lo26lo/portal-turret-v4/Turret_firmware/README.md

# Turret2 firmware

Firmware of the Portal Sentry Turret on the **Turret2** board (ESP32-S3-MINI-1-N8). It started as a copy of the upstream firmware (`../Fork/`, unchanged) and was adapted to the new board: safe power-up, power fault handling, amplifier control, new IMU, staggered servos, settings, web page, serial console, home WiFi and NTP.

> **Status**: it compiles (`turret2` and `turret2_bringup`), but it has **not run on a board yet**. Expect calibration and fixes at bring-up. The web page has been tried against the simulator (`tools/mock_server.py`), not against real hardware.

Design and reasons: [../docs/firmware-plan.md](../docs/firmware-plan.md). Hardware: [../README.md](../README.md), [../docs/design-plan.md](../docs/design-plan.md).

---

## Contents

1. [What the turret does](#1-what-the-turret-does)
2. [Project layout](#2-project-layout)
3. [Build, flash, monitor](#3-build-flash-monitor)
4. [Boot sequence](#4-boot-sequence)
5. [State machine](#5-state-machine)
6. [Modules](#6-modules)
7. [Buttons, switch and status LEDs](#7-buttons-switch-and-status-leds)
8. [Settings](#8-settings)
9. [WiFi, first setup, time](#9-wifi-first-setup-time)
10. [Web page and API](#10-web-page-and-api)
11. [Serial console](#11-serial-console)
12. [Firmware update over WiFi](#12-firmware-update-over-wifi)
13. [Hardware safety rules](#13-hardware-safety-rules)
14. [Calibration and bring-up](#14-calibration-and-bring-up)
15. [Testing without the board](#15-testing-without-the-board)
16. [Known limits](#16-known-limits)

---

## 1. What the turret does

At rest the wings are closed and the ring glows red. When the **radar** (HLK-LD2450 or Ai-Thinker RD-03D, same frames) sees someone, the turret opens its wings, extends its guns, plays the gunshot sound for 3 s, then retracts the guns and closes the wings. Button A starts the same cycle by hand.

Around that behaviour, which comes from the upstream firmware, Turret2 adds:

- a **safe power-up**: every output that floats after reset is set within the first milliseconds, the servos start one at a time;
- **power protection**: a fault reported by the eFuse sheds the load at once, a reboot loop starts a reduced mode;
- **settings** stored in flash (NVS), changeable from the web page or the console;
- a **web page** (status, settings, calibration, tests, log, firmware update) and a **serial console** with the same commands;
- **home WiFi** next to the turret's own access point, **NTP time**, name `portal-turret.local`.

## 2. Project layout

```
platformio.ini              environments, pinned platform and libraries
boards/turret2.json         board: 8 MB QIO flash, no PSRAM, partitions default_8MB.csv
variants/turret2/           Arduino variant: I2C on IO35/IO36, LED_BUILTIN = IO33, no RGB_BUILTIN
scripts/embed_page.py       pre-build: gzips src/web/page/index.html into src/web/page_gz.h
scripts/git_version.py      pre-build: firmware version from git into src/version_gen.h
tools/mock_server.py        web page test bench (simulated turret, no board needed)
tools/mock_menu.py          debug menu for the simulator (reads src/ui/MenuTree.h)
tools/check_web.py          automatic check of the page and API against the simulator
scripts/check_commands.py   checks that section 11 of this README lists every command of the command table
test/test_logic/            native unit tests of src/logic (pio test -e native)
../.github/workflows/       CI: build + checks on every push
data/                       LittleFS image (pio run -t uploadfs): the 55 voice lines of upstream
                            (01_activate/ … 08_tipped/, 09/), fire.mp3
src/
  main.cpp                  setup() = boot steps 1-10, loop()
  pins.h                    pinout imposed by the board (never reassign)
  Turret.h                  references shared by the states
  board/Board.*             safe state, reset reason, reboot-loop detection, status LEDs, buttons, SW1, PWR_FLT
  board/I2cBus.*            I2C start on IO35/IO36, bus recovery, scan
  board/Log.*               console output: Serial + 4 kB RAM buffer (GET /api/log) + 2 kB crash log in RTC memory
  board/CoreDump.*          core dump in flash: summary, download, erase
  logic/*.h                 pure logic without Arduino (radar frame parser and zone, firing cycle, Hall, buttons, LED code, gain, sleep, debug menu navigation), tested natively
  ui/MenuTree.h             debug menu tree, English and French (pure data)
  ui/Display.*              OLED 128x64 on J11 (U8g2: SSD1306, SSD1309, SH1106)
  ui/DebugUi.*              debug menu and status page: information pages, hooks to the commands
  audio/Amp.*               MAX98357A: shutdown, gain, mute
  audio/Audio.*             I2S, gunshot sample with loop, test tone, voice lines, volume
  audio/Mp3FrameDecoder.*   MP3 to PCM one frame at a time (Helix C API), no Arduino
  audio/AudioLoop.*         plays a sample with a loop section
  audio/GunShotAudio.h      gunshot sample (16-bit mono, 44.1 kHz, 16 420 samples)
  light/Light.*             NeoPixels: ring (9) and guns (2 + 2), power cap, test colours
  motion/ServoChannel.*     one servo output with deferred, staggered attachment
  motion/Gun.*              gun servo (positional)
  motion/Wing.*             wing servo (continuous rotation) + Hall sensor
  motion/Gantry.*           both wings, rotations X/Z, attach schedule, hold policy
  sensors/Motion.*          LSM6DSOX IMU, orientation
  sensors/Radar.*           HLK-LD2450 / RD-03D frame parser (UART1, 256000 baud)
  settings/Settings.*       setting table, NVS storage
  states/*                  state machine: Booting, Idle, Activate, Firing, Searching, Disengage, Manual, Fault
  control/Actions*          command interpreter shared by console, buttons, debug menu and web page: command table and dispatch,
                            settings, system, audio, network, status JSON (Actions.cpp); servos, wings, guns, LEDs, voice,
                            calibration (ActionsHardware.cpp); pins, rails, sweeps, load test (ActionsLab.cpp)
  control/SelfTest.*        self-test: passive checks, then LEDs, sound, servos and wings, with a report
  control/Stats.*           usage counters (boots and cycles in NVS, targets and last cycle since boot)
  web/AccessPoint.*         turret access point (WPA2) + captive portal DNS
  web/Station.*             home WiFi, NTP, mDNS, network scan
  web/TurretWebServer.*     web page and JSON API, HTTP Basic authentication
  web/Ota.*                 firmware upload (POST /update)
  web/page/index.html       the web page (embedded in the firmware at build time)
```

## 3. Build, flash, monitor

PlatformIO project. In VS Code, open **this folder** (`Turret_firmware/`), not the repository root: the PlatformIO extension only detects a `platformio.ini` at the root of the opened folder. From the repository root on the command line, add `-d Turret_firmware`.

| Environment | Use |
|---|---|
| `turret2` (default) | normal firmware |
| `turret2_bringup` | debug build: core logs at level 3, button and PWR_FLT events printed, waits up to 3 s for the USB host |
| `turret2_ota` | `turret2` uploaded over WiFi, from the turret's network (section 12) |
| `turret2_ota_home` | same, from the home network (`portal-turret.local`) |
| `turret2_v2`, `turret2_v2_bringup`, `turret2_v2_ota`, `turret2_v2_ota_home` | the same four for the **v2 board** (6 layers, rails switched by an I2C expander): `TURRET2_V2` defined, pinout of `src/pins.h` for the v2, variant `variants/turret2_v2`. **Work in progress** (lot F2): pinout, board check and rails done, not yet run on a v2 board; sleep modes to come |

**Board check**: the v0.1 and v2 boards put almost every function on other pins, and the wrong build could damage a board (on the v2, IO7 is SW1: the v0.1 build drives it as a servo output). Before any other pin, both builds start the I2C bus (IO35 / IO36 on both boards) and look for the v2 rail expander (TCAL6416 at 0x20): the v2 build needs it, the v0.1 build refuses it. On the wrong board the firmware drives nothing, switches the v2 rails off if it sees the expander, and repeats on the USB console what to flash; `rollback` there boots the other OTA slot (the firmware that was there before an OTA update), `scan` lists the I2C devices. Wi-Fi and OTA are not started in that case: reflash over USB.

```
pio run                       # build
pio run -t upload             # flash over the native USB (IO19/IO20)
pio run -t uploadfs           # LittleFS image: data/ (voice lines); again after any change in data/
pio device monitor            # console, 115200 baud
```

After an upload over the native USB, esptool's usual RTS reset leaves the ESP32-S3 in download mode (ROM: `boot:0x20 (DOWNLOAD(USB/UART0))`) and the firmware never starts. The board definition therefore asks for no reset (`upload.after_reset = no_reset`), and `scripts/reset_after_upload.py` then restarts the chip with a watchdog reset ("Board restarted: the firmware is running."). If it says it could not, press **RESET** (SW3).

If the native USB does not show up: hold **BOOT** (SW2), press **RESET** (SW3), release BOOT, flash again. Last resort: UART0 on J16 with an ESP-Prog.

First flash of a new board: `esptool.py flash_id` must report **8 MB** (module N8). The boot banner also warns when the flash is not 8 MB or when PSRAM is found.

Pinned versions (`platformio.ini`): platform `espressif32@7.1.3` (arduino-esp32 2.0.17), FastLED 3.9.20 (not 3.10.x: no RMT driver under ESP-IDF 4.4, LEDs all white), ESP32Servo 1.2.1, ESPAsyncWebServer 3.12.1, AsyncTCP 3.5.0, AceRoutine 1.5.1, Adafruit LSM6DS 4.7.4, U8g2 2.36.18, arduino-audio-tools and arduino-libhelix pinned to a commit. Keep the path of the project short on Windows: FastLED has very deep paths and GCC fails beyond 260 characters.

Size today: about 46 % of the 3.2 MB application partition, 28 % of the RAM. The voice lines take 0.39 MB of the 1.5 MB LittleFS partition.

**Version**: `scripts/git_version.py` writes `src/version_gen.h` before each build with `git describe --tags --dirty --always` (for example `fd63cb0-dirty`). It appears in the boot banner, in `/api/status` and on the web page. Tag a release (`git tag v0.1`) to get readable versions.

**Continuous integration**: `.github/workflows/firmware.yml` builds `turret2`, `turret2_bringup` and `turret2_v2`, checks that every `#include` matches the file name exactly (Linux is case sensitive), runs the native tests (`pio test -e native`), `tools/check_web.py`, `scripts/check_commands.py` and the code style check `scripts/check_format.py` (clang-format 19, `.clang-format` at the project root; `--fix` formats) on every push that touches `Turret_firmware/`.

## 4. Boot sequence

The order comes from the firmware plan §3.2. Steps 1 to 10 run in `setup()`, steps 11 to 13 in the `Booting` state.

| # | Step | Why |
|---|---|---|
| 0 | **Board check** (`BoardCheck::Run`): I2C started on IO35 / IO36 (bus recovery if SDA is stuck), rail expander looked for at 0x20; if it answers, every rail off at once. Wrong board: nothing else runs (see section 3) | the two boards share only the I2C pins; the expander keeps its outputs across a software restart |
| 1 | **Safe state** (`Board::Begin`, first line): amplifier SD low (muted), gain pins released (9 dB), both status LEDs on, inputs configured, SW1 and buttons read, reset reason and counters read | after reset every pin floats; this happens within a few milliseconds |
| 2 | **NeoPixels**: v2: LED rail on; black frame, power cap | clears random colours latched while the level shifter inputs floated |
| 3 | **Console**: `Serial` (USB CDC), boot banner | diagnostics from the start |
| 4 | **Settings** from NVS (factory reset if A + B held), LED settings, **LittleFS** mounted (never formatted automatically) | everything else reads the settings |
| 5 | **I2C** on IO35/IO36 at 400 kHz (started at step 0), bus recovery reported, scan printed | the IMU may hold SDA after a warm reset |
| 6 | **IMU** LSM6DSOX at 0x6A | red LED code 3 if missing |
| 7 | **Radar**: v2: radar rail on; UART1 at 256000 baud | non blocking; code 4 if no frame for 3 s |
| 8 | **Hall sensors**: v2: Hall rail on; read: real wing position | a reset during a cycle can leave the wings open |
| 9 | **Audio**: I2S clocks first, then gain with SD low, 10 ms, SD high | no pop |
| 10 | **WiFi** access point, home WiFi, web server, OTA; v2: then the servo rail on (kept off in reduced mode) | the RF calibration current peak happens before the servos |
| 11 | **Servos one at a time**, `ServoStagger` apart (250 ms): rotate Z, rotate X (centred), gun left, gun right (retracted) | several servos jumping together draw 3 to 4 A, the eFuse limit |
| 12 | **Homing**: guns retracted, wings closed unless the Hall sensors say they are | known mechanical state |
| 13 | End: status LEDs as set (default: green breathing, red fault code), state `Idle` (or `Manual` in debug / reduced mode) | |

PWR_FLT low at any point stops the sequence and enters `Fault`.

## 5. State machine

| State | Does | Leaves to |
|---|---|---|
| `Booting` | steps 11-13 | `Idle`, `Manual` (debug / reduced mode), `Fault` |
| `Idle` | rests `CooldownMs` after entering, then waits for a target **inside the detection zone** of a radar that is still sending frames; refuses if the turret is not upright | `Activate` |
| `Activate` | says an *activate* line, opens the wings, waits until both are open (Hall), extends the guns, 0.5 s, then waits for the end of the line (3.5 s at most from the start) | `Firing` |
| `Firing` | gunshot sound with its loop for `FireMs` (3 s); with `AimZ`, rotation Z follows the target (smoothed, ±60°) | `Searching` |
| `Searching` | says a *search* line; with `AimZ`, sweeps rotation Z ±30° every 4 s. A target back in the zone fires again; nothing for `SearchMs` (4 s) retires. Decisions in `logic/CycleLogic.h`, tested natively | `Firing`, `Disengage` |
| `Disengage` | says a *retire* line, retracts the guns, 0.5 s, closes the wings, waits, 0.5 s | `Idle` |
| `Manual` | nothing: the state machine is stopped. Used by debug mode, reduced mode and every hardware test; in debug mode a demo cycle also ends here | `Booting` with the `resume` command |
| `Fault` | power fault: servos detached, sound stopped, amplifier in shutdown, LEDs off | `Booting` after PWR_FLT has been high for 2 s |

Aiming (`AimZ`, off by default): while firing, rotation Z follows the first target in the zone (angle `atan2(x, y)` of the radar, smoothed, ±60°); while searching it sweeps ±30°. The direction of the rotation against the radar x axis has not been checked on a turret yet: try `set AimZ true` with a target on one side, and swap the sign with `AngleOffsetZ` / the gear ratio in `Gantry` if it turns the wrong way. With `AimZ` off the rotations stay centred, as in the upstream firmware.

## 6. Modules

### Board (`board/Board.*`)

- Safe state at reset (step 1).
- **Reset reason** (`esp_reset_reason`) printed in the banner and the status.
- **Reboot-loop detection**: a counter in NVS goes up at each *suspicious* reset (power-on, brownout, panic, watchdogs, unknown; not software restarts nor deep sleep) and is cleared after 60 s of running. From 3 in a row the turret starts in **reduced mode**: no servo attached, LEDs at 10 %, amplifier at 9 dB, red LED code 1. This covers an eFuse that keeps cutting and retrying. On the ESP32-S3 the RESET button also reports a power-on, so pressing it three times within a minute also gives reduced mode.
- **Brownout counter** in NVS (lifetime).
- **PWR_FLT** (IO38, low = eFuse fault): falling-edge interrupt, so even a short dip is caught, plus the level.
- Status LEDs and buttons (section 7).

### Power handling

**Sleep** (`control/Sleep.*`, `logic/SleepLogic.h`, lot F2.6; settings group *Sleep*, card *Sleep* on the Status tab, command `sleep`):

- **Radar sleep** (both boards): after `RadarSleepMin` without a target in the detection zone, from `Idle` in normal mode. The radar keeps watching; servos released, LEDs off, amplifier in shutdown, Hall sensors off, WiFi as `SleepWifi` says; on the v2 the servo and LED rails are off as well. A target in the zone, the knob, PROG, a button, a cycle started from the web page or `sleep off` wakes it up (rails on one at a time, then the state machine reacts).
- **Deep sleep** (v2 only, SW1 open): after `DeepSleepMin` of radar sleep, or at once at night (`NightSleep`). Shut down as for a restart (amplifier, then I2S, rails), WiFi off, status LEDs off, IMU armed (accelerometer alone at 26 Hz, wake-up interrupt latched on INT1 / IO14), then `esp_deep_sleep_start()`. Wake-up: the turret moved (`WakeImu`), PROG (IO0), the end of the night (timer), or a **patrol** every `PatrolPeriodS`: the turret then boots quiet (rails off but the radar's, no homing), looks for `PatrolOnS`, and goes back to deep sleep if nobody is there. Every wake-up is a full boot (the RAM is lost). Release PROG quickly after a PROG wake-up: if the ROM ever starts in download mode, press RESET.
- Debug mode (SW1 closed) never sleeps on its own and refuses the deep sleep; `sleep radar` works there for tests.

**v2 board, switched rails** (`board/Power.*`, `board/Expander.*`, lot F2.4): servos (5V_SERVO), LED ring (5V_LED), radar (5V_RADAR) and Hall sensors (3V3_HALL) each have a switch driven by the TCAL6416 expander at 0x20. All are off at reset and after the board check; the boot switches them on one at a time, at least 10 ms apart, each call waiting for its rail to rise: LEDs (step 2), radar (step 7), Hall (step 8), servos (end of step 10, not in reduced mode). Before a rail goes off, what it feeds is stopped (servos released and their lines held low, LEDs disabled, radar UART ended and its TX line an input), so that no line feeds an unpowered module. No servo is attached and no LED frame is sent while their rail is off. A power fault (`Fault` state) switches the servo and LED rails off and back on when it ends; a restart or an OTA update switches every rail off. On the v0.1 these calls do nothing (5 V always on).

A power fault, from any state including `Booting`, enters `Fault` at once (plan §4). The ESP32 is powered behind the eFuse too: if the eFuse cuts completely the board simply restarts, and the reset reason and counters show it afterwards.

LED current is capped by FastLED (`LedMaxmA`, 500 mA by default; 13 LEDs at full white would draw about 0.8 A).

### Servos (`motion/*`)

Six servos: rotate Z (IO7), rotate X (IO6), gun left (IO1), gun right (IO2), wing left (IO4), wing right (IO5). Range 500-2400 µs at 50 Hz.

- **Staggered attachment**: a command sent to a detached servo is stored; `Gantry` attaches waiting servos one per `ServoStagger` window, in the order above, directly on the stored command. This applies at boot and afterwards.
- **Hold policy** (decision D6):
  - wings (continuous rotation) are released as soon as they stop: with no pulse they stop dead, which avoids the creep of a badly centred neutral;
  - guns are released 0.5 s after their last command;
  - rotations are held while a wing is open (aiming) and released after `ServoIdleMs` with the wings closed and still.
- **Speed ramp on a weak supply**: in debug mode without `power full` (a computer USB port), the positional servos (rotations and guns, never the continuous wings) follow their command at `ServoRamp` µs per second instead of jumping (1000 by default, about 95°/s). A SG90 jumping 45° or more stalls on a computer port: it clicks without turning, while the ESP32 keeps running on its buck-boost 3.3 V (seen on 23.10.2026). After a release, the ramp starts again from the last pulse sent. `ServoRamp` = 0 turns the ramp off; with `power full` or in normal mode, the servos jump as before. Each release is logged (`Servo rotate Z released`).
- **Wings**: speed ±475 µs around `1500 + WingTrim`. A movement ends when the Hall sensor passes the threshold, or after a 2 s timeout (counted once the servo is attached).
- **Hall sensors** (IO8 left, IO9 right, 3.3 V, 12-bit ADC): thresholds `HallOpenL/R`, `HallCloseL/R`. If the open threshold is below the closed one, the comparisons are reversed (magnet mounted the other way). A sensor stuck at a rail (≤ 15 or ≥ 4080 for 1 s) or not changing during a whole movement sets red LED code 5.

### IMU (`sensors/Motion.*`)

LSM6DSOX at 0x6A on the shared I2C bus (also the Qwiic port J11), 104 Hz, ±4 g, gyro 2000 dps. Read every 20 ms, gravity low-pass filtered. The board is mounted vertically, so the axis pointing up is a setting (`ImuUpAxis`, 0 = not calibrated). Once calibrated, the wings refuse to open when less than 0.8 g lies along that axis (tilt beyond about 37°). With no IMU or no calibration, deployment is allowed.

### Radar (`sensors/Radar.*`)

HLK-LD2450 frame format on UART1 (RX IO17, TX IO18, 256000 baud), three targets per frame (position x / y in mm, y = distance ahead, speed in cm/s, resolution). The first board is fitted with an **Ai-Thinker RD-03D V2**, which sends the same frames (header `AA FF 03 00`, 3 × 8 bytes, tail `55 CC`, bit 15 = positive; Ai-Thinker user manual §5) and draws about 110 mA at 5 V; its range is up to 8 m (±60°), while the settings still stop at 6 m. Its connector order differs from J5: see the radar cable in the main README. Parser from upstream, plus:

- a "radar alive" flag; after 1 s without a frame the targets in memory are cleared (an unplugged or hung radar used to keep its last target and make the turret fire in a loop);
- a **detection zone**: a target only counts if it is in front, closer than `DetectMaxMm` and within ±`DetectAngle` of the radar axis.

### Audio (`audio/*`)

MAX98357A on I2S (BCLK IO11, LRCLK IO12, DIN IO10), 44.1 kHz, 16-bit, mono (the amplifier plays the left channel).

- Gunshot: sample in flash, loop between samples 1537 and 10102 while firing, then the tail.
- Gain 9, 12 or 15 dB (`AmpGain`), latched only when leaving shutdown, so a change goes through SD low for 10 ms.
- Software volume (`Volume`, %).
- Test tone (`tone` command).
- Mute (button B) keeps the I2S running and only drives SD low.
- Shutdown before any restart: SD low, then I2S stopped.
- **Voice lines**: the 55 MP3 files of upstream (`data/`, 22 050 Hz mono), one folder per situation, written to LittleFS by `pio run -t uploadfs`. A line is a random file of its folder, never the same one twice in a row. The firmware says *activate* when it deploys, *retire* when it folds back, and *tipped* when it is knocked over (upright for 2 s, then not upright for 0.5 s; needs `ImuUpAxis`). *search*, *pickup*, *collision*, *shutdown* and *alarm* are only played with `voice <name>` or the Tests tab for now. `Voices` turns them off. The gunshot and the test tones take over and cut a line.
- How a line is played, without ever holding up `loop()`: `Mp3FrameDecoder` decodes one MP3 frame at a time (the C API of the Helix decoder; its C++ wrappers keep the last ~1 KB of a file undecoded), the samples are doubled to 44.1 kHz by linear interpolation, and whole DMA buffers (512 stereo frames) are handed to the I2S driver without waiting, up to ~90 ms ahead. Every write is a whole DMA buffer (the tone and the gunshot write three at a time), so a sound never ends in a half-filled buffer whose other half would replay old samples. The decoder takes ~24 KB of heap while a line plays (refused below 40 KB free). Checked on the computer with the same code: the 55 files decode to the last frame, identical to a reference decoder (SNR above 85 dB).
- **Adding lines**: drop more `.mp3` files into a folder of `data/` (any name, up to 255 per folder) and run `uploadfs` again; the firmware counts them at boot. Use 22 050 Hz (like upstream) or 44 100 Hz, mono: other rates play at the wrong speed (16, 24 and 48 kHz about 9 % off, 32 kHz 38 %), and 8 to 12 kHz files (MPEG-2.5) are not decoded. About 1 MB of LittleFS is still free, roughly 2.5 minutes at 56 kbit/s.
- `data/fire.mp3` stays unused: the gunshot is the sample in flash.

### Lights (`light/*`)

WS2812 through the SN74AHCT125 level shifter: ring on IO14 (9 LEDs, GRB; the last one has red and green swapped), left gun IO15 and right gun IO16 (2 LEDs each, RGB). The ring shows red, the guns a flickering fire colour; `LedEffect` = 1 is a turning rainbow, `LedEffect` = 2 a *living eye* that follows the state machine (breathing red at rest, steady red on acquisition, blinking during a burst, cold white while searching). `LedBright`, `LedMaxmA`, test colours from the console or page.

### Settings (`settings/*`)

Table of typed entries (int, float, bool, string) with default, min and max, stored in NVS namespace `turret`. Values are clamped. Modules keep a copy and reload it when a setting changes (`Actions::ApplyAllSettings`).

### Log (`board/Log.*`)

All messages go through `Log.print*`: to the USB console and to a 4 kB RAM ring buffer read by the web page.

### Crash diagnostics (`board/Log.*`, `board/CoreDump.*`)

- **Crash log**: the last 2 kB of the log are also written to RTC memory that is not cleared at reset. It survives a software restart, a panic and the watchdogs (not a power-up). After a crash (panic, watchdog, brownout), the boot prints these lines between `---- last lines before the reset ----` and `---- end ----`; they stay available with `crashlog` and `GET /api/crashlog`.
- **Core dump**: on a panic or a watchdog, ESP-IDF writes a core dump (ELF) to the `coredump` partition. At boot the firmware prints its summary (crashed task, program counter, backtrace), the web page shows a warning and offers the download. Decode it on the computer with the `firmware.elf` of the **same build**: `espcoredump.py --chip esp32s3 info_corefile -c coredump.elf .pio/build/turret2/firmware.elf`, or a single address with `xtensa-esp32s3-elf-addr2line -pfiaC -e .pio/build/turret2/firmware.elf 0x…`. Erase it once read (`coredump erase`).
- **Loop watchdog**: `loop()` must come back within **8 s**, otherwise the task watchdog panics and the turret restarts (core dump + crash log tell where it was stuck). The I2C scan stops at the first bus timeout so that a stuck bus cannot trigger it.

### Commands (`control/Actions.*`)

One interpreter for the console, the buttons and the web page. The web server runs in another task: it only queues command lines (24 × 128 bytes), and `loop()` executes them. Hardware is never touched from the web task.

## 7. Buttons, switch and status LEDs

Buttons A and B exist on the **v0.1 only**; on the **v2** their functions moved to the knob, PROG and the web page (lot F2.5, `docs/AMELIORATIONS_V2.md` §2.7).

| Control | Action |
|---|---|
| Button A (IO26, v0.1) | demo cycle, from `Idle` only, if upright |
| Button B (IO34, v0.1) short | mute / unmute |
| Button B held 3 s (v0.1) | WiFi on / off (access point and home network) |
| A + B held 1 s at power-up (v0.1) | all settings back to defaults, WiFi passwords included |
| **PROG** held 3 s, SW1 open (both boards) | WiFi on / off, like button B held (the v2 has no button B) |
| **Remote button J20** (v2, IO2, active high; to add in KiCad, `docs/carte-v2-etat.md` §11) | held 3 s: WiFi on / off, like PROG; any press wakes the radar sleep; wakes the deep sleep up (EXT1, with the IMU) |
| Knob (I2C, optional), normal mode | turn = volume, push = mute / unmute, **push held 0.6 s = demo cycle** (like button A) |
| SW1 closed + **PROG** (SW2, on the board) held 5 s, at any time once started | **full factory reset**, no screen or external button needed: settings (WiFi passwords and calibrations included), statistics, boot-loop / brownout counters, core dump; then a restart. While PROG is held the red LED blinks fast (and a screen, if any, counts down); releasing PROG or opening SW1 cancels; once accepted the green LED blinks fast until the restart (2 s). Same as the `factory-reset` command. PROG held *while RESET is released* starts the ROM download mode instead: press PROG only once the turret runs |
| SW1 (v0.1 IO3, v2 IO7) closed at power-up | **debug mode** (formerly "bench mode"): the turret never starts a cycle by itself (`Manual`), no servo attached automatically, one servo at a time; with an OLED on J11, buttons A and B drive the **debug menu** (next section) |

### Debug mode and OLED screen

Plug a 128×64 I²C OLED into the Qwiic port **J11** (3.3 V, shared bus with the IMU; nothing to modify on the board). It is looked for at boot at 0x3C, then 0x3D. The controller cannot be detected: choose it with the `OledType` setting (0 = SSD1306, the 0.96" modules; 1 = SSD1309, the 1.54" modules; 2 = SH1106, the 1.3" modules), then reboot. Menus in French or English (`Language`).

- **SW1 open (normal mode)**: the screen shows **the Aperture logo** (`OledFace`, 42 x 42 pixels, `src/ui/ApertureLogo.h`, made by `tools/aperture_logo.py`; it replaced the eye on 21.10.2026); underneath, subtitles at each change of state ("Target acquired", "Target lost", "Are you still there?"…) and the time. With `OledFace` off: one status page (state, faults, home network address, time). Buttons keep their normal functions.
- **Faults, in both modes**: a fault that appears is shown full screen for 5 s (one line per fault with its name, and the red LED code), then the screen goes back to what it was showing; after that only the red LED keeps signalling it. A key press closes the alert early (debug mode). A fault that clears and comes back is shown again.
- **SW1 closed at power-up (debug mode)**: the screen shows the menu and **the knob navigates** (table below); the hints at the bottom of the screen use its words ("Turn  Push:ok"). The v2 has no buttons A / B: the knob is its only local control. Without a screen, the same menu is on the web page (Tests → *Debug screen*, with the knob's four keys) and with the `key` command.

**v0.1 only, buttons A / B** (if fitted on J12 / J13): they drive the same menu, and the hints switch to A / B after one of them is pressed.

| Button (v0.1) | In a menu | Information page | Adjusting a value | Confirmation |
|---|---|---|---|---|
| A short | next entry | next page | value − step | cancel |
| A long (0.6 s) | previous entry | previous page | leave without saving | cancel |
| B short | enter / run | back | value + step | confirm |
| B long (0.6 s) | back to the parent menu | back | save and leave | cancel |

In the guided setup: B does the step, A skips it, A long goes back one step, B long leaves. A + B held at power-up is the factory reset of the v0.1; on both boards, SW1 closed + PROG held 5 s does it.

**Rotary encoder (optional)**, on J11 as well (daisy-chained with the screen through its second Qwiic socket), detected at boot, address jumpers / switches as delivered:

| Module | Address | Notes |
|---|---|---|
| Adafruit I2C QT Rotary Encoder (4991, seesaw) | 0x36 | |
| Adafruit I2C Quad Rotary Encoder (5752, seesaw) | 0x49 | knob 0 only; encoders sold separately, take PEC11-pinout ones **with a push switch** |
| Soldered Rotary Encoder Breakout (333188, ATtiny404) | 0x30 | the board decides its own long press; a single click comes a little late (it waits for a possible double click); a double click counts as two pushes |

In debug mode with a screen it drives the menu (the hints at the bottom of the screen use its words unless a v0.1 button was pressed last):

| Encoder | In a menu | Information page | Adjusting a value | Confirmation | Guided setup |
|---|---|---|---|---|---|
| turn | next / previous entry | next / previous page | value + / − | nothing | next / previous step |
| push | enter / run | back | save and leave | confirm | do the step |
| push held (0.6 s) | back to the parent menu | back | leave without saving | cancel | leave |

Otherwise (normal mode, or no screen): turn = volume in 5 % steps (turning up while muted unmutes), push = mute / unmute; the screen shows the volume for 1.5 s. The volume is saved 2 s after the last detent (one flash write per turn of the knob). Direction of rotation, and counts per detent on the Soldered board, still to check on the hardware.

| Menu | Content |
|---|---|
| Information | live pages: state and faults, power (PWR_FLT, counters, reset reason), radar (targets, in the zone or not), IMU, Hall sensors (values with a bar), servos (pulse of each output), audio, network and time; **radar view** (top view: the detection zone as an arc and two lines, full scale 6 m, targets as dots, filled when in the zone); **Hall curves** (left and right: the last 5 s, with the two thresholds as dotted lines); statistics (boots, cycles, targets seen, last cycle); **log** (last four lines); **last crash** (core dump summary, or the last lines before the reset) |
| Tests | **self-test** quick or full, and its report (below); wings (left / right / both: open, close), guns (left / right: out, in), each servo by steps, LEDs (colours, one strip, one-bit pattern), sound (tone, gunshot, three voice lines, volume, gain, mute), demo cycle, load test, I²C scan, release all servos |
| Calibration | **guided setup**: seven steps, one instruction per screen (open the left wing by hand, press B…) for the Hall sensors and the IMU; or entry by entry: Hall sensors (capture open / closed for each wing, then save: thresholds at 25 % and 75 %), IMU (the turret stands upright), wing trims (5 µs steps, the wing runs at its stop point for 2 s, hold B to save) |
| Settings | volume, LED brightness, rest time, detection distance and angle, lab markers, wing animation, logo or status page, screen flipped, contrast, screen-off delay, language |
| WiFi | pages: turret network (name, **password**, 192.168.4.1, clients), home network (name, state, address and signal, `portal-turret.local`), networks found by the last scan (four strongest), date and time, **QR code to join the turret network** (point the phone camera at it), **QR code of the web page**; actions: scan, reconnect to the home network, forget it, WiFi on / off, factory password for the turret network (next boot). The home network password is typed on the web page, not with two buttons |
| System | resume (homing), reboot, reset settings, erase core dump |

**Self-test** (`selftest`, also on the web page, Tests tab): one command that checks the board and gives a report, for the first power-up and whenever something looks wrong.

- *Quick* (`selftest quick`): passive checks, immediate, nothing moves: flash 8 MB without PSRAM, PWR_FLT high, IMU answers, gravity close to 9.8 m/s², radar frames, both Hall sensors away from the rails, LittleFS mounted, OLED, access point, amplifier.
- *Full* (`selftest`): then the LEDs in red, green and blue, a 1 kHz tone, each positional servo attached and moved a little while PWR_FLT is watched, and each wing opened and closed, which must end on its Hall threshold and not on the timeout. It never blocks the main loop; a power fault aborts it.
- Results: `OK`, `FAIL`, `SKIP` (could not be tested: turret not upright, part missing, amplifier muted), `CHECK` (the firmware cannot see or hear: look at the LEDs, listen to the tone). `selftest report`, `GET /api/selftest`, and the page *Self-test report* of the menu.

**Screen settings**: `OledFlip` turns the picture by 180° (screen mounted upside down), `OledContrast` sets the brightness, both at once. `OledSleepS` turns the screen off after that time without a key press, a wing movement, a change of state or a power fault (OLEDs burn in; 0 = never); the first key press only wakes it up.

**QR codes**: made by the generator of the ESP32 SDK. Up to 53 characters (version 3) the code is drawn with 2 pixels per module; the factory name and password take 41. A longer name or password gives a bigger code at 1 pixel per module, harder to scan on a 0.96" screen.

**Wing animation**: while a wing moves, and 0.8 s after, the screen shows the turret from the front with its two side panels sliding apart or together, following the real Hall sensor values (0 % at the closed threshold, 100 % at the open one); the gun barrels appear in the gap. In both modes. `OledAnim` turns it off. The web page shows a text version (`[]==(O)==[]`).

**The screen never holds up the main loop.** Sending a frame keeps the I²C bus busy about 25 ms, so it is done by a task of its own (`oled`, on the other core): `loop()` only hands over the six lines to draw. The bus is shared safely with the IMU: `Wire` takes a lock per transaction and U8g2 sends a frame as 24-byte transactions (about 0.7 ms each), so an IMU read waits about 1 ms at most. Frames are sent only when the content changes, 5 times per second at most, 10 during the wing animation.

Every entry runs a command of the console, so the behaviour and the protections are the same. **One servo at a time**: debug mode assumes a weak supply (a computer USB port). With a 3 A supply connected, *Tests → 3 A supply: all* (`power full`) lifts the limit: both wings, demo cycle and load test become possible, and *Resume* attaches and homes the servos. In debug mode a demo cycle ends stopped; the radar never triggers one.

| LED | Meaning |
|---|---|
| Green (IO33) | steady during boot (LED test), then as set by `GreenLedMode` (the loop is alive): **breathing** (default), a slow, smooth breath like the PPK2's LED, off to full and back in `GreenLedPeriod` (4 s); **heartbeat**, two short beats then a rest, one every `GreenLedPeriod`; **steady**; or **off**. `GreenLedBright` sets its brightness |
| Red (IO48) | steady during boot (LED test), then as set by `RedLedMode`: blinks the number of the lowest active fault, pause, repeat (default); or on while any fault is active; or off. The faults stay visible on the web page and the screen |

The factory reset gesture and `LabMarkers` take over both LEDs whatever their settings.

| Red blinks | Fault |
|---|---|
| 1 | brownout, or reboot loop (reduced mode) |
| 2 | eFuse fault (PWR_FLT went low) |
| 3 | IMU missing |
| 4 | radar silent for 3 s |
| 5 | Hall sensor stuck |
| 6 | LittleFS not mounted (run `uploadfs`) |

## 8. Settings

All settings are listed, with their limits, in the *Settings* tab of the web page, and with `get` on the console. The WiFi group is applied at the next boot; the home network also right away with `wifi join`. A setting that is a choice (`GreenLedMode`, `RedLedMode`) is a drop-down list on the page; on the console it takes the number or the name.

| Key | Group | Default | Range | Meaning |
|---|---|---|---|---|
| `AngleOffsetX` | Motion | 0 | -90..90 | rotation X offset (degrees, before the gear ratio) |
| `AngleOffsetZ` | Motion | 0 | -90..90 | rotation Z offset |
| `ImuUpAxis` | Motion | 0 | 0..6 | axis pointing up: 0 off, 1 +X, 2 -X, 3 +Y, 4 -Y, 5 +Z, 6 -Z |
| `AmpGain` | Audio | 9 | 9..15 | amplifier gain, rounded to 9, 12 or 15 dB |
| `Volume` | Audio | 80 | 0..100 | software volume (%) |
| `Voices` | Audio | true | true / false | voice lines (activate, retire, tipped; `voice` command) |
| `CooldownMs` | Detection | 5000 | 0..120000 | rest after each cycle (and after boot) before a new target is taken |
| `DetectMaxMm` | Detection | 3000 | 300..6000 | detection distance (mm) |
| `DetectAngle` | Detection | 45 | 5..60 | detection half angle (degrees each side of the radar axis) |
| `HallOpenL` / `HallOpenR` | Wings | 2500 | 0..4095 | ADC value beyond which the wing is open |
| `HallCloseL` / `HallCloseR` | Wings | 1500 | 0..4095 | ADC value beyond which the wing is closed |
| `WingTrimL` / `WingTrimR` | Wings | 0 | -200..200 | stop point of the wing servo, µs around 1500 |
| `ServoStagger` | Power | 250 | 50..1000 | ms between two servo attachments |
| `ServoIdleMs` | Power | 5000 | 0..60000 | rotations released after this idle time (0 = never) |
| `ServoRamp` | Power | 1000 | 0..20000 | speed of the positional servos on a weak supply (debug mode without `power full`), µs per second; 0 = no ramp |
| `LedBright` | Lights | 255 | 0..255 | LED brightness |
| `LedEffect` | Lights | 0 | 0..1 | outside a test: 0 red eye (ring red, guns glowing), 1 turning rainbow (ring, guns following LED 1) |
| `FireMs` | Detection | 3000 | 500..20000 | length of one burst of fire (state `Firing`) |
| `SearchMs` | Detection | 4000 | 0..30000 | after a burst, how long the turret looks for the target before retiring (state `Searching`); a target back in the zone fires again |
| `AimZ` | Detection | false | | rotation Z follows the target while firing (±60°) and sweeps ±30° while searching. Off until the direction of the rotation has been checked on the turret (`aim` command, `AngleOffsetZ`, gear ratio) |
| `MaxSpeedCms` | Detection | 0 | 0..2000 | a target whose radial speed (cm/s, either way) is above this is not a target (reflection, fan, curtain); 0 = no limit. A walking person reads under 200 |
| `LedEffect` = 2 | Lights | | | *Living eye*: ring breathing red at rest, steady red when a target is acquired, blinking red during a burst, cold white while searching; the guns glow as usual (see Lights) |
| `LedMaxmA` | Power | 500 | 100..1500 | LED current limit (mA) |
| `GreenLedMode` | Status LEDs | 0 | 0..3 | green LED after boot: 0 breathing, 1 heartbeat, 2 steady, 3 off |
| `GreenLedPeriod` | Status LEDs | 4000 | 1000..10000 | one breath, or one heartbeat (ms) |
| `GreenLedBright` | Status LEDs | 100 | 1..100 | green LED brightness (%) |
| `RedLedMode` | Status LEDs | 0 | 0..2 | red LED after boot: 0 fault codes, 1 on while a fault is active, 2 off |
| `Language` | Display | 1 | 0..1 | language of the debug screen: 0 English, 1 French |
| `OledType` | Display | 0 | 0..2 | OLED controller: 0 SSD1306 (0.96"), 1 SSD1309 (1.54"), 2 SH1106 (1.3"); applied at the next boot |
| `OledAnim` | Display | true | true / false | wing animation on the screen while the wings move |
| `OledFace` | Display | true | true / false | normal mode: the Aperture logo and its subtitles (true) or a status page (false) |
| `SleepMode` | Sleep | 1 | 0..2 | 0 never, 1 radar sleep only, 2 radar sleep then deep sleep (v2) |
| `RadarSleepMin` | Sleep | 10 | 0..240 | radar sleep after this many minutes without a target, from `Idle` (0 = never on its own) |
| `DeepSleepMin` | Sleep | 0 | 0..1440 | deep sleep after this many minutes of radar sleep (0 = only at night) |
| `NightSleep` | Sleep | false | true / false | deep sleep at night (needs the time: home WiFi) |
| `NightStart` / `NightEnd` | Sleep | 23 / 7 | 0..23 | night window, local hours; may cross midnight |
| `SleepWifi` | Sleep | 0 | 0..2 | WiFi while asleep: 0 unchanged, 1 home network only (access point off), 2 off |
| `PatrolPeriodS` | Sleep | 0 | 0..3600 | deep sleep: wake up every this many seconds to look with the radar (0 = never) |
| `PatrolOnS` | Sleep | 3 | 1..60 | deep sleep: how long a patrol looks |
| `WakeImu` | Sleep | true | true / false | deep sleep: wake up when the turret is moved |
| `WakeImuLevel` | Sleep | 1 | 0..2 | movement needed: 0 firm knock (375 mg), 1 nudge (156 mg), 2 light touch (62 mg) |
| `HallPower` | Sleep | 1 | 0..1 | v2: Hall sensors always powered (0) or only while a wing moves (1); always on in debug mode |
| `OledFlip` | Display | false | true / false | picture turned by 180° |
| `OledContrast` | Display | 255 | 0..255 | screen contrast |
| `OledSleepS` | Display | 300 | 0..3600 | screen off after this many seconds without activity (0 = never) |
| `LabMarkers` | Lab | false | true / false | green LED toggles at each boot step / servo attachment instead of its status pattern (lab aid) |
| `ApSsid` | WiFi | Portal Turret | 1..32 chars | name of the turret's network |
| `ApPassword` | WiFi | stillalive | 8..63 chars | turret network password (WPA2 needs at least 8 characters) |
| `WebUser` | WiFi | Admin | 1..32 chars, no `:` | web page user name |
| `WebPassword` | WiFi | 1234 | 4..63 chars | web page password (also for the firmware upload) |
| `StaSsid` | WiFi | (empty) | 0..32 chars | home network; empty = not used |
| `StaPassword` | WiFi | (empty) | empty or 8..63 | home network password |
| `Timezone` | WiFi | `CET-1CEST,M3.5.0,M10.5.0/3` | POSIX TZ | time zone (Paris, with daylight saving time) |

Passwords are never sent back by the API nor printed by `get`.

## 9. WiFi, first setup, time

- **Turret network**: access point `ApSsid`, WPA2 with `ApPassword`, address `192.168.4.1`. It stays on even when the home network is connected, so the turret can always be reached.
- **Captive portal**: every DNS name answers `192.168.4.1`, and the connectivity checks of Android, iOS / macOS and Windows are redirected to the page. A phone joining the network opens the page by itself.
- **First setup**: in the *Home WiFi* card at the top of the page, *Scan*, pick the network, type its password, *Connect*. The turret joins it straight away (no reboot) and shows its IP address.
- **Home network** (station mode): automatic reconnection, host name `portal-turret`, mDNS **`http://portal-turret.local`**.
- **Time**: NTP (`pool.ntp.org`, `time.google.com`) as soon as the home network is up, local time with `Timezone`. Shown on the page and by `time`.
- The radio has a single channel: in AP + STA mode the access point follows the channel of the home network. A phone on the turret's network may drop for a second when the turret joins the home network.
- Button B held 3 s, or `wifi off`, turns both off.

## 10. Web page and API

`http://192.168.4.1` (turret network) or `http://portal-turret.local` (home network). User **`Admin`**, password **`1234`** (settings `WebUser` / `WebPassword`, applied at the next boot), separate from the WiFi password `ApPassword`. On the home network anyone can reach the page: change `WebPassword` there, since the page can also upload a firmware. The page is embedded in the firmware (gzip, about 6 kB), needs no Internet and is always the version of the firmware.

The header shows the Aperture logo (inline SVG, follows the light / dark theme), also used as the tab icon (orange). Tabs: **Status** (home WiFi card, values refreshed every second, active faults, warning while the factory password is used), **Settings** (generated from the setting table, default button per field, save and reset per group), **Calibration** (Hall capture, IMU axis capture, wing trim sliders), **Tests** (wings, guns, tone, gain, mute, voice lines, LED colours, any servo, I2C scan, demo, resume, free command line), **Log**, **Maintenance** (firmware upload, reboot, factory reset).

| Method and path | Role |
|---|---|
| `GET /` | the page |
| `GET /api/status` | JSON: version, uptime, state, reset reason, counters, PWR_FLT, modes, active faults, radar, IMU, Hall, wings, servo pulses (`null` = released), amplifier, WiFi (access point, home network), time, free heap |
| `GET /api/settings` | the setting table (key, label, group, type, value, default, min, max, `options` for a choice, `reboot`, `secret`) |
| `GET /api/meta` | the lists the page needs, in the screen language (`Language`): fault names by number, IMU axes, voice names, servo aliases and names, command categories (for `help <category>`), the page texts (`text`, from `web/PageText.h`: the page is in English or French like the OLED), board, version. The page keeps no copy of these lists |
| `POST /api/settings` | form fields `key=value`; each becomes a `set` command (answer in the log) |
| `POST /api/settings/reset` | optional field `group`; all settings otherwise |
| `POST /api/action` | field `cmd`: any console command |
| `GET /api/wifi/scan` | `{"scanning":bool,"networks":[{ssid,rssi,secure}]}` after `wifi scan` |
| `GET /api/screen` | the debug screen: `{"present":bool,"menu":bool,"on":bool,"graphic":n,"highlight":n,"lines":[6 strings]}` (`graphic` ≠ 0: the OLED shows a drawing, the lines are its text version) |
| `GET /api/selftest` | self-test summary and one line per check |
| `GET /api/log` | last 4 kB of the log |
| `GET /api/crashlog` | log tail of the previous run |
| `GET /api/coredump` | the core dump (`coredump.elf`), 404 if none |
| `POST /api/coredump/erase` | erase the core dump |
| `POST /api/reboot` | reboot with the shutdown sequence |
| `POST /update` | firmware upload (section 12) |

Every route needs the credentials, except the captive portal checks (`/generate_204`, `/hotspot-detect.html`…), which only redirect to the page. Commands are queued and executed by `loop()`: `POST` answers `202 {"queued":n}` and the result appears in the log.

## 11. Serial console

USB, 115200 baud. Type `help`.

| Command | Does |
|---|---|
| `help [category]` | the commands by category (Status, Settings, Mechanics, Lights, Audio, Network, Debug, System, Lab), with their usage; one category at a time fits the log tail of the web page. Generated from the command table `control/CommandTable.h` (pure data, tested natively); `scripts/check_commands.py` checks this section against it in the CI |
| `aim` | what `AimZ` would do, without moving anything: each radar target with its x / y, speed, angle from the radar axis, which side, the rotation Z servo angle it maps to, and whether it is in the zone. Walk to one side of the radar and check the sign before `set AimZ true` |
| `status` | the status JSON (`radar.bytes` / `frames` / `badFrames` tell a silent radar from a wrong baud rate) |
| `scan` | I2C scan |
| `imu` | gravity, dominant axis, upright, gyro, temperature |
| `hall` | raw Hall values and positions |
| `flt` / `reset-reason` | PWR_FLT and fault count / reset reason and counters |
| `crashlog` | log tail of the previous run (after a crash or a restart) |
| `coredump [erase]` | core dump summary / erase it |
| `get [key]` / `set <key> <value>` | read / change a setting (saved in NVS, applied at once except WiFi); a choice takes its number or its name (`set GreenLedMode off`) |
| `reset-settings [group]` | defaults |
| `servo <0-5\|rotz\|rotx\|gunl\|gunr\|wingl\|wingr> <angle 0-180 \| µs 500-2400 \| off>` | drive one servo |
| `wings open\|close`, `guns extend\|retract` | move the mechanics (both sides; refused while limited to one servo) |
| `wing left\|right open\|close`, `gun left\|right extend\|retract` | one side only |
| `servos off` | release every servo |
| `shot` | gunshot sound for 1 s |
| `power [full\|limited]` | debug mode: all servos allowed (3 A supply) / one at a time (default) |
| `cal hall left\|right open\|closed`, `cal hall save`, `cal imu` | calibration without the web page |
| `key a\|al\|b\|bl\|cw\|ccw\|push\|hold`, `screen` | debug menu: press A, A long, B, B long, or turn / push the rotary encoder (works without one) / print the screen |
| `volume [0-100\|+n\|-n]` | volume at once, saved 2 s after the last change |
| `inputs` | raw levels of PROG, SW1, buttons A and B (v0.1; bring-up step C) |
| `pins [n]` | without argument: registers of the green LED pin and of the USB; with a GPIO number: its routing (GPIO matrix, IO_MUX) and its pad sampled from core 0 while a LED frame is sent (pulse widths, first 48 bits: a WS2812 "0" is ~0.4 µs high, a "1" ~0.8 µs) |
| `rails` | v2: rails as read back from the expander (servos, LEDs, radar, Hall) and its port 0 registers |
| `rail <servo\|led\|radar\|hall> on\|off` | v2: switches one rail; what it feeds is stopped first (servos released, LEDs disabled, radar UART ended) and started again after |
| `factory-reset` | everything back to factory state (settings, statistics, counters, core dump), then a restart; same as SW1 closed + PROG held 5 s |
| `selftest [quick\|report\|stop]` | self-test: full, passive checks only, last report, stop |
| `stats` | boots, cycles (total and since boot), targets seen, last cycle |
| `sleep [radar\|deep\|off]` | sleep state (JSON), or radar sleep / deep sleep now / wake up |
| `trim left\|right <µs>` | runs a wing at its stop point with this trim for 2 s (not saved) |
| `led ring\|left\|right\|all <RRGGBB\|rainbow\|off>`, `led rainbow` | test colours; `rainbow`: a rainbow turning around the ring (one turn every ~2 s), the guns following LED 1 |
| `tone <Hz> [ms]`, `gain 9\|12\|15`, `mute [on\|off]` | audio tests (gain not saved) |
| `voice [activate\|collision\|shutdown\|pickup\|retire\|search\|tipped\|alarm\|stop]` | a random line of that folder; without a name, the folders and their file counts |
| `wifi [on\|off\|scan\|join\|forget]`, `time` | WiFi state and control (`forget` drops the home network), local time |
| `demo` | one activation cycle (from `Idle`) |
| `resume` | leaves the tests: homing, then `Idle` |
| `reboot` | restart with the shutdown sequence |

Hardware tests stop the state machine (`Manual`); they are refused during `Booting` and `Fault`. In debug mode, while limited to one servo (no `power full`), driving a servo releases the others.

**Lab aids** (for the measurements of [../docs/experiments.md](../docs/experiments.md)):

| Command / setting | Does |
|---|---|
| `set LabMarkers true` | the green LED stops the heartbeat and **toggles** at each boot step (from step 4, once the settings are read) and at each servo attachment; each toggle is also logged with its time (`Mark 1234 ms: rotate Z`). Line an oscilloscope or PPK2 trace up with the code |
| `sweep servo <n> <ms>` | one servo from 0° to 180° and back to 0° in `ms` (500 to 60 000) |
| `sweep tone <Hz start> <Hz end> <ms>` | frequency sweep (20 Hz to 20 kHz, up to 30 s) |
| `sweep stop` | stops both |
| `led pattern bit` | fixed NeoPixel frame with a single bit set: first LED of the ring = red 0x80, all else 0, i.e. the **9th of 24 bits** (GRB order); brightness 255 and no dithering so the bytes are sent as is; `led off` to leave |
| `loadtest <gap ms>` | commands all six servos (rotations to 110°, guns out, wings at their stop point), attached `gap` ms apart (0 = together), holds 1 s, returns, releases everything; attachment times in the log. Refused in debug mode until `power full` |
| PWR_FLT events | each one is logged with its number, time (and clock time with NTP) and what was running: attached servos, sound, amplifier, LEDs, state |

A power fault or `resume` cancels a running sweep or load test.

## 12. Firmware update over WiFi

It works from the turret's network and, once the turret has joined it, from the home network: no need to switch the computer to the turret's WiFi.

From the page (either network): *Maintenance*, choose `.pio/build/turret2/firmware.bin`, *Upload*. With PlatformIO:

```
$env:TURRET_PASSWORD = "1234"            # PowerShell: your WebPassword (user Admin)
pio run -e turret2_ota_home -t upload    # from the home network (portal-turret.local)
pio run -e turret2_ota -t upload         # from the turret's network (192.168.4.1)
```

If `portal-turret.local` does not resolve on the computer, use the IP address shown on the page: `curl -u Admin:<password> -F "firmware=@.pio/build/turret2/firmware.bin" http://<ip>/update`. With another `WebUser`, change `Admin` in the upload command of `platformio.ini` too.

The credentials are checked on the first block of the upload. The turret then stops (servos detached, amplifier off, I2S stopped, LEDs off) **before** accepting the data, and reboots afterwards whether the update succeeded or not.

## 13. Hardware safety rules

These rules protect the board; the code follows them and any change must too (details: plan §2). They are written for the **v0.1**; on the **v2** (docs/carte-v2-etat.md §4) the gain pins are **IO40 / IO41**, the amplifier SD pin is **IO42**, IO21 is PWR_FLT and IO47 the red LED, and the v2 build must never run on a v0.1 (board check, section 3).

- **IO21 and IO47 are never driven high** (amplifier gain, one of them compared against 5 V): open drain or input only. The variant has no `RGB_BUILTIN` for that reason.
- Never stop the I2S clocks, change the sample rate or restart while the amplifier runs: SD low first (`Amp::Shutdown`).
- No PSRAM (IO26 is button A), never `memory_type opi` (IO33-IO37).
- I2C always on `PIN_SDA` / `PIN_SCL` (IO35 / IO36), never on the defaults of a generic variant (IO8 / IO9 are the Hall sensors).
- Never use IO0, IO19, IO20, IO45, IO46.
- **Never burn an ESP32 eFuse** (`espefuse.py summary` only). Burning `STRAP_JTAG_SEL` would take IO3 (SW1) away.
- Do not power the servos from a computer USB port (0.5 to 0.9 A): use debug mode (SW1) there, which keeps to one servo at a time.
- Never connect the on-board USB-C and the remote USB (J1) to two hosts at the same time.

## 14. Calibration and bring-up

Plan §8 gives the full bring-up order (one peripheral at a time). Use `turret2_bringup` for the first boards. To calibrate, all from the *Calibration* tab:

1. **Hall sensors**: move a wing fully open, *capture open*; fully closed, *capture closed*; same for the other wing; *Compute and save*. Thresholds are set at 75 % (open) and 25 % (closed) between the two values.
2. **IMU**: turret standing upright, *capture*. The dominant axis becomes `ImuUpAxis`.
3. **Wing trims**: move the slider until a wing driven at its stop point does not move, *Save trims*.
4. **Axis offsets** (`AngleOffsetX/Z`) as on the V4.
5. Change **`ApPassword`** and **`WebPassword`**.

## 15. Testing without the board

`tools/mock_server.py` (Python 3, standard library only) serves the real page and simulates the API: moving Hall values, wings, servos, log, settings read from `Settings.cpp`, network scan and home WiFi (password `password123`), captive portal checks.

```
python tools/mock_server.py          # then http://localhost:8080, Admin / 1234
```

Extra console commands of the simulator: `sim fault on|off`, `sim radar on|off`, `sim imu on|off`, `sim crash on|off` (fake core dump and previous-run log), `sim debug on|off` (debug mode, on by default), `sim oled on|off`.

The **debug menu can be tried in the browser**: Tests → *Debug screen*, buttons A, A long, B, B long. The simulator walks through the real tree of `src/ui/MenuTree.h`; the information pages show fake values.

**Native tests**: `pio test -e native` compiles `test/test_logic` on the computer with the pure logic of `src/logic/` (radar decoding, compared with the upstream formula on all 65 536 values; radar frame parser: nominal frame, footer bytes inside the data, resync after an acknowledgement, a truncated frame and a stray byte; detection zone; firing cycle: aim angle, burst end across the millis() wrap-around, search decision, search sweep; Hall thresholds in both polarities; button debounce, short and long press; LED fault code; amplifier gain; voice upsampling, file choice, ID3 tag size, "tipped over" watch; sleep; debug menu; the command table of `control/CommandTable.h` and the page texts of `web/PageText.h`: unique keys, usage starting with the name, contiguous categories). It needs a host `gcc` / `g++`: present on Linux and in the CI; on Windows install MinGW-w64 first (for example `winget install BrechtSanders.WinLibs.POSIX.UCRT`).

`tools/check_web.py` runs the simulator and checks the API the page relies on (credentials, settings listed and clamped, passwords never sent, NVS key length, status fields, captive portal, WiFi scan, `/api/meta` voices against the firmware and no copy of the lists in the page, an MP3 in every voice folder of `data/`, every debug menu command in the command table) and the JavaScript syntax with Node.js, on the source and on the compacted page that `scripts/embed_page.py` embeds. The CI runs it too.

## 16. Known limits

- Nothing has run on a board: every timing, threshold and default is a starting point.
- Aiming (`AimZ`) is off by default: the direction of rotation Z against the radar axis has not been checked on a turret (section 5).
- The web page is in English only; `/api/meta` already gives the fault names in the screen language, the rest of the text does not follow `Language`.
- The voice lines have not been heard on a board yet: decoding is checked on the computer, the I2S timing and the loudness are not.
- The web page uses HTTP Basic over plain HTTP: fine on a home network, not on an open one.
- On iOS the captive portal window may not handle the password prompt: open Safari on `192.168.4.1` instead.
- The reboot-loop counter also counts three presses of RESET within a minute.
