lo26lo/portal-turret-v4/docs/firmware-improvements.md

# Améliorations et fonctionnalités — plan et journal de reprise

Créé le 26.09.2026. Ce fichier **est versionné** (contrairement à `docs/firmware-journal.md` et `CLAUDE.md`, qui sont locaux depuis le commit `210b05d`). Il contient à la fois le plan des améliorations qui suivent les lots 1 à 12 de [firmware-plan.md](firmware-plan.md) et leur journal d'avancement.

> Dates au format JJ.MM.AAAA. Tout le code concerné est dans `Turret_firmware/` (`Fork/` reste en lecture seule).

## Reprise rapide (VS Code)

1. `git checkout main && git pull`, ouvrir **`Turret_firmware/`** comme dossier dans VS Code (PlatformIO ne détecte `platformio.ini` qu'à la racine du dossier ouvert).
2. Lire « État actuel » ci-dessous, puis le premier lot du tableau « Avancement » qui n'est pas *fait*, et sa fiche dans « Catalogue ».
3. Relire les règles matérielles de [firmware-plan.md](firmware-plan.md) §2 et de [../Turret_firmware/README.md](../Turret_firmware/README.md) §13 avant de toucher au code (IO21 / IO47 jamais à l'état haut, ampli coupé avant tout arrêt de l'I²S, pas d'eFuse ESP32 brûlé…). **Ces règles valent pour la carte v0.1** ; sur la carte v2, les broches changent (« jamais à l'état haut » : IO40 / IO41 ; ampli : IO42) : voir « Brochage de la carte v2 » ci-dessous et [carte-v2-etat.md](carte-v2-etat.md) §4.
4. À la fin de chaque session : mettre à jour « État actuel », « Avancement », « Erreurs » et ajouter une entrée dans « Sessions », **dans le même commit** que le travail. Reporter aussi dans le journal local si on l'utilise.
5. Outils : deux postes Windows utilisés, sans compilateur C++ hôte (les tests natifs ne tournent que dans la CI). Le port COM de la carte change d'un poste à l'autre : le retrouver avec `pio device list` (VID:PID 303A:1001, MAC 10:51:db:5a:17:ec), puis `pio run -e turret2_bringup -t upload --upload-port COMx`.
   - poste du 17.10.2026 : PlatformIO hors du PATH → `%USERPROFILE%\.platformio\penv\Scripts\pio.exe`, et son `python.exe` pour pyserial ; carte sur **COM3** ;
   - poste du 19.10.2026 : `pio` dans le PATH (`C:\DATA\python3\Scripts\pio.exe`, cœur PlatformIO dans `C:\DATA\platformio`), pyserial dans `C:\DATA\python3\python.exe` ; carte sur **COM5**.
6. KiCad (poste du 17.10.2026) :
   - `kicad-cli` : `C:\Program Files\KiCad\10.0\bin\kicad-cli.exe` ;
   - le **MCP KiCad** de Claude Desktop (`C:\DATA\KiCAD-MCP-Server\dist\index.js`, lancé par `C:\portable\node-v20.18.3-win-x64\node.exe`) est aussi déclaré dans **Claude Code** depuis le 23.10.2026 (`claude mcp add kicad --scope user`, test « Connected ») ;
   - il n'est visible que dans une **nouvelle** conversation (`/mcp` pour vérifier). Pour le retirer : `claude mcp remove kicad -s user`.
7. Fusion (même poste) :
   - le **MCP Fusion** (extension Autodesk de Claude Desktop, simple relais) est déclaré dans Claude Code en HTTP direct, `http://127.0.0.1:27182/mcp` (`claude mcp add --transport http fusion --scope user`, test « Connected » le 23.10.2026) ;
   - **Fusion doit être ouvert**, avec son serveur MCP actif, pour que l'outil réponde ;
   - visible dans une nouvelle conversation ; pour le retirer : `claude mcp remove fusion -s user`.

## État actuel — 10.11.2026

- **10.11.2026** : revue complète du code ([firmware-code-review.md](firmware-code-review.md), notes par fonctionnalité, plus rien sous ★★★★) ; cycle de tir complété (état `Searching`, réglages `FireMs` / `SearchMs` / `AimZ`), analyseur radar à longueur fixe avec compteurs (`radar.bytes` / `frames` / `badFrames` dans `status`, pour le défaut 4), console en table de commandes (`help` généré, `scripts/check_commands.py` en CI), page web réécrite lisible et compactée au build, listes servies par `/api/meta`. **Pas essayé sur la carte** (débranchée ce jour-là) : à faire en premier à la prochaine session, puis `set AimZ true` pour vérifier le sens de la rotation Z. Non commité au moment de l'écriture.

- **Carte v2 routée** (projet maître hors dépôt, `Desktop\Turret2_v2_6c\`) : **6 couches**, DRC 0 erreur / 0 non connecté, **pas encore commandée**. État réel, règles, écarts avec le plan : [carte-v2-etat.md](carte-v2-etat.md). Ouvertures de pochoir sur H1, H2 et H3 (recto et verso) ajoutées le 01.11.2026.
- **Le brochage de l'ESP32 a changé au routage** : le tableau du §5 de [carte-v2-plan.md](carte-v2-plan.md) est périmé, la référence est **le tableau ci-dessous** (relevé dans le PCB le 01.11.2026). La mesure du courant et de la tension sur IO4 / IO5 (entrée du 24.10.2026) **n'est pas implantée**.
- **Carte fille des canons v2** faite (`Desktop\Turret2_carte_fille\`) : C1 100 µF polymère + C2 100 nF au ras de J2, même taille et mêmes connecteurs ; place vérifiée dans Fusion ([carte-v2-etat.md](carte-v2-etat.md) §10). Rien à changer côté firmware.
- **Firmware** : deux cartes depuis le 02.11.2026, choisies à la compilation : `turret2*` (v0.1) et **`turret2_v2*`** (v2, `TURRET2_V2`). **Garde-fou de carte** dans les deux : au tout début du boot, I²C sur IO35 / IO36 et recherche de l'extendeur à 0x20 ; mauvaise carte = rien n'est piloté, console USB seulement. Un firmware v0.1 **antérieur au 02.11.2026** n'a pas ce garde-fou : ne jamais le flasher sur une carte v2 (il pilote des PWM sur IO1–IO7, et IO7 est relié à SW1). Rails de la v2 pilotés depuis le 02.11.2026 (F2.4) : allumés un par un au boot, coupés en défaut d'alimentation et avant un redémarrage.
- **Prochaine action firmware v2** (lot F2) : **Lot F2 écrit en entier le 02.11.2026** (F2.1 brochage, F2.2 garde-fou, F2.3 extendeur, F2.4 rails, F2.5 fonctions de A / B, F2.6 veilles réglables depuis la page web) : compilé, **rien n'a tourné sur une carte v2** (pas encore fabriquée). Prochaine action : à la réception de la carte, mise en service avec `turret2_v2_bringup` (garde-fou, `rails`, `rail … on|off`, mesures listées dans les entrées 5 et 8 du 02.11.2026), puis essais de la veille.

### Brochage de la carte v2 (pour le firmware)

Relevé des nets de U7 dans `Turret2.kicad_pcb` le 01.11.2026, comparé à la v0.1 (README racine) :

| Fonction | v0.1 | **v2** | Remarque v2 |
|---|---|---|---|
| Servo canon gauche (GUN_LEFT) | IO1 | **IO33** | 330 Ω série (R28) |
| Servo canon droit (GUN_RIGHT) | IO2 | **IO48** | 330 Ω (R29) |
| Aile gauche (WING_LEFT) | IO4 | **IO26** | 330 Ω (R30) ; **R34 10 kΩ → GND** contre le pull-up interne au reset |
| Aile droite (WING_RIGHT) | IO5 | **IO34** | 330 Ω (R31) |
| Rotation X | IO6 | **IO15** | 330 Ω (R33) |
| Rotation Z | IO7 | **IO16** | 330 Ω (R32) |
| Hall gauche / droit | IO8 / IO9 | **IO8 / IO9** | inchangés ; 100 kΩ → GND (R40, R41) ; alimentés par 3V3_HALL (commuté) |
| I²S DIN / BCLK / LRCLK | IO10 / IO11 / IO12 | **IO39 / IO38 / IO37** | |
| AMP_SD (ampli en marche) | IO13 | **IO42** | R10 2 kΩ ; **ampli coupé (IO42 bas) avant tout `i2s.end()`** |
| AMP_GAIN / AMP_GAIN_100K | IO21 / IO47 | **IO40 / IO41** | **jamais à l'état haut** (drain ouvert ou entrée) |
| NeoPixel anneau (CENTER) | IO14 | **IO12** | IC2 3A → R27 330 Ω → J14 ; 100 kΩ → GND (R24) |
| NeoPixel canon gauche | IO15 | **IO17** | IC2 1A → R25 → J3 ; R22 |
| NeoPixel canon droit | IO16 | **IO18** | IC2 2A → R26 → J4 ; R23 |
| Radar : ESP32 reçoit (RX) | IO17 | **IO11** | 1 kΩ (R43) |
| Radar : ESP32 émet (TX) | IO18 | **IO10** | 1 kΩ (R42) ; passer en entrée avant de couper le radar |
| I²C SDA / SCL | IO35 / IO36 | **IO35 / IO36** | inchangés : `Wire.begin(35, 36)` ; IMU 0x6A, **extendeur 0x20** |
| IMU INT1 | IO37 | **IO14** | broche RTC : réveil EXT1 possible |
| PWR_FLT (eFuse) | IO38 | **IO21** | R6 10 kΩ → 3V3 |
| LED verte | IO33 | **IO13** | R18 100 Ω |
| LED rouge | IO48 | **IO47** | R12 680 Ω (IO47 n'est plus une broche de gain) |
| SW1 (DEBUG) | IO3 | **IO7** | R9 10 kΩ → 3V3, SW1 vers GND |
| PROG | IO0 | IO0 | R21 10 kΩ → 3V3 |
| Boutons A / B | IO26 / IO34 | **supprimés** | |
| Libres | IO39–IO42 | **IO1, IO3–IO6** | points de test TP10, TP6–TP9 au verso ; IO3 est un strap |
| Bouton déporté (J20, actif haut) | — | **IO2** | **décidé le 02.11.2026, à ajouter dans KiCad** ([carte-v2-etat.md](carte-v2-etat.md) §11) ; TP5 |
| Commandes des rails | — | **extendeur TCAL6416 (0x20)** | P00 SERVO_EN, P01 LED_EN, P02 RADAR_EN, P03 HALL_EN_N (actif bas) ; RESET = EN de l'ESP32 |

Inchangés : USB D− / D+ (IO19 / IO20), UART0 (IO43 / IO44, J16), IO45 / IO46 non connectées. L'IMU est **au recto** comme sur la v0.1 : pas de changement d'axes.

## État au 23.10.2026

- **23.10.2026** (deuxième carte, COM3) :
  - **Firmware** : `31830a7` flashé, avec `uploadfs` et les 55 répliques. Ensuite, compilés mais **pas flashés** (non commités, CI pas encore passée) :
    - correctif des servos relâchés aussitôt attachés (temps non signés, cause des « pas de 5° ») ;
    - rampe de vitesse `ServoRamp` sur alimentation faible ;
    - raison de chaque relâchement dans le journal ;
    - commande **`pins`** (registres de IO33 et de l'USB).
  - **Incident répété** pendant les essais d'un SG90 sur J9 (câble épissé) : **LED verte éteinte et USB perdu** (« échec de demande de descripteur »).
    - L'ESP32 tourne encore : Wi-Fi et page web accessibles le 22.10.2026.
    - **Un appui sur PROG rallume la LED** : le routage de IO33 vers le sigma-delta a été perdu.
    - Connecteur USB-C ressoudé une fois ; l'utilisateur le ressoude à nouveau.
    - Le jour où ça revient : lancer **`pins` par la page web avant de débrancher**.
  - **Servo** : il suit les petits pas, et les grands sauts calent sur l'USB du PC (alimentation trop faible, voir entrées 5 à 7 du 23.10.2026).
  - **Carte fille des canons** étudiée : [carte-v2-plan.md](carte-v2-plan.md) §13, aucun condensateur, **J2 a le signal au milieu** (à vérifier sur les canons).
  - **Prochaine action** :
    1. carte de retour sur l'USB : flasher, lancer `pins` (état normal), refaire l'essai du servo avec la console, `pins` si l'incident revient ;
    2. ajouter un condensateur au ras du servo de test, et sur J2 des cartes filles ;
    3. pousser (firmware + plan §13) une fois la CI vérifiée ;
    4. ensuite, la liste du 22.10.2026 ci-dessous.

## État au 22.10.2026

- **22.10.2026** :
  - **LEDs d'état** : la verte respire en douceur (sigma-delta, commit `d72c334`, flashée et vue sur la carte). Puis réglages *Status LEDs* sur la page web : mode de la verte (respiration, battement, fixe, éteinte), sa période et sa luminosité, mode de la rouge (codes de défaut, allumée tant qu'un défaut est actif, éteinte), en listes déroulantes. Compilés et vérifiés avec `tools/check_web.py`, **pas encore flashés**.
  - **Carte v2** : plan revu avant gel ; guide pas à pas [carte-v2-kicad.md](carte-v2-kicad.md). Le travail dans KiCad se fera sur le PC du projet maître.
  - **CI verte** sur `ce99340` (run 39743050619) : le nouveau `test_heartbeat` y est passé.
- **21.10.2026** :
  - **Deuxième carte** : composants chers transférés, même ESP32. Démarre, IMU saine après les soudures ; un pont U6 9–10 est sans effet. Capteurs Hall pas encore branchés.
  - **Firmware** : logo Aperture à la place de l'œil (OLED) et sur la page web, flashé sur COM3. Logo **pas encore vu sur l'écran** (SW1 était fermé).
  - **Carte v2** : plan matériel complet dans [carte-v2-plan.md](carte-v2-plan.md), avec un brochage refait pour le routage et l'outil `Turret2_portable/tools/gpio_study/`. Le document de l'utilisateur [AMELIORATIONS_V2.md](AMELIORATIONS_V2.md) est corrigé et renvoie au plan.
  - Le tout est poussé avec ce fichier.
- **GitHub, avant le 21.10.2026** : `main` = commit du 19.10.2026 « OLED: boot no longer hangs in U8g2 begin; 5 s fault alert » (correction de l'écran, alerte de défaut, ce fichier), après `a4eb329` (flash corrigé + battement de cœur) ; CI verte (run 39216617348), `test_heartbeat` et `test_fault_alert` compris. Puis commit « Rotary encoder, factory reset with SW1 + PROG, Qwiic module plan » : l'encodeur rotatif I²C (Q1 : `sensors/RotaryEncoder`, commande `volume`, touches d'encodeur du menu, tests `test_menu_encoder` et `test_volume_screen`) et la remise à zéro par SW1 + PROG (Q2 : commande `factory-reset`, tests `test_reset_gesture` et `test_factory_reset_screen`) — compilés, poussés à la demande de l'utilisateur **sans avoir été flashés** (carte débranchée), aucun encodeur encore reçu. Puis commit « Factory reset checked on the board, inputs command, LED resistor docs » : Q2 vérifié, commande `inputs`, docs des résistances de LED (R18 100 Ω). Les fichiers KiCad modifiés dans `Turret2_portable/` ne sont **pas** commités (copie portable, le maître est hors du dépôt).
- **Firmware** : lots 1 à 12 du plan + améliorations **I1, I2, IL, IM** faits et poussés ; 32 tests natifs et `tools/check_web.py` (45 vérifications, le 22.10.2026). Restent **I3** (B1 visée, B3 mode recherche, C1 vue radar de la page web ; la vue radar existe déjà sur l'OLED), **I4** et **I5**.
- **Carte réelle** : **première carte flashée le 17.10.2026** (env `turret2_bringup`, `upload` + `uploadfs` par l'USB natif) ; elle démarre et la console répond. Auto-test rapide : 9 OK, **1 échec (radar : aucune trame)**, 9 non faits. **19.10.2026 : écran OLED 0,96" (SSD1306, `OledType` 0) sur J11 vu fonctionner** en mode normal, après correction d'un blocage au boot (voir « Erreurs »). Avancement de la mise en service : colonne « État » de [firmware-plan.md](firmware-plan.md) §8.
- **Jamais vu sur le matériel** : les menus du mode debug sur l'écran (SW1 fermé), le son, les LEDs, les mouvements des servos et des ailes, la page web sur un vrai téléphone.
- **Prochaine action** (dans l'ordre) :
  1. radar (défaut 4 affiché par l'écran et la LED rouge) : c'est un **Ai-Thinker RD-03D V2** (pas un LD2450) ; souder le connecteur J5 et faire le **câble croisé** (README racine, « Radar cable » : J5.1 → 1, J5.4 → 2, J5.3 → 3, J5.2 → 4, broches 5–6 du radar libres), puis `selftest quick` et `status` (radar vivant, cibles) ;
  2. fermer SW1 (mode debug) tant que la carte est sur l'USB du PC (en mode normal, les 4 servos s'attachent au boot) ; essayer les menus sur l'OLED ;
  3. calibration : `ImuUpAxis` (tourelle debout), seuils Hall aimant près / loin (plan §8 G) ;
  4. sur une alimentation 3 A : son, LEDs, servos un par un, puis `selftest full` (plan §8 E, F, H) ;
  5. encodeur (Q1) à sa réception : sens de rotation, pas par cran (Soldered) ; la remise à zéro SW1 + PROG (Q2) est vérifiée ;
  6. à la réception du MPR121 : Q3 (catalogue Q) ;
  7. ensuite seulement : lot I3 ;
  8. carte v2 : mesures préalables du plan, §11 de [carte-v2-plan.md](carte-v2-plan.md) (fuite des TVS D1 / D5 au PPK2, modèle et courant des capteurs Hall, démarrage du RD-03D), puis placement KiCad et nouvelle passe de l'outil `gpio_study` avant de router.
- **Écrans** (05.10.2026) : 0,96" (SSD1306) et 1,54" « M154_4P » (SSD1309 très probable, non confirmé) gérés tous les deux ; un servo à la fois par défaut, levable ; menus en français et en anglais.
- **Matériel figé** (26.09.2026) : aucune modification de la carte ni du câblage, sauf « méga plus » (aucun identifié). Les mesures se font sans modification : cahier [experiments.md](experiments.md).
- **eFuse** : TPS259573 identifié en **auto-retry** (plan §2.5, D5) — cas déjà couvert par la détection de boucle de redémarrage ; reste à lire dans la datasheet le délai d'auto-retry pour vérifier que 3 cycles tiennent dans la fenêtre de 60 s du compteur.

## Avancement

| Lot | Contenu | Statut | Commit / remarque |
|---|---|---|---|
| I1 | A1 radar muet, A2 repos + zone de détection, D4 version git, D2 CI GitHub Actions | fait | 26.09.2026 ; build `turret2` / `turret2_bringup` OK, `tools/check_web.py` 22/22 ; CI GitHub **réussie** au 1ᵉʳ passage (run 36265316764, commit `a54d633`, 5 min 42 dont 5 min 21 de compilation sans cache) |
| I2 | A3 journal de crash + coredump, A4 watchdog, D1 tests natifs | fait | 26.09.2026, `cf57922` ; build OK, `check_web.py` 27/27 ; 12 tests natifs **réussis dans la CI** |
| I3 | B1 visée, B3 mode recherche, C1 vue radar | **écrit** (10.11.2026, 2ᵉ entrée ; `aim`, B6 œil et un premier pas de B10 le 12.11.2026), compilé, **à essayer sur la tourelle** | B1 : réglage `AimZ`, **faux par défaut** tant que le sens de la rotation Z n'est pas vérifié ; B3 : état `Searching`, `SearchMs` ; C1 : vue radar faite dans IM (page OLED) et sur la page web (compteurs) ; logique dans `logic/CycleLogic.h`, testée |
| I4 | B2 répliques vocales, C4 gestion des sons, B4 prise en main / renversement | à faire | |
| IL | L1–L5 : aides firmware pour les expériences (repères LED, balayages, motif NeoPixel, cycle de charge, PWR_FLT horodaté) | fait | 26.09.2026, `cf57922` ; build OK, `check_web.py` 27/27, CI verte |
| IM | M1–M7 : mode debug avec écran OLED sur J11, navigation par les boutons A / B, pages d'information, tests, calibration | fait | 05.10.2026, commits `83544a4` puis `8a88267` (tâche d'affichage + dix idées d'écran) ; passé avant I3 à la demande de l'utilisateur ; `check_web.py` 40/40 ; **CI verte** (run 37303638236) avec 24 tests natifs ; 19.10.2026 : blocage au boot corrigé, écran 0,96" vu fonctionner (mode normal) ; menus du mode debug pas encore essayés sur l'écran |
| HW | Mise en service de la première carte (plan §8, étapes A à J) | en cours | 17.10.2026 : flash + premier démarrage OK (étape B) ; radar sans trame ; détail par étape dans plan §8. 21.10.2026 : deuxième carte (composants transférés), même résultat, IMU saine |
| V2 | Carte v2 : veille sous 1 mA (rails commutés), corrections de la v0.1, brochage refait pour le routage | **routée, pas commandée** | 21.10.2026 : [carte-v2-plan.md](carte-v2-plan.md) (RD-03D seul, eFuse TPS259533, 3 × TPS22965, AO3401A, extendeur TCAL6416) ; 01.11.2026 : routée en 6 couches, DRC propre, brochage final dans « État actuel » et [carte-v2-etat.md](carte-v2-etat.md) ; carte fille des canons v2 faite |
| F2 | Firmware pour la carte v2 : `pins.h` et variante v2, pilote de l'extendeur, rails, garde-fou de carte, veille **configurable depuis la page web** (entrée du 02.11.2026, 3ᵉ) | **écrit** (02.11.2026, 4ᵉ à 8ᵉ entrées), compilé ; **à essayer sur la carte v2** | d'après le brochage de « État actuel » (01.11.2026) et le plan v2 §10 ; la mesure du §2.1 du plan n'existe pas sur la carte |
| I5 | au choix : A5, B5–B10, C2, C3, C5, C6, D3 | à faire | à trier avec l'utilisateur ; B9 (veille sentinelle) et B10 (vitesse des cibles) ajoutées le 19.10.2026 ; B10 va naturellement avec I3 (visée B1, vue radar C1) |
| IQ | Modules Qwiic sur J11 : Q1 encodeur rotatif, Q2 remise à zéro par SW1 + PROG (sans module), Q3 touche capacitive MPR121, Q4–Q7 en option | en cours | Q1 et Q2 écrits le 19.10.2026 ; **Q2 vérifié sur la carte** ; Q1 : commande `volume` vérifiée, encodeur pas encore reçu ; Q3 à la réception du MPR121 (commandé ou à commander : ADA1982 + ruban cuivre PRT-13827) |

## Catalogue

Effort : S = quelques heures, M = une journée, L = plusieurs jours.

### A. Fiabilité

| # | Quoi | Pourquoi / détail | Effort |
|---|---|---|---|
| A1 | **Radar muet = aucune cible** | `Turret_firmware/src/states/IdleState.cpp` déclenche sur `target.available` sans vérifier que le radar envoie encore des trames (`Radar` a déjà un indicateur de vie, `lastSensorUpdateTime` / « radar alive »). Radar débranché ou planté avec une cible en mémoire → cycles de tir sans fin. Corriger : cibles invalidées quand le radar est muet (timeout), et `Idle` exige un radar vivant | S |
| A2 | **Repos après `Disengage` + zone de détection** | aujourd'hui n'importe quelle cible, n'importe où, déclenche ; une personne immobile devant fait tirer en boucle. Réglages : `CooldownMs`, `DetectMaxMm`, `DetectAngle` (demi-angle), vitesse minimale éventuelle. Clés NVS ≤ 15 caractères | S |
| A3 | **Journal de crash** | dernières lignes du log dans une zone `RTC_NOINIT` (survit au reset logiciel, au panic, au watchdog), relues et affichées au boot et sur la page ; coredump écrit dans la partition `coredump` de `default_8MB.csv` et téléchargeable (`GET /api/coredump`) | M |
| A4 | **Watchdog de tâche** sur `loop()` | un blocage (I²C, radar, audio) fige la tourelle en silence ; avec le watchdog elle redémarre et la cause apparaît (raison du reset + A3) | S |
| A5 | **Mouvements adoucis** | accélération progressive des rotations et des canons : pics de courant plus faibles sur l'eFuse, mouvements plus proches du jeu | M |

### B. Comportement « vraie tourelle Portal »

| # | Quoi | Détail | Effort |
|---|---|---|---|
| B1 | **Visée réelle** | le radar (LD2450 / RD-03D) donne x / y en mm : angle = atan2(x, y) → rotation Z qui suit la cible (lissée), bornée. **Écrit le 10.11.2026** (`AimZ`, `logic::AimAngleDeg` / `SmoothAim`, ±60°) ; faux par défaut jusqu'à la vérification du sens sur la tourelle | M |
| B2 | **Répliques vocales** | « Target acquired », « Are you still there? », « Searching », « I see you », « Hello friend »… lues depuis LittleFS (1,5 Mo) avec le décodeur MP3 déjà compilé. **Fichiers audio jamais commités** (droits Valve) : envoyés depuis la page (C4) | M |
| B3 | **Mode recherche** | cible perdue → balayage gauche / droite quelques secondes, puis fermeture. **Écrit le 10.11.2026** : état `Searching` (voix `07_search`, `SearchMs`, balayage ±30° avec `AimZ`, cible revenue → nouvelle rafale) | S |
| B4 | **Prise en main / renversement** | l'IMU détecte soulèvement ou basculement : canons rentrés, réplique « Put me down! » | S |
| B5 | **Personnalités** | normale, « défectueuse », amicale (ne tire jamais), au choix dans la page | M |
| B6 | **Œil laser** | effets de la LED centrale de l'anneau : respiration au repos, fixe à l'acquisition, clignote au tir | S |
| B7 | **Horaires / nuit** | via le NTP : silencieuse ou endormie à certaines heures, volume réduit le soir | S |
| B8 | **Plusieurs tourelles** (ESP-NOW) | réveil en chaîne, « opéra » des tourelles | L |
| B9 | **Veille « sentinelle »** (idée de l'utilisateur, 19.10.2026) | **Entrée** : N minutes sans cible (réglage), heures de nuit (avec B7, et Q4 pour l'heure sans NTP), bouton / encodeur / commande `sleep`. **Pendant** : ailes fermées, servos détachés, LEDs éteintes, ampli en shutdown, écran éteint ou œil endormi, Wi-Fi coupé ou gardé (réglage), CPU ralenti (80 MHz) ou light sleep entre deux lectures ; **le radar reste actif**. **Sortie** : une cible dans la zone (« Hello? »), bouton A / B, PROG, encodeur, toucher (Q3). **Limite matérielle** : le 5 V n'est pas commutable (pas de load switch, EN de l'eFuse sur VBUS) → radar (LD2450 : **120 mA en moyenne** d'après le manuel Hi-Link ; **RD-03D V2 réellement monté : ~110 mA** d'après le manuel Ai-Thinker ; 5 V ; aucun mode veille dans leur documentation), servos au repos, NeoPixels éteintes (~0,5–1 mA chacune) et capteurs Hall restent alimentés ; gain estimé ~250–300 mA → ~150 mA, **à mesurer** (wattmètre USB, PPK2, experiments.md). **LD2410S examiné et écarté** (19.10.2026) : ~0,1 mA en moyenne (mesure à 1 Hz), mais présence + distance seulement (pas de x / y : plus de zone angulaire, de regard de l'œil, de vue radar ni de visée B1), alimentation 3,0–3,6 V (**J5 fournit 5 V : le détruirait**), 115 200 bauds et autre protocole ; et le LD2450 resterait alimenté. Sur une future carte v0.2 avec interrupteur sur le 5 V, il pourrait servir de veilleur qui rallume le LD2450. **Autres radars à suivi x / y examinés** (19.10.2026), tous en 5 V avec UART 3,3 V (compatibles J5 électriquement, ordre des broches à vérifier, nouveau pilote), **aucun avec une vraie veille** : Ai-Thinker RD-03D (3 cibles, ~92 mA, 256 000 bauds, format de trame à comparer à celui du LD2450 ; gain ~30 mA seulement) ; HLK-LD2460 (3–5 cibles, 120° × 90°, ≤ 250 mA ; modes « low-power / standby / shutdown » cités dans le manuel sans chiffres) ; HLK-LD2461 (260–400 mA). Un radar à angle fait tourner plusieurs antennes de réception en continu ; seuls les capteurs de présence simples (LD2410S) fonctionnent par impulsions. Conclusion : garder le radar actuel (le 20.10.2026, il s'est révélé être un RD-03D V2, pas un LD2450 : voir « Décisions ») ; une veille à quelques mA passe par un interrupteur sur le 5 V du radar (v0.2), avec le radar allumé par intermittence ou rallumé par un LD2410S. **Écarté** : deep sleep (gain faible tant que le 5 V reste alimenté ; boutons A / B sur IO26 / IO34 incapables de réveiller la puce, seuls IO0–IO21 le peuvent ; trames radar continues sur IO17 ; console USB perdue). Une vraie veille à quelques mA demanderait un interrupteur de charge sur le 5 V (carte v0.2, hors matériel figé) | M |
| B10 | **Utiliser la vitesse des cibles** (idée de l'utilisateur, 19.10.2026) | (« tir » = la séquence cosmétique de l'état `Firing` : canons sortis, LEDs des canons, bruit de tir ; rien n'est projeté) le radar donne déjà la vitesse **radiale** (LD2450 et RD-03D V2 monté : même champ, cm/s, bit 15 = positif ; d'après le composant ESPHome du RD-03D, positif = s'éloigne, à vérifier) de chaque cible (cm/s, signée ; signe « s'approche » à vérifier en marchant devant) : décodée dans `Radar.cpp` (`RadarTarget.speed`) mais jamais utilisée. **Réactions** : cible qui fonce vers la tourelle → colère, tir plus tôt ; approche lente → « Hello? » ; s'éloigne → « Are you still there? » ; immobile → « I see you » (avec B2). **Visée anticipée** avec B1 (viser en avant d'une cible en mouvement). **Filtrage** des fausses cibles (vitesse aberrante : reflets, ventilateur, rideau). **Affichage** : vitesse sur la page radar de l'OLED et de la page web, flèche sur la vue radar (C1). Ne remet pas en cause la décision A2 (pas de vitesse minimale pour déclencher) : la vitesse module la réaction, pas la détection | M |

### C. Page web et connectivité

| # | Quoi | Effort |
|---|---|---|
| C1 | **Vue radar en direct** : canvas avec les cibles et la zone de détection (A2), zone modifiable à la souris | M |
| C2 | **Temps réel** par WebSocket ou SSE au lieu de l'interrogation chaque seconde | M |
| C3 | **Sauvegarde / restauration des réglages** en JSON (mots de passe exclus) | S |
| C4 | **Gestion des sons** : envoi, écoute, suppression, association son ↔ événement (avec B2) | M |
| C5 | **Home Assistant par MQTT** : état, compteur de tirs, démo, mute, auto-découverte | M |
| C6 | **Statistiques** : cycles par jour, cibles vues, dernière activité | S |

### D. Qualité logicielle

| # | Quoi | Effort |
|---|---|---|
| D1 | **Tests natifs** (`pio test -e native`, sans carte) : parseur radar, bornage des réglages, interpréteur de commandes, logique Hall / seuils ; nécessite d'isoler ces parties des API Arduino | M |
| D2 | **CI GitHub Actions** : compilation des envs `turret2*` + tests natifs + test de la page contre `mock_server.py`, à chaque push | S |
| D3 | **Analyse statique** (`pio check`, cppcheck) et formatage automatique | S |
| D4 | **Version tirée de git** (`git describe --tags --dirty`) par script de pré-compilation, affichée dans la bannière, la page et `/api/status` | S |

### E. Mesures sans modification matérielle

La carte et le câblage sont figés (décision du 26.09.2026). Les mesures passent par les points de test (VBUS, 5V, 3V3) et les connecteurs, avec l'oscilloscope, le PPK2 (mode banc uniquement, < 1 A) et un éventuel testeur USB-C en ligne. Programme complet, montages et zones de résultats : **[experiments.md](experiments.md)** (X1 à X15).

Idées écartées : INA219 / INA226 en ligne (demande de couper un fil et, avec le shunt d'origine de 0,1 Ω, ajoute 0,3 V de chute à 3 A), modules Qwiic *pour les mesures* (les modules Qwiic d'interface sont revenus le 19.10.2026 : catalogue Q), modifications pour une carte v0.2 (pull-down sur IO14–16, mesure du 5 V par ADC) — gain trop faible pour un projet de loisir.

### L. Aides firmware pour les expériences

| # | Quoi | Effort |
|---|---|---|
| L1 | **Repères de boot** : réglage `LabMarkers` ; la LED verte (IO33) change d'état à chaque étape du boot et à chaque attachement de servo, pour aligner une courbe d'oscilloscope ou de PPK2 sur le code | S |
| L2 | **Balayages** : `sweep servo <n> <ms>`, `sweep tone <Hz début> <Hz fin> <ms>` | S |
| L3 | **Motif NeoPixel de test** : `led pattern bit`, une trame fixe avec un seul bit à 1, facile à lire à l'oscilloscope | S |
| L4 | **Cycle de charge** : `loadtest <écart ms>` attache et bouge tous les servos avec l'écart donné, puis les détache (expérience X4 sans redémarrer) | S |
| L5 | **Événements PWR_FLT horodatés** dans le log avec l'état en cours (servos attachés, LEDs, son) | S |

### M. Mode debug avec écran OLED (idée de l'utilisateur, 05.10.2026)

**Principe** : SW1 fermé au démarrage = **mode debug** (c'est le « mode banc » actuel, étendu). Un écran OLED I²C branché sur le port Qwiic **J11** (« I2C extender ») affiche des pages d'information et un menu de tests ; les boutons **A et B servent à naviguer** au lieu de leurs fonctions normales (démo, mute, Wi-Fi). Aucune modification de la carte : l'écran se branche sur J11 (3,3 V, SDA IO35, SCL IO36, bus partagé avec l'IMU).

| # | Quoi | Détail | Effort |
|---|---|---|---|
| M1 | **Pilote d'écran** | détection au boot (scan I²C : 0x3C, sinon 0x3D), bibliothèque figée, module `ui/Display` ; rafraîchissement seulement sur changement et au plus ~5 fois par seconde (une trame de 1 Ko à 400 kHz ≈ 25 ms pendant lesquels `loop()` est occupé) ; écran absent = mode banc actuel, sans rien d'autre | S |
| M2 | **Navigation à deux boutons** | A court = suivant, A long = précédent ; B court = valider / entrer, B long = retour ; « appui long » ramené à ~0,6 s dans ce mode (3 s en mode normal) ; arbre de menus décrit par une table ; logique pure dans `src/logic/MenuLogic.h`, testée en natif | M |
| M3 | **Pages d'information** (lecture seule, rafraîchies en direct) | voir « Contenu proposé » | M |
| M4 | **Menu de tests** | chaque entrée exécute une commande existante de `control/Actions` (`wings open`, `servo …`, `tone …`), donc même comportement et mêmes sécurités que la console et la page web ; résultat affiché sur une ligne | M |
| M5 | **Calibration à l'écran** | capture Hall ouvert / fermé, capture de l'axe IMU, trims des ailes par pas de 5 µs avec essai, enregistrement | M |
| M6 | **Écran en mode normal** (SW1 ouvert, écran laissé branché) | une seule page d'état (état, défauts, IP, heure), sans navigation : A et B gardent leurs fonctions normales | S |
| M7 | **Écran virtuel** dans la page web et le simulateur | `GET /api/screen` renvoie l'image de l'écran ; permet de mettre au point les menus sans carte ni écran, et de voir l'écran à distance | S |

**Contenu proposé** (à valider)

*Pages d'information*

| Page | Contenu |
|---|---|
| État | état de la machine, défauts actifs (mêmes numéros que la LED rouge), durée de fonctionnement, version |
| Alimentation | PWR_FLT, nombre de défauts eFuse, brownouts, boucles de redémarrage, raison du dernier reset, crash / coredump présent |
| Radar | vivant ou muet, nombre de cibles, x / y / distance de chacune, « dans la zone » ou non |
| IMU | gravité x / y / z, axe dominant, debout ou non, température |
| Hall | valeurs brutes gauche / droite avec une barre, seuils, position (ouvert / fermé / entre) |
| Servos | les 6 sorties : attaché ou non, largeur d'impulsion |
| Audio | gain, volume, muet, lecture en cours |
| Réseau | nom du point d'accès, clients, réseau maison + IP + niveau, heure |

*Tests*

| Menu | Entrées |
|---|---|
| Ailes | gauche : ouvrir / fermer ; droite : ouvrir / fermer ; les deux |
| Canons | gauche : sortir / rentrer ; droit : sortir / rentrer |
| Rotations | X et Z : −, centre, + (par pas, A = −, B = +) ; relâcher |
| Servo au choix | choisir une des 6 sorties, angle par pas de 10°, relâcher ; balayage |
| LEDs | rouge, vert, bleu, blanc, éteint ; anneau / canon gauche / canon droit ; motif « un bit » |
| Son | tonalité 1 kHz, bruit de tir, gain 9 / 12 / 15, volume ±, muet |
| Cycle | démo complète ; cycle de charge (`loadtest`, avec confirmation « alimentation 3 A ? ») |
| Bus | scan I²C |

*Calibration* : Hall (capturer ouvert / fermé, enregistrer), IMU (« la tourelle est debout », capturer), trims des ailes (pas de 5 µs, essai 2 s, enregistrer).

*Réglages rapides* : volume, luminosité des LEDs, temps de repos, distance et angle de détection, repères de labo.

*Système* : Wi-Fi marche / arrêt, redémarrer, remettre les réglages à zéro (avec confirmation), effacer le coredump, quitter les tests (`resume`).

**Points à trancher** : modèle d'écran (SSD1306 128×64 de 0,96", SH1106 de 1,3", autre) — il fixe la bibliothèque (Adafruit SSD1306, ou U8g2 qui couvre les deux) et la mise en page ; mode debug = mode banc (un seul servo à la fois, prévu pour une alimentation par un PC) ou mode à part où tous les tests sont permis ; langue des menus.

**Pièges prévus** : en mode banc un seul servo est attaché à la fois, donc « les deux ailes » et la démo ne sont possibles que si le mode debug lève cette règle ; A + B au démarrage reste la remise à zéro des réglages (lue avant le menu) ; l'écran ajoute ses résistances de tirage en parallèle des 2,2 kΩ de la carte (sans conséquence à 400 kHz, à vérifier à l'oscilloscope, expérience X9) ; un écran qui bloque le bus est déjà couvert par la récupération de bus et le watchdog.

### Q. Modules Qwiic sur J11 (19.10.2026)

Branchés en chaîne sur le port Qwiic **J11** (3,3 V, bus partagé avec l'IMU et l'écran), sans modification de la carte ; chacun détecté au boot, absent = rien ne change. **Budget de tirage** : chaque module ajoute ses résistances (souvent 10 kΩ) en parallèle des 2,2 kΩ de la carte ; écran + encodeur ≈ 1,2 kΩ ≈ 2,7 mA, juste sous les 3 mA de la norme I²C → au-delà de trois modules, couper le cavalier de tirage de certains, et vérifier les fronts (expérience X9).

| # | Quoi | Détail | Effort | État |
|---|---|---|---|---|
| Q1 | **Encodeur rotatif** | Adafruit 4991 (0x36) / 5752 (0x49) / Soldered 333188 (0x30), voir « Décisions » ; menu en mode debug, volume + muet sinon | M | écrit, non essayé |
| Q2 | **Remise à zéro par les boutons de la carte** | SW1 fermé + PROG 5 s, LEDs sans écran ; aucun module | S | **vérifié sur la carte** le 19.10.2026 |
| Q3 | **Touche capacitive MPR121** (Adafruit ADA1982, STEMMA QT, 0x5A ; idée de l'utilisateur) | électrodes en ruban de cuivre adhésif (PRT-13827, colle conductrice, 5 mm ; ou ruban anti-limaces de jardinerie, plus large) collées dans la coque ou dehors en décor, fil fin soudé, fils courts loin des câbles servos / haut-parleur, pastilles de 2–4 cm² espacées d'au moins 1 cm. **Usages** : (a) **réactions** au toucher (« Hello friend », œil qui se ferme si on la caresse, « Put me down! » si on la secoue en la tenant ; avec B2 / B4) ; (b) **boutons** : appui court / long par pastille, **commande configurable par un réglage par entrée** (ex. `TouchCmd0` = `demo`, `TouchLong0` = `wifi off`), donc modifiable depuis la page web sans recompiler ; (c) navigation du menu en mode debug ; (d) **curseur** : 3–4 bandes côte à côte, sens du glissement (volume) ; (e) **proximité** : électrodes regroupées, main détectée à quelques cm avant le contact (l'œil s'ouvre). Seuils par entrée à régler sur la tourelle montée (taille, fils, épaisseur du plastique) ; clés NVS ≤ 15 caractères | M | à la réception |
| Q4 | **Horloge temps réel** PCF8523 (Adafruit, 0x68, pile CR1220) | l'heure sans NTP (point d'accès seul) : journal horodaté, base de B7 (nuit) et C6 (statistiques par jour) | S | idée |
| Q5 | **Tampon I²C TCA4307** (Adafruit ADA5159, 4,45 CHF) | branchement à chaud sur J11 sans bloquer le bus de l'IMU, récupération automatique d'un bus coincé, capacité des câbles isolée ; rien à coder | – | idée |
| Q6 | **Capteur de lumière** (VEML7700 / VEML6030, en rupture le 19.10.2026) | baisser LEDs et écran dans le noir, sommeil la nuit sans horloge | S | idée |
| Q7 | **Distance laser** (SparkFun dToF TMF8820, 3 × 3 zones) | courte portée en complément du radar : main devant, obstacle avant d'ouvrir les ailes | M | idée |

Jugés inutiles : PIR (le radar fait mieux), ampli STEMMA (MAX98357A sur la carte), Tsunami WAV Trigger (MP3 déjà lus depuis LittleFS), multiplexeur TCA9548A (seulement pour plusieurs modules à la même adresse ; compliquerait l'accès au bus partagé avec la tâche d'affichage), LTC4311 (câbles longs seulement).

## Décisions

| Date | Sujet | Décision | Raison |
|---|---|---|---|
| 26.09.2026 | Suivi des améliorations | ce fichier versionné, plan + journal réunis | le journal principal et `CLAUDE.md` sont locaux (commit `210b05d`) ; une reprise sur un autre poste ou dans le cloud doit trouver l'état dans git |
| 26.09.2026 | Ordre | I1 → I2 → I3 → I4 → I5 | I1 corrige un bug réel et sécurise `main` (CI) avant la mise en service |
| 26.09.2026 | eFuse | TPS259573 = auto-retry | recherche web (pages produit TI) ; datasheet à confirmer |
| 26.09.2026 | Matériel | **figé** : pas de modification de carte ni de câblage ; ouvert seulement pour un « méga plus », aucun identifié ; INA, Qwiic et idées v0.2 retirés | projet de loisir ; la carte a déjà l'essentiel (eFuse avec FLT, étoile 5 V, buck-boost, AHCT, points de test) |
| 26.09.2026 | Apprentissage | cahier d'expériences [experiments.md](experiments.md) + lot IL d'aides firmware | l'utilisateur veut tester et mesurer pour apprendre (oscilloscope, PPK2 à venir) |
| 26.09.2026 | A1 | cibles effacées après 1 s sans trame complète (`Radar::Update`) ; `Idle` n'accepte une cible que si le radar est vivant (même délai) | une cible gardée en mémoire par un radar muet faisait tirer sans fin ; 1 s = une dizaine de trames manquées. Le défaut LED 4 garde son délai de 3 s |
| 26.09.2026 | A2 | réglages `CooldownMs` (5000, 0..120000), `DetectMaxMm` (3000, 300..6000), `DetectAngle` (45°, 5..60), groupe « Detection » ; cible valable si y > 0, distance ≤ max et \|atan2(x, y)\| ≤ angle ; repos appliqué à **chaque** entrée en `Idle` (après un cycle et après le boot) ; le bouton A / `demo` passent outre | le plus simple et sans état caché ; 60° = champ du LD2450, 6 m = sa portée. Vitesse minimale non retenue (une personne immobile qui entre dans la zone doit déclencher) |
| 26.09.2026 | D4 | `scripts/git_version.py` (pré-build) → `src/version_gen.h` (ignoré par git, réécrit seulement s'il change) ; `FIRMWARE_VERSION` dans la bannière, `/api/status` (`version`, plus `built` = date de compilation) et la page | un `-D` dans `build_flags` aurait tout recompilé à chaque commit |
| 26.09.2026 | A3 | journal de crash : 2 Ko de fin de journal en mémoire RTC (`RTC_NOINIT_ATTR`, placée à `0x50000000`, vérifié dans le `.map`), avec nombre magique et bornes ; conservé si le reset n'est pas un POWERON, affiché au boot seulement après un reset de type crash (PANIC, *_WDT, BROWNOUT, UNKNOWN) ; coredump : déjà activé dans le SDK précompilé (flash, ELF, CRC32) → résumé au boot via `esp_core_dump_get_summary` (tâche, PC, backtrace), mis en cache (le contrôle relit toute l'image), téléchargement `GET /api/coredump` par blocs, effacement | pas d'outil à installer pour voir la cause d'un crash ; le décodage complet reste `espcoredump.py` avec le `firmware.elf` du même build |
| 26.09.2026 | A4 | watchdog de tâche sur `loop()` : `esp_task_wdt_init(8, true)` (l'en-tête IDF 4.4 confirme qu'un 2ᵉ appel met à jour délai et panic) + `enableLoopWDT()`, en fin de `setup()` ; scan I²C interrompu au 1ᵉʳ délai dépassé (code 5 de `endTransmission`) | 8 s plutôt que les 5 s du SDK : marge pour les opérations longues légitimes (effacement du coredump, réglages) ; 112 délais I²C de 50 ms dépasseraient le watchdog |
| 26.09.2026 | D1 | logique pure extraite dans `src/logic/` (en-têtes sans Arduino) : `RadarLogic.h` (décodage LD2450, zone), `HallLogic.h` (seuils, polarité, rail), `BoardLogic.h` (anti-rebond / appuis, code LED, gain) ; le firmware les utilise (Radar, Wing, Board, Amp) ; env `native` (`platform = native@1.2.1`, Unity), 12 tests dont l'équivalence du décodage avec la formule d'origine sur les 65 536 valeurs ; `pio test -e native` ajouté à la CI | les tests portent sur le code réellement utilisé ; parties trop liées au matériel (servos, I²S, réseau) laissées au simulateur et à la carte |
| 05.10.2026 | Lot IM : écran | **U8g2 2.36.18** (un seul pilote pour SSD1306, SSD1309, SH1106), tampon complet 128×64, police `u8g2_font_6x10_tf` (Latin-1, accents) ; réglage `OledType` (0 / 1 / 2, au prochain boot) car le contrôleur ne se détecte pas ; adresse détectée (0x3C puis 0x3D) ; ~~broches SCL / SDA passées au constructeur, donc U8g2 appelle `Wire.begin(35, 36)`~~ **corrigé le 19.10.2026** : aucune broche passée au constructeur (U8g2 met en sortie toutes les broches qu'il connaît, voir « Erreurs ») ; U8g2 appelle alors `Wire.begin()`, sans effet sur le bus déjà démarré par `I2cBus` | l'utilisateur a des 0,96" et un 1,54" ; Adafruit SSD1306 ne couvre pas officiellement le SSD1309 ni le SH1106 |
| 05.10.2026 | Lot IM : architecture | l'écran est **six lignes de texte de 21 colonnes** (`logic::MenuScreen`) ; navigation et rendu dans `src/logic/MenuLogic.h` (pur, testé en natif) ; arbre dans `src/ui/MenuTree.h` (données pures, deux langues) ; chaque entrée de test exécute une **commande texte de `Actions`** ; l'OLED n'est renvoyé que si le contenu change (une trame ≈ 25 ms de bus), au plus 5 fois par seconde ; les mêmes lignes sont servies par `GET /api/screen` (écran virtuel, avec ou sans OLED) | testable sans écran ni carte ; même comportement et mêmes sécurités que la console et la page ; pas de bitmap à transporter |
| 05.10.2026 | Lot IM : comportement | SW1 = **mode debug** (ancien mode banc) ; les boutons naviguent seulement si un OLED est présent (sinon fonctions normales, et menu par la page web ou `key`) ; appui long 0,6 s dans ce cas ; en mode debug un cycle de démo finit en `Manual` (jamais de déclenchement par le radar) ; **un servo à la fois par défaut** (`Board::IsServoLimited`), levé par `power full` : alors « les deux ailes », `demo`, `loadtest` sont permis et `resume` attache et fait le homing ; SW1 ouvert + écran = page d'état seule ; `Language` (défaut 1 = français) | réponses de l'utilisateur (« 2 ok », « les deux », « IM tout de suite ») ; un port USB de PC ne supporte pas plusieurs servos |
| 05.10.2026 | Lot IM : Wi-Fi sur l'écran | menu **WiFi** à la racine : pages réseau tourelle (nom, **mot de passe affiché**, 192.168.4.1, clients), réseau maison, réseaux trouvés (4 plus forts), date et heure ; actions scanner, reconnecter, oublier (`wifi forget`), marche / arrêt, mot de passe d'usine ; **pas de saisie du mot de passe de la box avec deux boutons** (reste sur la page web) | demande de l'utilisateur ; le mot de passe du point d'accès à l'écran sert à connecter un téléphone, il n'est visible que par qui est devant la tourelle interrupteur debug fermé (et par `/api/screen`, lui-même protégé par ce mot de passe) |
| 05.10.2026 | Lot IM : animation des ailes | `MenuScreen.wingAnimation` + pourcentages ; `logic::HallPercent` (0 % au seuil fermé, 100 % au seuil ouvert, polarité indifférente) ; `logic::RenderWings` (version texte) et `Display::DrawWings` (corps ovale, œil, deux panneaux qui s'écartent de 24 px, canons dans l'ouverture) ; affichée tant qu'une aile bouge + 0,8 s, dans les deux modes ; réglage `OledAnim` (défaut oui) ; cadence inchangée (5 images / s au plus) | « ça pourrait être sympa » ; pilotée par les capteurs réels plutôt que par le temps. **Risque** : chaque image occupe `loop()` ~25 ms, donc l'arrêt d'une aile sur son seuil Hall peut être détecté jusqu'à 25 ms plus tard — à mesurer sur la carte, d'où le réglage pour la couper |
| 05.10.2026 | Lot IM : envoi de l'image hors de `loop()` | tâche FreeRTOS `oled` (priorité 1, cœur 0, pile 4 Ko) qui dessine et envoie ; `Display::Show` ne fait que copier les six lignes sous mutex et notifier la tâche ; si plusieurs images arrivent pendant un envoi, seule la dernière est dessinée ; animation portée à 10 images / s. **Remplace** le risque noté plus haut (arrêt d'une aile retardé de 25 ms) | question de l'utilisateur : « on ne peut rien faire pour améliorer ? ». Vérifié dans les sources : `Wire` prend un verrou par transaction (`CONFIG_DISABLE_HAL_LOCKS` absent du SDK), y compris pour la lecture en deux temps de l'IMU ; U8g2 (`u8x8_cad_ssd13xx_fast_i2c`) découpe l'image en transactions de 24 octets (~0,7 ms), donc une lecture IMU depuis `loop()` attend ~1 ms au plus. Écartés : envoi par bandes dans `loop()` (~3 ms par bande, plus simple mais bloque encore) ; I²C à 1 MHz (hors spécification de l'écran et de l'IMU sur un bus partagé) |
| 05.10.2026 | Lot IM : dix idées d'écran (toutes demandées) | modèle d'écran généralisé : `logic::Graphic` (None, Wings, Radar, Graph, Qr, Eye) + `value[8]` + `data[216]`, toujours avec une version texte dans les six lignes ; accroche `infoGraphic` pour qu'une page d'information ajoute un dessin ; nouveau type d'entrée `Wizard` (les enfants sont les étapes, libellé = consigne sur 3 lignes, `logic::WrapText`) ; **QR code par le générateur du SDK** (`esp_qrcode_generate`, déjà lié : aucune dépendance ; la lib `ricmoo/QRCode` aurait un `qrcode.h` en conflit avec celui de l'IDF) ; auto-test dans `control/SelfTest` (séquence non bloquante, passe par les commandes de `Actions`) ; compteurs dans `control/Stats` (NVS `stats`) ; veille, retournement et contraste appliqués par la tâche d'affichage ; œil en mode normal (`OledFace`) | « j'aimerais tout » ; le texte reste la base commune de l'OLED, de la page web, du simulateur et des tests |
| 20.10.2026 | Radar réellement monté | **Ai-Thinker RD-03D V2**, pas un HLK-LD2450 (constaté par l'utilisateur). D'après le manuel Ai-Thinker (« Rd-03D Multi-Target Trajectory Tracking User Manual » V1.0.0, §3 et §5) : 5 V, ~110 mA, UART 256 000 bauds 8N1 en 3,3 V, **mêmes trames que le LD2450** (`AA FF 03 00`, 3 cibles × 8 octets x / y / vitesse / résolution, `55 CC`, bit 15 = positif, mm et cm/s), 10 trames / s, portée 8 m, ±60° → **firmware inchangé** (seulement des commentaires). Connecteur du radar : 1 5 V · 2 GND · 3 TX · 4 RX · 5 DP · 6 DM ; J5 (vérifié dans `Turret2.kicad_pcb`) : 1 +5 V · 2 IO18 (TX ESP32) · 3 IO17 (RX ESP32) · 4 GND → **câble croisé obligatoire** (un câble droit laisserait le radar sans masse et mettrait IO18 dessus). Le README racine et le plan de conception avaient les broches 2 / 3 de J5 inversées : corrigés. **Non vérifié** : spécification de la V2 introuvable (lien Ai-Thinker en 404) ; mode multi-cibles par défaut ou non (sinon, une seule cible rapportée : commande à ajouter) ; portée 8 m non exploitée (réglages et vue radar plafonnés à 6 m) | l'utilisateur a regardé le module ; le parseur existant convient si la V2 garde le format de la V1 |
| 19.10.2026 | Remise à zéro par les boutons de la carte | **SW1 fermé + PROG (SW2, IO0) maintenu 5 s**, à tout moment une fois la tourelle démarrée (`logic::ResetGesture`) ; PROG doit avoir été vu relâché une fois depuis le boot ; lâcher PROG ou ouvrir SW1 annule ; LED rouge en clignotement rapide (100 ms) pendant le maintien, LED verte en clignotement rapide une fois accepté, jusqu'au redémarrage (2 s) ; compte à rebours sur l'écran s'il y en a un. Efface **tout** : réglages, statistiques (`Stats::Clear`), compteurs boucle / brownout (`Board::ClearCounters`), coredump. Commande `factory-reset` équivalente. IO0 lu en entrée seulement (`PIN_PROG`, `INPUT_PULLUP` après le boot) ; SW1 désormais lu aussi en marche pour ce geste. A + B au boot inchangé (réglages seulement) | demande de l'utilisateur : « reset usine avec les boutons de la carte, PROG, RST et peut-être le switch debug ; l'écran pourrait ne pas être branché ». RESET ne peut pas en faire partie : PROG enfoncé au relâchement de RESET = mode téléchargement de la ROM, et RESET coupe la puce (illisible) ; SW1 + maintien long = deux actions volontaires, sans minutage |
| 19.10.2026 | Encodeur rotatif I²C | module optionnel sur J11, **détecté au boot** dans l'ordre : Adafruit 4991 (seesaw, 0x36), Adafruit 5752 quadruple (seesaw, 0x49, bouton 0 seulement), Soldered 333188 (ATtiny404, 0x30, sans registre d'identité : un appareil en 0x30 qui renvoie 5 octets est pris pour lui) ; pilote maison `sensors/RotaryEncoder` (pas de bibliothèque : registres seesaw et protocole Soldered relevés dans les sources officielles), interrogé toutes les 30 ms (~1 ms de bus) ; mode debug avec écran : navigation (`MenuKey` Clockwise / Anticlockwise / Push / PushLong, traduites selon le mode par `MenuNav::FromEncoder`, la rotation ne répond jamais à une confirmation) ; sinon : volume par pas de 5 % + muet, écran du volume 1,5 s, enregistrement NVS 2 s après le dernier cran (commande `volume`) | demande de l'utilisateur (« menu + volume ») ; le 4991 visé d'abord était en rupture, l'utilisateur hésite entre le Soldered et le 5752 → les trois sont gérés. Interrogation et non interruption : le port Qwiic n'a pas de ligne INT |
| 19.10.2026 | Défauts sur l'écran | un défaut qui **apparaît** est affiché 5 s en plein écran (`logic::FaultAlert`, `logic::RenderFaultAlert` : un défaut par ligne avec son nom, code de la LED rouge en bas), dans les deux modes, avant le menu, l'animation et l'œil ; il réveille l'écran ; une touche le ferme plus tôt (mode debug) ; un défaut qui disparaît puis revient est annoncé de nouveau ; ensuite **seule la LED rouge** le signale (l'œil n'a plus de ligne « Défauts » permanente). Restent inchangées : la page d'état (`OledFace` à non) et la page « État » du menu, qui listent les défauts actifs | demande de l'utilisateur : « la LED rouge clignote pour le défaut, mais l'écran doit afficher le problème 5 secondes et passer à la suite » ; le défaut 4 (radar pas encore soudé) restait affiché en permanence |
| 26.09.2026 | Lot IL | L1 : `LabMarkers` (Bool, groupe Lab, appliqué aussitôt), `Board::Mark(label)` statique (bascule + ligne de journal), repères aux étapes 4 à 10, à chaque attache (`Gantry`) et à la fin du boot ; L2 : balayage servo en triangle, 1 consigne / 20 ms ; balayage de fréquence linéaire dans le générateur de tonalité (`PlayChirp`) ; L3 : `SetBitPattern` (luminosité 255 exacte car `FASTLED_SCALE8_FIXED` = 1, dithering coupé, luminosité restaurée) ; L4 : écart d'attache imposé en RAM (`Gantry::SetStaggerOverride`, 0 → 1 ms « tous ensemble »), ailes en `TestStop` ; L5 : ligne de journal avant le délestage ; balayage et `loadtest` annulés par `Fault` et `resume` | sans annulation, un balayage ou un `loadtest` redemanderait des servos pendant un défaut d'alimentation |
| 26.09.2026 | D2 | `.github/workflows/firmware.yml` : sur push / PR touchant `Turret_firmware/` ; PlatformIO 6.1.18 figé, cache `~/.platformio` + `libdeps` ; contrôle de la casse des `#include` ; build `turret2` + `turret2_bringup` ; `tools/check_web.py` (simulateur + `node --check`). Tests natifs ajoutés à la CI avec D1 (lot I2) | le runner est sous Linux, sensible à la casse (le fichier `FIringState.cpp` montre que le dépôt a déjà des noms atypiques) |
| 01.11.2026 | Brochage de la carte v2 | **brochage final relevé dans le PCB routé** (tableau de « État actuel ») ; il remplace le §5 de carte-v2-plan.md | lot C du routage (ordre des GPIO revu pour supprimer les croisements) ; I²C revenu sur IO35 / IO36, ampli sur IO37–IO42, IO1–IO6 libres |

## Erreurs, impasses et pièges

| Date | Quoi | Conséquence / solution |
|---|---|---|
| 04.11.2026 | **Anneau NeoPixel tout blanc** (9 LEDs, quelle que soit la couleur) : FastLED 3.10.5, figé au lot 1, lit `SOC_RMT_SUPPORTED`, que l'ESP-IDF 4.4 du cœur Arduino 2.0.17 ne définit pas → « pas de RMT » → pilote logiciel deux fois trop lent (« 0 » de 0,94 µs, bit de 2,6 µs) : le WS2812 lit chaque bit comme un « 1 ». Forcer `FASTLED_ESP32_HAS_RMT=1` ne suffit pas : son pilote RMT4 ne compile pas (classe abstraite) | **FastLED 3.9.20** (pilote RMT4 éprouvé sous IDF 4.4) ; mesuré : « 0 » 0,29–0,35 µs, « 1 » 0,65–1,0 µs, bit ~1,1 µs ; anneau rouge vu par l'utilisateur. Flash −365 Ko. Ne pas remonter en 3.10.x tant que le cœur reste en IDF 4.4 |
| 02.11.2026 | Datasheet du TCAL6416 (PDF de TI) illisible sur ce poste : pas de `pdftoppm` ni de `pypdf`, et la version HTML de TI ne donne que la table des matières | pilote limité aux registres standard de la famille 6416 (0x00–0x07), communs au TCA6416A et au PCAL6416A ; registres étendus (tirages, masque d'interruption, 0x40–0x4F) **non vérifiés**, donc non utilisés |
| 02.11.2026 | Le piège des `\` retirés par l'outil Bash (26.09.2026) s'est reproduit : deux remplacements Python dans un heredoc échouaient sur des chaînes contenant une barre oblique inverse suivie de « n » (assertion, rien d'écrit ; la même chose a ensuite coupé cette ligne en deux, corrigée à la main) | remplacements contenant `\` faits avec l'outil d'édition |
| 02.11.2026 | Tests natifs : `ziglang` installé dans le scratchpad (pip), mais son exécution a été refusée par le mode automatique de Claude Code | tests laissés à la CI |
| 26.09.2026 | `www.ti.com` et `www.digchip.com` bloqués par le proxy du conteneur cloud (curl et WebFetch) | variante de l'eFuse obtenue par les extraits d'une recherche web seulement ; confirmer dans la datasheet depuis un poste normal |
| 26.09.2026 | Sous VS Code (Windows), l'outil Bash retire les `\` du texte des commandes, même dans un heredoc `<<'EOF'` : un script Python passé en ligne a échoué (`SyntaxError`) | écrire tout script ou code contenant des `\` dans un fichier (outil d'écriture), puis l'exécuter ; déjà vu aux lots 4 et 10 (journal local) |
| 17.10.2026 | Premier flash sur la carte : après l'écriture, le reset RTS d'esptool (`hard_reset`) laisse l'ESP32-S3 en mode téléchargement (ROM : `rst:0x15 (USB_UART_CHIP_RESET),boot:0x20 (DOWNLOAD(USB/UART0))`) ; console muette, partitions NVS et coredump vierges = l'application n'avait jamais tourné. `after_reset: watchdog_reset` démarre l'application mais le port USB disparaît pendant le reset : esptool lève une erreur série (`OSError(22)`) et pio affiche FAILED alors que tout est écrit et vérifié | `upload.after_reset = no_reset` dans `boards/turret2.json` + `scripts/reset_after_upload.py` (post-action de `upload` / `uploadfs`) qui relance esptool `--after watchdog_reset read_mac` et ignore la perte du port ; vérifié : SUCCESS et application démarrée |
| 19.10.2026 | Écran OLED branché sur J11 : le boot se fige juste après `Bus already started in Master Mode` (appel de `Wire.begin` par U8g2), écran noir ; l'écran est pourtant vu au scan (0x3C). Cause : les broches SCL / SDA passées au constructeur U8g2 ; son `U8X8_MSG_GPIO_AND_DELAY_INIT` (`U8x8lib.cpp`) fait `pinMode(OUTPUT)` sur toute broche connue d'indice < 16 (`U8X8_PIN_I2C_CLOCK` = 12, `U8X8_PIN_I2C_DATA` = 13) **avant** `Wire.begin`, ce qui retire IO35 / IO36 au contrôleur I²C et les tire à la masse : `u8g2->begin()` ne revient jamais (watchdog pas encore armé à ce stade du boot). Les redémarrages « POWERON » vus pendant l'enquête venaient des débranchements, et ont mis la carte en mode réduit (compteur de boots suspects) | constructeurs appelés sans broches (`U8X8_PIN_NONE` seul) ; vérifié : `Display: OLED at 0x3C, type 0`, boot complet en 1,7 s, écran affiché. Le simulateur et les tests natifs ne pouvaient pas le voir : ils n'exécutent pas U8g2 |
| 26.09.2026 | Dans le conteneur cloud, la branche locale était restée au commit `dae8587` alors que `main` avait avancé (lots 2 à 12 faits sous VS Code) | toujours `git fetch` + se placer sur `origin/main` en début de session ; le journal local n'étant plus versionné, l'état se lit dans ce fichier, `Turret_firmware/README.md` et les messages de commit |

## Sessions

### 26.09.2026 — Proposition du plan d'améliorations

**Demande** : un nouveau plan d'amélioration et de fonctionnalités ; puis « confirmer la variante latch-off ou auto-retry de l'eFuse ? » ; puis « Go et pousse le journal amélioration pour une reprise sur VS Code ».

**Fait**
- Relu l'état réel sur `main` (`7a20d46`) : `Turret_firmware/README.md`, `IdleState.cpp`, `Radar.cpp`, `platformio.ini` ; constaté l'absence de tests (`test/` vide), de coredump et de watchdog, et le bug A1 (radar muet non vérifié par `Idle`).
- Proposé le catalogue A–E et l'ordre I1–I5 (ce fichier).
- Recherche de la variante de l'eFuse : auto-retry ; noté dans [firmware-plan.md](firmware-plan.md) §2.5 et D5.
- Création de ce fichier, commit et push sur `main`.

**Non fait** : aucune ligne de code ; aucune compilation dans cette session.

**Prochaine étape** : lot I1.

### 26.09.2026 (2ᵉ entrée) — Matériel figé, cahier d'expériences

**Demande** : discussion sur un INA219 puis un Power Profiler Kit II ; l'utilisateur a déjà un oscilloscope ; matériel figé sauf « méga plus » ; envie de tester, mesurer et apprendre ; « oui go ».

**Fait**
- Création de [experiments.md](experiments.md) : règles de sécurité (sortie BTL, masses, PPK2 < 1 A, pas de court-circuit), points de mesure, 15 expériences (alimentation, signaux, audio, PPK2) avec montage, réglages, attendu, ce qu'on apprend et zone « Mesures », journal des séances.
- Vérifié que les commandes citées existent dans `Turret_firmware/src/control/Actions.cpp` (`servo rotx`, `tone`, `led`, `set`, `demo`, `reboot`).
- Ce fichier : décision « matériel figé », partie E remplacée, nouveau catalogue L et lot IL.

**Prochaine étape** : lot I1 (ou IL, petit, si l'on veut commencer par les aides aux mesures).

### 26.09.2026 (3ᵉ entrée) — Lot I1, sous VS Code

**Demande** : « fais un synch », puis « go » (lot I1).

**Fait**
- **A1** : `sensors/Radar` — `Update()` efface les cibles après 1 s sans trame ; `IsInZone`, `FirstTargetInZone` (renvoie -1 si le radar est muet).
- **A2** : `states/IdleState` — repos `CooldownMs` à l'entrée, puis première cible vivante dans la zone ; la cible retenue est journalisée (x, y). Réglages `CooldownMs`, `DetectMaxMm`, `DetectAngle`.
- **D4** : `scripts/git_version.py`, `platformio.ini` (`extra_scripts` en liste), `.gitignore` (`src/version_gen.h`), bannière (`Firmware: <version> (built …)`), statut JSON (`version`, `built`).
- **D2** : `.github/workflows/firmware.yml` ; `tools/check_web.py` (22 vérifications : identifiants, page, réglages listés = lignes de `Settings.cpp`, mots de passe jamais renvoyés, clés NVS ≤ 15 caractères, bornage, refus du mot de passe court, champs du statut, portail captif, scan Wi-Fi, syntaxe JS).
- `Turret_firmware/README.md` : `Idle`, radar, réglages de détection, version, CI, `check_web.py`.

**Testé** : `pio run -e turret2 -e turret2_bringup` SUCCESS (`turret2` : flash 1 480 797, 44,3 % ; RAM 75 828, 23,1 %) ; version générée `fd63cb0-dirty` ; `python tools/check_web.py` : 22/22 ; casse des `#include` : 0 écart ; YAML du workflow et script intégré validés (PyYAML + `compile`). **Non testé** : la CI elle-même (au premier push), le radar réel.

**Prochaine étape** : I2 (ou IL).

### 26.09.2026 (4ᵉ entrée) — Lot I2, sous VS Code

**Demande** : « dans l'ordre » (après I1 : lot I2).

**Fait**
- **A3** : `board/Log` (`CrashLog::Begin`, `PreviousRun`, copie RTC dans `Append`), `board/CoreDump.{h,cpp}` (nouveau), `main.cpp` (`CrashLog::Begin` juste après `board.Begin()`, `PrintCrashReport()` après la bannière), commandes `crashlog` et `coredump [erase]`, routes `GET /api/crashlog`, `GET /api/coredump`, `POST /api/coredump/erase`, statut `crash` ; page : bandeau « The turret crashed » dans Status, carte « Crash report » dans Maintenance.
- **A4** : watchdog 8 s sur `loop()` ; scan I²C interruptible.
- **D1** : `src/logic/*.h`, refactorisation de `Radar.cpp`, `Wing.cpp`, `Board.{h,cpp}` (`ButtonEvent` = alias de `logic::PressEvent`), `Amp.cpp` ; `test/test_logic/test_main.cpp` ; env `native` ; étape CI.
- Simulateur : champ `crash`, routes crash, commande `sim crash on|off` ; `check_web.py` : 5 vérifications de plus.
- `Turret_firmware/README.md` : diagnostics de crash, tests natifs, commandes, API.

**Testé** : build `turret2` et `turret2_bringup` SUCCESS du premier coup (`turret2` : flash 1 487 157, 44,5 % ; RAM 76 120, 23,2 %) ; `rtcLog` à `0x50000000` dans `.rtc_noinit` (`nm` + `.map`) ; `check_web.py` 27/27. **Non exécuté** : les tests natifs (aucun `gcc` sur ce PC ; WSL absent) — cas vérifiés à la main contre la logique, exécution à la CI. **Non testable sans carte** : crash réel, coredump réel, déclenchement du watchdog.

**Prochaine étape** : IL, puis I3.

### 26.09.2026 (5ᵉ entrée) — Lot IL, sous VS Code

**Demande** : « continue lot II » (compris : lot IL, suivant dans l'ordre). Pas de réponse sur le push du lot I2 : rien n'est commité.

**Fait**
- **L1** : `board/Board` (`SetLabMarkers`, `Mark`, battement suspendu, état initial synchronisé sur la LED réelle), réglage `LabMarkers`, repères dans `main.cpp` (étapes 4 à 10) et `motion/Gantry` (chaque attache), `Actions::ApplyAllSettings`.
- **L2** : `sweep servo`, `sweep tone`, `sweep stop` (`control/Actions`) ; `Audio::PlayChirp`.
- **L3** : `led pattern bit` ; `Light::SetBitPattern`.
- **L4** : `loadtest <écart>` (phases Attaching → Holding → Returning) ; `Gantry::SetStaggerOverride`.
- **L5** : `Actions::LoadSnapshot` ; ligne « PWR_FLT event #n » dans `UpdateFaults()`.
- `Light::IsEnabled`, `Audio::IsPlaying` ; simulateur : réponses pour `sweep`, `loadtest`, `led pattern bit`.
- Docs : `Turret_firmware/README.md` (aides de labo, réglage `LabMarkers`), [experiments.md](experiments.md) (aides disponibles, X4 avec `loadtest`).

**Testé** : build `turret2` et `turret2_bringup` SUCCESS du premier coup (`turret2` : flash 1 492 605, 44,7 % ; RAM 76 448, 23,3 %) ; `check_web.py` 27/27. Sans carte : rien de mesuré.

**Prochaine étape** : I3.

### 26.09.2026 (6ᵉ entrée) — Push, CI, documentation

**Demande** : « commit », « go » (push), puis « est-ce que toutes les docs sont à jour ».

**Fait**
- Commit `cf57922` (I2 + IL, un seul commit : mêmes fichiers) poussé ; CI run 36267773678 **verte** en 5 min 42 : casse des includes, compilation (5 min 15 : le cache ne garde que les paquets, pas `.pio/build`), **tests natifs 6 s**, vérification de la page.
- Relecture des docs : ce fichier (statuts « non commité » / « tests non exécutés » périmés, corrigés) ; [firmware-plan.md](firmware-plan.md) (encadré « État au 26.09.2026 » avec renvoi au README du firmware et liste des écarts : page protégée, redémarrage après toute OTA, Wi-Fi maison / NTP / portail captif ; §10.2 annoté) ; `README.md` racine (détection, diagnostics, arborescence avec `docs/` et `.github/`). À jour sans changement : `Turret_firmware/README.md`, [experiments.md](experiments.md). Non concernés : `design-plan.md`, `status-and-history.md` (matériel).

**Prochaine étape** : I3.

### 05.10.2026 — Reprise ; idée du mode debug avec écran OLED

**Demande** : reprendre avec le lot I3 ; nouvelle idée à ajouter au plan : utiliser l'interrupteur de mode (SW1) pour passer la tourelle en mode debug, brancher un écran OLED sur le port I²C (J11), attribuer les boutons A et B à la navigation, et réfléchir aux informations et aux tests utiles (bouger l'aile droite, son, etc.).

**Fait**
- Synchronisation : `main` à `b1df2c3`, rien de nouveau depuis le 26.09.2026.
- Catalogue : famille **M** (M1 pilote, M2 navigation, M3 pages d'information, M4 tests, M5 calibration, M6 écran en mode normal, M7 écran virtuel), contenu proposé des pages et des menus, points à trancher et pièges ; lot **IM** dans « Avancement ».

**Non fait** : aucun code ; lot I3 pas commencé (attente des réponses sur le lot IM et de sa place dans l'ordre).

**Prochaine étape** : I3, ou IM d'abord selon la réponse.

### 05.10.2026 (2ᵉ entrée) — Lot IM : mode debug avec écran OLED

**Demande** : « j'ai plein de 0.96 mais j'ai aussi un m154_4p, il faudrait pour les deux ; 2 ok ; 3 les deux ; IM tout de suite ».

**Fait**
- **M1** `ui/Display.{h,cpp}` : U8g2, détection 0x3C / 0x3D, trois contrôleurs, dessin des six lignes (titre et ligne sélectionnée en inverse).
- **M2** `logic/MenuLogic.h` : `MenuNav` (modes Browse / Info / Adjust / Confirm, touches A, A long, B, B long), `MenuScreen` ; `Debouncer::SetLongPressMs`, `Board::SetNavigationButtons` (0,6 s).
- **M3–M5** `ui/MenuTree.h` (≈ 75 entrées : Informations, Tests, Calibration, Réglages, Système) ; `ui/DebugUi.{h,cpp}` (8 pages d'information en direct, accroches vers `Actions`, réglages et pages).
- **M6** page d'état en mode normal. **M7** `GET /api/screen`, carte « Debug screen » dans l'onglet Tests de la page (écran + boutons A, A long, B, B long), commandes `key` et `screen`.
- `control/Actions` : `wing left|right open|close`, `gun left|right extend|retract`, `servos off`, `shot`, `power [full|limited]`, `cal hall … / cal imu`, `key`, `screen` ; `demo` permis depuis `Manual` en mode debug avec `power full` ; `wings` / `guns` / `loadtest` / `demo` refusés tant que limité à un servo ; `LimitToChannel`.
- `board/Board` : `IsServoLimited`, `SetFullPower` ; `states/BootState` (attache si non limité), `states/DisengageState` (fin en `Manual` en mode debug).
- Réglages `Language`, `OledType` (groupe Display). `platformio.ini` : `olikraus/U8g2@2.36.18`.
- Simulateur : `tools/mock_menu.py` lit `MenuTree.h` et reproduit la navigation ; `sim debug|oled on|off`. `check_web.py` : 12 vérifications de plus (arbre lu, libellés ≤ 19 caractères, **chaque commande du menu existe dans `Actions.cpp`**, chaque valeur réglable est un réglage, parents valides, écran à 6 lignes, touches).
- Tests natifs : 8 tests de menu (rendu, bouclage et défilement, commande et réponse, confirmation, pages d'information, réglage avec bornes et sauvegarde, sous-menu et retour, cohérence de l'arbre réel).
- Docs : `Turret_firmware/README.md` (section « Debug mode and OLED screen », réglages, commandes, API, arborescence), `README.md` racine.

**Recherche** : le libellé exact « M154_4P » n'a pas été trouvé ; les modules OLED 1,54" 128×64 I²C à 4 broches trouvés utilisent le SSD1309 (LCDWIKI MC154GX, Waveshare, BuyDisplay). D'où `OledType` = 1 pour cet écran, **à confirmer en le branchant** (si l'image est décalée de 2 pixels, essayer 2 = SH1106).

**Testé** : `pio run -e turret2 -e turret2_bringup` SUCCESS du premier coup (`turret2` : flash 1 520 977, 45,5 % ; RAM 78 440, 23,9 % ; +28 Ko de flash pour U8g2 et les menus) ; page 19 454 → 7 262 octets gzip ; `check_web.py` 39/39 ; parcours du menu sur le simulateur (Tests → Ailes → Droite : ouvrir ; Son → Tonalité 1 kHz exécute `tone 1000 500`). **Non exécuté** : tests natifs (CI). **Non testable sans matériel** : affichage réel, lisibilité, boutons physiques, contrôleur du 1,54".

**Pièges** : `snprintf` ne remplit pas la fin du tampon → `memset` de tout l'écran avant le rendu, sinon la comparaison octet à octet échoue et l'OLED est renvoyé en continu ; les libellés accentués occupent plus d'octets que de colonnes (lignes de 48 octets pour 21 colonnes).

**Prochaine étape** : essai par l'utilisateur sur le simulateur, commit / push (CI : tests natifs), puis I3.

### 05.10.2026 (3ᵉ entrée) — Lot IM : Wi-Fi sur l'écran, animation des ailes

**Demande** : « il faudrait encore mettre des infos et paramètres sur l'OLED, le Wi-Fi ; ça pourrait être sympa une animation lorsque les bras bougent ».

**Fait**
- Menu **WiFi** (`ui/MenuTree.h`, `MenuWifi`, pages `PageWifiAp`, `PageWifiHome`, `PageWifiScan`, `PageTime`) ; les entrées Wi-Fi quittent « Système ». `web/AccessPoint::GetPassword`, `web/Station` (4 réseaux les plus forts du dernier scan), commande `wifi forget`.
- **Animation** : `logic/HallLogic.h` (`HallPercent`), `Wing::GetOpenPercent`, `logic/MenuLogic.h` (`wingAnimation`, `RenderWings`), `ui/Display` (`DrawWings`), `ui/DebugUi::Update` ; réglage `OledAnim` et entrées de menu « Animation ailes oui / non ».
- Simulateur : pages Wi-Fi, `wifi forget`, animation en texte quand les ailes bougent.
- Tests natifs : `test_hall_percent`, `test_wing_animation_screen` (22 tests au total).
- Docs : `Turret_firmware/README.md`.

**Testé** : build `turret2` et `turret2_bringup` SUCCESS (`turret2` : flash 1 525 433, 45,6 % ; RAM 78 912, 24,1 %) ; `check_web.py` 39/39 ; sur le simulateur : page « Réseau tourelle » (nom, mot de passe, adresse), « Scanner » puis « Réseaux trouvés », animation `[]==(O)==[]` à 55 % pendant l'ouverture. **Non exécuté** : tests natifs (CI). **Non testable sans matériel** : le dessin réel de l'animation sur l'OLED et son effet sur la précision d'arrêt des ailes.

**Idée notée, non faite** : un QR code Wi-Fi à l'écran (`WIFI:T:WPA;S:…;P:…;;`, version 3 = 29 × 29 modules, 58 px à 2 px par module : il tient sur 64 px de haut) pour connecter le téléphone sans rien taper ; demande une petite bibliothèque de QR code.

**Prochaine étape** : essai sur le simulateur par l'utilisateur, commit / push, puis I3.

### 05.10.2026 (4ᵉ entrée) — Push du lot IM ; l'écran ne bloque plus la boucle

**Demande** : « génial vas-y et as-tu d'autres idées » ; puis, sur le risque des 25 ms par image : « on ne peut rien faire pour améliorer ? ».

**Fait**
- Commit `83544a4` (lot IM) poussé ; CI verte (run 37297330123), 22 tests natifs réussis. Raté : un premier `git commit -m` avec des guillemets dans le message a échoué en silence sous PowerShell (rien n'était commité ni poussé) → message passé par fichier (`git commit -F`) ; un `tools/__pycache__/*.pyc` s'était glissé dans l'index → retiré, `__pycache__/` ajouté au `.gitignore`.
- Idées d'écran proposées (voir « État actuel »), en attente de choix.
- `ui/Display` : tâche d'affichage (voir « Décisions ») ; `ui/DebugUi` : 10 images / s pendant l'animation.
- Docs : `Turret_firmware/README.md` (paragraphe « The screen never holds up the main loop »).

**Testé** : build `turret2` et `turret2_bringup` SUCCESS (`turret2` : flash 1 526 113, 45,7 % ; RAM 79 216, 24,2 %). **Non testable sans matériel** : le partage réel du bus entre la tâche d'affichage et l'IMU (raisonnement sur les sources seulement) — à vérifier à la mise en service : pas d'erreur I²C dans le journal, pas de lecture IMU aberrante pendant une animation.

**Prochaine étape** : choix des idées d'écran, puis I3.

### 05.10.2026 (5ᵉ entrée) — Lot IM : les dix idées d'écran

**Demande** : « passe aux idées, j'aimerais tout ».

**Fait**
1. **Retournement et contraste** : réglages `OledFlip`, `OledContrast` ; `Display::Configure`, appliqués aussitôt (`Actions::SetSettingsListener` → `DebugUi::ApplySettings`).
2. **Veille** : `OledSleepS` (300 s, 0 = jamais) ; réveil sur touche (la première ne fait que réveiller), mouvement d'aile, changement d'état, défaut d'alimentation ; `Display::SetPower`.
3. **Auto-test** : `control/SelfTest.{h,cpp}`, 19 contrôles (11 passifs, 8 actifs), résultats OK / FAIL / SKIP / CHECK ; commandes `selftest [quick|report|stop]` ; `GET /api/selftest` ; carte « Self-test » dans l'onglet Tests de la page ; page « Rapport auto-test » du menu. `Wing::LastMoveTimedOut`.
4. **Assistant de calibration** : entrée « Assistant » (7 étapes : Hall G ouvert / fermé, Hall D ouvert / fermé, enregistrer, IMU debout, rappel des trims).
5. **Courbes Hall** : 100 échantillons par aile (un toutes les 50 ms, 5 s), seuils en pointillés.
6. **Journal** (4 dernières lignes) et **dernier crash** (résumé du coredump ou dernières lignes avant le reset).
7. **QR codes** : rejoindre le réseau de la tourelle (`WIFI:T:WPA;S:…;P:…;;`, champs échappés), adresse de la page web (IP maison si connectée).
8. **Vue radar** : zone de détection (arc + deux droites), cibles en points pleins (dans la zone) ou cercles, pleine échelle 6 m.
9. **Œil** en mode normal : endormi / éveillé (pupille vers la première cible) / en colère ; sous-titres aux changements d'état ; défauts actifs ; heure. `OledFace` pour revenir à la page d'état.
10. **Statistiques** : `control/Stats.{h,cpp}` (démarrages et cycles en NVS, cibles et dernier cycle depuis le boot) ; commande `stats`, page du menu, `/api/status`, ligne « Cycles » de la page web.
- Simulateur (`mock_menu.py` : entrées sur plusieurs lignes, assistant ; `mock_server.py` : nouvelles pages, `selftest`, `stats`), `check_web.py` (40 vérifications ; les « 39/39 » des entrées précédentes étaient un décompte erroné, il y en avait 35), tests natifs (`test_wrap_text`, `test_menu_wizard`, arbre réel avec étapes : 24 tests).
- Docs : `Turret_firmware/README.md`.

**Testé** : build `turret2` et `turret2_bringup` SUCCESS du premier coup (`turret2` : flash 1 553 921, 46,5 % ; RAM 82 592, 25,2 %) ; page 20 348 → 7 602 octets gzip ; `check_web.py` : tout passe ; 115 entrées de menu, 21 pages, 7 étapes ; assistant parcouru sur le simulateur. **Non exécuté** : tests natifs (CI au prochain push). **Jamais vu sur un écran** : aucun des cinq dessins (ailes, radar, courbe, QR, œil) — positions calculées, à ajuster sur le matériel ; lisibilité du QR code par un téléphone à vérifier (surtout sur le 0,96").

**Rappel** : la tâche d'affichage (entrée précédente) et ces dix idées ne sont pas encore commitées.

**Prochaine étape** : commit / push (CI), puis I3 (la vue radar de l'écran en couvre déjà une partie ; reste la visée, le mode recherche et la vue radar de la page web).

### 05.10.2026 (6ᵉ entrée) — Push des idées d'écran

**Demande** : « oui pousse ».

**Fait** : commit `8a88267` (tâche d'affichage + dix idées d'écran) poussé ; **CI verte** (run 37303638236) : casse des includes, compilation des deux envs, **24 tests natifs** (dont `test_wrap_text` et `test_menu_wizard`, exécutés pour la première fois), vérification de la page.

**Prochaine étape** : I3 (B1 visée, B3 mode recherche, C1 vue radar de la page web). Rien de ce lot IM n'a été vu sur un écran réel.

### 17.10.2026 — Premier flash sur une vraie carte (COM3)

**Demande** : « la carte est branchée sur COM3, peux-tu flasher le firmware de base ». Le firmware d'origine (`Fork/`) ne convient pas (cible 4 Mo + PSRAM) : c'est notre firmware, env `turret2_bringup`, qui a été flashé.

**Problème et solution** : voir « Erreurs, impasses et pièges » (17.10.2026) : reset après flash laissant la puce en mode téléchargement ; corrigé par `no_reset` + `scripts/reset_after_upload.py` ; nouveau flash : SUCCESS, l'application démarre seule.

**Constaté au premier démarrage** (console USB) :
- ESP32-S3 QFN56 rév. v0.2, flash 8 Mo GD intégrée, pas de PSRAM, MAC 10:51:db:5a:17:ec.
- Scan I2C : 0x6A seul ; LSM6DSOX OK, gravité (-8,73 ; 2,86 ; 3,50) m/s², |g| ≈ 9,83, axe dominant **-X** (ImuUpAxis encore à 0), 26,6 °C. Pas d'OLED branché.
- Audio I2S démarré ; point d'accès « Portal Turret » actif ; 4 servos attachés à 250 ms d'écart (1450 µs) ; démarrage en ~4 s, puis Idle.
- Raison du reset POWERON, PWR_FLT haut, 0 défaut, 0 brownout.
- Auto-test rapide : 9 OK, **1 FAIL (trames radar)**, 9 SKIP.
- Hall gauche 353, droite 187, tous deux vus « fermés » : calibration à faire.

**À faire** : vérifier le radar (branché sur J5 ? TX/RX croisés ?) ; calibration Hall et ImuUpAxis ; auto-test complet sur alimentation 3 A ; utiliser le mode debug (SW1) tant que la carte est alimentée par l'USB du PC.

### 18.10.2026 — État des lieux, plan mis à jour pour la reprise

**Demande** : un état des lieux, savoir si GitHub est à jour, et mettre le plan à jour pour une reprise propre.

**Constaté** : `git fetch` → `main` local = `origin/main` = `8a88267` ; la correction du flash du 17.10.2026 et la documentation correspondante ne sont pas encore commitées.

**Fait** :
- « État actuel » réécrit (daté du 18.10.2026) avec la liste ordonnée des prochaines actions ;
- « Reprise rapide » : outils du PC (chemin de pio, Python de PlatformIO pour pyserial, COM3) ;
- tableau « Avancement » : lot IM complété (`8a88267`), nouvelle ligne **HW** (mise en service) ;
- [firmware-plan.md](firmware-plan.md) §8 : colonne « État » par étape (A à J).

**Prochaine étape** : commit / push de tout cela si l'utilisateur le demande, puis radar et mise en service (voir « État actuel »).

### 18.10.2026 (2ᵉ entrée) — LED verte : battement de cœur

**Demande** : la LED verte doit rester allumée pendant le boot, puis battre comme un cœur. L'utilisateur voyait aussi la rouge clignoter : c'est le code de défaut 4 (radar muet), attendu tant que le radar n'envoie rien ; non modifié.

**Fait** :
- `logic::HeartbeatOn()` (`src/logic/BoardLogic.h`) : deux battements de 100 ms (à 0 et 250 ms) puis repos, période 1200 ms (50 par minute) ; remplace le flash de 80 ms par seconde ;
- `Board::UpdateGreenLed()` l'utilise ; fixe pendant le boot inchangé ; `LabMarkers` garde la priorité ;
- test natif `test_heartbeat` (25 tests) ; README §7 mis à jour.

**Vérifié** : compilation `turret2_bringup` OK (RAM 25,2 %, flash 50,3 %). **Flash non fait** : COM3 avait disparu (`pio device list` vide : carte débranchée ou hors tension). Test natif à vérifier dans la CI (pas de gcc sur le PC).

### 18.10.2026 (3ᵉ entrée) — Push

Commit `a4eb329` poussé (correction du flash, LED verte en battement de cœur, docs de mise en service) ; **CI verte** (run 39133815115) : includes, compilation des deux envs, tests natifs dont `test_heartbeat` (exécuté pour la première fois), page web. *(Entrée ajoutée le 21.10.2026 : notée localement le 18.10.2026, restée non poussée pendant les sessions du 19 et du 20.10.2026.)*

### 19.10.2026 — Flash sur un autre poste (COM5) ; l'écran OLED bloquait le boot

**Demande** : lire les fichiers de reprise ; flasher (carte sur COM5) ; l'écran est branché mais « le boot s'arrête ».

**Fait** :
- Poste différent : `pio` dans le PATH, cœur PlatformIO dans `C:\DATA\platformio` (« Reprise rapide » mise à jour) ; `main` = `origin/main` = `a4eb329`.
- Flash de `a4eb329` (battement de cœur) : SUCCESS. Console : `bootLoopCount` 6 → **mode réduit** (servos non attachés, état `Manual`), écran absent de l'état.
- Journal de boot capturé par un petit script pyserial qui survit à la disparition du port pendant un reset : scan `0x3C 0x6A`, puis blocage dans `u8g2->begin()` ; après débranchement, l'écran ne répondait plus au scan. La broche EN de l'écran, en l'air, a été reliée au 3V3 par l'utilisateur : sans effet sur le blocage.
- Cause trouvée dans les sources U8g2 et corrigée dans `src/ui/Display.cpp` (voir « Erreurs ») ; décision du 05.10.2026 annotée.

**Vérifié sur la carte** : boot complet (`Display: OLED at 0x3C, type 0 (SSD1306)`, `Boot: done in 1693 ms`, Idle) ; l'écran affiche, avec le **défaut 4** (radar muet, attendu tant que le radar n'envoie rien). Compilation sans erreur. **Non essayés** : menus du mode debug (SW1 fermé), boutons A / B.

**Prochaine étape** : radar (J5, croisement TX / RX), puis menus du mode debug avec SW1 fermé.

### 19.10.2026 (2ᵉ entrée) — Alerte de défaut de 5 s sur l'écran

**Demande** : le connecteur du radar n'est pas encore soudé ; le mode debug fonctionne-t-il sans radar (oui : état `Manual`, le radar n'y sert pas) ; puis « la LED rouge doit clignoter pour le défaut, mais l'écran doit afficher le problème 5 secondes et passer à la suite ».

**Fait** : `logic::FaultName`, `logic::FaultAlert`, `logic::RenderFaultAlert` (`src/logic/MenuLogic.h`) ; `ui/DebugUi` (alerte prioritaire, réveil, fermeture par une touche ; ligne « Défauts » retirée de l'œil) ; test natif `test_fault_alert` (26 tests) ; voir « Décisions ».

**Vérifié sur la carte** (commande `screen`) : ~5 s après le boot `! Défaut` / `4 Radar muet` / `LED rouge : code 4`, ~12 s après l'œil `(-)` seul. Compilation sans erreur (RAM 25,2 %, flash 50,3 %). **Non exécuté** : `test_fault_alert` (CI). **Non vu** : l'alerte en mode debug par-dessus le menu, la fermeture par un bouton.

**Prochaine étape** : souder le connecteur du radar ; menus du mode debug avec SW1 fermé.

### 19.10.2026 (3ᵉ entrée) — Encodeur rotatif I²C

**Demande** : prise en charge d'un encodeur rotatif I²C utilisable aussi comme bouton ; choix : Adafruit 4991, rôle « menu + volume ». Puis le 4991 est en rupture : Soldered 333188 ou Adafruit 5752 ? Faut-il un LTC4311 ? Et un multiplexeur SparkFun TCA9548A (BOB-16784) pour « augmenter la puissance » ?

**Fait** : `sensors/RotaryEncoder.{h,cpp}` (trois modèles, voir « Décisions ») ; `logic/MenuLogic.h` (touches d'encodeur, `FromEncoder`, indications qui suivent la dernière commande, `RenderVolume`) ; `ui/DebugUi` (`ShowVolume`) ; `audio/Audio` (`SetVolume`, `GetVolume`) ; `control/Actions` (commande `volume` avec enregistrement différé, aussi fait avant un redémarrage ; `key cw|ccw|push|hold`) ; `main.cpp` (`HandleEncoder`) ; tests natifs `test_menu_encoder`, `test_volume_screen` (28 tests) ; README du firmware.

**Réponses données** : LTC4311 inutile (bus de quelques dizaines de cm, 3–4 modules ; il sert aux câbles longs) ; le point à surveiller est l'inverse : les tirages des modules en parallèle des 2,2 kΩ (≈ 1,2 kΩ avec écran + encodeur, ≈ 2,7 mA, juste sous les 3 mA de la norme) ; multiplexeur TCA9548A : voir la réponse de la session (non nécessaire pour l'instant).

**Vérifié** : compilation `turret2_bringup` sans erreur ni avertissement (RAM 25,3 %, flash 50,4 %) ; `check_web.py` : tout passe. **Non fait** : flash (carte débranchée) ; tests natifs (CI) ; aucun module reçu, donc rien vu sur le matériel. **À vérifier à la réception** : sens de rotation (seesaw : inversé d'après les exemples Adafruit ; Soldered : compteur supposé croissant en sens horaire), nombre de pas du compteur Soldered par cran (`SOLDERED_COUNTS_PER_STEP` = 1 supposé).

**Prochaine étape** : flasher, puis essayer l'encodeur reçu (`key cw` etc. permettent déjà de tester le menu sans lui).

### 19.10.2026 (4ᵉ entrée) — Remise à zéro par les boutons de la carte

**Demande** : pouvoir revenir aux réglages d'usine avec les boutons de la carte (PROG, RST, peut-être SW1) ; réponses : geste « SW1 fermé + PROG 5 s », sans écran (LED rouge qui clignote, puis verte une fois accepté), et tout effacer, statistiques comprises.

**Fait** : `logic::ResetGesture` (`src/logic/BoardLogic.h`) ; `pins.h` (`PIN_PROG`, règle sur IO0 précisée) ; `board/Board` (lecture de PROG et de SW1 en marche, LEDs, `TakeFactoryResetRequest`, `ClearCounters`) ; `control/Stats::Clear` ; commande `factory-reset` (`control/Actions`, enregistrement différé du volume annulé) ; `main.cpp` ; écran `logic::RenderFactoryReset` dans `ui/DebugUi` (prioritaire) ; tests natifs `test_reset_gesture`, `test_factory_reset_screen` (30 tests) ; README du firmware (§7, commandes).

**Vérifié** : compilation sans erreur ni avertissement (RAM 25,3 %, flash 50,5 %) ; `check_web.py` : tout passe. **Non fait** : flash (carte débranchée), tests natifs (CI). **À vérifier sur la carte** : que PROG se lit bien à l'état haut au repos (pull-up interne + éventuelle externe), les deux clignotements, l'effacement réel (`stats`, `get`, `reset-reason` après le redémarrage).

**Prochaine étape** : flasher et essayer le geste ; commit / push de l'encodeur et de la remise à zéro.

### 19.10.2026 (5ᵉ entrée) — Modules Qwiic : plan, touche capacitive ; synchronisation

**Demande** : d'autres modules Qwiic utiles (catalogue Berrybase) ; l'idée du MPR121 plaît (disponible : ADA1982, 7,55 CHF) ; où trouver du cuivre adhésif ; « on peut aussi faire des boutons ? » ; « mets-le dans le journal à faire et synch ».

**Fait** : catalogue **Q** (Q1–Q7) et lot **IQ** dans « Avancement » ; « Idées écartées » précisé ; « Prochaine action » complétée ; commit et push de tout le travail du jour non poussé (Q1, Q2, documentation). Stock vérifié sur berrybase.ch le 19.10.2026 : MPR121 ADA1982 et ruban PRT-13827 disponibles, TCA4307 disponible, capteurs de lumière et VL53L1X Qwiic en rupture.

**Non fait** : aucun essai sur la carte de Q1 / Q2 (débranchée) ; pilote MPR121 (à la réception).

**Prochaine étape** : rebrancher la carte, flasher, essayer Q2 puis Q1 ; Q3 à la réception du MPR121.

### 19.10.2026 (6ᵉ entrée) — Essai sur la carte de Q1 (sans module) et Q2

**Demande** : « carte branchée » (COM5).

**Vérifié sur la carte** (`f3da119`, puis commande `inputs`) :
- boot sans encodeur : aucun message, rien ne change ;
- `volume +10` : 90 % aussitôt, NVS encore à 80 juste après, **90 trois secondes plus tard** (enregistrement différé) ;
- alerte de défauts avec deux défauts (1 boucle de redémarrage, 4 radar), code LED 1 ;
- **remise à zéro SW1 + PROG** : journal « PROG held with SW1 closed… », « Factory reset… », redémarrage `SW (restart)` ; après : `stats` boots 22 → **1**, `Volume` 90 → **80**, boots suspects **0**, brownouts 0, pas de coredump ; démarrage en mode debug (SW1 fermé).

**Enquête** : au premier essai, rien ; à l'essai suivant, 45 s d'écoute sans voir PROG enfoncé (appui fait hors de la fenêtre, ou sur un autre bouton). Commande `inputs` ajoutée (niveaux bruts de PROG, SW1, A, B ; étape C de la mise en service) ; un diagnostic temporaire des registres d'IO0 a montré une configuration correcte (fonction GPIO, entrée, tirage, aucune sortie, niveau 1 au repos), puis l'appui a été vu (niveau 0). Câblage confirmé dans `Turret2.kicad_pcb` : SW2 « Prog » → net `S3PRG` → U7 IO0 et J16.5 ; SW3 « Reset » → `S3En`. Conclusion : la lecture de PROG fonctionne ; le premier échec venait du geste (relâché trop tôt ou autre bouton), pas du firmware. Diagnostic de registres retiré ensuite.

**Remarque** : après un flash, le reset par watchdog d'esptool est rapporté `POWERON` par `esp_reset_reason()` (et compte comme boot suspect), comme un vrai débranchement.

**Prochaine étape** : encodeur et MPR121 à leur réception ; radar (J5).

### 19.10.2026 (7ᵉ entrée) — Veille, autres radars, vitesse des cibles

**Demande** : peut-on mettre la tourelle en veille avec le matériel actuel ? Le LD2410S ou d'autres radars ont-ils une veille ? La vitesse donnée par le RD-03D ; « pour info la tourelle ne tire pas, c'est cosmétique ».

**Fait** (documentation seulement) : catalogue **B9 « Veille sentinelle »** (veille partielle : le 5 V n'est pas commutable ; radar 120 mA d'après le manuel ; deep sleep écarté ; LD2410S et radars à suivi x / y RD-03D, LD2460, LD2461 examinés : aucun n'a de vraie veille, garder le LD2450) ; **B10 « Utiliser la vitesse des cibles »** (le LD2450 la donne déjà, décodée mais inutilisée) ; « tir » précisé comme séquence cosmétique ; une idée de tir réel notée puis retirée à la demande de l'utilisateur.

**Prochaine étape** : inchangée.

### 20.10.2026 — Le radar est un Ai-Thinker RD-03D V2

**Demande** : « j'ai regardé le radar, c'est un Ai-Thinker Rd-03D_V2, pas un LD2450 ».

**Fait** : manuel Ai-Thinker lu (PDF, texte extrait avec `pypdf` installé dans un dossier temporaire) : protocole identique au LD2450, voir « Décisions ». Brochage de J5 relu dans `Turret2.kicad_pcb` (J5.2 = IO18, J5.3 = IO17) : **le README racine et le plan de conception l'avaient inversé**, corrigés ; câble J5 → RD-03D décrit dans le README racine. Mentions du LD2450 mises à jour : READMEs, `firmware-plan.md`, `design-plan.md`, `experiments.md`, ce fichier (B1, B9, B10), commentaires du code (`RadarLogic.h`, `Radar.cpp`, `Display.cpp`, `Settings.cpp`), sans changement de comportement.

**Non fait** : aucun essai (connecteur J5 pas encore soudé). La valeur et la sérigraphie de J5 passent de « HLK-LD2450 » à « Radar » dans le projet KiCad maître (fait par l'utilisateur, hors du dépôt) ; les cartes v0.1 gardent « HLK-LD2450 » imprimé.

**Prochaine étape** : souder J5, faire le câble croisé, puis `status` / `selftest quick` ; si une seule cible est rapportée, ajouter la commande de passage en mode multi-cibles.

### 21.10.2026 — Deuxième carte ; pont entre les broches 9 et 10 de U6

**Information de l'utilisateur** : les composants chers ont été transférés sur une nouvelle carte, qui démarre ; un pont de soudure relie les broches 9 et 10 de U6 (non connectées normalement). Une analyse lui a été donnée ailleurs (sans danger ; INT2 / OCS_Aux ; retirer à la tresse ; à défaut `OIS_PU_DIS` = 1 dans `PIN_CTRL` 02h ; contrôle par WHO_AM_I = 0x6C).

**Vérifié dans `Turret2_portable/Turret2.kicad_pcb`** : U6 = LSM6DSOXTR (LGA-14) ; pad 9 = INT2, pad 10 = OCS_Aux, tous deux `unconnected-…` ; SDx (2) et SCx (3) **à la masse**, donc le SPI auxiliaire ne peut recevoir aucune horloge : OCS_Aux tiré bas par le pont n'a aucun effet fonctionnel. Firmware : INT2 jamais configuré (aucune écriture de `INT2_CTRL` ni de `PIN_CTRL` dans `src/`), donc INT2 reste au niveau bas. L'analyse est juste ; seul effet : un petit courant permanent dans le tirage interne d'OCS_Aux.

**Décision** : pas de contournement logiciel pour l'instant. `OIS_PU_DIS` coupe aussi le tirage de SDO_Aux (pad 11, en l'air) ; à n'envisager que si le pont reste inaccessible sous le boîtier.

**À faire sur la nouvelle carte** : reprendre la mise en service (plan §8) ; vérifier `0x6A` au scan et la gravité (`selftest quick`) après retrait du pont.

### 21.10.2026 (2ᵉ entrée) — Essai de la deuxième carte (ESP32 transféré)

**Information** : l'ESP32 déjà flashé a été déplacé sur la nouvelle carte (même MAC 10:51:db:5a:17:ec, COM3) ; firmware présent : `f3da119-dirty` (flashé le 19.10.2026 sur l'autre poste). Pont U6 9–10 encore en place.

**Vérifié par la console** : SW1 fermé (mode debug, état `Manual`), PROG / A / B relâchés ; reset POWERON, PWR_FLT haut, 0 défaut d'alimentation, 0 brownout ; scan I²C **0x3C (OLED) et 0x6A (IMU)** ; IMU : gravité (-0,02 ; 9,19 ; 3,18) m/s², |g| ≈ 9,73, axe dominant +Y (3), 27,8 °C, gyroscope ≈ 0 ; Hall gauche ~1030, droite ~830 (vus « fermés », valeurs très différentes de la 1ʳᵉ carte : 353 / 187) ; ampli actif, point d'accès actif. **Auto-test rapide : 10 OK, 1 FAIL (radar, J5 non câblé), 8 SKIP**. Défaut actif : 4 seulement.

**Conclusion** : le pont U6 9–10 n'a aucun effet visible ; la carte se comporte comme la première. **À faire** : calibration Hall et `ImuUpAxis` sur cette carte (tourelle montée), radar, essais avec alimentation 3 A ; éventuellement reflasher le dernier `main`.

### 21.10.2026 (3ᵉ entrée) — Flash de `58ba785` sur la deuxième carte ; Hall non branchés

**Demande** : « les capteurs Hall ne sont pas encore branchés ; go flash ».

**Fait** : flash `turret2_bringup` (`58ba785-dirty` : seuls des docs non commités) sur COM3 : **SUCCESS**, redémarrage par `reset_after_upload.py` (« Board restarted »), sans toucher à la carte. RAM 25,3 %, flash 50,5 %. Ensuite : auto-test rapide identique (10 OK, 1 FAIL radar, 8 SKIP).

**Constaté (erreur de ma part dans l'entrée précédente)** : j'avais présenté les valeurs Hall (~1030 / ~830, puis 861 / 767) comme une différence de carte à calibrer : en fait **J17 / J18 sont vides** et les entrées IO8 / IO9 **flottent**. PCB vérifié : les nets `HALL_LEFT` / `HALL_RIGHT` ne vont qu'à U7 et à J17.2 / J18.2, **sans résistance de tirage**. Conséquence : l'auto-test passe « Hall gauche / droit » en OK sur une entrée en l'air (il ne refuse que les rails 0 / 4095) ; le défaut 5 (« Hall bloqué ») ne se déclenche pas non plus.

**Idée proposée (non faite)** : détecter un capteur absent en activant brièvement le tirage interne bas puis haut de l'ESP32 pendant l'auto-test : une entrée en l'air suit le tirage (≈ 0 puis ≈ 4095), la sortie d'un capteur Hall linéaire ne bouge presque pas.

### 21.10.2026 (4ᵉ entrée) — Logo Aperture à la place de l'œil, et sur la page web

**Demande** : mettre le logo fourni (diaphragme à 6 lames, image PNG 512 × 512 sur fond transparent) à la place de l'œil de l'écran OLED, et sur le site web.

**Fait** :
- Géométrie ajustée sur l'image (disque, hexagone central d'apothème 0,34 R, six fentes de 0,06 R le long des côtés de l'hexagone jusqu'au bord) : 1,3 % de pixels différents, sur les bords lissés. Premier essai d'analyse raté : l'image est en mode « LA », tout noir en luminance, le dessin n'est que dans la couche alpha.
- `tools/aperture_logo.py` (Python pur) : produit le bitmap XBM et le SVG ; vérifié identique aux données intégrées.
- OLED : `src/ui/ApertureLogo.h` (42 × 42, 252 octets), `Display::DrawLogo` (`drawXBM`, centré, au-dessus des sous-titres) ; `logic::Graphic::Eye` → `Logo` ; `DebugUi::RenderFace` simplifié (plus de regard ni d'humeur ; ligne texte « Aperture » pour la version texte de la page) ; menus « Logo oui / non » ; description de `OledFace`.
- Page web : logo SVG en `currentColor` dans l'en-tête (suit le thème clair / sombre), même SVG en orange comme icône d'onglet (data URI).
- README du firmware.

**Vérifié** : compilation `turret2_bringup` sans erreur (RAM 25,3 %, flash 50,5 %) ; `tools/check_web.py` : tout passe. **Non fait** : flash (COM3 a disparu, carte débranchée) ; logo pas encore vu sur l'écran ni sur un navigateur.

### 21.10.2026 (5ᵉ entrée) — IMU après les soudures

**Demande** : vérifier l'IMU après de nombreuses soudures (deuxième carte, COM3, firmware `58ba785-dirty`).

**Vérifié par la console** : reset POWERON, PWR_FLT haut, 0 défaut ; scan I²C 0x3C et 0x6A ; 8 lectures `imu` de suite, carte à plat : gravité (-0,28 ; 1,00 ; 9,75) m/s² à ±0,01 près, **|g| = 9,81 m/s²**, axe dominant +Z ; gyroscope (0,010 ; -0,006 ; -0,011) rad/s, soit < 0,7 °/s, stable (dans le décalage de zéro typique du LSM6DSOX) ; température 23,2 → 23,7 °C (la carte chauffe après la mise sous tension). Auto-test rapide : 10 OK, 1 FAIL (radar), 8 SKIP. Conclusion : IMU saine. Non vérifié : chaque axe dans les deux sens (demande de poser la carte sur ses faces) ; état du pont U6 9–10 inconnu (sans effet de toute façon).

### 21.10.2026 (6ᵉ entrée) — Lecture de `docs/AMELIORATIONS_V2.md`

**Demande** : prendre connaissance du nouveau document v2 (déposé par l'utilisateur, non versionné pour l'instant) : load switches TPS22965 sur le 5 V (servos, LEDs, radar), OVLO de l'eFuse abaissé (R6 → 274 kΩ), /OE de l'AHCT125 commandé, radar sentinelle LD2410S, ampli déplacé sur IO39–IO42 pour libérer des GPIO RTC (réveil EXT1 par IMU_INT1 sur IO10 et sentinelle sur IO11), boutons A / B supprimés au profit d'un knob I²C, IMU et ampli au verso, deep sleep < 1 mA.

**Vérifié contre le dépôt** :
- Cohérent : IO0–IO21 seules capables de réveiller du deep sleep et toutes occupées sur la v0.1 (`pins.h`) ; 13 NeoPixels (9 + 2 + 2, `Light.cpp`) ; IO39–IO42 libres ; IO21 / IO47 gardés en drain ouvert ; LD2410S en 3,3 V, conforme à B9 (« veilleur sur une v0.2 avec interrupteur sur le 5 V »).
- **Erreur** : le document dit IO3 « pas utilisée » / « libre » et propose d'y mettre une touche tactile ; **IO3 porte SW1** (`PIN_BENCH_MODE`, mode debug, et geste de remise à zéro SW1 + PROG). À corriger, ou bien décider explicitement du sort de SW1.
- Périmé : le radar est un **RD-03D V2** (~110 mA, même protocole), pas un LD2450 ; « fork » → le firmware est `Turret_firmware/` ; le firmware actuel lit A / B (menus du mode debug, sourdine…) et gère déjà un encodeur I²C (Q1 : seesaw 0x36, Soldered) et un geste de secours sans réseau (SW1 + PROG, fait le 19.10.2026) ; la correction d'axes de l'IMU au verso dépasse `ImuUpAxis` (il faudra une matrice de passage dans `Motion`).

**Flash** (même session) : logo Aperture flashé sur COM3 (`58ba785-dirty`, compilé le 21.10.2026 15:37) : SUCCESS, redémarrage automatique. SW1 fermé → l'écran montre le menu du mode debug (« Debug tourelle »), donc le logo n'est pas encore vu : il faut SW1 ouvert au démarrage.

### 21.10.2026 (7ᵉ entrée) — `AMELIORATIONS_V2.md` corrigé

**Décisions de l'utilisateur** : on **garde SW1** (IO3) ; les boutons A et B sont supprimés sur la v2, **IO26 et IO34 deviennent libres**.

**Fait dans `docs/AMELIORATIONS_V2.md`** : bandeau de relecture ; RD-03D V2 à la place du LD2450 (consommation ~110 mA, références) ; IO3 = SW1 conservé (2.5, 2.6) ; tableau des broches libérées IO26 / IO34 (non RTC : ni réveil ni tactile) ; tactile via MPR121 (Q3) puisque IO1–IO14 sont toutes prises ; tableau de report des fonctions de A et B (démo, sourdine, Wi-Fi, réglages d'usine, menus) vers le knob, PROG et la page web ; encodeur I²C et geste SW1 + PROG signalés comme déjà faits ; correction d'axes de l'IMU au-delà d'`ImuUpAxis` ; « fork » → `Turret_firmware/` ; point de la section 5 sur A / B coché, report ajouté comme tâche.

### 21.10.2026 (8ᵉ entrée) — Variante v2 avec extendeur de GPIO

**Demande** : envisager un extendeur de GPIO ; « je ne risque pas de trop consommer ? ».

**Fait** : section 2.9 de `docs/AMELIORATIONS_V2.md` : PCAL6416A conseillé (RESET, rappels internes, mémorisation des entrées, ~1 µA) ; signaux admis (EN des switches, `QWIIC_EN`, SW1, sentinelle, INT1 de l'IMU) ou exclus (PWM, NeoPixel, I²S, UART, ADC, `PWR_FLT`, `AMP_SD`) ; réveil par l'INT de l'extendeur sur IO3 (SW1 passe sur l'extendeur), l'ampli reste sur IO10–IO13 ; piège du reset (l'extendeur garde ses sorties : RESET relié à EN + écriture « tout coupé » au démarrage) ; bilan de courant ; ligne J11 ajoutée au bilan de la section 1 ; trois points à valider en section 5.

**Réponse sur la consommation** : extendeur négligeable (~1 µA) ; le vrai risque pour le budget de veille est le 3,3 V de J11 (OLED allumé 10–20 mA, encodeur seesaw quelques mA, alimentés même en deep sleep), d'où la proposition `QWIIC_EN` (P-MOS commandé par l'extendeur). Valeurs de courant des modules : ordres de grandeur, à mesurer.

### 21.10.2026 (9ᵉ entrée) — Plan matériel de la carte v2

**Demande** : « un beau plan » : matériel à acheter, découplage et résistances de chaque nouvelle puce selon ses bonnes pratiques, tableau de toutes les GPIO, changements par rapport à la carte actuelle (broches flottantes), bus I²C et ses résistances, « et tout ce que je ne pense pas ». En cours de route : les modules Qwiic ne servent qu'au debug (tout sera piloté par la page web) ; **pas de LD2410S, on garde le RD-03D seul**.

**Fait** : `docs/carte-v2-plan.md` (nouveau) ; bandeau dans `AMELIORATIONS_V2.md` qui renvoie au plan. Sources : relevé complet de `Turret2.kicad_pcb` (script dans le dossier temporaire), datasheets lues le jour même (TPS22965, TPS22918, TPS2595, TCAL6416, SN74AHCT125, AO3401A, MAX98357A via la copie Adafruit, SMAJ Vishay) et *Schematic Checklist* ESP32-S3 d'Espressif.

**Constats nouveaux** :
- le connecteur des canons J3 / J4 n'a qu'une broche +5 V pour le servo et les 2 LEDs → LEDs des canons sur le rail des servos ;
- AMELIORATIONS_V2 attribuait le diviseur OVLO à R6 : c'est **R4** (R6 = pull-up de PWR_FLT) ; et 274 kΩ couperait dès 5,25 V avec la tolérance du seuil (1,13–1,27 V) → eFuse **TPS259533** (même boîtier et même brochage, sortie écrêtée à 5,2–5,7 V) ;
- IO26 a un pull-up au reset (Espressif) : interdit pour un EN actif haut → utilisé pour `HALL_EN_N` (P-MOS, le pull-up va dans le bon sens) ; IO12, IO13, IO37, IO39–IO42 : « IE » seulement au reset ;
- capteurs Hall alimentés en permanence (plusieurs mA) → P-MOS AO3401A ;
- SMAJ5.0A : fuite spécifiée jusqu'à 800 µA à 5 V chacune → SMAJ6.5A proposée, après mesure ;
- MAX98357A : pull-down interne de 92–108 kΩ sur SD_MODE → pas de pull-down externe ; 340 µA en standby si SD haut sans horloge ;
- IO0 sans pull-up externe sur la v0.1 (Espressif en recommande un) ; entrées Hall et AHCT flottantes ; lignes PWM / UART / données LED sans résistance série.

**Non vérifié** (marqué « [à vérifier] » dans le plan) : découplage exact du LSM6DSOX (site ST injoignable) et du MAX98357A (schéma d'application non extrait), courant de veille de la variante x3 de l'eFuse, de l'ESP32 et du TPS631000.

**Erreurs de la session** : `pdftoppm` absent (PDF illisibles par l'outil de lecture) → pypdf installé dans le dossier temporaire ; adresses NXP et TI « tps25957 » en 404 ; Analog Devices et ST en délai dépassé (copie Adafruit pour le MAX98357A).

### 21.10.2026 (10ᵉ entrée) — Brochage v2 refait pour le routage ; extendeur adopté

**Demande** : « comme on repart un peu du début », chercher une affectation des GPIO qui donne moins de croisements et de vias au routage, en partant de la v1 et de la répartition recto / verso connue, pour ne pas être bloqué sur les dernières pistes. En cours de route : « n'oublie pas les nouveaux IC et l'extendeur GPIO ».

**Fait** :
- Relevé de la v1 (`Turret2.kicad_pcb`) : position des pastilles du module (gauche IO0–IO11, bas IO12–IO48, droite IO35–IO42 + UART0 + EN), longueur et vias par signal, pistes et vias au dos sous le module. Constats : servos sortis du côté gauche et faisant le tour (WING_LEFT 106 mm), IO39–IO42 (côté droit, le mieux placé) inutilisées, une vingtaine de pistes au dos sous le module, J16 sous le module.
- Outil `Turret2_portable/tools/gpio_study/` (`kpcb.py` lecteur de PCB, `gpio_study.py` modèle + recuit simulé, `gpio_draw.py` dessin, README) : lignes droites recto ou verso avec vias, contraintes de l'ESP32-S3 (ADC1, RTC, tactile, pull-up de IO26, glitchs de démarrage), obstacles J16 et antenne, bus gardés groupés.
- Résultats du modèle : broches v1 reprises 150 croisements / 32 vias / 1057 mm ; variante A sans extendeur 8 / 25 / 1002 mm mais ampli éclaté et 4 passages bloqués ; variante B extendeur en face avant 27 / 24 / 954 mm ; **variante C extendeur TCAL6416 au dos près de l'IMU, retenue : 22 / 25 / 939 mm, 1 passage bloqué, bus groupés**. 16 recherches indépendantes donnent le même brochage C.
- `docs/carte-v2-plan.md` : §5 réécrit (tableau complet, §5.1 étude, §5.2 règles de placement : dégager le flanc droit du module de SW3 / R14 / C13, ROTATE_X au-dessus de J16, résistances série près des connecteurs, AHCT à portes libres, etc.), §4.9 fiche TCAL6416 (datasheet : RESET à EN, VCCI / VCCP 100 nF, ports en entrée à la mise sous tension), mises à jour des §0, 1, 2, 3, 4, 6, 7, 9 (devient la variante A), 10, 11, 12. Images `docs/img/gpio-v2-avant.png` et `gpio-v2-apres.png`.

**Non vérifié** : adresse I²C du TCAL6416 (figure illisible dans l'extraction ; 0x20 attendu comme le PCAL6416A). Positions des nouvelles pièces = hypothèses : relancer l'outil sur le placement v2.

**Erreurs de la session** : un premier brochage « nettoyé à la main » était moins bon que celui du recuit (36 croisements contre 22 : ordre des NeoPixel et de l'I²S) → abandonné ; « dont 4 ADC1 » écrit à tort (IO2–IO7 sont toutes ADC1), corrigé ; une commande de test écrivait une image à la racine du disque puis la supprimait : bloquée par la sécurité, rien n'a été exécuté, refait dans le dossier temporaire ; un téléchargement en parallèle (`cd X && (curl A) & (curl B)`) a lancé le second curl dans le dossier du dépôt : page « accès refusé » de Mouser enregistrée sous `lsm6dsox.pdf` à la racine, déplacée dans le dossier temporaire ; un script Python passé par heredoc a perdu ses `\` (piège connu) → réécrit dans un fichier.

### 21.10.2026 (11ᵉ entrée) — Push

Commit `0509307` poussé (logo Aperture sur l'OLED et la page web ; plan de la carte v2, brochage refait pour le routage, outil `gpio_study`, images) ; **CI verte** (run 39663277962) : includes, compilation des deux envs, tests natifs, page web. *(Entrée notée localement le 21.10.2026, poussée le 22.10.2026 après les sessions faites sur l'autre poste.)*

### 22.10.2026 — LED verte : respiration douce

**Demande** : le battement de cœur de la LED verte va trop vite ; l'utilisateur veut l'effet de la LED du PPK2 (« il est parfait »), en piochant si possible dans https://github.com/nordicsemi/pc-nrfconnect-ppk. Effet précisé ensuite : **respiration douce** (fondu continu, montée et descente).

**Constat** : l'effet n'est pas dans ce dépôt. L'application n'a aucune commande de LED (`src/constants.ts`) ; l'animation est dans le firmware du PPK2, fourni seulement compilé (`firmware/pca63100_ppk2_1.2.4_db16a94.hex`). Courbe refaite à l'œil.

**Fait** :
- `logic::HeartbeatLevel()` remplace `HeartbeatOn()` : luminosité 0..255, cosinus surélevé mis au carré (l'œil voit mieux les écarts dans le noir), période **4 s** (`HEARTBEAT_PERIOD_MS`), éteinte à t = 0, pleine à 2 s ;
- LED verte en **sigma-delta** (canal 0, `Board::SetGreenLevel()`) : les timers LEDC sont tous pris par ESP32Servo. 0 et 255 repassent la broche en GPIO simple (vraiment éteinte / allumée : le sigma-delta à -128 n'est pas garanti à 0 %) ; boot fixe, repères `LabMarkers` et clignotement de la remise à zéro inchangés ;
- `test_heartbeat` réécrit (valeurs à 0, 1, 2, 3, 4 s, montée sans retour en arrière et par pas ≤ 4 toutes les 10 ms, phase au débordement de `millis()`) ; README mis à jour.

**Vérifié** : compilation `turret2` OK (RAM 25,2 %, flash 46,8 %) ; valeurs du test recalculées en Python en flottants 32 bits (pas maximal 3). **Non vérifié** : tests natifs (pas de gcc sur le PC : CI), rendu sur la carte (pas flashé).

*Ajout* : flashé ensuite sur COM5 (`turret2_bringup`, version `c1fb771-dirty`) ; `status` normal (mode debug, IMU présente, défaut 4 radar muet attendu). Rendu de la respiration : à juger par l'utilisateur.

### 22.10.2026 (2ᵉ entrée) — Plan v2 : corrections, capteurs Hall, revue avant gel

**Demandes** : lire `docs/carte-v2-plan.md` et corriger ; identifier le radar de la v1 du projet d'origine (HLK-LD2450, même protocole que le RD-03D) ; sentinelle LD2410S abandonnée définitivement (« il n'y a plus de place ») ; ajouter les capteurs Hall ; « faire encore le tour du plan v2 avant que je le fige ».

**Fait** (`docs/carte-v2-plan.md`) :
- R18 à 100 Ω dans les §5 et §12 ; LEDs d'état en deep sleep ; total de la veille aligné ; capteurs Hall **OH49E** (liste de matériel du projet d'origine, datasheet Ouzhuo : 2,3–10 V, 4,2 mA typ. à 5 V, sortie au repos VCC / 2) ;
- revue avant gel, à partir du relevé KiCad v0.1 (composants, nets, positions) et des datasheets : **pont de retour du TPS631000 à 511 kΩ / 91 kΩ** (R7 / R8 de la v0.1 : 56 kΩ / 10 kΩ, 50 µA permanents ; valeurs du tableau 7-5 de TI), MODE à la masse vérifié (broche 6) ; courant de repos du TPS259533 confirmé (175 / 250 µA, commun aux variantes) ; adresse du TCAL6416 confirmée (0x20) et **registre de sortie à 0xFF au démarrage** (écrire les niveaux avant de passer en sortie) ; découplage du MAX98357A confirmé (0,1 µF + 10 µF) ; tensions maximales du +5V pendant l'écrêtage ; **veille radar avec le point d'accès Wi-Fi** (pas de veille du modem en point d'accès, ESP-IDF) : ≈ 170–200 mA estimés ; pull-down 10 kΩ sur IO26 (servo du canon droit pendant un redémarrage logiciel) ; note sur INT1 du LSM6DSOX au démarrage ; C29 / C30 repris sur 5V_RADAR / 5V_LED ; positions des switches précisées (SW_RADAR au dos, comme dans l'étude) ; garde-fou de carte et variante Arduino dans le §10 ; renvois de section corrigés (§8 → §10, §6 → §8).

**Non vérifié** : découplage du LSM6DSOX (datasheet ST encore non téléchargeable) ; courant réel de la veille radar et de la veille profonde (à mesurer sur la carte).

**Ensuite** : pull-downs de 100 kΩ sur les cinq autres lignes PWM (IO1, IO17, IO33, IO34, IO36 : aucun tirage au reset d'après la datasheet ESP32-S3, contrairement à IO26) mis **en option**, selon la place ; la 0 Ω 2512 du pont de mesure gardée à la demande de l'utilisateur, avec une tenue ≥ 4 A (les 0 Ω 2512 courantes, ex. Yageo RC2512, sont données pour 2 A).

**Puis** : guide pas à pas pour faire la v2 dans KiCad, `docs/carte-v2-kicad.md` (phases 0 à 7, points de contrôle vérifiés avec `kicad-cli`, KiCad 10.0.6 installé). Relevé de la v0.1 pour l'écrire : ERC de départ à 28 avertissements, aucun bloquant (18 symboles LCSC sans librairie, 5 écarts de symbole, 4 croix « non connecté » au bout des fils de IO39–IO42, 1 pad de l'ampli) ; membres du +5V ; nets de chaque broche de l'ESP32 ; TPS22965 absent des librairies de KiCad 10 (PCAL6416APW et AO3401A présents) ; H1, H2 et le logo « carte uniquement » ; écarts de nomenclature de la v0.1 (C27 : valeur 1 µF mais référence d'un 100 nF ; R1, R2, R8, C14, C17 : références 0402 sur des empreintes 0603) ; J2 (TC2050-IDC) relié à rien et absent du PCB.

**Erreurs de la session** : le 100 nF « 5V_RADAR » ajouté le matin à la liste d'achat était de trop (C29 existe déjà à côté de J5) → retiré à la revue ; la 0 Ω 2512, ajoutée sans courant nominal, a été retirée puis remise avec la condition ≥ 4 A ; un `python -` sans interpréteur valide a bloqué une commande (arrêtée) ; l'outil de lecture ne rend pas les pages d'un gros PDF (pdftoppm absent) → page extraite seule avec pypdf, puis lue.

### 22.10.2026 (3ᵉ entrée) — Réglages des LEDs d'état sur la page web

**Demande** : « dans les paramètres web, choisir la vitesse de la LED verte et les actions de la LED rouge, ou alors l'éteindre, etc. » (carte v0.1).

**Fait** :
- 4 réglages, groupe **Status LEDs** : `GreenLedMode` (0 respiration, 1 battement, 2 fixe, 3 éteinte), `GreenLedPeriod` (1000–10 000 ms, 4000 par défaut : un souffle ou un battement), `GreenLedBright` (1–100 %), `RedLedMode` (0 codes de défaut, 1 allumée tant qu'un défaut est actif, 2 éteinte). Appliqués tout de suite (`Board::ApplySettings`, qui reprend aussi `LabMarkers`).
- **Réglages « choix »** : nouveau champ `options` de `SettingsEntry` (« A|B|C »), envoyé par `/api/settings` ; la page en fait une **liste déroulante** ; la console accepte le numéro ou le nom (`set GreenLedMode off`) et refuse le reste (« off » ne devient plus 0 en silence) ; `get` affiche le nom entre parenthèses.
- Logique pure (`BoardLogic.h`) : `BreathLevel`, `HeartbeatOn` (retour du battement, période réglable), `ScaleLevel`, `GreenLedLevel` ; tests `test_breath_level`, `test_heartbeat`, `test_green_led_level` (32 tests natifs).
- Inchangés : les deux LEDs allumées pendant le boot (test des LEDs), le clignotement du geste de remise à zéro et `LabMarkers`, prioritaires sur les réglages.
- `tools/mock_server.py` (groupes avec espace, choix) et `tools/check_web.py` (5 vérifications de plus : 45) ; README (LEDs, réglages, API, console).

**Vérifié** : compilation `turret2` OK (RAM 25,6 %, flash 46,9 %) ; `check_web.py` : tout passe, syntaxe JavaScript de la page comprise. **Non vérifié** : tests natifs (CI), page sur la carte.

*Ajout* : poussé (`010e302`), CI verte (run 39748335024) ; carte débranchée avant la remise des réglages des LEDs par défaut (elle garde : verte en battement 1,2 s, rouge allumée sur défaut).

### 22.10.2026 (4ᵉ entrée) — Zones d'alimentation de la v2 ; vias et larmes

**Demande** : « est-ce que les 3 îlots de courant restent comme sur la v1 ? », puis une image, et prévoir à la fin du guide l'ajout de vias et des larmes (« lames »).

**Constat** (relevé de `Turret2.kicad_pcb`) : In2 porte VBUS, 3V3, 5V_logique et 5V_servos (doublée au verso, même contour) ; au recto, 5V_etoile à la sortie de l'eFuse, avec 7 vias de 0,9 / 0,5 mm vers les couches internes : 3 dans la zone 5V_logique, 4 qui touchent la zone des servos.

**Fait** : image `docs/img/zones-alim-v2.png` (v0.1 et v2, dessinée d'après les zones du PCB) ; guide KiCad : étape 5.4 « Zones d'alimentation » (contours gardés, zone des servos → 5V_SERVO, 4 vias de l'étoile à enlever, ≥ 7 vias à la sortie de SW_SERVO, TP2 → point de test 5V_SERVO), phase 6 corrigée (« sans via sur le chemin des servos » était faux : la v0.1 passe déjà par des vias) et nouvelle étape 6.7 « Finition : vias et larmes » (puissance, thermiques, couture de masse, larmes, remplissage) ; plan §8 (zones, points de test).

*Puis* (« il manque la taille des pistes et des vias ») : relevé des règles de la v0.1 (classes de nets Power5V 0,8 mm / vias 0,9 / 0,5, Power3V3 0,5, Servo et LEDData 0,3, I2C et I2S 0,25, Audio 0,8, USB 0,2 ; règles `Turret2.kicad_dru` ; cuivre 35 µm sur les 4 couches ; largeurs réellement posées). Guide : étape 4.7 « Classes de nets » (motifs `5V_*`, `VBUS*`, `3V3_*` : sans eux, les nouveaux rails tomberaient à 0,2 mm sans erreur du DRC), labels « _C » côté connecteur des résistances série (étape 1.3), tableau « Avant de router » en phase 6 (largeurs par net d'après IPC-2221 à 10 °C : 2,0 mm pour 4 A au recto, 5,3 mm en couche interne, d'où les zones ; ~1 A par via de 0,9 / 0,5 mm, ≥ 7 à la sortie de SW_SERVO), références des nouvelles pièces à ajouter aux règles « Pas fin ».

*Puis* : **second port I²C J19** demandé par l'utilisateur, Qwiic vertical Adafruit 4328 (lot de 10 ; plan du fabricant : Kaweei CCSH-W10-04-BK-RC, CMS vertical, empreinte du JST SH vertical, 1 A, ~4,6 mm de haut). En parallèle de J11 (1 GND, 2 +3V3, 3 SDA, 4 SCL, relevé dans la netlist), empreinte `Connector_JST:JST_SH_BM04B-SRSS-TB_1x04-1MP_P1.00mm_Vertical` (présente dans KiCad 10). Plan : §0, §3.1, §6 (pull-ups avec deux modules : ~1,5 kΩ, 2,2 mA), §11 (position et hauteur à décider) ; guide : étapes 1.4, 4.3, 5.3. Refusés par l'utilisateur : la limite de courant de l'eFuse commutable pour protéger le PPK2 (« il faut juste faire attention ») et la TPS22965N (il attend la TPS22965DSGR).

### 22.10.2026 (5ᵉ entrée) — Pochoir de la face B avec la face A peuplée

**Question** : comment poser le second pochoir sur la face B quand la face A est déjà peuplée ?

**Fait** : `docs/carte-v2-plan.md` §8, nouvelle puce (écrite le 21.10.2026 au soir sur le premier poste, fusionnée le 22.10.2026) :
- support (jig) qui porte la carte par ses bords et par des plots dans les zones libres de la face A, hauteur au-dessus du plus haut composant (~9 mm), dessus au niveau de la face B ;
- plots sous les zones imprimées et centrage par goupilles dans H1 / H2 ;
- CMS de la face B regroupés pour un pochoir partiel ;
- connecteurs traversants au fer en dernier ;
- pas de seringue pour le LGA ni le TQFN.

### 22.10.2026 (6ᵉ entrée) — Deuxième carte : l'USB n'est plus reconnu après l'essai d'un servo

**Constaté par l'utilisateur** : carte alimentée par l'USB-C du PC à travers un testeur USB HiDANCE, haut-parleur branché (le son marche). Au branchement d'un micro-servo (câble épissé sur un connecteur 3 broches), la LED verte arrête de clignoter. Ensuite, le PC ne reconnaît plus la carte, même branchée en direct. Elle tourne toujours : point d'accès Wi-Fi et page web accessibles.

**Relevé sur le PC** (journal Kernel-PnP) :
- 21:27:46 : un seul appareil vu, « VID_0000 PID_0002, échec de demande de descripteur », avec le testeur ;
- ensuite, plus aucun appareil au branchement, et aucun port COM.

L'USB marchait encore le 21.10.2026 (COM3, deux flashs) et apparemment le 22.10.2026 sur l'autre poste (COM5).

**Hypothèses** :
- ESP32 vivant, défaut limité au chemin USB : soudure du connecteur USB-C (levier du testeur), câble « charge seulement », D2 USBLC6, broches USB de l'ESP32 ;
- servo peu probable pour l'USB, mais il a pu faire redémarrer la carte (chute de tension, LED verte fixe pendant le boot).

**Tests proposés** :
- autre câble et autre port ;
- passage par **J1** (USB en parallèle du connecteur USB-C) ;
- loupe sur le connecteur USB-C ;
- mode diode sur D2 ;
- mode téléchargement (PROG + RESET) ;
- `reset-reason` et `flt` par la ligne de commande de la page web.

Mises à jour toujours possibles par OTA Wi-Fi. En cours chez l'utilisateur.

### 23.10.2026 — v2 : USB-C de la carte retiré, J1 en JST-XH

**Demande** : « de nouveau des problèmes avec le connecteur USB » (faux contact sur D−, d'après l'utilisateur) : retirer l'USB-C de la carte et ne garder que l'USB déporté. Puis, pour le courant de J1 : « plus simple de partir sur un connecteur plus gros ».

**Constat** : D− est câblé deux fois sur l'USB-C (A7, B7) : un faux contact sur une seule soudure ne marche que dans un sens de la fiche (test : la retourner ; réparation : refaire A6, A7, B6, B7). En usage normal, la tourelle est déjà alimentée par J1 (prise de la carte accessible capot ouvert seulement, design-plan §10). Contacts JST-PH : 2 A (24 AWG au plus) ; JST-XH : 3 A (22 AWG) ; JST-VH : 10 A (16 AWG) [datasheets JST].

**Fait** (`carte-v2-plan.md`, `carte-v2-kicad.md`, image) : USBC1, R1, R2 (5,1 kΩ du CC, déjà sur l'ADA6050) et D5 retirés ; **J1 en JST-XH 4 broches** (B4B-XH-A, même brochage, VBUS et GND en 22 AWG : 0,05 V à 3 A sur 15 cm) ; D1 et D2 collées à J1 ; câble de banc (ADA6050 de rechange) pour travailler hors de la tourelle ; une seule TVS (pire fuite 0,8 mA au lieu de 1,6) ; règle « Pas fin » sans USBC1 ; zones et image mises à jour. Rien à changer côté firmware.

*Puis* : rendus Fusion du support (arche, coque) : de la place au-dessus de la carte. L'antenne de l'ESP32 dépasse du bord haut à gauche (zone d'exclusion de la v0.1 : x 60,1–105,5 mm, antenne + 15 mm de chaque côté) : seule la partie droite peut monter (≈ 36 mm de large). **Décision : monter seulement la partie droite** (déplacer le module, écarté). Plan §0, §8 (image `docs/img/agrandir-carte-v2.png`), §11 ; guide : étape 5.0 (forme dessinée dans Fusion, DXF importé sur Edge.Cuts, calé sur H1 / H2 ; zones à agrandir) et 5.3 (nouvelles pièces dans la place gagnée ; IMU et ampli peut-être au recto, une seule face). Hauteur disponible : à mesurer dans Fusion.

*Puis* : mesure dans Fusion : **8 mm jusqu'au dessous du haut-parleur** → la partie droite monte de **5 à 6 mm** (2 à 3 mm de marge) ; carte de 77 × 41 à 77 × 47 mm ; gain ~2 cm² (+6–7 %) : quelques petites pièces (SW_LED près de J14, J19, points de test, peut-être l'IMU), probablement pas tout au recto. Guide, étape 5.0 réécrite : plus de DXF, le bord haut droit et ses arrondis se déplacent de h dans KiCad (coordonnées pour h = 6 mm), puis export STEP pour vérifier dans Fusion. Image `docs/img/agrandir-carte-v2.png` refaite à l'échelle (haut-parleur à 8 mm, bande de 6 mm).

### 23.10.2026 (2ᵉ entrée) — Identifiant web Admin / 1234 ; les voix de l'upstream

**Demande** : « compte et password Admin / 1234 » et « rajoute tous ces sons » (dossier `data/` de joranderaaff/portal-turret-v4).

**Constat** :
- le WPA2 du point d'accès exige 8 caractères au moins : `1234` ne peut pas être le mot de passe WiFi ;
- l'upstream a 55 répliques MP3 (22 050 Hz mono, 32 à 56 kbit/s, 0,5 à 3,2 s, petite étiquette ID3) rangées par situation : activation, retrait, recherche, renversée, ramassée ; `02_collision`, `04_shutdown` et `09/001` n'y sont jouées nulle part ;
- l'enveloppe C++ de libhelix décode par paquets de 1 Ko : le dernier Ko d'un fichier (~0,15 s) ne sortait jamais ;
- son allocateur boucle à l'infini quand `malloc` échoue, au lieu de rendre `null` ;
- le pilote I2S d'arduino-audio-tools : écriture bloquante, un `i2s_write` par échantillon en mono, `availableForWrite()` constant (3072) ;
- un son qui finit au milieu d'un tampon DMA rejoue l'autre moitié, qui contient d'anciens échantillons.

**Fait** :
- identifiant de la page web séparé : `WebUser` / `WebPassword` (usine `Admin` / `1234`, 4 à 63 caractères, au prochain démarrage), aussi pour `/update` ; `ApPassword` reste le mot de passe WiFi (`stillalive`) ;
- `get` masque `WebPassword` ; contrôles de la page (4 caractères pour `WebPassword`, pas de `:` dans `WebUser`) ; écran QR : l'utilisateur réel ; `platformio.ini` (OTA), README, plan D7 ;
- les 55 MP3 dans `Turret_firmware/data/` (`pio run -t uploadfs`) ;
- `audio/Mp3FrameDecoder` : API C de Helix, une trame par appel, étiquette ID3v2 sautée, sans Arduino ;
- `Audio` : réplique au hasard dans le dossier, jamais deux fois la même ; doublée à 44,1 kHz par interpolation ; volume ; tampons DMA entiers (512 trames stéréo) écrits sans attendre, jusqu'à ~90 ms d'avance ; mémoire vérifiée avant le décodeur (40 Ko libres) ; le tir et la tonalité coupent une réplique ;
- branchements : activation au déploiement (le tir attend la fin de la réplique, 3,5 s au plus), retrait au repli, renversée après une chute (debout 2 s, puis plus debout 0,5 s ; il faut `ImuUpAxis`) ; arrêt en défaut ;
- réglage `Voices` ; commande `voice [nom|stop]` ; page (Tests : liste et *Play voice*) ; menu de debug (trois répliques) ;
- `logic/AudioLogic.h` (`Upsampler`, `PickVoiceFile`, `Id3v2Size`, `TipWatch`) et ses tests ;
- simulateur et `check_web.py` (identifiant, secrets, voix de la page = voix du firmware, un MP3 par dossier).

**Vérifié** :
- compilation `turret2` OK (RAM 28,1 %, flash 46,0 %), sans avertissement dans `src/` ;
- `check_web.py` : tout passe ;
- tests natifs : 37 / 37, compilés sur ce PC avec zig / clang (pas de gcc ici) ;
- sur le PC, avec le même `Mp3FrameDecoder` et la même chaîne (suréchantillonnage, blocs DMA, remplissage final) : les 55 répliques et `fire.mp3` décodées jusqu'à la dernière trame, aucune trame sautée ;
- résultat identique à un décodeur de référence (dr_mp3) : rapport signal / bruit de 85 à 93 dB ;
- décodeur : 23,9 Ko en 8 blocs (le plus gros 8,7 Ko), aucune fuite.

**Non vérifié** : écoute sur la carte (débranchée) : timing I2S réel, volume, `uploadfs`.

*Ajout* : poussé (`f0250bd`), CI verte (run 39932353458 : compilation, tests natifs, `check_web.py`). Mémoire I²C pour les MP3 envisagée pour la v2, puis écartée : ils tiennent dans la flash (LittleFS : ~1 Mo libre).

### 23.10.2026 (3ᵉ entrée) — Contour rehaussé de la v2 : modèle 3D

**Fourni** : `Turret2_rehausse.step`, export KiCad de la carte au contour rehaussé (composants compris), rangé dans `Turret2_portable/3d/`.

**Vérifié dans le fichier** (contour de la carte relu dans le STEP) : partie droite montée de 6 mm (bord haut droit à y = 80,36, coin droit et marche déplacés, comme le tableau du guide, étape 5.0) ; carte de 77,3 × 46,6 mm ; H1 / H2 inchangés ; un troisième trou M2, **H3**, en (139,065 ; 83,175).

**Fait** : plan §0 (Contour) et §8 ; guide, étape 5.0 (coordonnées exactes du coin droit, 141,605 ; H3 ; calage sur H2 si la carte est ailleurs sur la feuille ; chemin du STEP).

### 23.10.2026 (4ᵉ entrée) — Deuxième carte : USB-C ressoudé, firmware `31830a7` flashé

**Contexte** : l'utilisateur a ressoudé le connecteur USB-C. La carte est de nouveau vue sur COM3 (premier poste), ce qui confirme la piste de la soudure (entrée du 22.10.2026).

**Fait** :
- synchronisation avec GitHub (`31830a7`) ;
- compilation `turret2_bringup` : RAM 28,1 %, flash 49,6 % ;
- `upload` puis `uploadfs` (LittleFS avec les 55 répliques) : SUCCESS, redémarrage automatique.

**Vérifié par la console** :
- version `31830a7-dirty` (seul ce fichier n'est pas commité) ;
- POWERON, 2 démarrages suspects d'affilée, **0 brownout, 0 défaut d'alimentation**, PWR_FLT haut ;
- `stats` : 18 démarrages au total ;
- SW1 fermé (mode debug) ;
- `voice` : 8 + 5 + 8 + 10 + 7 + 10 + 6 + 1 = **55 répliques trouvées**.

**Non vérifié** : écoute (haut-parleur débranché) ; essai du servo avec la console ouverte.

### 23.10.2026 (5ᵉ entrée) — SG90 sur Z : il cale sur les grands sauts avec l'USB du PC

**Essai** : SG90 sur J9 (ROTATE_Z), carte sur l'USB du PC (COM3), mode debug, console ouverte.

**Résultats** :
- sauts de 45° ou plus (975 / 1925 µs, puis 500 → 2400 µs) : le servo **clique sans tourner** ;
- balayage lent (`sweep servo rotz 4000`) : il tourne ;
- **pas de 20°** toutes les 0,8 s : **il suit** (observé par l'utilisateur) ;
- **aucun redémarrage** pendant tous ces essais : uptime continu, 0 brownout, PWR_FLT haut.

**Conclusion** :
- démarrage brutal ≈ 0,5–0,7 A, trop pour le port USB du PC (avec la carte et le Wi-Fi) : le 5 V s'effondre et l'électronique du SG90 décroche ;
- l'ESP32 tient grâce au TPS631000 (buck-boost) ;
- servo, carte et câblage OK.

**À confirmer** : grands sauts sur un chargeur 5 V ≥ 2 A, commande par la page web.

**Idée** : rampe de vitesse des servos en mode debug, pour limiter le courant de démarrage (à proposer).

### 23.10.2026 (6ᵉ entrée) — Rampe de vitesse des servos sur une alimentation faible

**Demande** : faire la rampe proposée après l'essai du SG90 (5ᵉ entrée).

**Fait** :
- `logic/ServoLogic.h` : `RampStep()` (pas maximal = vitesse × temps écoulé, au moins 1 µs, pas de dépassement) ;
- `motion/ServoChannel` :
  - mémorise la dernière impulsion envoyée (`sentUs`, gardée après un relâchement) ;
  - avec une rampe, `SetMicroseconds()` ne fait que fixer la cible, et `Update()` avance d'un pas toutes les 20 ms ;
  - `AttachNow()` repart de la dernière impulsion connue ;
  - chaque relâchement est journalisé (`Servo … released`) ;
- `motion/Gantry` : rampe appliquée aux **seuls servos à position** (rotations X / Z, canons), jamais aux ailes continues, dont l'arrêt sur le seuil Hall serait retardé. Active tant que `board.IsServoLimited()` (mode debug sans `power full`), donc rien ne change en mode normal ;
- réglage **`ServoRamp`** (groupe Power, µs/s, 1000 par défaut ≈ 95°/s, 0 = sans rampe), visible sur la page web ;
- test natif `test_servo_ramp` ; README (politique des servos, tableau des réglages).

**Vérifié** :
- compilation `turret2_bringup` : RAM 28,2 %, flash 49,6 % ;
- `check_web.py` : tout passe ;
- valeurs du test recalculées en Python (11 vérifications, course complète en 95 pas).

**Non vérifié** :
- tests natifs (pas de compilateur sur ce poste : CI) ;
- carte pas encore flashée, l'utilisateur testait par le web ;
- cause des rattachements de Z à chaque commande, vus le 23.10.2026 (« attaching » à chaque commande) : le nouveau journal des relâchements doit la montrer.

### 23.10.2026 (7ᵉ entrée) — Servos relâchés aussitôt attachés ; LED verte et USB perdus pendant l'essai du servo

**Journal des relâchements (nouveau)** : `servo rotz 2400` donne `Servo rotate Z released (idle, ServoIdleMs)` juste après l'attachement, alors que `ServoIdleMs` vaut 5000.

**Cause : bug du firmware, antérieur à la rampe.**
- `Gantry::Update()` lit `now` au début de la boucle ;
- `AttachNow()`, appelé ensuite, note `lastActivityAt = millis()`, un peu plus tard ;
- `now - lastActivityAt` en `ulong` boucle alors à ~49 jours, et le servo est relâché dans la même boucle.

Conséquences : « pas de 5° » à chaque commande (quelques impulsions seulement) et « (attaching) » à chaque commande. Même défaut sur `Gun::Update()` (maintien de 500 ms des canons) et dans la nouvelle rampe.

**Corrigé** : différences de temps signées (`(long)(now - t) >= (long)limite`) dans `Gantry::ReleaseIdleRotation`, `Gun::Update` et `ServoChannel::Update`. Chaque relâchement est journalisé avec sa cause : `idle, ServoIdleMs`, `gun hold time`, `one servo at a time`, `servo off command`, `wing stop`, `detach all`…

**Incident, comme le 22.10.2026** : pendant ces essais, la LED verte s'est éteinte et COM3 a disparu. À 17:58:14, Windows voit un appareil se reconnecter puis « échec de demande de descripteur ». **Un appui sur PROG a rallumé la LED verte**, ce qui donne une piste :
- le geste de remise à zéro repasse IO33 en GPIO simple (`pinMatrixOutDetach` + `digitalWrite`), puis la respiration la remet sur le sigma-delta ;
- le routage de la broche (registre `GPIO_FUNC33_OUT_SEL`) avait donc été perdu, alors que le firmware la croyait toujours modulée ;
- ni notre code ni ESP32Servo ne touchent à IO33 : piste d'une perturbation (bruit du moteur, câble épissé, alimentation par le connecteur USB-C ressoudé) qui affecterait aussi le bloc USB.

**Ajouté** : commande **`pins`**, qui lit les registres :
- de IO33 : routage, sortie, niveau, état du sigma-delta ;
- des broches USB 19 / 20 dans l'IO_MUX ;
- du bloc USB-Serial/JTAG : pad, pull-up D+, compteur de trames USB sur 20 ms.

À lancer par la page web avant et après l'incident, pour voir ce qui change.

**Vérifié** : compilation OK (RAM 28,2 %, flash 49,6 %), `check_web.py` OK.

**Non flashé** : la carte n'est plus joignable par USB, et l'utilisateur ressoude le connecteur USB-C.

### 23.10.2026 (8ᵉ entrée) — Carte fille des canons étudiée

**Demande** : « étudier la carte fille que j'ai oubliée ; je pense juste rajouter des condos ».

**Fait** :
- `Fork/gerber/DaughterBoard.zip` extrait dans le dossier temporaire, sans toucher à `Fork/` ;
- nets relevés dans les attributs X2 des Gerber, sérigraphie rendue en image (`docs/img/carte-fille-canon-v1.png`) ;
- `docs/carte-v2-plan.md` : nouveau **§13**, plus un point à valider au §11.

**Constats** :
- carte passive, 13,3 × 19,7 mm, **aucun condensateur** ;
- J1 = câble (5V · Srv · LED · Gnd, comme J3 / J4) ;
- J5 / J4 = les deux LEDs en chaîne ;
- **J2 (servo) = Gnd · Srv · 5V, signal au milieu**, alors qu'une prise de servo standard a le +5 V au milieu : à vérifier sur les canons.

**Proposé** :
- réservoir 100–220 µF + 100 nF au ras de J2, 100 nF par LED ;
- 330 Ω série sur les données (près de la 1ʳᵉ LED) et sur le PWM ;
- J2 au brochage standard en v2 ;
- en v2, CT de SW_SERVO à 10 nF si les réservoirs sont ajoutés ;
- immédiatement sur la v1 : condensateur soudé sur 5V / Gnd de J2.

### 23.10.2026 (9ᵉ entrée) — PCB de la v2 repartant de zéro (dossier `Desktop\TurretV2`, hors dépôt)

**Demande** : dans le nouveau projet KiCad `TurretV2` (copie du projet maître), tout supprimer du PCB sauf le placement de l'ESP32, refaire le contour avec `Turret2_contour_rehausse.dxf` (et le STEP), et mettre les 3 trous.

**Fait** (script dans le dossier temporaire, KiCad fermé) :
- **sauvegarde** de l'original : `TurretV2\Turret2-backups\Turret2.kicad_pcb.avant-nettoyage-2026-10-23` ;
- **retirés** : 87 empreintes, 941 pistes, 222 vias, 329 zones, 3 éléments générés, l'ancien contour (6 droites, 6 arcs), 2 cercles et 1 texte ;
- **gardés** : réglages de la carte (couches, règles, classes de nets, paramètres de tracé), polices intégrées, **U7 à (82,85 ; 96,8)**, H1 (67,342 ; 123,825) et H2 (139,065 ; 123,825) ;
- **H3** : `MountingHole_2.2mm_M2` « carte seulement », copie de H2 avec de nouveaux UUID, en **(139,065 ; 83,175)** ;
- **contour** : 6 droites et 6 arcs lus dans le DXF (Y inversé, arcs en début / milieu / fin), extrémités recollées : un seul écart, de 5 µm (138,600 contre 138,605 au coin haut droit) ;
- carte de 77,3 × 46,6 mm, bord haut droit à y = 80,36, comme le relevé du STEP du 23.10.2026 (3ᵉ entrée).

**Vérifié avec `kicad-cli`** :
- le fichier s'ouvre ;
- DRC : aucune erreur de contour ; 2 avertissements « sérigraphie coupée par le bord » (l'antenne du module dépasse, comme sur la v0.1) ; 31 connexions manquantes (pastilles de U7 sans pistes) ;
- rendu 3D conforme.

**À savoir** :
- le schéma n'a pas été touché : « Mettre à jour le PCB depuis le schéma » remettra toutes les empreintes à placer ;
- H1, H2, H3 sont « carte seulement » : vérifier qu'ils ne sont pas supprimés à la mise à jour ;
- plans de masse et zones d'alimentation à recréer sur le nouveau contour.

### 24.10.2026 — Servos tenus confirmés, plage du SG90, LED verte intermittente

**Firmware flashé** (`31830a7-dirty`, COM3) : correctif des servos relâchés aussitôt, rampe, raison des relâchements, commande `pins`. **Vérifié sur la carte** :
- Z est attaché une seule fois puis tenu entre les commandes (plus de « (attaching) » à chaque commande, aucun relâchement intempestif) ;
- relâché après `ServoIdleMs` (5 s) ;
- mouvement complet en douceur avec la rampe (1000 µs/s, mode debug).

**Plage du SG90 sur Z**, cherchée en partant du centre (1450 µs, vérifié visuellement par l'utilisateur) :
- côté bas, sans forcer jusqu'à **500 µs** ;
- côté haut, sans forcer jusqu'à **2200 µs** ; **force dès 2250 µs** (butée mécanique avant la limite de 2400 µs du firmware).

Le premier essai (1450 → 2400 µs) poussait donc contre la butée. Dans la tourelle, Z reste près du centre.

**LED verte** :
- très faible au rebranchement (mode respiration), puis éteinte en mode fixe, alors que `pins` montrait **IO33 en sortie GPIO, activée, niveau 1** ;
- l'utilisateur a ressoudé le module ;
- pendant que le servo forçait, la LED est revenue à fond, **registres inchangés**.

Conclusion : **contact intermittent sur le chemin de la LED** (soudure de IO33 du module, R18 ou D4), sensible aux vibrations et à la flexion. C'est cohérent avec l'appui sur PROG (proche de D4 / R18) qui la rallumait le 23.10.2026.

**État** :
- `GreenLedMode` est resté à 2 (fixe) pour les essais : à remettre à 0 (respiration) ;
- **mode réduit** vu au rebranchement : 7 démarrages de moins de 60 s pendant les soudures, effacé ensuite ;
- `pins` : USB sain (20 trames en 20 ms).

### 24.10.2026 (2ᵉ entrée) — Plan v2 : mesure du courant et de la tension

**Idée de l'utilisateur** : « une puce minuscule pour checker le courant, utile ? ».

**Réponse** : utile, et sans nouvelle puce. La broche **ILM** du TPS259533 donne déjà le courant de sortie (gain 276 µA/A ±8 %, à brancher sur un ADC d'après TI [DS]), soit 0,144 V/A avec R5 = 523 Ω.

**Fait** (`docs/carte-v2-plan.md`) :
- nouveau **§2.1** :
  - ILM → 10 kΩ → **IO4** (I_SENSE), 10 nF ;
  - **+5V** de sortie de l'eFuse (≤ 5,7 V, plutôt que VBUS) → pont 1 MΩ / 470 kΩ → **IO5** (V5_SENSE), 10 nF ; 3,4 µA en veille ;
  - précision, usages (alimentation faible détectée seule, servo bloqué, courbes web) ;
  - INA236 / INA226 écartées tant que l'ILM suffit ;
- mis à jour : §0, §3.1, §4.2, §5 (IO4, IO5), broches libres ramenées à 4, §10 (point 10), §11, §12.

**Non fait** : relancer `gpio_study` (IO4 / IO5 étaient des broches libres sans destination dans le modèle).

### 01.11.2026 — Carte v2 routée ; brochage final ; docs synchronisées

**Demande** : mettre les docs du dépôt en accord avec la carte v2 routée, puis les GPIO de ce fichier.

**Fait** :
- relevé du PCB routé (`Desktop\Turret2_v2_6c\`, 6 couches) : nets de U7, de l'extendeur, des connecteurs et des points de test (scripts pcbnew, `kicad-cli`) ;
- **brochage final** dans « État actuel » (tableau v0.1 → v2) ; nouveau lot **F2** (firmware pour la v2) ; ligne V2 de « Avancement » et nouvelle décision du 01.11.2026 ;
- `docs/carte-v2-etat.md` (nouveau) : état réel de la carte, règles, écarts avec le plan, carte fille v2 ; bandeaux de renvoi dans le plan, le guide KiCad, `AMELIORATIONS_V2.md`, `design-plan.md`, `status-and-history.md`, `firmware-plan.md` et le README.

**Corrige** les entrées du 21.10.2026 (10ᵉ entrée, brochage refait) et du 24.10.2026 (2ᵉ entrée, mesure sur IO4 / IO5) : ce brochage a encore changé au routage, et la mesure n'a pas été implantée.

**Non fait** : aucun changement de code ; le firmware reste celui de la v0.1.

### 02.11.2026 — Code des servos poussé

Le code décrit les 23.10.2026 (6ᵉ et 7ᵉ entrées) et flashé le 24.10.2026 n'avait jamais été commité : rampe `ServoRamp`, temps signés (servos relâchés aussitôt attachés), raison des relâchements dans le log, commande `pins`, `logic/ServoLogic.h` et `test_servo_ramp`.

**Vérifié** : compilation `turret2` OK (RAM 28,2 %, flash 46,0 %). **Non vérifié ici** : tests natifs (pas de gcc sur ce PC) : CI.

### 02.11.2026 (2ᵉ entrée) — OLED noir un cran sur deux avec l'encodeur

**Symptôme** (utilisateur, mode debug, OLED + encodeur I²C) : navigation et sélection possibles, mais « plein de glitchs » ; après deux descentes l'écran devient noir, il revient si l'on continue, et ainsi de suite.

**Cause : bug du firmware, même famille que les servos relâchés aussitôt (23.10.2026).** `loop()` lit `currentTime = millis()`, puis `encoder.Update()` (≈ 1 ms de bus) et `HandleEncoder()` → `DebugUi::Key()` → `Wake(millis())` : `lastActivity` est **plus tard** que `currentTime`. Ensuite `DebugUi::Update(currentTime)` → `UpdateSleep()` calculait `now - lastActivity` en **non signé** : la différence repliée (~49 jours) dépassait `OledSleepS` et l'écran se mettait en veille (`SetPower(false)`) juste après le cran. Le cran suivant ne faisait que le réveiller (« une touche sur un écran en veille ne fait que le réveiller ») : d'où un écran noir un cran sur deux et des crans avalés. Les boutons A / B y échappaient presque toujours : rien ne prend du temps entre la lecture de `currentTime` et leur traitement.

**Écarté en relisant le code** : partage du bus (`Wire` prend un verrou par transaction, U8g2 découpe en transactions de 24 octets et n'est appelé que par la tâche `oled`), rendu du menu (texte seul).

**Corrigé** : `DebugUi::UpdateSleep` compare en signé. Les autres horodatages par `millis()` du firmware ont été relus : ils sont relus après coup (`Actions::Update`) ou déjà comparés en signé.

**Vérifié** : compilation `turret2` OK (RAM 28,2 %, flash 46,0 %). **Non vérifié** : sur la carte (module pas sous la main).

### 02.11.2026 (3ᵉ entrée) — Veille v2 : tout réglable depuis la page web

**Demande** : prévoir dans les paramètres web de quoi configurer toute la veille de la carte v2.

**Ce que disent déjà les docs** (relevé de la même session) : *quoi couper* dans chaque mode est décidé ([carte-v2-plan.md](carte-v2-plan.md) §1, §1.1, ordre de coupure en fin de §2.1, Hall §4.3, §10 point 5) ; restent ouverts les délais, le passage veille radar → veille profonde, le Wi-Fi en veille radar et la ronde. Périmés pour la v2 : la séquence « Entrée en veille » d'[AMELIORATIONS_V2.md](AMELIORATIONS_V2.md) (radar sentinelle abandonné) et B9 (pensé pour la v0.1). Le §1 du plan donne encore l'IMU sur IO15 : c'est **IO14** sur la carte routée.

**Prévu pour F2.6** : un groupe de réglages **`Sleep`** dans la table de `Settings` (la page web l'affiche seule, listes déroulantes pour les choix), plus un bouton et l'état de veille sur la page. Liste proposée, à valider :

| Réglage | Rôle | Défaut proposé |
|---|---|---|
| `SleepMode` | jamais / veille radar seule / veille radar puis profonde | veille radar seule |
| `RadarSleepMin` | minutes sans cible avant la veille radar (0 = jamais) | 10 |
| `DeepSleepMin` | minutes de veille radar avant la veille profonde (0 = jamais) | 0 |
| `NightStart` / `NightEnd` | plage horaire de veille profonde (heure NTP ; sans heure valide : ignorée) | désactivée |
| `SleepWifi` | Wi-Fi en veille radar : inchangé / station seule / coupé | inchangé |
| `PatrolPeriodS` / `PatrolOnS` | ronde en veille profonde : réveil toutes les *T* s, radar allumé *t* s (0 = pas de ronde) | 0 / 3 |
| `WakeImu` / `WakeImuLevel` | réveil par l'IMU (INT1, IO14) et sa sensibilité | oui / moyenne |
| `HallPower` | capteurs Hall toujours alimentés / seulement quand une aile bouge | à la demande |

Plus : bouton « Veille maintenant » (radar / profonde) et ligne d'état (mode, temps avant la veille) ; commande console `sleep radar|deep|off`. **Garde-fous** : pas de veille profonde en mode debug (SW1) ; avertissement sur la page avant une veille profonde (page et console perdues jusqu'au réveil) ; réveil toujours possible par PROG.

**Non fait** : aucun code (F2.6 vient après F2.1–F2.4).

### 02.11.2026 (4ᵉ entrée) — Lot F2 : brochage v2, garde-fou de carte, pilote de l'extendeur (F2.1–F2.3)

**Demande** : « tu peux commencer » (le firmware pour la carte v2), avec les choix proposés : un seul code pour les deux cartes (un environnement par carte), garde-fou aussi dans le build v0.1 ; l'appui long sur PROG pour le Wi-Fi viendra avec F2.5.

**Fait** :
- **F2.1 brochage** : `src/pins.h` en deux blocs (`TURRET2_V2` ou v0.1), relu ligne à ligne contre [carte-v2-etat.md](carte-v2-etat.md) §4 ; `BOARD_NAME`, `BOARD_HAS_EXPANDER`, `BOARD_HAS_BUTTONS`, `PIN_ABSENT` (boutons A / B absents en v2 : `Button` ne fait rien), `PINS_UNUSED` (IO1–IO6 en entrée avec pull-down, plan v2 §7), ports de l'extendeur `EXPANDER_*`. Nouvelle variante `variants/turret2_v2` (LED_BUILTIN sur IO13 ; SPI par défaut sur IO3–IO6 au lieu de IO39–IO42, qui sont l'I²S et l'ampli en v2). Commandes `inputs` et `pins` (registres de la LED verte, n'importe quelle broche) indépendantes de la carte. Environnements `turret2_v2`, `turret2_v2_bringup`, `turret2_v2_ota`, `turret2_v2_ota_home` ; la CI compile aussi `turret2_v2`.
- **F2.2 garde-fou** (`board/BoardCheck`) : première chose de `setup()`, avant `Board::Begin()` ; `I2cBus::Start()` (récupération du bus + `Wire.begin(35, 36)`, **silencieux** : le log passe dans la mémoire RTC du démarrage précédent tant que `CrashLog::Begin` n'a pas tourné) ; extendeur vu = accusé à 0x20 **et** registres de configuration lisibles. Le build v2 l'exige, le build v0.1 le refuse. Mauvaise carte : aucune autre broche touchée, rails coupés si l'extendeur est là, console USB qui répète quoi flasher toutes les 5 s, commandes `rollback` (démarre l'autre partition OTA si elle contient une application : retour au firmware d'avant un OTA raté) et `scan`. Pas de Wi-Fi ni d'OTA dans ce cas. `I2cBus::Begin()` (étape 5) ne fait plus que rapporter la récupération et le scan.
- **F2.3 pilote** (`board/Expander`) : `Probe`, `AllOff` (niveaux de sortie d'abord, puis configuration en sorties, relu), `SetPort`, `ReadPort0`. « Tout coupé » au tout début du boot et dans `Actions::ShutdownForRestart()` (redémarrage, OTA). Commande console **`rails`** (lecture seule).
- Docs : README du firmware (environnements, garde-fou, étape 0 du boot, commandes, règles de la v2) ; plan v2 §2.1, §4.4, §4.5 et §10 point 9 (broches de l'ampli, de la TX du radar et d'INT1 périmées, corrigées d'après carte-v2-etat §4).

**Vérifié** : compilation `turret2` et `turret2_v2` OK (RAM 28,2 %, flash 46,1 % chacune), sans avertissement dans `src/` ; `turret2_v2` compile bien avec `variants/turret2_v2` et `TURRET2_V2` (`pio project metadata`) ; noms de carte dans les binaires (« Turret2 v0.1 » seulement dans `turret2`, « Turret2 v2 » seulement dans `turret2_v2`) ; `tools/check_web.py` : tout passe. **Non vérifié** : tests natifs (pas de compilateur hôte : CI) ; tout le comportement sur une carte v2 (pas encore fabriquée) ; sur la v0.1, que le garde-fou laisse bien démarrer (à vérifier au prochain flash : ligne « Board check: Turret2 v0.1, nothing at 0x20 »).

**À savoir pour la suite** :
- le build v2 laisse **tous les rails coupés** : servos, LEDs, radar et Hall ne sont pas alimentés (défauts radar et Hall attendus) jusqu'à F2.4 ;
- un OTA qui échoue après `ShutdownForRestart()` laisse les rails coupés jusqu'au redémarrage : F2.4 devra les rallumer si la tourelle continue ;
- les ports libres P04–P17 de l'extendeur restent des entrées flottantes : à tirer (registres de tirage du TCAL6416, à vérifier dans la datasheet) avant le bilan de la veille profonde (F2.6).

### 02.11.2026 (5ᵉ entrée) — Lot F2.4 : rails de la v2

**Demande** : continuer (sans commit intermédiaire).

**Fait** :
- **`board/Power`** : `On` (un rail à la fois, ≥ 10 ms après le précédent, attente de la montée : 15 ms servos, 5 ms LEDs, radar et Hall), `Off`, `AllOff` (servos, LEDs, radar, Hall, puis tout le port de l'extendeur réécrit « tout coupé »), `IsOn`, `Name`, `Parse`. Avant de couper le rail des servos, leurs lignes sont tenues à l'état bas. Sur la v0.1, tout est sans effet et `IsOn` vaut toujours vrai.
- **Ordre de boot** : rail LED avant `light.Initialize()` (étape 2), rail radar avant `radar.Initialize()` (étape 7 : la TX de l'UART ne monte qu'une fois le radar alimenté), rail Hall avant la lecture des ailes (étape 8), rail servos à la fin de l'étape 10, après la calibration RF, **sauf en mode réduit** (boucle de redémarrages : peut-être l'alimentation ; `rail servo on` pour passer outre).
- **Protections** : `Gantry` n'attache aucun servo tant que le rail des servos est coupé (les commandes attendent) ; `Light` n'envoie aucune trame tant que le rail LED est coupé ; `Radar::End()` (UART arrêtée, TX en entrée, analyseur remis à zéro) ; le défaut radar se compte depuis le dernier démarrage du radar, plus depuis le boot.
- **Défaut d'alimentation** (`FaultState`, v2) : rails servos et LEDs coupés ; à la sortie, LEDs puis servos rallumés (servos pas en mode réduit).
- **Avant un redémarrage ou un OTA** (`ShutdownForRestart`) : radar arrêté puis `Power::AllOff()`. Un OTA raté redémarre toujours (`Ota.cpp`) : rien à rallumer, la note de la 4ᵉ entrée est sans objet.
- Commande console **`rail <servo|led|radar|hall> on|off`** : arrête ce que le rail alimente avant de le couper (servos relâchés, LEDs désactivées, radar arrêté ; Hall refusé pendant un mouvement d'aile) et le relance après ; répond par l'état relu (`rails`).
- README du firmware (section *Power handling*, tableau du boot, commandes).

**Vérifié** : compilation `turret2` et `turret2_v2` OK (RAM 28,2 %, flash 46,2 %), sans avertissement dans `src/` ; `check_web.py` : tout passe. **Non vérifié** : tout sur une carte v2 (pas fabriquée) ; sur la v0.1, comportement inchangé attendu (appels sans effet), à confirmer au prochain flash.

**À mesurer sur la carte v2** (temps codés en dur, avec marge) : montée réelle des rails (oscilloscope sur TP2, TP11, TP12, TP13), démarrage des OH49E, délai avant la première trame du RD-03D après `RADAR_EN` (le défaut radar tombe 3 s après le démarrage du radar), chute du +3V3 et PWR_FLT à l'allumage du rail servos (plan v2 §11).

### 02.11.2026 (6ᵉ entrée) — Lot F2.5 : fonctions des boutons A / B

D'après le tableau §2.7 d'[AMELIORATIONS_V2.md](AMELIORATIONS_V2.md) ; sur les deux cartes (sans effet gênant sur la v0.1, qui garde ses boutons) :
- **PROG maintenu 3 s, SW1 ouvert** : Wi-Fi marche / arrêt (comme B maintenu). `Board` a un anti-rebond de plus sur PROG (`TakeProgEvent`, appui long seulement) ; SW1 fermé, PROG reste au geste de remise à zéro (SW1 + PROG 5 s), qui n'a pas changé.
- **Knob en mode normal, appui maintenu 0,6 s** : cycle de démo (comme A ; mêmes refus : seulement depuis `Idle`, tourelle debout). Rotation = volume et appui court = sourdine existaient déjà.
- Déjà en place : remise à zéro par SW1 + PROG (remplace A + B au démarrage), menus du mode debug au knob, boutons de la page web.

**Vérifié** : compilation `turret2` et `turret2_v2` OK (flash 46,2 %) ; `check_web.py` : tout passe ; README §7. **Non vérifié** sur une carte.

### 02.11.2026 (7ᵉ entrée) — Plus de boutons A / B : interface au vocabulaire du knob

**Remarque de l'utilisateur** : « attention, on n'a plus de boutons A et B ». L'interface parlait encore de A / B à plusieurs endroits.

**Fait** :
- **Menu** (`logic/MenuLogic.h`) : indications du bas de l'écran **au vocabulaire du knob par défaut** (« Tourner  Appui:ok »…) ; elles ne passent à A / B qu'après une touche A / B (boutons de la v0.1 s'ils sont montés, `key a` à la console). Test natif `test_menu_render_root` adapté (démarre sur les indications du knob, puis A / B après une touche A).
- **Page web** (Tests → *Debug screen*) : les quatre boutons sont ceux du knob (tourner à gauche / à droite, appui, appui maintenu) au lieu de A / A long / B / B long.
- **Assistant de calibration** (`ui/MenuTree.h`) : « puis appuie » au lieu de « puis B ».
- **Pages QR** (`ui/DebugUi.cpp`) : « Tour:page / Appui:fin ».
- Simulateur (`tools/mock_menu.py`, `tools/mock_server.py`) : touches du knob et mêmes indications que le firmware.
- README : mode debug décrit avec le knob ; les boutons A / B ne sont plus qu'une note pour la v0.1.

**Inchangé** : la commande `key a|al|b|bl` (touches internes du menu) et le code des boutons de la v0.1 (sans effet si rien n'est branché sur J12 / J13 : R19 / R20 tiennent les entrées hautes).

**Vérifié** : compilation `turret2` et `turret2_v2` OK ; `check_web.py` : tout passe. **Non vérifié** : tests natifs (CI).

### 02.11.2026 (8ᵉ entrée) — Lot F2.6 : veilles réglables depuis la page web

**Demande** : « je te fais confiance » (liste de réglages de la 3ᵉ entrée acceptée telle quelle) ; les boutons A / B restent sur les cartes v0.1.

**Fait** :
- **`logic/SleepLogic.h`** (pur, testé) : `SleepMode`, `SleepWifi`, `SleepLevel` ; `InNightWindow` (fenêtre qui peut passer minuit, sans heure = pas de nuit), `SecondsUntilHour`, `WantedSleepLevel` (toujours éveillé → veille radar → veille profonde, une marche à la fois ; profonde après `DeepSleepMin` ou tout de suite la nuit, seulement si permise), `ImuWakeThreshold`. Tests natifs `test_sleep_night_window`, `test_sleep_levels`.
- **Réglages, groupe `Sleep`** (affichés seuls sur la page) : `SleepMode` (1 : veille radar seule), `RadarSleepMin` (10), `DeepSleepMin` (0 = la nuit seulement), `NightSleep` (non), `NightStart` / `NightEnd` (23 / 7), `SleepWifi` (inchangé), `PatrolPeriodS` (0) / `PatrolOnS` (3), `WakeImu` (oui) / `WakeImuLevel` (moyen), `HallPower` (1 : pendant un mouvement d'aile).
- **`control/Sleep`** :
  - veille radar (les deux cartes) : depuis `Idle` en mode normal après `RadarSleepMin` sans cible dans la zone ; ampli coupé (SD bas, horloges I²S laissées), servos relâchés, LEDs éteintes, Hall coupés, Wi-Fi selon `SleepWifi` ; v2 : rails servos et LEDs coupés. Réveil : cible dans la zone, knob, PROG, bouton, changement d'état (cycle lancé depuis la page), `sleep off`. Pendant un défaut d'alimentation, le réveil ne rallume rien (FaultState s'en charge) ;
  - veille profonde (v2, SW1 ouvert) : après `DeepSleepMin` de veille radar ou la nuit ; `ShutdownForRestart()` (ampli puis I²S, rails), Wi-Fi coupé, LEDs d'état éteintes, IMU armée (`Motion::ArmWakeup` : accéléromètre seul à 26 Hz en basse consommation, ±2 g, gyroscope arrêté, interruption de réveil verrouillée sur INT1 / IO14), réveils EXT1 (IO14 haut), EXT0 (PROG, IO0 bas), minuterie (ronde ou fin de nuit, la plus proche) ;
  - **ronde** : réveil par la minuterie avec `rtcPatrol` (mémoire RTC) → démarrage « discret » (`Sleep::BeginBoot`, `IsQuietBoot`) : rails LEDs, Hall et servos laissés coupés, `BootState` sans attache ni homing, veille radar d'emblée ; cible → réveil complet ; personne pendant `PatrolOnS` → retour en veille profonde. Fin de nuit (heure enregistrée en RTC) = démarrage normal ;
  - commande **`sleep [radar|deep|off]`** (sans argument : état en JSON) ; `/api/status` contient `sleep` (niveau, mode, temps d'inactivité, secondes avant la prochaine marche, profonde permise, nuit, ronde) et `hall.powered`.
- **Hall à la demande** (`Gantry::SetHallPower` : `Always`, `WhileMoving`, `Off`) : `Wing` allume le rail avant un mouvement ou un homing ; coupé 2 s après l'arrêt des ailes ; toujours allumé en mode debug ; coupé en veille ; le défaut « capteur à un rail » n'est plus compté rail coupé ; `hall`, `cal hall` et l'auto-test allument le rail avant de lire.
- **Page web** : carte *Sleep* dans l'onglet d'état (niveau, compte à rebours, nuit ; boutons « Radar sleep now », « Deep sleep now » avec confirmation, « Wake up ») ; Hall « off » dans l'état. Simulateur : commande `sleep` et champ `sleep` (carte v0.1 simulée : profonde refusée).
- README : section *Sleep*, tableau des réglages, commande.

**Pièges évités** : le temps d'inactivité est calculé en signé et borné à 0 (`NoteActivity()` horodate avec `millis()`, plus tard que le `now` de la boucle : même bug que l'OLED) ; un démarrage de ronde passe par `Booting` avant `Idle` : ce n'est pas un « changement d'état » qui réveille ; nom de l'objet global `sleepControl` (pas `sleep`, fonction POSIX).

**Vérifié** : compilation `turret2` (RAM 29,2 %, flash 46,4 %) et `turret2_v2` (RAM 29,3 %, flash 46,7 %), sans avertissement dans `src/` ; `check_web.py` : tout passe. La RAM gagne 3,4 Ko : chaque réglage occupe ~280 octets (valeur, défaut, min, max au format d'une chaîne de 64 octets). **Non vérifié** : tests natifs (CI) ; tout le comportement sur une carte.

**À vérifier sur la carte v2** :
- registres de l'IMU écrits à la main (`TAP_CFG0` 0x56 bit LIR, `CTRL6_C` 0x15 bit XL_HM_MODE) : relus dans la carte des registres du LSM6DSOX de mémoire, la datasheet ST n'a pas pu être relue sur ce poste ; la bibliothèque Adafruit écrit `TAP_CFG` (0x58) bits 4 et 7, ce qui sur le LSM6DSOX correspond à `INTERRUPTS_ENABLE` (bit 7) et à un bit de seuil de tap (bit 4, sans effet ici) ;
- réveil par PROG : que la ROM ne repasse pas en mode téléchargement si PROG est encore tenu (les broches de strap ne sont en principe pas relues au réveil d'un deep sleep) ;
- courant réel en veille radar et en veille profonde (plan v2 §1.1, PPK2) ; les ports libres P04–P17 de l'extendeur restent des entrées flottantes ;
- l'heure après une veille profonde (horloge RTC conservée, dérive), donc la fin de nuit.

### 02.11.2026 (9ᵉ entrée) — Bouton déporté J20 sur IO2

**Question de l'utilisateur** : faut-il un changement matériel pour PROG (réveil, mode téléchargement) ? Il peut encore modifier la carte.

**Réponse** : rien à changer pour PROG lui-même. Les straps (dont IO0) ne sont relus qu'aux resets matériels (mise sous tension, watchdog RTC, brownout…), pas à la sortie d'une veille profonde (d'après la datasheet de l'ESP32-S3, de mémoire : à confirmer sur la carte) ; IO0 est une broche RTC tirée par R21. Le vrai point : **SW2 est-il accessible tourelle fermée ?** Proposé et accepté : un **bouton déporté sur IO2**.

**Décidé** : bouton **actif à l'état haut** (vers +3V3), parce que les réveils de veille profonde par niveau sont EXT0 (une broche : PROG, actif bas) et EXT1 (un groupe, un seul mode : « l'une est haute », celui de l'IMU). Schéma : J20 2 broches, R50 1 kΩ (+3V3 → J20.1), R51 1 kΩ (J20.2 → IO2), R49 100 kΩ IO2 → GND, C46 10 nF facultatif ([carte-v2-etat.md](carte-v2-etat.md) §11). **À faire par l'utilisateur dans KiCad** avant la commande.

**Firmware** : `PIN_BUTTON_EXT` (IO2 en v2, absent en v0.1), retiré de `PINS_UNUSED` ; `Board` : anti-rebond actif haut (`INPUT_PULLDOWN` en plus de R49), maintenu 3 s = Wi-Fi comme PROG, tout appui de PROG (SW1 ouvert) ou du bouton = activité (`TakeUserPress`, réveille la veille radar) ; veille profonde : EXT1 sur IO2 + IO14 (IMU si `WakeImu`), cause du réveil lue (`esp_sleep_get_ext1_wakeup_status`) ; commande `inputs`. Compilation `turret2` et `turret2_v2` OK, sans avertissement.

### 04.11.2026 — Anneau NeoPixel tout blanc : FastLED 3.10.5 sans RMT sous ESP-IDF 4.4

**Demande** : carte v0.1 branchée, y mettre le dernier firmware (`4c0c45d`, flashé en USB) ; puis « peux-tu faire un test » : les 9 LEDs de l'anneau sont blanches en permanence.

**Enquête** :
- câblage v1 relevé dans `Turret2.kicad_pcb` : IO14 (U7 pad 18) → IC2 pad 2 (1A) ; IC2 pad 3 (1Y) → J14 pad 2 en direct ; 1OE à la masse ; IC2 en +5 V. Conforme ;
- `led ring FF0000 / 00FF00 / 0000FF / 000000` : aucun changement visible ;
- nouvelle commande **`pins <n>`** : routage de la broche (matrice GPIO, IO_MUX) et échantillonnage du plot **depuis le cœur 0 pendant l'envoi** d'une trame (horodatage au compteur de cycles, durée des impulsions, 48 premiers bits décodés). Résultat : IO14 bien pilotée (pas flottante), 216 bits émis, mais « 0 » de 0,94 µs et bit de 2,6 µs : tous lus comme des « 1 » = blanc ;
- cause : FastLED 3.10.5 (`platforms/esp/32/feature_flags/enabled.h`) prend `FASTLED_ESP32_HAS_RMT = SOC_RMT_SUPPORTED`, défini à 0 par défaut si absent ; l'ESP-IDF 4.4 du cœur Arduino 2.0.17 (`framework-arduinoespressif32` 4.20017) ne le définit pas → pas de pilote RMT, repli sur un envoi logiciel mal calé. Aucun pilote enregistré dans son gestionnaire de canaux ;
- essai `-DFASTLED_ESP32_HAS_RMT=1` (+ `ESP32_ARDUINO_NO_RGB_BUILTIN=1` exigé ensuite) : le pilote RMT4 de la 3.10.5 ne compile pas (`ChannelEngineRMT4Impl` abstraite). Abandonné.

**Correction** : `fastled/FastLED@3.9.20` (dernière 3.9, avant la refonte des pilotes). Mesuré avec `pins 14` : « 0 » 0,29–0,35 µs, « 1 » 0,65–1,0 µs, bit ~1,1 µs ; noir = que des « 0 », blanc = que des « 1 ». **Anneau rouge vu par l'utilisateur.** Compilation `turret2` : RAM 27,3 %, flash 35,5 % (46,4 % avant) ; `turret2_v2` : RAM 27,3 %, flash 35,8 %.

**Conséquence** : l'anneau (et les LEDs des canons) n'a sans doute jamais fonctionné avec ce firmware depuis le figeage des versions du 25.09.2026. L'inversion rouge / vert de la 9ᵉ LED vient du firmware d'origine (`Fork/src/light/Light.cpp`) ; à confirmer à l'œil maintenant que les couleurs passent.

**Défaut 4 (radar)** au démarrage de cette carte : déjà vu le 21.10.2026, sans lien.

**Puis** (demande de l'utilisateur) : **arc-en-ciel qui tourne**, mode de test LED : `led rainbow` (tout) ou `led ring|left|right|all rainbow` ; `Light::SetRainbow` : `fill_rainbow` sur les 9 LEDs de l'anneau (un tour de roue chromatique), teinte + 1 toutes les 8 ms (un tour en ~2 s), canons à la couleur de la LED 1 ; `led off` pour sortir. Bouton « rainbow » sur la page web (outils LED). Compilé, `check_web.py` OK, flashé sur la v0.1 et lancé.

**Puis** (« lance-le pour qu'il tourne indéfiniment au démarrage ») : réglage **`LedEffect`** (groupe Lights, ajouté en fin de table : 0 « Red eye », défaut, comportement Portal ; 1 « Turning rainbow ») ; `Light::Effect`, lu dans `ApplySettings` (démarrage et chaque changement) ; hors test, l'arc-en-ciel remplace l'anneau rouge et le feu des canons ; un test (`led …`) passe toujours devant, un défaut éteint toujours les LEDs. Compilé (`turret2` et `turret2_v2`), `check_web.py` OK ; flashé sur la v0.1, `set LedEffect 1`, relu après redémarrage : 1.

### 10.11.2026 — Revue complète du code, notation par fonctionnalité

Demande de l'utilisateur : relire tout le firmware, noter chaque fonctionnalité sur 5 étoiles dans un journal, et repenser ce qui est sous 4. Résultat dans **[firmware-code-review.md](firmware-code-review.md)** (versionné) : 27 fonctionnalités, 7 à cinq étoiles, 16 à quatre, **4 à repenser** (★★★) avec une proposition chacune :

1. **Machine à états** : `ManualState` vide avec du code commenté, durée de tir 3000 ms en dur et `millis() <` non protégé dans `FIringState.cpp` (faute de casse du nom), journal d'état en double, et surtout la tourelle **ne vise jamais** (`SetRotationX/Z` seulement à 0) ni ne cherche (`07_search` inutilisée). Proposition : logique de cycle pure et testée (`logic/CycleLogic.h`), état Searching, visée en Firing, `FireMs` / `SearchMs` réglables.
2. **Analyseur radar** : deux automates sur chaque octet, fin de trame reconnue sur `55 CC` sans contrôle de longueur, `uint8_t writeIndex` sur 256 octets. Proposition : automate à longueur fixe dans `logic/RadarLogic.h`, compteur de trames rejetées, tests natifs ; occasion d'élucider le défaut 4 de la carte v0.1.
3. **Console** : `Actions.cpp` 1345 lignes, `Execute()` en chaîne de `if`, aide et README tenus à la main, trois listes de noms de servos. Proposition : table de commandes (nom, usage, méthode, condition) qui génère `Help()` et le README, fichier découpé par domaine.
4. **Page web** : source déjà compacté, `throw 0`, listes dupliquées avec le firmware, pas de traduction. Proposition : source lisible compacté par `embed_page.py`, libellés servis par l'API.

Rien modifié dans le code. Le document de revue tient un tableau à mettre à jour à chaque nouvelle revue (entrée datée, jamais réécrite).

### 10.11.2026 (2ᵉ entrée) — Les quatre points de la revue repris

« Fais au mieux pour remettre bien » : les quatre fonctionnalités à ★★★ de [firmware-code-review.md](firmware-code-review.md) sont reprises (détail et nouvelles notes dans sa 2ᵉ entrée, toutes à ★★★★) :

- **Cycle de tir** : `logic/CycleLogic.h` (pur, testé), état **Searching** (voix `07_search`, cible revenue → nouvelle rafale, `SearchMs` sans cible → repli), réglages `FireMs`, `SearchMs`, **`AimZ`** (visée par la rotation Z en tir, balayage en recherche ; **faux par défaut, sens à vérifier sur la tourelle** : B1 et B3 du catalogue). `FIringState.cpp` → `FiringState.cpp`, `ManualState.cpp` supprimé, cycles comptés à l'activation.
- **Radar** : `logic::RadarParser` à longueur fixe, trames fausses comptées, 3 tests natifs ; `radar.bytes` / `frames` / `badFrames` dans `status` et sur la page, pour le défaut 4.
- **Console** : table de commandes (`Actions::COMMANDS`), `help` généré, `Actions.cpp` découpé en trois, une seule liste d'alias de servos (`Gantry::ChannelAlias`), `scripts/check_commands.py` en CI (README ↔ table).
- **Page web** : source lisible, compacté par `embed_page.py` (9,8 Ko gzip), barre de message au lieu des `alert()`, listes servies par **`GET /api/meta`**, `check_web.py` étendu (méta, script compacté).

Compilé `turret2` et `turret2_v2`, `check_web.py` et `check_commands.py` OK ; tests natifs en CI seulement. **Carte non branchée : rien essayé sur le matériel.** À faire à la prochaine session avec la carte : `help`, `status` (compteurs radar), un cycle `demo` avec `power full`, puis `set AimZ true` pour vérifier le sens de la rotation Z.

### 12.11.2026 — Relecture, puis les sept idées

- **Relecture** de la reprise du 10.11 ([firmware-code-review.md](firmware-code-review.md), entrée du 12.11) : la voix `search` n'aurait jamais été jouée (refusée pendant la queue du bruit de tir) et `Disengage` aurait parlé par-dessus le tir avec `SearchMs = 0` ; `Searching` attend la fin du tir. Le balayage de recherche part de la dernière visée au lieu de 0°.
- **Sept idées faites** (2ᵉ entrée du 12.11) : commande **`aim`** (vérifier le sens de la rotation Z sans rien bouger, `aim.deg` dans `/api/status`) ; **`help [catégorie]`** avec sélecteur sur la page ; **`MaxSpeedCms`** (B10, premier pas : cibles trop rapides ignorées, vitesse sur la page radar OLED) et zone de détection déplacée dans `Radar` ; **œil vivant** `LedEffect` = 2 (B6 : respiration, fixe, clignotant, blanc froid selon l'état) ; **page bilingue** (`web/PageText.h`, `/api/meta` → `text`, suit `Language`) ; **`.clang-format`** + `scripts/check_format.py` en CI, tout `src/` et `test/` reformaté ; **`control/CommandTable.h`** en données pures avec test natif.
- Compilé `turret2` (35,9 %) et `turret2_v2` (36,2 %) ; `check_web.py`, `check_commands.py`, `check_format.py` OK ; 4 tests natifs de plus (CI). **Toujours rien sur la carte.** Lot I3 : B1 et B3 écrits, B10 entamé, B6 fait.
