lo26lo/portal-turret-v4/Turret2_portable/3d/Turret2_rehausse.step

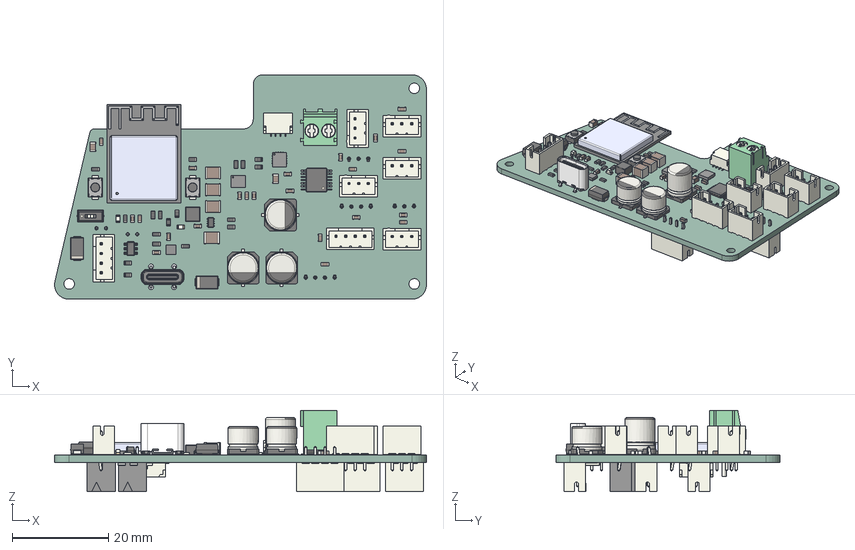
[picture p10: CAD file, 2026-10-23]
Turret2_portable/3d/Turret2_rehausse.step
77.3 x 46.6 x 16.9 mm
C_0603_1608Metric x 22
R_0603_1608Metric x 18
TSSOP-14_4.4x5mm_P0.65mm
D_SMA x 2
LED_0603_1608Metric x 2
C_1210_3225Metric x 4
CP_Elec_63x59 x 2
ESP32-S3-MINI-1-N8
BODY-SOT
JST_B3B_PH_K x 7
JST_SH_SM04B-SRSS-TB_1x04-1MP_P1.00mm_Horizontal
C_0805_2012Metric x 2
TerminalBlock_Phoenix_PT-1,5-2-3.5-H_1x02_P3.50mm_Horizontal
SOT-23-6
L_Changjiang_FTC303020D
BODY-SON
PIN1-ID
JST_B4B_PH_K x 4
SW_SPST_TS-1088-xR020 x 2
LSM6DSOXTR
CP_Elec_63x77
USB4120-03-C
ThermalPin
PinsArrayLR
PinsArrayTB
SW_DIP_SPSTx01_Slide_Copal_CHS_01A_W508mm_P127mm_JPin
R_1206_3216Metric x 2
LeadsArray x 2
JST_SH_SM05B-SRSS-TB_1x05-1MP_P1.00mm_Horizontal
Turret2_PCB
