lo26lo/portal-turret-v4/Turret2_portable/Turret2.kicad_sch

## KiCad design Turret2_portable/Turret2.kicad_sch (2026-10-22)

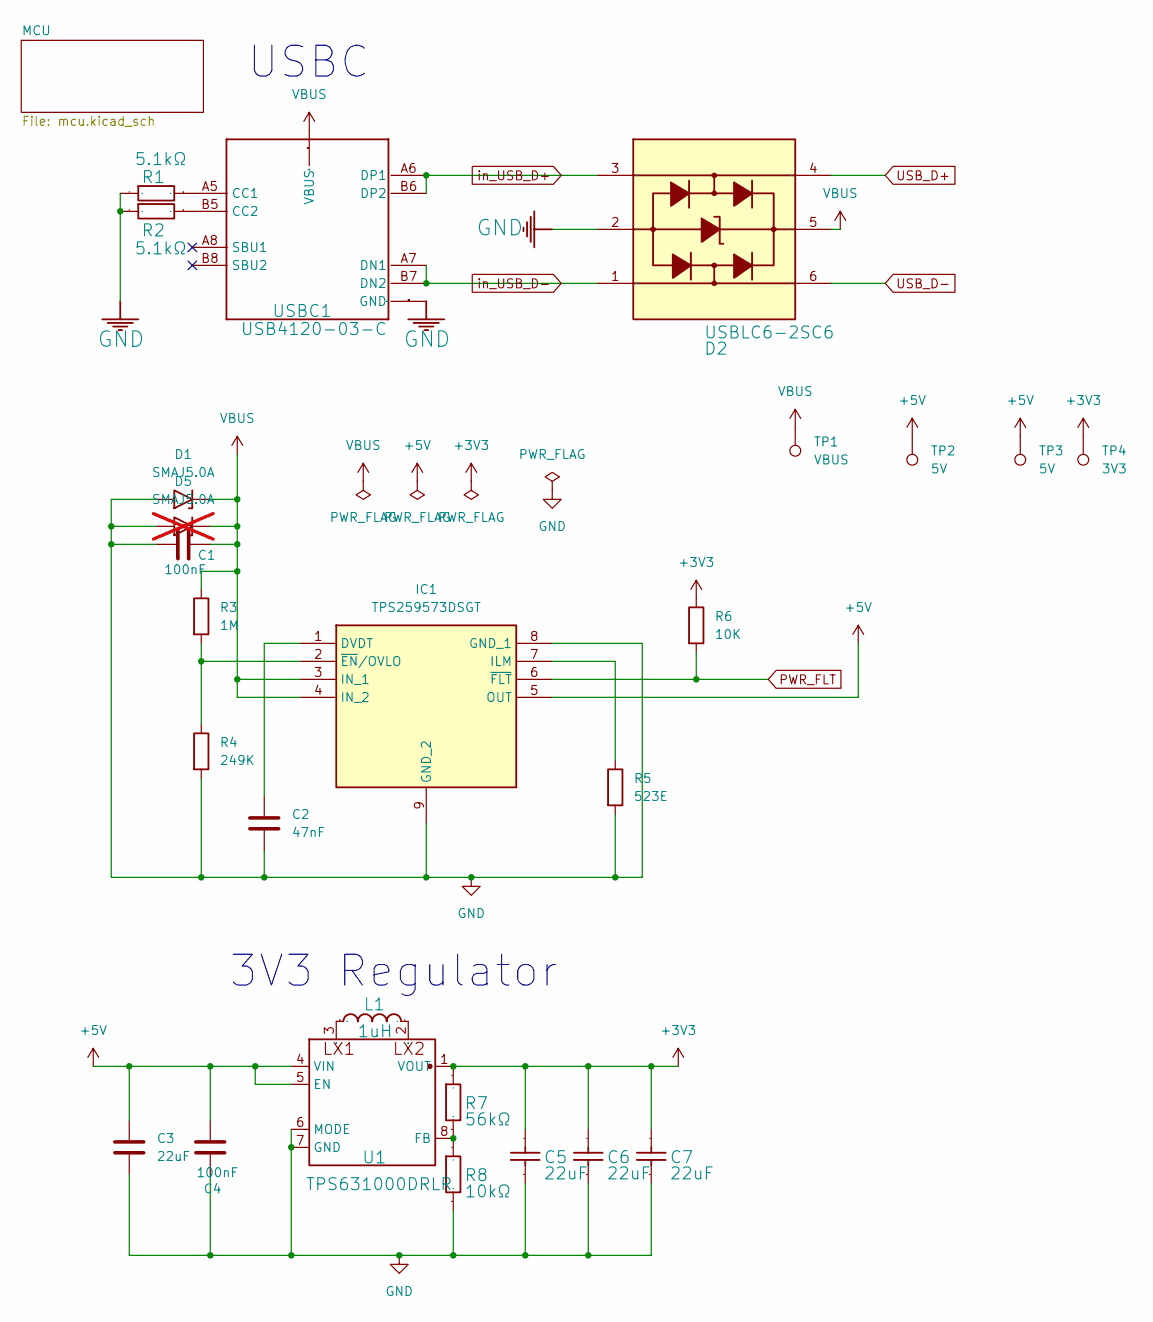
[picture p11: schematic Turret2.kicad_sch]

Parts:
C1, C4: 100nF; C_0603_1608Metric
C2: 47nF; C_0603_1608Metric
C3: 22uF; C_1210_3225Metric
C5, C6, C7: 22uF; C_1210_3225Metric; Manufacturer Part MCAST32MSB7226KPNA01
D1: SMAJ5.0A; D_SMA
D2: USBLC6-2SC6; SOT-23-6; Manufacturer Part USBLC6-2SC6
D5: SMAJ5.0A; D_SMA; not fitted
IC1: TPS259573DSGT; Texas_DSG0008A_WSON-8-1EP_2x2mm_P0.5mm_EP0.9x1.6mm_ThermalV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; Mouser Part Number 595-TPS259573DSGT
L1: 1uH; L_Changjiang_FTC303020D; Manufacturer Part FTC303020D1R0MBCA
R1, R2: 5.1kΩ; R_0603_1608Metric; Manufacturer Part 0402WGF5101TCE
R3: 1M; R_0603_1608Metric
R4: 249K; R_0603_1608Metric
R5: 523E; R_0603_1608Metric
R6: 10K; R_0603_1608Metric
R7: 56kΩ; R_0603_1608Metric; Manufacturer Part 0603WAF5602T5E
R8: 10kΩ; R_0603_1608Metric; Manufacturer Part 0402WGF1002TCE
TP1: VBUS; TestPoint_Pad_D1.0mm
TP2, TP3: 5V; TestPoint_Pad_D1.0mm
TP4: 3V3; TestPoint_Pad_D1.0mm
U1: TPS631000DRLR; SOTFL50P160X60-8N; Manufacturer Part TPS631000DRLR
USBC1: USB4120-03-C; USB412003C; Manufacturer Part USB4120-03-C

Connections:
+3V3: C5.2, C6.2, C7.2, R6.1, R7.2, TP4.1, U1.1 (VOUT)
+5V: C3.1, C4.1, IC1.5 (OUT), TP2.1, TP3.1, U1.4 (VIN), U1.5 (EN)
GND: C1.1, C2.2, C3.2, C4.2, C5.1, C6.1, C7.1, D1.2 (A2), D2.2, D5.2 (A2), IC1.8 (GND_1), IC1.9 (GND_2), R1.2, R2.2, R4.2, R5.2, R8.1, U1.6 (MODE), U1.7 (GND), USBC1.A1 (GND), USBC1.A12 (GND), USBC1.B1 (GND), USBC1.B12 (GND), USBC1.MH1 (GND), USBC1.MH2 (GND), USBC1.MH3 (GND), USBC1.MH4 (GND)
unnamed: C2.1, IC1.1 (DVDT)
unnamed: IC1.2 (~EN/OVLO), R3.2, R4.1
unnamed: IC1.7 (ILM), R5.1
unnamed: L1.1, U1.3 (LX1)
unnamed: L1.2, U1.2 (LX2)
unnamed: R1.1, USBC1.A5 (CC1)
unnamed: R2.1, USBC1.B5 (CC2)
unnamed: R7.1, R8.2, U1.8 (FB)
PWR_FLT: IC1.6 (~FLT), R6.2
USB_D+: D2.4
USB_D-: D2.6
VBUS: C1.2, D1.1 (A1), D2.5, D5.1 (A1), IC1.3 (IN_1), IC1.4 (IN_2), R3.1, TP1.1, USBC1.A4 (VBUS), USBC1.A9 (VBUS), USBC1.B4 (VBUS), USBC1.B9 (VBUS)
in_USB_D+: D2.3, USBC1.A6 (DP1), USBC1.B6 (DP2)
in_USB_D-: D2.1, USBC1.A7 (DN1), USBC1.B7 (DN2)

Notes on the sheet:
3V3 Regulator
USBC
