lo26lo/portal-turret-v4/Turret2_portable/mcu.kicad_sch

## KiCad design Turret2_portable/mcu.kicad_sch (2026-10-22)

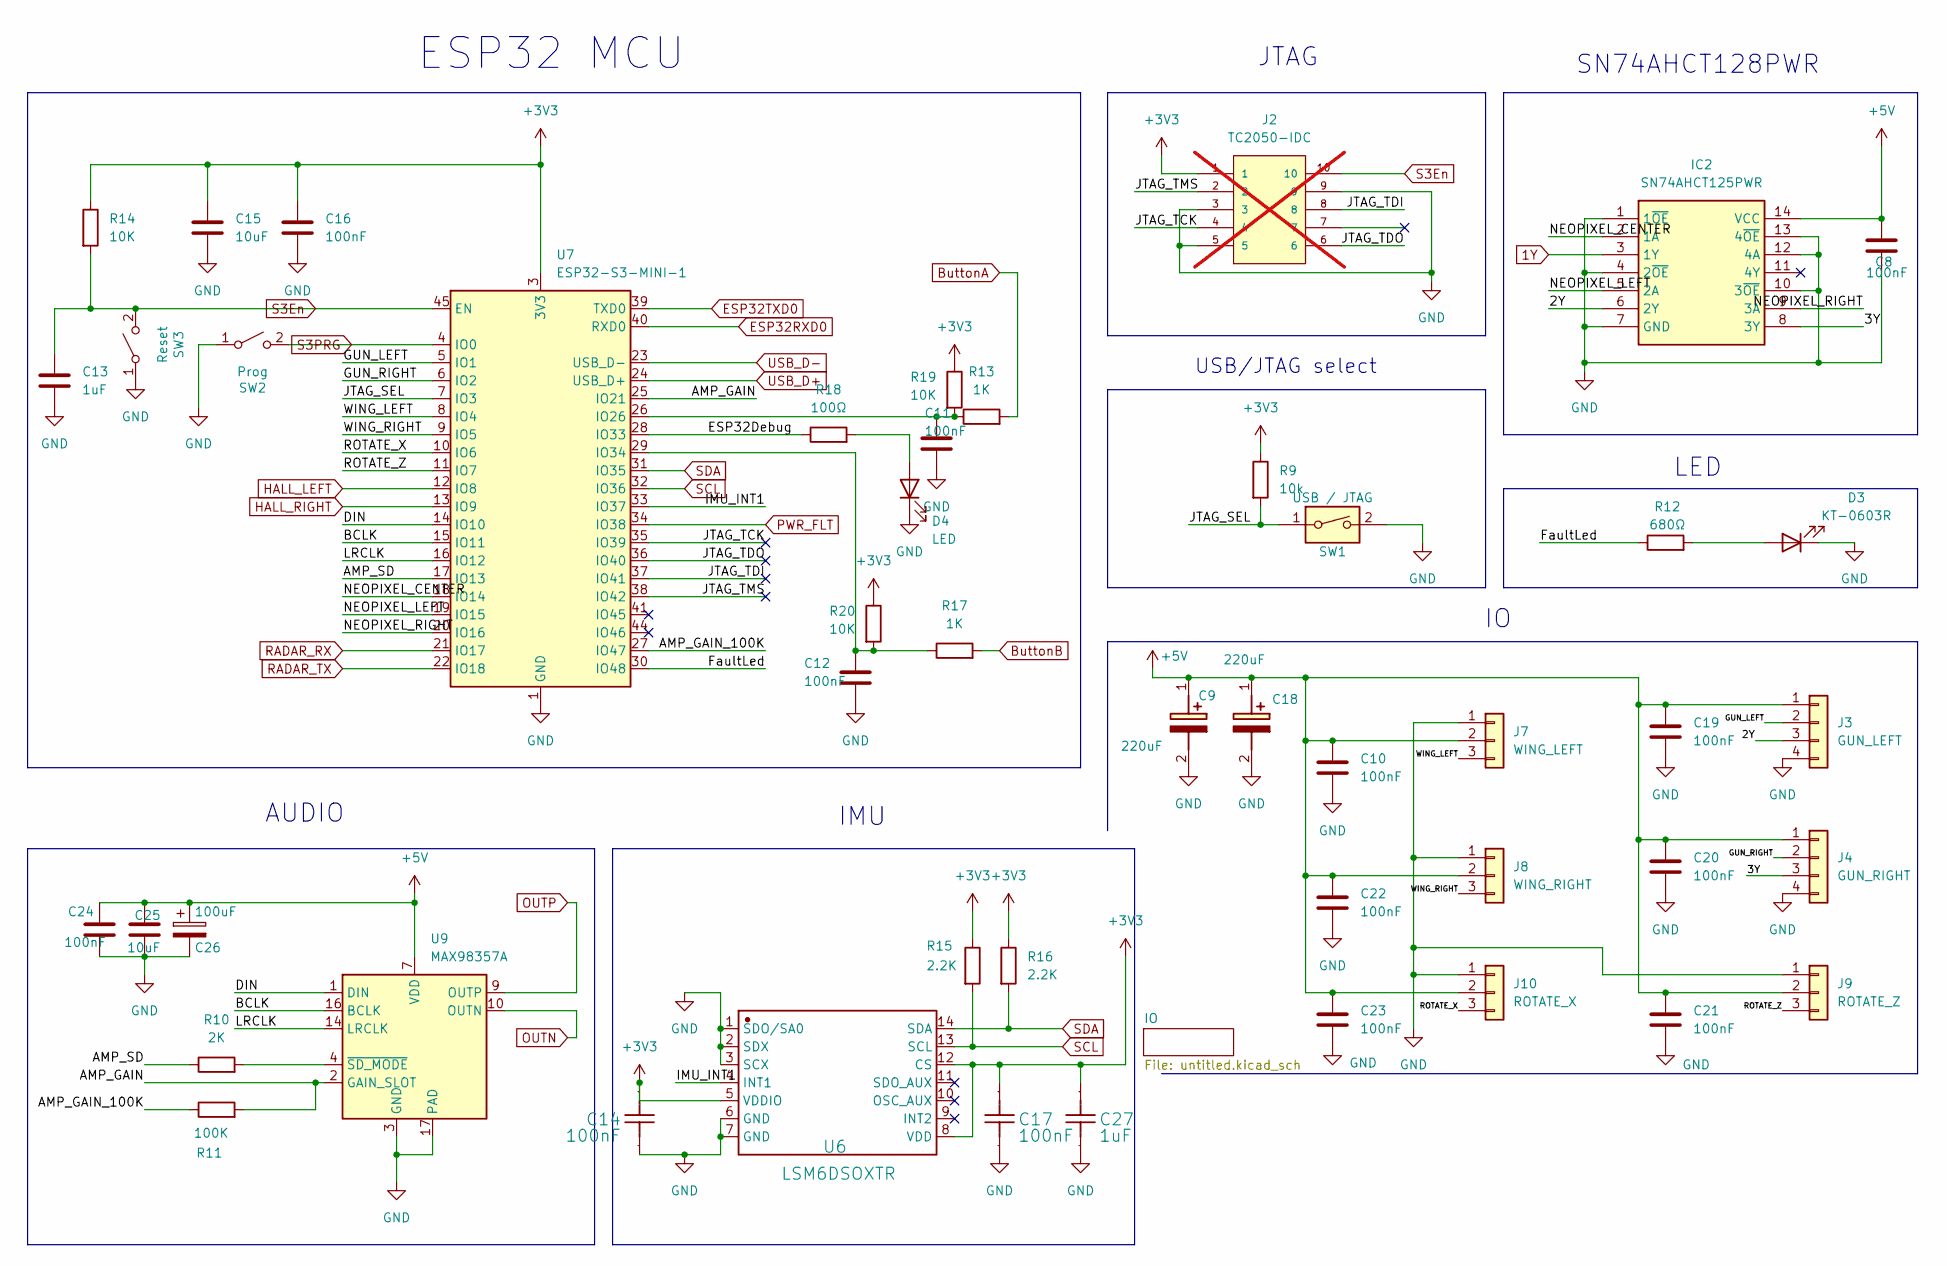
[picture p12: schematic mcu.kicad_sch]

Parts:
C8, C10, C11, C12, C16, C19, C20, C21, C22, C23, C24: 100nF; C_0603_1608Metric
C9, C18: 220uF; CP_Elec_6.3x5.9; Mouser Part Number 16SVPG220M
C13: 1uF; C_0603_1608Metric
C14, C17: 100nF; C_0603_1608Metric; Manufacturer Part CL05B104KO5NNNC
C15, C25: 10uF; C_0805_2012Metric
C26: 100uF; CP_Elec_6.3x7.7
C27: 1uF; C_0603_1608Metric; Manufacturer Part CL05B104KO5NNNC
D3: KT-0603R; LED_0603_1608Metric
D4: LED; LED_0603_1608Metric
IC2: SN74AHCT125PWR; TSSOP-14_4.4x5mm_P0.65mm; Mouser Part Number 595-SN74AHCT125PWR
J2: TC2050-IDC; TAG-CONNECT_TC2050-IDC; PARTREV A; not fitted
J3: GUN_LEFT; JST_PH_B4B-PH-K_1x04_P2.00mm_Vertical
J4: GUN_RIGHT; JST_PH_B4B-PH-K_1x04_P2.00mm_Vertical
J7: WING_LEFT; JST_PH_B3B-PH-K_1x03_P2.00mm_Vertical
J8: WING_RIGHT; JST_PH_B3B-PH-K_1x03_P2.00mm_Vertical
J9: ROTATE_Z; JST_PH_B3B-PH-K_1x03_P2.00mm_Vertical
J10: ROTATE_X; JST_PH_B3B-PH-K_1x03_P2.00mm_Vertical
R9: 10k; R_0603_1608Metric
R10: 2K; R_0603_1608Metric
R11: 100K; R_0603_1608Metric
R12: 680Ω; R_0603_1608Metric
R13, R17: 1K; R_1206_3216Metric_Pad1.30x1.75mm_HandSolder
R14, R19, R20: 10K; R_0603_1608Metric
R15, R16: 2.2K; R_0603_1608Metric
R18: 100Ω; R_0603_1608Metric
SW1: USB / JTAG; SW_DIP_SPSTx01_Slide_Copal_CHS-01A_W5.08mm_P1.27mm_JPin
SW2: Prog; SW_SPST_TS-1088-xR020
SW3: Reset; SW_SPST_TS-1088-xR020
U6: LSM6DSOXTR; LGA-14_1; Manufacturer Part LSM6DSOXTR
U7: ESP32-S3-MINI-1; ESP32-S2-MINI-1
U9: MAX98357A; 21-0136I_T1633-4_MXM

Connections:
1Y: IC2.3 (1Y)
2Y: IC2.6 (2Y), J3.3
3Y: IC2.8 (3Y), J4.3
+3V3: C14.1, C15.1, C16.1, C17.1, C27.1, J2.1, R9.1, R14.1, R15.1, R16.1, R19.1, R20.1, U6.5 (VDDIO), U6.8 (VDD), U6.12 (CS), U7.3 (3V3)
+5V: C8.1, C9.1 (+), C10.1, C18.1 (+), C19.1, C20.1, C21.1, C22.1, C23.1, C24.1, C25.1, C26.1, IC2.14 (VCC), J3.1, J4.1, J7.2, J8.2, J9.2, J10.2, U9.7 (VDD), U9.8 (VDD)
AMP_GAIN: R11.2, U7.25 (IO21), U9.2 (GAIN_SLOT)
AMP_GAIN_100K: R11.1, U7.27 (IO47)
AMP_SD: R10.1, U7.17 (IO13)
BCLK: U7.15 (IO11), U9.16 (BCLK)
ButtonA: R13.2
ButtonB: R17.2
DIN: U7.14 (IO10), U9.1 (DIN)
ESP32Debug: R18.1, U7.28 (IO33)
ESP32RXD0: U7.40 (RXD0)
ESP32TXD0: U7.39 (TXD0)
FaultLed: R12.1, U7.30 (IO48)
GND: C8.2, C9.2 (-), C10.2, C11.1, C12.1, C13.2, C14.2, C15.2, C16.2, C17.2, C18.2 (-), C19.2, C20.2, C21.2, C22.2, C23.2, C24.2, C25.2, C26.2, C27.2, D3.1 (K), D4.1 (K), IC2.1 (1~OE), IC2.4 (2~OE), IC2.7 (GND), IC2.10 (3~OE), IC2.12 (4A), IC2.13 (4~OE), J2.3, J2.5, J2.9, J3.4, J4.4, J7.1, J8.1, J9.1, J10.1, SW1.2, SW2.1 (A), SW3.1 (A), U6.1 (SDO/SA0), U6.2 (SDX), U6.3 (SCX), U6.6 (GND), U6.7 (GND), U7.1 (GND), U7.2 (GND), U7.42 (GND), U7.43 (GND), U7.46 (GND), U7.47 (GND), U7.48 (GND), U7.49 (GND), U7.50 (GND), U7.51 (GND), U7.52 (GND), U7.53 (GND), U7.54 (GND), U7.55 (GND), U7.56 (GND), U7.57 (GND), U7.58 (GND), U7.59 (GND), U7.60 (GND), U7.61 (GND), U7.62 (GND), U7.63 (GND), U7.64 (GND), U7.65 (GND), U9.3 (GND), U9.11 (GND), U9.15 (GND), U9.17 (PAD)
GUN_LEFT: J3.2, U7.5 (IO1)
GUN_RIGHT: J4.2, U7.6 (IO2)
HALL_LEFT: U7.12 (IO8)
HALL_RIGHT: U7.13 (IO9)
IMU_INT1: U6.4 (INT1), U7.33 (IO37)
JTAG_SEL: R9.2, SW1.1, U7.7 (IO3)
JTAG_TCK: J2.4, U7.35 (IO39)
JTAG_TDI: J2.8, U7.37 (IO41)
JTAG_TDO: J2.6, U7.36 (IO40)
JTAG_TMS: J2.2, U7.38 (IO42)
LRCLK: U7.16 (IO12), U9.14 (LRCLK)
NEOPIXEL_CENTER: IC2.2 (1A), U7.18 (IO14)
NEOPIXEL_LEFT: IC2.5 (2A), U7.19 (IO15)
NEOPIXEL_RIGHT: IC2.9 (3A), U7.20 (IO16)
unnamed: C11.2, R13.1, R19.2, U7.26 (IO26)
unnamed: C12.2, R17.1, R20.2, U7.29 (IO34)
unnamed: D3.2 (A), R12.2
unnamed: D4.2 (A), R18.2
unnamed: R10.2, U9.4 (~SD_MODE)
OUTN: U9.10 (OUTN)
OUTP: U9.9 (OUTP)
PWR_FLT: U7.34 (IO38)
RADAR_RX: U7.21 (IO17)
RADAR_TX: U7.22 (IO18)
ROTATE_X: J10.3, U7.10 (IO6)
ROTATE_Z: J9.3, U7.11 (IO7)
S3En: C13.1, J2.10, R14.2, SW3.2 (B), U7.45 (EN)
S3PRG: SW2.2 (B), U7.4 (IO0)
SCL: R15.2, U6.13 (SCL), U7.32 (IO36)
SDA: R16.2, U6.14 (SDA), U7.31 (IO35)
USB_D+: U7.24 (USB_D+)
USB_D-: U7.23 (USB_D-)
WING_LEFT: J7.3, U7.8 (IO4)
WING_RIGHT: J8.3, U7.9 (IO5)

Notes on the sheet:
JTAG
USB/JTAG select
LED
ESP32 MCU
AUDIO
IMU
SN74AHCT128PWR
