lo26lo/portal-turret-v4/Turret2_portable/untitled.kicad_sch

## KiCad design Turret2_portable/untitled.kicad_sch (2026-10-22)

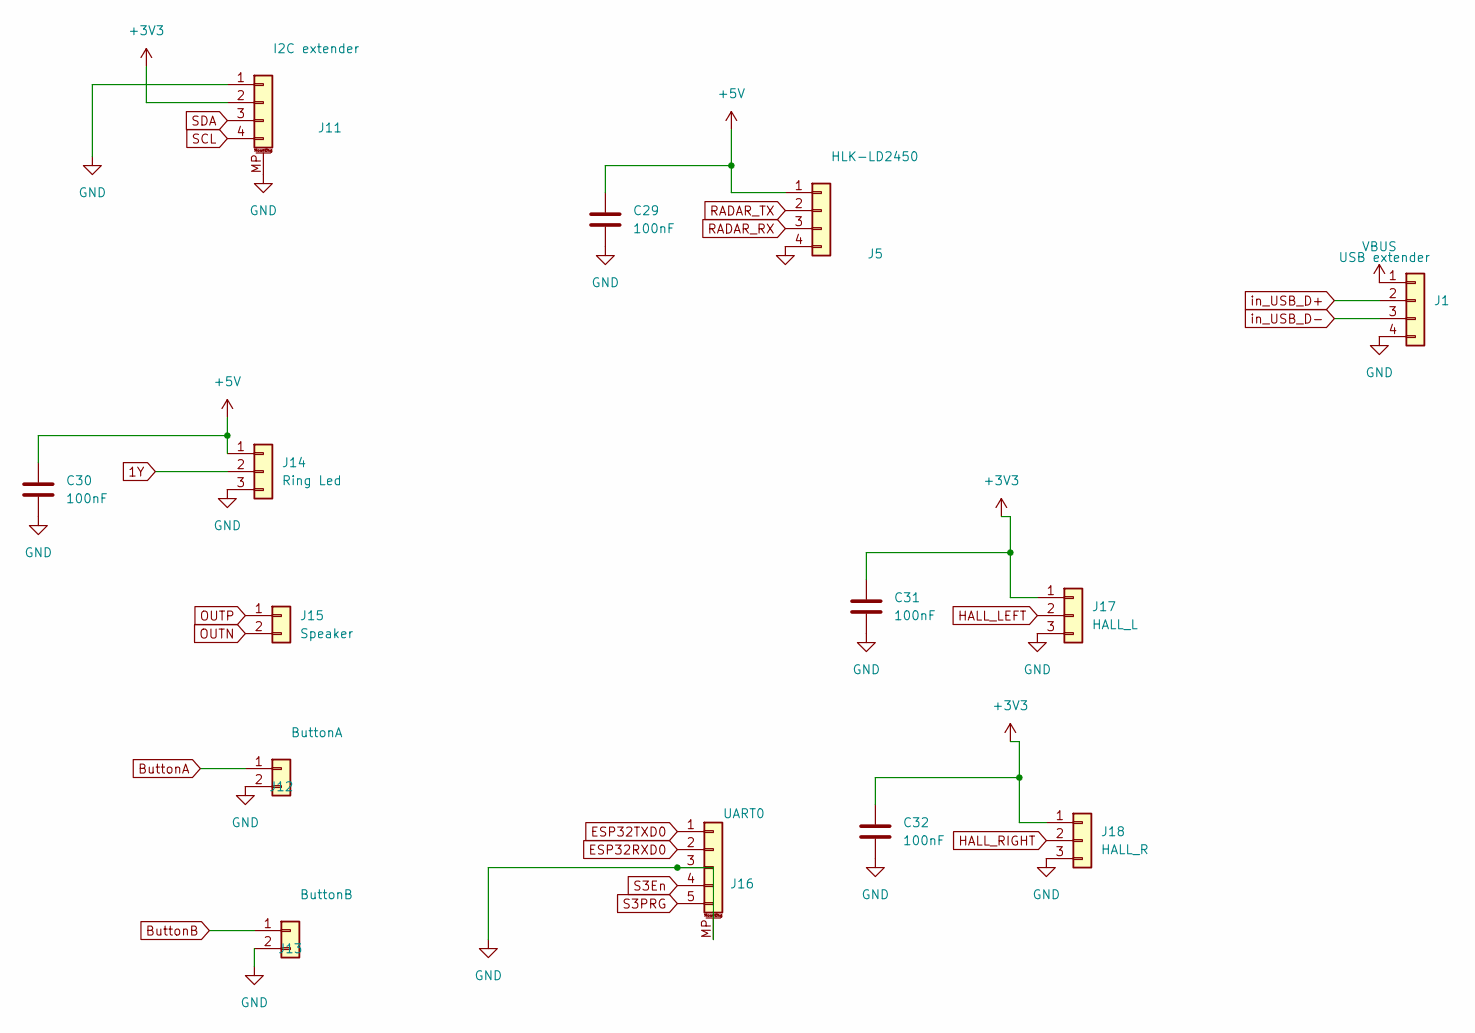
[picture p13: schematic untitled.kicad_sch]

Parts:
C29, C30, C31, C32: 100nF; C_0603_1608Metric
J1: USB extender; JST_PH_B4B-PH-K_1x04_P2.00mm_Vertical
J5: HLK-LD2450; JST_PH_B4B-PH-K_1x04_P2.00mm_Vertical
J11: I2C extender; JST_SH_SM04B-SRSS-TB_1x04-1MP_P1.00mm_Horizontal
J12: ButtonA; SHDR2W50P0X200_1X2_590X450X600P
J13: ButtonB; SHDR2W50P0X200_1X2_590X450X600P
J14: Ring Led; JST_PH_B3B-PH-K_1x03_P2.00mm_Vertical
J15: Speaker; TerminalBlock_Phoenix_PT-1,5-2-3.5-H_1x02_P3.50mm_Horizontal
J16: UART0; JST_SH_SM05B-SRSS-TB_1x05-1MP_P1.00mm_Horizontal
J17: HALL_L; JST_PH_B3B-PH-K_1x03_P2.00mm_Vertical
J18: HALL_R; JST_PH_B3B-PH-K_1x03_P2.00mm_Vertical

Connections:
1Y: J14.2
+3V3: C31.1, C32.1, J11.2, J17.1, J18.1
+5V: C29.1, C30.1, J5.1, J14.1
ButtonA: J12.1
ButtonB: J13.1
ESP32RXD0: J16.2
ESP32TXD0: J16.1
GND: C29.2, C30.2, C31.2, C32.2, J1.4, J5.4, J11.1, J11.MP (MountPin), J12.2, J13.2, J14.3, J16.3, J16.MP (MountPin), J17.3, J18.3
HALL_LEFT: J17.2
HALL_RIGHT: J18.2
OUTN: J15.2
OUTP: J15.1
RADAR_RX: J5.3
RADAR_TX: J5.2
S3En: J16.4
S3PRG: J16.5
SCL: J11.4
SDA: J11.3
VBUS: J1.1
in_USB_D+: J1.2
in_USB_D-: J1.3
