lo26lo/portal-turret-v4/Turret_firmware/src/board/Board.h

#pragma once

#include <Arduino.h>
#include <Preferences.h>

#include "logic/BoardLogic.h"

class Settings;

// Turret2 board services (docs/firmware-plan.md §3.2 step 1, §4, D1, D3, D4, D5):
// safe state of the outputs, reset reason, reboot-loop detection, status LEDs,
// buttons, SW1 (bench mode) and the eFuse fault line.

// Red LED blink codes (D4). When several faults are active, the lowest number wins.
enum class Fault : uint8_t {
  BrownoutLoop = 1, // brownout or reboot loop (reduced mode)
  EFuse = 2,        // PWR_FLT went low
  Imu = 3,          // IMU missing
  Radar = 4,        // no radar frame
  Hall = 5,         // Hall sensor inconsistent
  LittleFs = 6,     // filesystem not mounted
};

// None, ShortPress (released before the long press delay), LongPress (held
// for the long press delay, sent once). Logic in logic/BoardLogic.h, tested natively.
using ButtonEvent = logic::PressEvent;

class Button {
public:
  explicit Button(uint8_t pin);
  void Initialize();
  void Update(ulong now);
  bool IsDown() const { return debouncer.IsDown(); }
  void SetLongPressMs(uint32_t ms) { debouncer.SetLongPressMs(ms); }
  // Returns the pending event and clears it.
  ButtonEvent TakeEvent();

private:
  uint8_t pin;
  logic::Debouncer debouncer;
  ButtonEvent pending = ButtonEvent::None;
};

class Board {
public:
  Board();

  // First call of setup(), before anything else: takes control of every
  // output that floats after reset. No Serial output here (not started yet).
  void Begin();
  // Once Serial is up: reset reason, SW1, PWR_FLT, flash / PSRAM, counters.
  void PrintBanner();
  // End of the boot sequence: the status LEDs leave their boot test (both on)
  // and follow their settings.
  void BootDone();
  // Deep sleep (F2.6): both status LEDs off as plain GPIO outputs low (the
  // green one is an RTC pin: never left high, plan v2 §1.1).
  void LedsOff();
  // Status LED settings (GreenLedMode, GreenLedPeriod, GreenLedBright,
  // RedLedMode) and LabMarkers. Again after every setting change.
  void ApplySettings(const Settings &settings);
  void Update(ulong deltaTime);

  // D1, SW1 closed at boot: debug mode (formerly "bench mode"): the state
  // machine never starts a cycle by itself; debug menu on the OLED (lot IM).
  bool IsBenchMode() const { return benchMode; }
  // Debug mode assumes a weak supply (computer USB port): no servo attached
  // automatically, one at a time in the tests. "power full" lifts this once
  // a 3 A supply is connected.
  bool IsServoLimited() const { return benchMode && !fullPower; }
  void SetFullPower(bool enabled) { fullPower = enabled; }
  // Debug menu: a "long press" is 0.6 s instead of 3 s.
  void SetNavigationButtons(bool enabled);
  bool IsFactoryResetRequested() const { return factoryReset; } // D3, A + B held at boot (v0.1 only)
  bool IsReducedMode() const { return reducedMode; }            // D5, reboot loop detected
  esp_reset_reason_t GetResetReason() const { return resetReason; }
  static const char *ResetReasonName(esp_reset_reason_t reason);

  // eFuse fault line (PIN_PWR_FLT): current level and falling edges seen since the last call.
  bool IsPowerFault() const;
  uint32_t TakePowerFaultEdges();
  // True once per power fault seen since the last call, even if PWR_FLT was
  // low for a moment only (falling edge caught by the interrupt).
  bool TakePowerFaultEvent();
  uint32_t GetPowerFaultCount() const { return powerFaultCount; }
  uint32_t GetBootLoopCount() const { return bootLoopCount; }
  uint32_t GetBrownoutCount() const { return brownoutCount; }
  uint8_t GetFaults() const { return faults; } // bit n-1 = Fault n

  void SetFault(Fault fault, bool active);
  bool HasFault(Fault fault) const;

  // Factory reset gesture (logic::ResetGesture): SW1 closed + PROG held 5 s.
  // While held the red LED blinks fast; once accepted the green one does,
  // until the restart. True once when the gesture is accepted.
  bool TakeFactoryResetRequest();
  logic::ResetGesture::State GetResetGestureState() const { return resetGesture.GetState(); }
  uint32_t GetResetGestureRemainingMs() const { return resetGesture.RemainingMs(millis()); }
  // Green LED blinking fast until the restart (also for the console command).
  void ShowFactoryResetAccepted() { resetAccepted = true; }
  bool IsFactoryResetAccepted() const { return resetAccepted; }
  // Factory reset: boot-loop and brownout counters back to zero (NVS and RAM).
  void ClearCounters();

  // L1 (lab aid): with LabMarkers on, the green LED no longer shows the
  // heartbeat; it toggles at each boot step and each servo attachment, to line
  // up an oscilloscope or PPK2 trace with the code. The label goes to the log.
  void SetLabMarkers(bool enabled);
  bool HasLabMarkers() const { return labMarkers; }
  static void Mark(const char *label);

  // v0.1 only: on the v2 (PIN_ABSENT) they never report an event.
  Button buttonA;
  Button buttonB;
  // F2.5 (both boards): PROG held 3 s with SW1 open (SW1 closed: the factory
  // reset gesture), or the v2 remote button (J20) held 3 s. Only LongPress is
  // reported; returns it once and clears it.
  ButtonEvent TakeProgEvent();
  // Any press of PROG (SW1 open) or of the remote button since the last call
  // (wakes the radar sleep up).
  bool TakeUserPress();

private:
  void UpdateGreenLed(ulong now);
  // Green LED brightness 0..255. 0 and 255 drive the pin as a plain GPIO
  // (truly off / on); levels in between go through the sigma-delta modulator,
  // which leaves the LEDC timers to the servos.
  void SetGreenLevel(uint8_t level);
  void UpdateRedLed(ulong now);
  void UpdateBootLoopCounter(ulong now);
  void UpdateResetGesture(ulong now);

  Preferences prefs;
  bool prefsReady = false;

  esp_reset_reason_t resetReason = ESP_RST_UNKNOWN;
  bool benchMode = false;
  bool fullPower = false;
  bool factoryReset = false;
  bool reducedMode = false;
  bool bootDone = false;
  bool bootLoopCleared = false;
  uint32_t bootLoopCount = 0;
  uint32_t brownoutCount = 0;
  uint32_t powerFaultCount = 0;
  bool powerFaultEvent = false;

  bool labMarkers = false;
  bool markerLevel = false;
  bool greenModulated = false; // pin routed to the sigma-delta modulator

public:
  // Diagnostic ("pins" command): what the firmware believes about the green LED.
  bool IsGreenModulated() const { return greenModulated; }

private:
  logic::GreenLedMode greenMode = logic::GreenLedMode::Breathing;
  uint32_t greenPeriodMs = 4000;
  uint8_t greenPercent = 100;
  logic::RedLedMode redMode = logic::RedLedMode::FaultCodes;

  logic::ResetGesture resetGesture;
  logic::Debouncer progButton{30, 3000};
  logic::Debouncer extButton{30, 3000}; // v2 J20, active high
  ButtonEvent progPending = ButtonEvent::None;
  bool userPress = false;
  bool resetRequested = false;
  bool resetAccepted = false;

  uint8_t faults = 0; // bit n-1 = Fault n
  uint8_t redCode = 0;
  uint8_t redStep = 0;
  ulong redStepAt = 0;
};
