lo26lo/portal-turret-v4/Turret_firmware/src/states/ManualState.h

#pragma once

#include "BaseState.h"

// The state machine is stopped: debug mode, reduced mode, hardware tests.
// Nothing happens here; "resume" goes through Booting again.
class ManualState : public BaseState {};
