lo26lo/portal-turret-v4/Turret_firmware/src/states/StateMachine.h

#pragma once

#include "Arduino.h"
#include "Turret.h"
#include "states/ActivateState.h"
#include "states/BaseState.h"
#include "states/BootState.h"
#include "states/DisengageState.h"
#include "states/FaultState.h"
#include "states/FiringState.h"
#include "states/IdleState.h"
#include "states/ManualState.h"
#include "states/SearchingState.h"
#include "states/StateId.h"

class StateMachine {
public:
  void Initialize(Turret &turret);
  void GoToState(StateId nextStateId);
  void Update(ulong deltaTime);
  StateId GetCurrentStateId() const { return currentStateId; }
  static const char *StateName(StateId id);

private:
  BaseState *GetState(StateId nextStateId);
  BaseState *currentState = nullptr;
  StateId currentStateId = StateId::Booting;

  BootState bootState;
  IdleState idleState;
  ActivateState activateState;
  FiringState firingState;
  SearchingState searchingState;
  DisengageState disengageState;
  ManualState manualState;
  FaultState faultState;
};
