lo26lo/portal-turret-v4/Turret_firmware/src/settings/Settings.cpp

#include "board/Log.h"
#include "Settings.h"

namespace {
const char *NVS_NAMESPACE = "turret";
const size_t NVS_KEY_MAX = 15;
} // namespace

SettingValue::SettingValue(const char *v) {
  strlcpy(valueString, v, SETTING_STRING_MAX);
}

SettingsEntry::SettingsEntry(const char *key, const char *label, const char *group, SettingType type,
                             SettingValue defaultValue, SettingValue min, SettingValue max)
    : key(key), label(label), group(group), type(type), value(defaultValue), defaultValue(defaultValue), min(min),
      max(max), options(nullptr) {}

SettingsEntry::SettingsEntry(const char *key, const char *label, const char *group, SettingType type,
                             SettingValue defaultValue, SettingValue min, SettingValue max, const char *options)
    : key(key), label(label), group(group), type(type), value(defaultValue), defaultValue(defaultValue), min(min),
      max(max), options(options) {}

SettingsEntry::SettingsEntry(const char *key, const char *label, const char *group, SettingType type,
                             SettingValue defaultValue)
    : key(key), label(label), group(group), type(type), value(defaultValue), defaultValue(defaultValue),
      min((int32_t)0), max((int32_t)0), options(nullptr) {}

bool OptionName(const char *options, int32_t index, char *out, size_t size) {
  if (options == nullptr || index < 0 || size == 0) {
    return false;
  }
  const char *start = options;
  for (int32_t i = 0; i < index; i++) {
    start = strchr(start, '|');
    if (start == nullptr) {
      return false;
    }
    start++;
  }
  const char *end = strchr(start, '|');
  size_t length = end ? (size_t)(end - start) : strlen(start);
  if (length >= size) {
    length = size - 1;
  }
  memcpy(out, start, length);
  out[length] = '\0';
  return true;
}

// The rows must stay in the same order as SettingId.
Settings::Settings()
    : entries{
          {"AngleOffsetX", "Angle offset X", "Motion", SettingType::Int, (int32_t)0, (int32_t)-90, (int32_t)90},
          {"AngleOffsetZ", "Angle offset Z", "Motion", SettingType::Int, (int32_t)0, (int32_t)-90, (int32_t)90},
          // 0 = not calibrated (no upright check), 1..6 = +X, -X, +Y, -Y, +Z, -Z
          {"ImuUpAxis", "IMU up axis (0 = off, 1..6 = +X -X +Y -Y +Z -Z)", "Motion", SettingType::Int, (int32_t)0, (int32_t)0, (int32_t)6},
          // MAX98357A gain: 9, 12 or 15 dB (other values rounded to the nearest)
          {"AmpGain", "Amplifier gain (dB: 9, 12, 15)", "Audio", SettingType::Int, (int32_t)9, (int32_t)9, (int32_t)15},
          {"Volume", "Volume (%)", "Audio", SettingType::Int, (int32_t)80, (int32_t)0, (int32_t)100},
          // Voice lines of the upstream project (data/, MP3 on LittleFS): activate, retire, tipped...
          {"Voices", "Turret voice lines", "Audio", SettingType::Bool, true},
          // A2: rest after each cycle, and detection zone of the LD2450 (range 6 m, +-60 deg; RD-03D: 8 m, +-60 deg)
          {"CooldownMs", "Rest after a cycle (ms)", "Detection", SettingType::Int, (int32_t)5000, (int32_t)0, (int32_t)120000},
          {"DetectMaxMm", "Detection distance (mm)", "Detection", SettingType::Int, (int32_t)3000, (int32_t)300, (int32_t)6000},
          {"DetectAngle", "Detection half angle (deg)", "Detection", SettingType::Int, (int32_t)45, (int32_t)5, (int32_t)60},
          // Hall thresholds (raw ADC 0..4095). V4 values; Turret2 sensors run at
          // 3.3 V and must be calibrated. Open below closed = reversed magnet.
          {"HallOpenL", "Hall left: open threshold", "Wings", SettingType::Int, (int32_t)2500, (int32_t)0, (int32_t)4095},
          {"HallOpenR", "Hall right: open threshold", "Wings", SettingType::Int, (int32_t)2500, (int32_t)0, (int32_t)4095},
          {"HallCloseL", "Hall left: closed threshold", "Wings", SettingType::Int, (int32_t)1500, (int32_t)0, (int32_t)4095},
          {"HallCloseR", "Hall right: closed threshold", "Wings", SettingType::Int, (int32_t)1500, (int32_t)0, (int32_t)4095},
          // Continuous servo neutral: 1500 us + trim
          {"WingTrimL", "Wing left: stop trim (us)", "Wings", SettingType::Int, (int32_t)0, (int32_t)-200, (int32_t)200},
          {"WingTrimR", "Wing right: stop trim (us)", "Wings", SettingType::Int, (int32_t)0, (int32_t)-200, (int32_t)200},
          {"ServoStagger", "Delay between two servo starts (ms)", "Power", SettingType::Int, (int32_t)250, (int32_t)50, (int32_t)1000},
          {"ServoIdleMs", "Rotation servos released after (ms, 0 = never)", "Power", SettingType::Int, (int32_t)5000, (int32_t)0, (int32_t)60000},
          // Weak supply (debug mode without "power full"): a SG90 jumping 90 deg
          // draws ~0.5-0.7 A and stalls on a computer USB port; 1000 us/s = ~95 deg/s.
          {"ServoRamp", "Servo speed on a weak supply (us/s, 0 = no ramp)", "Power", SettingType::Int, (int32_t)1000, (int32_t)0, (int32_t)20000},
          {"LedBright", "LED brightness (0..255)", "Lights", SettingType::Int, (int32_t)255, (int32_t)0, (int32_t)255},
          // FastLED power cap on the 5 V rail: 13 LEDs at full white draw ~0.8 A
          {"LedMaxmA", "LED current limit (mA)", "Power", SettingType::Int, (int32_t)500, (int32_t)100, (int32_t)1500},
          // Status LEDs on the board, after boot (during boot both stay on: LED test).
          // Options in the order of logic::GreenLedMode / logic::RedLedMode.
          {"GreenLedMode", "Green LED", "Status LEDs", SettingType::Int, (int32_t)0, (int32_t)0, (int32_t)3, "Breathing|Heartbeat|Steady|Off"},
          {"GreenLedPeriod", "Green LED: one breath or heartbeat (ms)", "Status LEDs", SettingType::Int, (int32_t)4000, (int32_t)1000, (int32_t)10000},
          {"GreenLedBright", "Green LED brightness (%)", "Status LEDs", SettingType::Int, (int32_t)100, (int32_t)1, (int32_t)100},
          {"RedLedMode", "Red LED", "Status LEDs", SettingType::Int, (int32_t)0, (int32_t)0, (int32_t)2, "Fault codes|On while a fault is active|Off"},
          // D7. Group "WiFi" = applied at the next boot. Passwords: 8..63 chars (WPA2).
          {"ApSsid", "Access point name", "WiFi", SettingType::Str, "Portal Turret"},
          {"ApPassword", "Access point (WiFi) password (8..63)", "WiFi", SettingType::Str, "stillalive"},
          // Web page and firmware upload login, separate from the WiFi password (WPA2 needs 8..63).
          {"WebUser", "Web page user name", "WiFi", SettingType::Str, "Admin"},
          {"WebPassword", "Web page password (4..63)", "WiFi", SettingType::Str, "1234"},
          // Home network (station mode): empty name = not used. The access point stays on.
          {"StaSsid", "Home WiFi name (empty = off)", "WiFi", SettingType::Str, ""},
          {"StaPassword", "Home WiFi password", "WiFi", SettingType::Str, ""},
          // POSIX TZ string, default Europe/Paris with daylight saving time
          {"Timezone", "Time zone (POSIX TZ)", "WiFi", SettingType::Str, "CET-1CEST,M3.5.0,M10.5.0/3"},
          // L1: green LED toggles at each boot step / servo attachment instead of the heartbeat
          {"LabMarkers", "Lab markers on the green LED", "Lab", SettingType::Bool, false},
          // Debug screen on the Qwiic port J11 (lot IM)
          {"Language", "Screen language (0 = English, 1 = French)", "Display", SettingType::Int, (int32_t)1, (int32_t)0, (int32_t)1},
          // The controller cannot be detected; the I2C address (0x3C / 0x3D) is. Applied at the next boot.
          {"OledType", "OLED (0 = SSD1306 0.96in, 1 = SSD1309 1.54in, 2 = SH1106 1.3in)", "Display", SettingType::Int, (int32_t)0, (int32_t)0, (int32_t)2},
          {"OledAnim", "Wing animation on the screen", "Display", SettingType::Bool, true},
          {"OledFlip", "Screen rotated by 180 degrees", "Display", SettingType::Bool, false},
          {"OledContrast", "Screen contrast (0..255)", "Display", SettingType::Int, (int32_t)255, (int32_t)0, (int32_t)255},
          // OLEDs burn in: the screen goes off after this time without a key press or activity
          {"OledSleepS", "Screen off after (s, 0 = never)", "Display", SettingType::Int, (int32_t)300, (int32_t)0, (int32_t)3600},
          {"OledFace", "Aperture logo and subtitles in normal mode", "Display", SettingType::Bool, true},
          // Lot F2.6, sleep (docs/carte-v2-plan.md §1). Options in the order of
          // logic::SleepMode / logic::SleepWifi (logic/SleepLogic.h). Deep sleep,
          // patrols, IMU wake-up and Hall power: v2 board only, normal mode (SW1 open).
          {"SleepMode", "Sleep", "Sleep", SettingType::Int, (int32_t)1, (int32_t)0, (int32_t)2, "Never|Radar sleep only|Radar sleep then deep sleep (v2)"},
          {"RadarSleepMin", "Radar sleep after (min without a target, 0 = never)", "Sleep", SettingType::Int, (int32_t)10, (int32_t)0, (int32_t)240},
          {"DeepSleepMin", "Deep sleep after (min of radar sleep, 0 = night only)", "Sleep", SettingType::Int, (int32_t)0, (int32_t)0, (int32_t)1440},
          {"NightSleep", "Deep sleep at night (needs the time: home WiFi)", "Sleep", SettingType::Bool, false},
          {"NightStart", "Night from (hour)", "Sleep", SettingType::Int, (int32_t)23, (int32_t)0, (int32_t)23},
          {"NightEnd", "Night until (hour)", "Sleep", SettingType::Int, (int32_t)7, (int32_t)0, (int32_t)23},
          {"SleepWifi", "WiFi while asleep", "Sleep", SettingType::Int, (int32_t)0, (int32_t)0, (int32_t)2, "Unchanged|Home network only|Off"},
          // Patrol: wake-up every PatrolPeriodS from the deep sleep, radar on for PatrolOnS.
          {"PatrolPeriodS", "Deep sleep: look with the radar every (s, 0 = never)", "Sleep", SettingType::Int, (int32_t)0, (int32_t)0, (int32_t)3600},
          {"PatrolOnS", "Deep sleep: radar look duration (s)", "Sleep", SettingType::Int, (int32_t)3, (int32_t)1, (int32_t)60},
          {"WakeImu", "Deep sleep: wake up when the turret is moved", "Sleep", SettingType::Bool, true},
          {"WakeImuLevel", "Deep sleep: movement needed", "Sleep", SettingType::Int, (int32_t)1, (int32_t)0, (int32_t)2, "Firm knock|Nudge|Light touch"},
          {"HallPower", "Hall sensors powered", "Sleep", SettingType::Int, (int32_t)1, (int32_t)0, (int32_t)1, "Always|While a wing moves (v2)"},
          // Light::Effect: what the LEDs show outside a test.
          {"LedEffect", "LED effect", "Lights", SettingType::Int, (int32_t)0, (int32_t)0, (int32_t)2, "Red eye|Turning rainbow|Living eye (follows the state)"},
          // Firing cycle (logic/CycleLogic.h): a burst, then a search for the target.
          {"FireMs", "Burst of fire (ms)", "Detection", SettingType::Int, (int32_t)3000, (int32_t)500, (int32_t)20000},
          {"SearchMs", "Search for the target after a burst (ms, 0 = retire at once)", "Detection", SettingType::Int, (int32_t)4000, (int32_t)0, (int32_t)30000},
          // B1: rotation Z follows the target (firing) and sweeps (searching).
          // Off by default: the direction of the rotation against the radar x axis
          // has not been checked on a turret yet (AngleOffsetZ / the gear ratio).
          {"AimZ", "Rotation Z follows the target (check the direction first)", "Detection", SettingType::Bool, false},
          // B10: radial speed of the radar (cm/s). A walking person is under 200,
          // a reflection or a fan blade can read far more. 0 = no limit.
          {"MaxSpeedCms", "Ignore targets faster than (cm/s, 0 = no limit)", "Detection", SettingType::Int, (int32_t)0, (int32_t)0, (int32_t)2000},
      },
      prefsReady(false) {}

void Settings::Initialize() {
  for (int i = 0; i < SettingId::COUNT; i++) {
    if (strlen(entries[i].key) > NVS_KEY_MAX) {
      Log.print("Settings: key too long for NVS: ");
      Log.println(entries[i].key);
    }
  }

  prefsReady = prefs.begin(NVS_NAMESPACE, false);
  if (!prefsReady) {
    Log.println("Settings: could not open NVS, using defaults");
    return;
  }
  Load();
}

void Settings::Load() {
  for (int i = 0; i < SettingId::COUNT; i++) {
    SettingsEntry &entry = entries[i];
    if (!prefs.isKey(entry.key)) {
      continue;
    }
    switch (entry.type) {
    case SettingType::Int: entry.value.valueInt = prefs.getInt(entry.key, entry.value.valueInt); break;
    case SettingType::Float: entry.value.valueFloat = prefs.getFloat(entry.key, entry.value.valueFloat); break;
    case SettingType::Bool: entry.value.valueBool = prefs.getBool(entry.key, entry.value.valueBool); break;
    case SettingType::Str: prefs.getString(entry.key, entry.value.valueString, SETTING_STRING_MAX); break;
    }
  }
}

void Settings::Persist(const SettingsEntry &entry) {
  if (!prefsReady) {
    return;
  }
  switch (entry.type) {
  case SettingType::Int: prefs.putInt(entry.key, entry.value.valueInt); break;
  case SettingType::Float: prefs.putFloat(entry.key, entry.value.valueFloat); break;
  case SettingType::Bool: prefs.putBool(entry.key, entry.value.valueBool); break;
  case SettingType::Str: prefs.putString(entry.key, entry.value.valueString); break;
  }
}

const SettingsEntry *Settings::Get(SettingId id) const {
  if (id < 0 || id >= SettingId::COUNT) {
    Log.print("Settings: unknown id ");
    Log.println((int)id);
    return nullptr;
  }
  return &entries[id];
}

SettingsEntry *Settings::Get(SettingId id) {
  return const_cast<SettingsEntry *>(static_cast<const Settings *>(this)->Get(id));
}

int32_t Settings::GetInt(SettingId id) const {
  const SettingsEntry *entry = Get(id);
  if (entry == nullptr) {
    return 0;
  }
  if (entry->type != SettingType::Int) {
    Log.print("Settings: not an int: ");
    Log.println(entry->key);
    return 0;
  }
  return entry->value.valueInt;
}

float Settings::GetFloat(SettingId id) const {
  const SettingsEntry *entry = Get(id);
  if (entry == nullptr) {
    return 0.0f;
  }
  // Ints read fine as floats; anything else does not.
  if (entry->type == SettingType::Int) {
    return (float)entry->value.valueInt;
  }
  if (entry->type != SettingType::Float) {
    Log.print("Settings: not a float: ");
    Log.println(entry->key);
    return 0.0f;
  }
  return entry->value.valueFloat;
}

bool Settings::GetBool(SettingId id) const {
  const SettingsEntry *entry = Get(id);
  if (entry == nullptr) {
    return false;
  }
  if (entry->type != SettingType::Bool) {
    Log.print("Settings: not a bool: ");
    Log.println(entry->key);
    return false;
  }
  return entry->value.valueBool;
}

const char *Settings::GetString(SettingId id) const {
  const SettingsEntry *entry = Get(id);
  if (entry == nullptr) {
    return "";
  }
  if (entry->type != SettingType::Str) {
    Log.print("Settings: not a string: ");
    Log.println(entry->key);
    return "";
  }
  return entry->value.valueString;
}

bool Settings::Set(SettingId id, int32_t value) {
  SettingsEntry *entry = Get(id);
  if (entry == nullptr) {
    return false;
  }
  if (entry->type != SettingType::Int) {
    Log.print("Settings: not an int: ");
    Log.println(entry->key);
    return false;
  }
  if (value < entry->min.valueInt) {
    value = entry->min.valueInt;
  }
  if (value > entry->max.valueInt) {
    value = entry->max.valueInt;
  }
  entry->value.valueInt = value;
  Persist(*entry);
  return true;
}

bool Settings::Set(SettingId id, float value) {
  SettingsEntry *entry = Get(id);
  if (entry == nullptr) {
    return false;
  }
  if (entry->type != SettingType::Float) {
    Log.print("Settings: not a float: ");
    Log.println(entry->key);
    return false;
  }
  if (value < entry->min.valueFloat) {
    value = entry->min.valueFloat;
  }
  if (value > entry->max.valueFloat) {
    value = entry->max.valueFloat;
  }
  entry->value.valueFloat = value;
  Persist(*entry);
  return true;
}

bool Settings::Set(SettingId id, bool value) {
  SettingsEntry *entry = Get(id);
  if (entry == nullptr) {
    return false;
  }
  if (entry->type != SettingType::Bool) {
    Log.print("Settings: not a bool: ");
    Log.println(entry->key);
    return false;
  }
  entry->value.valueBool = value;
  Persist(*entry);
  return true;
}

bool Settings::Set(SettingId id, const char *value) {
  SettingsEntry *entry = Get(id);
  if (entry == nullptr) {
    return false;
  }
  if (entry->type != SettingType::Str) {
    Log.print("Settings: not a string: ");
    Log.println(entry->key);
    return false;
  }
  // WPA2: passphrase 8..63 characters (SETTING_STRING_MAX leaves 63); SSID 1..32 bytes.
  size_t length = strlen(value);
  if (id == SettingId::ApPassword && (length < 8 || length >= SETTING_STRING_MAX)) {
    Log.println("Settings: ApPassword must be 8 to 63 characters");
    return false;
  }
  if (id == SettingId::StaPassword && length != 0 && (length < 8 || length >= SETTING_STRING_MAX)) {
    Log.println("Settings: StaPassword must be empty (open network) or 8 to 63 characters");
    return false;
  }
  if ((id == SettingId::ApSsid && length == 0) ||
      ((id == SettingId::ApSsid || id == SettingId::StaSsid) && length > 32)) {
    Log.println("Settings: a WiFi name is 1 to 32 characters");
    return false;
  }
  if (id == SettingId::Timezone && length == 0) {
    Log.println("Settings: Timezone cannot be empty");
    return false;
  }
  // HTTP Basic: the user name ends at the first ':'.
  if (id == SettingId::WebUser && (length == 0 || length > 32 || strchr(value, ':') != nullptr)) {
    Log.println("Settings: WebUser is 1 to 32 characters, without ':'");
    return false;
  }
  if (id == SettingId::WebPassword && (length < 4 || length >= SETTING_STRING_MAX)) {
    Log.println("Settings: WebPassword must be 4 to 63 characters");
    return false;
  }
  strlcpy(entry->value.valueString, value, SETTING_STRING_MAX);
  Persist(*entry);
  return true;
}

namespace {
bool ParseBool(const char *text) {
  return strcasecmp(text, "true") == 0 || strcasecmp(text, "on") == 0 || strcmp(text, "1") == 0;
}

// Index of the option named text (any case), -1 if none.
int32_t OptionIndex(const char *options, const char *text) {
  char name[SETTING_STRING_MAX];
  for (int32_t i = 0; OptionName(options, i, name, sizeof(name)); i++) {
    if (strcasecmp(name, text) == 0) {
      return i;
    }
  }
  return -1;
}
} // namespace

bool Settings::SetFromString(SettingId id, const char *text) {
  const SettingsEntry *entry = Get(id);
  if (entry == nullptr) {
    return false;
  }
  switch (entry->type) {
  case SettingType::Int:
    // A choice takes its option name ("set GreenLedMode off") or its number,
    // nothing else: "off" must not silently become 0.
    if (entry->options != nullptr) {
      int32_t index = OptionIndex(entry->options, text);
      if (index >= 0) {
        return Set(id, index);
      }
      char *end = nullptr;
      long number = strtol(text, &end, 10);
      if (end == text || *end != '\0') {
        Log.print("Settings: unknown option for ");
        Log.println(entry->key);
        return false;
      }
      return Set(id, (int32_t)number);
    }
    return Set(id, (int32_t)strtol(text, nullptr, 10));
  case SettingType::Float: return Set(id, (float)strtod(text, nullptr));
  case SettingType::Bool: return Set(id, ParseBool(text));
  case SettingType::Str: return Set(id, text);
  }
  return false;
}

bool Settings::FindId(const char *key, SettingId &outId) const {
  for (int i = 0; i < SettingId::COUNT; i++) {
    if (strcmp(entries[i].key, key) == 0) {
      outId = (SettingId)i;
      return true;
    }
  }
  Log.print("Settings: unknown key ");
  Log.println(key);
  return false;
}

void Settings::ResetGroup(const char *group) {
  for (int i = 0; i < SettingId::COUNT; i++) {
    if (strcmp(entries[i].group, group) == 0) {
      entries[i].value = entries[i].defaultValue;
      Persist(entries[i]);
    }
  }
}

void Settings::ResetToDefaults() {
  for (int i = 0; i < SettingId::COUNT; i++) {
    entries[i].value = entries[i].defaultValue;
    Persist(entries[i]);
  }
}
