lo26lo/portal-turret-v4/Turret_firmware/src/audio/GunShotAudio.h

#include <Arduino.h>

const PROGMEM uint8_t samples[] = {
0xEF, 0xFF, 0x4F, 0x00, 0x1A, 0x00, 0x59, 0xFF, 0xD9, 0x00, 0x3A, 0xFF, 0x04, 0x01, 0x6B, 0xFE, 
0x06, 0xF9, 0x05, 0xF6, 0xBA, 0xEE, 0xE6, 0xF2, 0x75, 0xF5, 0x54, 0xE5, 0x39, 0xE7, 0x21, 0xFB, 
0x77, 0xF3, 0x7A, 0xE9, 0x18, 0xFE, 0x35, 0x02, 0x2E, 0xEE, 0xDE, 0xF4, 0x07, 0x08, 0x17, 0xFF, 
0xEB, 0xF1, 0xFF, 0xF7, 0xF1, 0xF5, 0x7F, 0xF7, 0xE6, 0x0A, 0x41, 0x09, 0xF9, 0xFA, 0xC4, 0x08, 
0xFA, 0x16, 0xD2, 0x0A, 0xED, 0x04, 0xC2, 0x0C, 0x4F, 0x07, 0xA3, 0xFB, 0xF5, 0x03, 0x58, 0x07, 
0x89, 0x0B, 0x0B, 0x12, 0x97, 0x03, 0x33, 0xF4, 0xFD, 0xF3, 0x5E, 0xFC, 0x49, 0x06, 0x3F, 0x08, 
0xE1, 0xF9, 0x18, 0x1B, 0x01, 0x48, 0x16, 0x4A, 0xB8, 0xFD, 0xB5, 0xDC, 0x17, 0x3F, 0xC5, 0x54, 
0xC9, 0x3C, 0x00, 0x02, 0x0A, 0xE6, 0x97, 0xF3, 0x3A, 0xDF, 0x1F, 0xED, 0x46, 0xF0, 0x9A, 0x0C, 
0x81, 0x15, 0x38, 0x32, 0x53, 0x35, 0x33, 0x0A, 0x63, 0xFF, 0x7B, 0xF1, 0x15, 0xEA, 0x3B, 0xD8, 
0xF2, 0xD7, 0xC7, 0xAE, 0x77, 0xB5, 0x92, 0xCB, 0xB4, 0xE0, 0x45, 0x0B, 0x76, 0xD7, 0x5F, 0xBE, 
0x56, 0xBE, 0x2D, 0xBE, 0xDA, 0xC4, 0xA7, 0xC5, 0x4F, 0xC6, 0xF0, 0xDA, 0x09, 0xE1, 0xD6, 0xD4, 
0x2D, 0xD4, 0xDF, 0xE2, 0x26, 0x0D, 0x5A, 0xEC, 0x7B, 0xDF, 0x66, 0xF2, 0x1E, 0xEA, 0x66, 0xEC, 
0x6B, 0xE3, 0x1F, 0xF2, 0x86, 0x25, 0xE0, 0x19, 0xF8, 0xFB, 0xF9, 0x39, 0x44, 0x58, 0x10, 0x50, 
0x24, 0x1E, 0xC9, 0x34, 0xF6, 0x62, 0x3B, 0xFB, 0xB6, 0xD6, 0x74, 0xEF, 0x9D, 0x0D, 0xEB, 0x33, 
0x0C, 0x1D, 0xD1, 0xF2, 0xBD, 0x16, 0x52, 0x42, 0x31, 0x00, 0xB0, 0xEE, 0xD2, 0x25, 0xEB, 0x2D, 
0x2A, 0x27, 0x47, 0x27, 0x24, 0x2A, 0xF7, 0x2C, 0x20, 0x2A, 0xA5, 0x2F, 0x36, 0x02, 0xCA, 0xD6, 
0x50, 0xDD, 0xB2, 0xCC, 0x04, 0xE8, 0x9D, 0x1E, 0xF6, 0x04, 0xD8, 0xF2, 0x81, 0x18, 0x12, 0x19, 
0x2E, 0x1A, 0xAC, 0x1E, 0x5A, 0x1C, 0x85, 0x22, 0x6C, 0x1C, 0x7B, 0x24, 0xD6, 0x1E, 0x24, 0x26, 
0xD0, 0x0B, 0xAC, 0xCC, 0x86, 0xE4, 0x1C, 0x16, 0x81, 0x17, 0x68, 0x14, 0xBB, 0x18, 0x40, 0x15, 
0xE3, 0x18, 0xCB, 0x1A, 0x16, 0xFB, 0xA6, 0xF3, 0xAC, 0x26, 0xB4, 0x04, 0x5C, 0xAD, 0x98, 0x9F, 
0x67, 0xA5, 0x71, 0xB1, 0x9A, 0xC0, 0x57, 0xCE, 0x93, 0xE5, 0xB4, 0xD0, 0xC2, 0xA3, 0xE4, 0xA2, 
0x90, 0xAE, 0x8A, 0xC0, 0x37, 0xD7, 0x28, 0xE5, 0xF4, 0xEE, 0x01, 0xDA, 0xF3, 0xD9, 0x52, 0xFB, 
0xFB, 0xFC, 0xC2, 0xDC, 0x3E, 0xD1, 0x6E, 0xD8, 0xDC, 0xEA, 0x60, 0x06, 0x7D, 0xF4, 0x0E, 0xEB, 
0x23, 0xF1, 0x4D, 0xEB, 0x71, 0xED, 0xDD, 0xEA, 0xB8, 0x08, 0x06, 0x15, 0x7F, 0xF3, 0x9D, 0xEE, 
0x25, 0x18, 0x75, 0x34, 0xC7, 0x13, 0xEC, 0xF9, 0x76, 0x0B, 0xD9, 0x3A, 0x61, 0x4D, 0x95, 0x2B, 
0x16, 0x1F, 0x2B, 0x10, 0x2A, 0xF9, 0x56, 0xED, 0xB1, 0xF2, 0x21, 0x0E, 0x65, 0x15, 0x61, 0x13, 
0x3E, 0x0F, 0x59, 0x19, 0xDE, 0x35, 0x44, 0x3D, 0x74, 0x3C, 0x99, 0x41, 0xC6, 0x3D, 0xB3, 0x25, 
0x25, 0x1D, 0x1A, 0x35, 0x69, 0x3E, 0x77, 0x3B, 0x86, 0x3B, 0xBA, 0x37, 0xD8, 0x34, 0xDA, 0x30, 
0xE6, 0x2C, 0xF3, 0x28, 0x68, 0x27, 0x69, 0x25, 0x25, 0x21, 0x8F, 0x1E, 0x75, 0x1B, 0xA9, 0x1A, 
0x64, 0x15, 0xC6, 0x08, 0x92, 0x05, 0xD4, 0x07, 0xC5, 0xFB, 0x38, 0xEB, 0xF5, 0xE0, 0x46, 0xD4, 
0x4C, 0xBC, 0x26, 0xB5, 0xF4, 0xCF, 0x5A, 0xE3, 0xFC, 0xD7, 0x7A, 0xC7, 0x67, 0xC2, 0x79, 0xC1, 
0x0C, 0xC7, 0x90, 0xD1, 0x56, 0xE1, 0x02, 0xE4, 0xC9, 0xE4, 0x8F, 0xF6, 0x6C, 0xFD, 0xE8, 0xFB, 
0x57, 0xF9, 0x6E, 0x09, 0xE8, 0x0A, 0x67, 0xF6, 0x21, 0x0B, 0xFC, 0x25, 0x5D, 0x1A, 0xAE, 0x09, 
0x5D, 0x13, 0xA4, 0x24, 0x4D, 0x2F, 0xAF, 0x22, 0xB4, 0x10, 0x4A, 0x0F, 0x72, 0x03, 0x9A, 0xFA, 
0x48, 0x06, 0xA9, 0x06, 0x8E, 0xE6, 0x85, 0xEC, 0x4B, 0x08, 0x22, 0xED, 0xD0, 0xE8, 0x33, 0xF4, 
0x97, 0xCC, 0x3D, 0xCA, 0x42, 0xD6, 0xC3, 0xCE, 0x8B, 0xEE, 0xFF, 0xE5, 0x63, 0xE0, 0xE4, 0xED, 
0x3B, 0xC1, 0x97, 0xBD, 0x46, 0xE3, 0x65, 0xEA, 0xC4, 0xDD, 0x8A, 0xD7, 0xCD, 0xE1, 0x01, 0xE9, 
0xFB, 0xE6, 0x2B, 0xF2, 0xF3, 0xE7, 0x13, 0xE2, 0xB2, 0x02, 0xA9, 0xF8, 0x8E, 0xFE, 0x7B, 0x0F, 
0x48, 0x04, 0xFA, 0x0D, 0x11, 0x0B, 0x25, 0x0C, 0x9B, 0x0D, 0x46, 0x0C, 0x67, 0x0C, 0x9B, 0x05, 
0x9E, 0x08, 0x89, 0x09, 0x04, 0x0A, 0x4C, 0x09, 0x61, 0x08, 0x97, 0x07, 0x51, 0x07, 0xD0, 0x07, 
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
};
