lo26lo/portal-turret-v4/Turret_firmware/src/motion/Gantry.h

#pragma once

#include "Arduino.h"
#include "ServoChannel.h"
#include "Wing.h"
#include "settings/Settings.h"

class Gantry {
public:
  Gantry();
  // Reads settings and the Hall sensors. Attaches no servo.
  void Initialize(Settings &settings);
  // Reads the motion settings again (after a change from the web page or console).
  void ApplySettings();
  // Runs the attach schedule and the D6 hold policy.
  void Update(ulong deltaTime);
  void SetRotationX(int angle, bool force);
  void SetRotationZ(int angle, bool force);
  // Servo angle (0..180) that a turret rotation Z of `angle` degrees maps to
  // (offset and gear ratio), for the "aim" report.
  int ServoAngleZ(int angle) const;
  void OpenWings();
  void CloseWings();
  Wing &GetWingLeft();
  Wing &GetWingRight();

  // Boot step 11: rotations centred and guns retracted. The servos are attached
  // one at a time by Update(), in the order rotate Z, rotate X, gun left, gun right.
  void StartBoot();
  // Boot step 12: guns retracted, wings closed unless the Hall sensors say so.
  void Home();
  bool IsHoming();
  bool HasPendingAttach();
  void DetachAll();
  bool HasHallFault() const;
  // L4 (loadtest): attach gap imposed in RAM; 0 = back to ServoStagger.
  void SetStaggerOverride(ulong ms) { staggerOverrideMs = ms; }
  // Speed ramp (setting ServoRamp) on the positional servos (rotations and
  // guns, never the continuous wings): on while the supply is weak (debug
  // mode without "power full"). Called every loop by main.
  void SetRampActive(bool active);
  // v2 Hall rail (lot F2.6), set every loop by main:
  //  - Always: on (debug mode, HallPower "Always");
  //  - WhileMoving: off 2 s after the wings stop; Wing switches it on before a move;
  //  - Off: asleep (switched on again only by a wing move).
  enum class HallPower : uint8_t { Always, WhileMoving, Off };
  void SetHallPower(HallPower mode) { hallPower = mode; }

  // Servo outputs, in attach priority order (plan §3.2 step 11).
  static const uint8_t CHANNEL_COUNT = 6;
  ServoChannel &GetChannel(uint8_t index);
  // Console alias of a channel ("rotz", "rotx", "gunl", "gunr", "wingl",
  // "wingr"), the one list for the commands, the self-test and the status JSON.
  static const char *ChannelAlias(uint8_t index);
  // Index of an alias (any case) or of a digit "0".."5", -1 if unknown.
  static int ChannelIndex(const String &name);

private:
  void RunAttachSchedule(ulong now);
  void ReleaseIdleRotation(ulong now);
  void ApplyRamp();
  void UpdateHallPower(ulong now);

  float X_AXIS_GEAR_RATIO = 75.0 / 17.0;
  float Z_AXIS_GEAR_RATIO = 30.0 / 15.0;
  float ANGLE_OFFSET_X = -3.4;
  float ANGLE_OFFSET_Z = 0;
  ulong servoStaggerMs = 250;
  ulong staggerOverrideMs = 0;
  ulong servoIdleMs = 5000;
  int32_t servoRampUs = 0;
  bool rampActive = false;
  HallPower hallPower = HallPower::Always;
  ulong hallNeededAt = 0;
  ulong lastAttachAt = 0;
  bool attachedOnce = false;

  Wing wingLeft;
  Wing wingRight;
  ServoChannel rotateX;
  ServoChannel rotateZ;
  Settings *settings;
};
