lo26lo/portal-turret-v4/Turret_firmware/test/test_logic/test_main.cpp

// Native tests of the pure logic (improvement D1): run on the computer, no board.
//   pio test -e native
// Needs a host C++ compiler (gcc / g++): present on Linux and in the CI;
// on Windows install MinGW-w64 first.

#include <stdint.h>
#include <stdio.h>
#include <string.h>
#include <unity.h>

#include "control/CommandTable.h"
#include "logic/AudioLogic.h"
#include "logic/BoardLogic.h"
#include "logic/CycleLogic.h"
#include "logic/HallLogic.h"
#include "logic/MenuLogic.h"
#include "logic/RadarLogic.h"
#include "logic/ServoLogic.h"
#include "logic/SleepLogic.h"
#include "ui/MenuTree.h"
#include "web/PageText.h"

void setUp() {}
void tearDown() {}

// ------------------------------------------------------------------ radar

// Formula of the upstream parser (sensors/Radar.cpp before the refactoring).
static int16_t LegacyDecode(uint8_t low, uint8_t high) {
  int16_t value = (int16_t)(low | (high << 8));
  if (high & 0x80) {
    value -= 0x8000;
  } else {
    value = -value;
  }
  return value;
}

void test_decode_examples() {
  TEST_ASSERT_EQUAL_INT16(100, logic::DecodeLd2450(0x64, 0x80));
  TEST_ASSERT_EQUAL_INT16(-100, logic::DecodeLd2450(0x64, 0x00));
  TEST_ASSERT_EQUAL_INT16(0, logic::DecodeLd2450(0x00, 0x80));
  TEST_ASSERT_EQUAL_INT16(32767, logic::DecodeLd2450(0xFF, 0xFF));
  TEST_ASSERT_EQUAL_INT16(-32767, logic::DecodeLd2450(0xFF, 0x7F));
}

void test_decode_matches_upstream_parser() {
  for (uint32_t raw = 0; raw <= 0xFFFF; raw++) {
    uint8_t low = raw & 0xFF;
    uint8_t high = raw >> 8;
    if (logic::DecodeLd2450(low, high) != LegacyDecode(low, high)) {
      TEST_FAIL_MESSAGE("decode differs from the upstream parser");
    }
  }
}

void test_zone() {
  TEST_ASSERT_TRUE(logic::IsInZone(0, 1000, 3000, 45));      // straight ahead
  TEST_ASSERT_FALSE(logic::IsInZone(0, -1000, 3000, 45));    // behind
  TEST_ASSERT_FALSE(logic::IsInZone(0, 0, 3000, 45));        // on the radar
  TEST_ASSERT_FALSE(logic::IsInZone(0, 3100, 3000, 45));     // too far
  TEST_ASSERT_TRUE(logic::IsInZone(2000, 2100, 3000, 45));   // 43.6 deg, 2.9 m
  TEST_ASSERT_FALSE(logic::IsInZone(2100, 2000, 3000, 45));  // 46.4 deg
  TEST_ASSERT_FALSE(logic::IsInZone(-2100, 2000, 3000, 45)); // same on the other side
  TEST_ASSERT_TRUE(logic::IsInZone(-1000, 1000, 3000, 50));  // 45 deg inside 50
}

// ------------------------------------------------------------------ Hall

void test_hall_normal_polarity() {
  // open above 2500, closed below 1500
  TEST_ASSERT_TRUE(logic::HallPastOpen(2600, 2500, 1500));
  TEST_ASSERT_FALSE(logic::HallPastOpen(2000, 2500, 1500));
  TEST_ASSERT_TRUE(logic::HallPastClosed(1400, 2500, 1500));
  TEST_ASSERT_FALSE(logic::HallPastClosed(2000, 2500, 1500));
}

void test_hall_reversed_magnet() {
  // open below 1200, closed above 2800
  TEST_ASSERT_TRUE(logic::HallPastOpen(1100, 1200, 2800));
  TEST_ASSERT_FALSE(logic::HallPastOpen(2000, 1200, 2800));
  TEST_ASSERT_TRUE(logic::HallPastClosed(2900, 1200, 2800));
  TEST_ASSERT_FALSE(logic::HallPastClosed(2000, 1200, 2800));
}

void test_hall_rail() {
  TEST_ASSERT_TRUE(logic::HallAtRail(0));
  TEST_ASSERT_TRUE(logic::HallAtRail(4095));
  TEST_ASSERT_FALSE(logic::HallAtRail(2048));
}

// ------------------------------------------------------------------ buttons

void test_button_short_press() {
  logic::Debouncer button(30, 3000);
  button.Reset(false, 0);
  TEST_ASSERT_TRUE(button.Update(true, 10) == logic::PressEvent::None);
  TEST_ASSERT_TRUE(button.Update(true, 45) == logic::PressEvent::None); // now stable down
  TEST_ASSERT_TRUE(button.IsDown());
  TEST_ASSERT_TRUE(button.Update(false, 200) == logic::PressEvent::None);
  TEST_ASSERT_TRUE(button.Update(false, 235) == logic::PressEvent::ShortPress);
}

void test_button_bounce_ignored() {
  logic::Debouncer button(30, 3000);
  button.Reset(false, 0);
  button.Update(true, 10);
  button.Update(false, 20); // 10 ms spike
  TEST_ASSERT_TRUE(button.Update(false, 100) == logic::PressEvent::None);
  TEST_ASSERT_FALSE(button.IsDown());
}

void test_button_long_press_once() {
  logic::Debouncer button(30, 3000);
  button.Reset(false, 0);
  button.Update(true, 0);
  button.Update(true, 40);
  TEST_ASSERT_TRUE(button.Update(true, 3000) == logic::PressEvent::None);
  TEST_ASSERT_TRUE(button.Update(true, 3050) == logic::PressEvent::LongPress);
  TEST_ASSERT_TRUE(button.Update(true, 5000) == logic::PressEvent::None);
  button.Update(false, 5100);
  TEST_ASSERT_TRUE(button.Update(false, 5200) == logic::PressEvent::None); // no short press after a long one
}

void test_button_held_at_boot() {
  logic::Debouncer button(30, 3000);
  button.Reset(true, 0); // A + B at power-up: not an event
  TEST_ASSERT_TRUE(button.Update(true, 5000) == logic::PressEvent::None);
  button.Update(false, 5100);
  TEST_ASSERT_TRUE(button.Update(false, 5200) == logic::PressEvent::None);
}

// ------------------------------------------------------------------ board

void test_lowest_fault() {
  TEST_ASSERT_EQUAL_UINT8(0, logic::LowestFault(0));
  TEST_ASSERT_EQUAL_UINT8(1, logic::LowestFault(0x01));
  TEST_ASSERT_EQUAL_UINT8(3, logic::LowestFault(0x24)); // faults 3 and 6
  TEST_ASSERT_EQUAL_UINT8(6, logic::LowestFault(0x20));
}

void test_breath_level() {
  TEST_ASSERT_EQUAL_UINT8(0, logic::BreathLevel(0, 4000));      // off
  TEST_ASSERT_EQUAL_UINT8(64, logic::BreathLevel(1000, 4000));  // quarter: half of the cosine, squared
  TEST_ASSERT_EQUAL_UINT8(255, logic::BreathLevel(2000, 4000)); // full
  TEST_ASSERT_EQUAL_UINT8(64, logic::BreathLevel(3000, 4000));  // same way down
  TEST_ASSERT_EQUAL_UINT8(0, logic::BreathLevel(4000, 4000));   // next period
  TEST_ASSERT_EQUAL_UINT8(255, logic::BreathLevel(1000, 2000)); // faster breath: full at 1 s
  // Smooth: rises without a step back, at most a few levels per 10 ms (one loop).
  uint8_t previous = 0;
  for (uint32_t t = 10; t <= 2000; t += 10) {
    uint8_t level = logic::BreathLevel(t, 4000);
    TEST_ASSERT_TRUE(level >= previous);
    TEST_ASSERT_TRUE(level - previous <= 4);
    previous = level;
  }
  TEST_ASSERT_EQUAL_UINT8(0, logic::BreathLevel(4294964000u, 4000));   // 4000 * 1073741: still in phase
  TEST_ASSERT_EQUAL_UINT8(255, logic::BreathLevel(4294966000u, 4000)); // 2000 ms into that period
  TEST_ASSERT_EQUAL_UINT8(255, logic::BreathLevel(200, 0));            // period 0 read as 400 ms
}

void test_heartbeat() {
  TEST_ASSERT_TRUE(logic::HeartbeatOn(0, 1200)); // first beat
  TEST_ASSERT_TRUE(logic::HeartbeatOn(99, 1200));
  TEST_ASSERT_FALSE(logic::HeartbeatOn(100, 1200)); // gap
  TEST_ASSERT_FALSE(logic::HeartbeatOn(249, 1200));
  TEST_ASSERT_TRUE(logic::HeartbeatOn(250, 1200)); // second beat
  TEST_ASSERT_TRUE(logic::HeartbeatOn(349, 1200));
  TEST_ASSERT_FALSE(logic::HeartbeatOn(350, 1200)); // rest
  TEST_ASSERT_FALSE(logic::HeartbeatOn(1199, 1200));
  TEST_ASSERT_TRUE(logic::HeartbeatOn(1200, 1200));  // next period
  TEST_ASSERT_FALSE(logic::HeartbeatOn(3999, 4000)); // a longer rest with a longer period
  TEST_ASSERT_TRUE(logic::HeartbeatOn(4000, 4000));
  TEST_ASSERT_TRUE(logic::HeartbeatOn(400, 100)); // period below 350 ms read as 400 ms
}

void test_green_led_level() {
  using M = logic::GreenLedMode;
  TEST_ASSERT_EQUAL_UINT8(255, logic::ScaleLevel(255, 100));
  TEST_ASSERT_EQUAL_UINT8(128, logic::ScaleLevel(255, 50));
  TEST_ASSERT_EQUAL_UINT8(0, logic::ScaleLevel(1, 1));
  TEST_ASSERT_EQUAL_UINT8(255, logic::ScaleLevel(255, 200)); // above 100 % read as 100 %
  TEST_ASSERT_EQUAL_UINT8(255, logic::GreenLedLevel(M::Breathing, 2000, 4000, 100));
  TEST_ASSERT_EQUAL_UINT8(128, logic::GreenLedLevel(M::Breathing, 2000, 4000, 50));
  TEST_ASSERT_EQUAL_UINT8(255, logic::GreenLedLevel(M::Heartbeat, 50, 1200, 100));
  TEST_ASSERT_EQUAL_UINT8(0, logic::GreenLedLevel(M::Heartbeat, 500, 1200, 100));
  TEST_ASSERT_EQUAL_UINT8(77, logic::GreenLedLevel(M::Steady, 123, 4000, 30));
  TEST_ASSERT_EQUAL_UINT8(0, logic::GreenLedLevel(M::Off, 2000, 4000, 100));
}

// ------------------------------------------------------------------ audio

// Pulls every output sample of the loaded block into out; returns the count.
static size_t Drain(logic::Upsampler &up, int16_t *out, size_t room) {
  size_t n = 0;
  int16_t sample;
  while (n < room && up.Next(sample)) {
    out[n++] = sample;
  }
  return n;
}

void test_upsampler() {
  logic::Upsampler up;
  int16_t out[8];
  int16_t sample;
  TEST_ASSERT_FALSE(up.Next(sample)); // nothing loaded
  int16_t in[3] = {100, 300, -100};
  up.Load(in, 3, 2);
  TEST_ASSERT_EQUAL_UINT32(6, Drain(up, out, 8));
  // Starts from 0, then halfway points between consecutive samples.
  int16_t expected[6] = {50, 100, 200, 300, 100, -100};
  TEST_ASSERT_EQUAL_INT16_ARRAY(expected, out, 6);
  TEST_ASSERT_FALSE(up.Next(sample));
  // The next frame continues from the last sample (-100): no click at the join.
  int16_t next[1] = {-300};
  up.Load(next, 1, 2);
  TEST_ASSERT_EQUAL_UINT32(2, Drain(up, out, 8));
  TEST_ASSERT_EQUAL_INT16(-200, out[0]);
  TEST_ASSERT_EQUAL_INT16(-300, out[1]);
  // Stopping in the middle of a sample's outputs resumes where it was.
  up.Reset();
  up.Load(in, 3, 2);
  TEST_ASSERT_EQUAL_UINT32(3, Drain(up, out, 3));
  TEST_ASSERT_EQUAL_UINT32(3, Drain(up, out + 3, 8));
  TEST_ASSERT_EQUAL_INT16_ARRAY(expected, out, 6);
  // Factor 1 copies; factor 0 counts as 1.
  up.Reset();
  up.Load(in, 3, 1);
  TEST_ASSERT_EQUAL_UINT32(3, Drain(up, out, 8));
  TEST_ASSERT_EQUAL_INT16(300, out[1]);
  up.Load(in, 3, 0);
  TEST_ASSERT_EQUAL_UINT32(3, Drain(up, out, 8));
  // Full scale does not overflow.
  up.Reset();
  int16_t loud[2] = {32767, -32768};
  up.Load(loud, 2, 2);
  Drain(up, out, 8);
  TEST_ASSERT_EQUAL_INT16(32767, out[1]);
  TEST_ASSERT_EQUAL_INT16(-32768, out[3]);
  TEST_ASSERT_EQUAL_INT16(0, out[2]); // halfway between the two
}

void test_pick_voice_file() {
  TEST_ASSERT_EQUAL_INT(-1, logic::PickVoiceFile(0, -1, 5));
  TEST_ASSERT_EQUAL_INT(0, logic::PickVoiceFile(1, 0, 7));  // no choice: repeats
  TEST_ASSERT_EQUAL_INT(2, logic::PickVoiceFile(4, -1, 6)); // first time: any
  // Never the last one again, and every other one is reachable.
  bool seen[5] = {};
  for (uint32_t r = 0; r < 20; r++) {
    int pick = logic::PickVoiceFile(5, 2, r);
    TEST_ASSERT_NOT_EQUAL(2, pick);
    TEST_ASSERT_TRUE(pick >= 0 && pick < 5);
    seen[pick] = true;
  }
  TEST_ASSERT_TRUE(seen[0] && seen[1] && seen[3] && seen[4]);
  // A stale `last` (fewer files now) is ignored.
  TEST_ASSERT_EQUAL_INT(1, logic::PickVoiceFile(3, 9, 4));
}

void test_id3v2_size() {
  // Tag of the voice files: ID3v2.4, size 0x00 0x00 0x01 0x40 = 192, + 10 header.
  const uint8_t tag[10] = {'I', 'D', '3', 4, 0, 0, 0, 0, 0x01, 0x40};
  TEST_ASSERT_EQUAL_UINT32(202, logic::Id3v2Size(tag, 10));
  // Footer flag adds 10 bytes; 7-bit "syncsafe" digits.
  const uint8_t footer[10] = {'I', 'D', '3', 4, 0, 0x10, 0, 0, 0x02, 0x00};
  TEST_ASSERT_EQUAL_UINT32(10 + 256 + 10, logic::Id3v2Size(footer, 10));
  // An MP3 frame header, a short read or a bad size byte: no tag.
  const uint8_t frame[10] = {0xFF, 0xF3, 0x64, 0xC4, 0, 0, 0, 0, 0, 0};
  TEST_ASSERT_EQUAL_UINT32(0, logic::Id3v2Size(frame, 10));
  TEST_ASSERT_EQUAL_UINT32(0, logic::Id3v2Size(tag, 9));
  const uint8_t bad[10] = {'I', 'D', '3', 4, 0, 0, 0, 0x80, 0, 0};
  TEST_ASSERT_EQUAL_UINT32(0, logic::Id3v2Size(bad, 10));
}

void test_upsample_factor() {
  TEST_ASSERT_EQUAL_UINT8(2, logic::UpsampleFactor(22050, 44100)); // voice files
  TEST_ASSERT_EQUAL_UINT8(1, logic::UpsampleFactor(44100, 44100)); // fire.mp3
  TEST_ASSERT_EQUAL_UINT8(4, logic::UpsampleFactor(11025, 44100));
  TEST_ASSERT_EQUAL_UINT8(1, logic::UpsampleFactor(0, 44100));    // unknown yet
  TEST_ASSERT_EQUAL_UINT8(8, logic::UpsampleFactor(1000, 44100)); // capped
}

void test_tip_watch() {
  logic::TipWatch w;
  // Not checkable: never fires.
  TEST_ASSERT_FALSE(w.Update(false, false, 0));
  // Tipped from the start (never upright long enough): no voice.
  TEST_ASSERT_FALSE(w.Update(true, false, 100));
  TEST_ASSERT_FALSE(w.Update(true, false, 5000));
  // Upright for 2 s arms it.
  TEST_ASSERT_FALSE(w.Update(true, true, 6000));
  TEST_ASSERT_FALSE(w.Update(true, true, 8000));
  // A short wobble (< 500 ms) is ignored.
  TEST_ASSERT_FALSE(w.Update(true, false, 8100));
  TEST_ASSERT_FALSE(w.Update(true, true, 8400));
  // A real fall: fires once after 500 ms, then stays quiet.
  TEST_ASSERT_FALSE(w.Update(true, false, 9000));
  TEST_ASSERT_TRUE(w.Update(true, false, 9500));
  TEST_ASSERT_FALSE(w.Update(true, false, 9600));
  TEST_ASSERT_FALSE(w.Update(true, false, 20000));
  // Put back upright for 2 s re-arms it.
  TEST_ASSERT_FALSE(w.Update(true, true, 21000));
  TEST_ASSERT_FALSE(w.Update(true, true, 23000));
  TEST_ASSERT_FALSE(w.Update(true, false, 23100));
  TEST_ASSERT_TRUE(w.Update(true, false, 23600));
  // The check becoming impossible disarms it.
  TEST_ASSERT_FALSE(w.Update(true, true, 30000));
  TEST_ASSERT_FALSE(w.Update(true, true, 32000));
  TEST_ASSERT_FALSE(w.Update(false, false, 32100));
  TEST_ASSERT_FALSE(w.Update(true, false, 33000));
  TEST_ASSERT_FALSE(w.Update(true, false, 34000));
}

void test_reset_gesture() {
  using S = logic::ResetGesture::State;
  logic::ResetGesture g;
  // PROG seen low before any release (stuck pin, or held since the boot): ignored.
  TEST_ASSERT_TRUE(g.Update(true, true, 0) == S::Idle);
  TEST_ASSERT_TRUE(g.Update(true, true, 6000) == S::Idle);
  // Released once: a hold with SW1 closed counts.
  TEST_ASSERT_TRUE(g.Update(true, false, 7000) == S::Idle);
  TEST_ASSERT_TRUE(g.Update(true, true, 8000) == S::Holding);
  TEST_ASSERT_EQUAL_UINT32(2000, g.RemainingMs(11000));
  // Released before the end: cancelled, and the next hold starts from zero.
  TEST_ASSERT_TRUE(g.Update(true, false, 12000) == S::Idle);
  TEST_ASSERT_TRUE(g.Update(true, true, 13000) == S::Holding);
  TEST_ASSERT_TRUE(g.Update(true, true, 17999) == S::Holding);
  // SW1 opened while holding: cancelled too.
  TEST_ASSERT_TRUE(g.Update(false, true, 18000) == S::Idle);
  // SW1 open: PROG alone does nothing.
  TEST_ASSERT_TRUE(g.Update(false, false, 19000) == S::Idle);
  TEST_ASSERT_TRUE(g.Update(false, true, 30000) == S::Idle);
  // A full 5 s hold: accepted, and it stays accepted (the board restarts).
  TEST_ASSERT_TRUE(g.Update(true, false, 31000) == S::Idle);
  TEST_ASSERT_TRUE(g.Update(true, true, 32000) == S::Holding);
  TEST_ASSERT_TRUE(g.Update(true, true, 37000) == S::Accepted);
  TEST_ASSERT_TRUE(g.Update(false, false, 38000) == S::Accepted);
  TEST_ASSERT_EQUAL_UINT32(0, g.RemainingMs(38000));
}

void test_servo_ramp() {
  // No ramp: straight to the target.
  TEST_ASSERT_EQUAL_INT(2400, logic::RampStep(500, 2400, 0, 20));
  TEST_ASSERT_EQUAL_INT(2400, logic::RampStep(500, 2400, -5, 20));
  // 1000 us/s, 20 ms: 20 us per step, both directions, no overshoot.
  TEST_ASSERT_EQUAL_INT(1470, logic::RampStep(1450, 2400, 1000, 20));
  TEST_ASSERT_EQUAL_INT(1430, logic::RampStep(1450, 500, 1000, 20));
  TEST_ASSERT_EQUAL_INT(1455, logic::RampStep(1450, 1455, 1000, 20));
  TEST_ASSERT_EQUAL_INT(1445, logic::RampStep(1450, 1445, 1000, 20));
  TEST_ASSERT_EQUAL_INT(1450, logic::RampStep(1450, 1450, 1000, 20));
  // A late loop takes a bigger step (the speed is kept, not the step).
  TEST_ASSERT_EQUAL_INT(1550, logic::RampStep(1450, 2400, 1000, 100));
  // Very slow ramp: at least 1 us per step, so it always ends.
  TEST_ASSERT_EQUAL_INT(1451, logic::RampStep(1450, 2400, 10, 20));
  // Full travel 500 -> 2400 at 1000 us/s in 20 ms steps: 95 steps (1.9 s).
  int us = 500;
  int steps = 0;
  while (us != 2400 && steps < 1000) {
    int next = logic::RampStep(us, 2400, 1000, 20);
    TEST_ASSERT_TRUE(next > us && next - us <= 20);
    us = next;
    steps++;
  }
  TEST_ASSERT_EQUAL_INT(95, steps);
  // Large elapsed times do not overflow.
  TEST_ASSERT_EQUAL_INT(2400, logic::RampStep(500, 2400, 20000, 4000000000u));
}

void test_sleep_night_window() {
  // Same day.
  TEST_ASSERT_TRUE(logic::InNightWindow(2, 1, 6));
  TEST_ASSERT_FALSE(logic::InNightWindow(6, 1, 6)); // end excluded
  TEST_ASSERT_FALSE(logic::InNightWindow(0, 1, 6));
  // Across midnight.
  TEST_ASSERT_TRUE(logic::InNightWindow(23, 23, 7));
  TEST_ASSERT_TRUE(logic::InNightWindow(0, 23, 7));
  TEST_ASSERT_TRUE(logic::InNightWindow(6, 23, 7));
  TEST_ASSERT_FALSE(logic::InNightWindow(7, 23, 7));
  TEST_ASSERT_FALSE(logic::InNightWindow(12, 23, 7));
  // No night, or no clock.
  TEST_ASSERT_FALSE(logic::InNightWindow(3, 5, 5));
  TEST_ASSERT_FALSE(logic::InNightWindow(-1, 23, 7));
  // Seconds to the next hour:00.
  TEST_ASSERT_EQUAL_UINT32(3600, logic::SecondsUntilHour(6 * 3600, 7));
  TEST_ASSERT_EQUAL_UINT32(8 * 3600, logic::SecondsUntilHour(23 * 3600, 7)); // across midnight
  TEST_ASSERT_EQUAL_UINT32(86400, logic::SecondsUntilHour(7 * 3600, 7));     // exactly now: tomorrow
}

void test_sleep_levels() {
  using L = logic::SleepLevel;
  logic::SleepInputs in;
  in.mode = logic::SleepMode::RadarThenDeep;
  in.radarSleepAfterMs = 600000;
  in.deepSleepAfterMs = 3600000;
  in.deepAllowed = true;
  // Awake until the idle delay, then the radar sleep first.
  in.idleMs = 599999;
  TEST_ASSERT_TRUE(logic::WantedSleepLevel(in, L::Awake) == L::Awake);
  in.idleMs = 600000;
  TEST_ASSERT_TRUE(logic::WantedSleepLevel(in, L::Awake) == L::Radar);
  // Deep after DeepSleepMin of radar sleep, at once at night.
  in.inRadarSleepMs = 3599999;
  TEST_ASSERT_TRUE(logic::WantedSleepLevel(in, L::Radar) == L::Radar);
  in.inRadarSleepMs = 3600000;
  TEST_ASSERT_TRUE(logic::WantedSleepLevel(in, L::Radar) == L::Deep);
  in.inRadarSleepMs = 0;
  in.night = true;
  TEST_ASSERT_TRUE(logic::WantedSleepLevel(in, L::Radar) == L::Deep);
  // Never deep when not allowed (v0.1, debug mode) or in RadarOnly.
  in.deepAllowed = false;
  TEST_ASSERT_TRUE(logic::WantedSleepLevel(in, L::Radar) == L::Radar);
  in.deepAllowed = true;
  in.mode = logic::SleepMode::RadarOnly;
  TEST_ASSERT_TRUE(logic::WantedSleepLevel(in, L::Radar) == L::Radar);
  // 0 = never on its own.
  in.mode = logic::SleepMode::RadarThenDeep;
  in.night = false;
  in.deepSleepAfterMs = 0;
  in.inRadarSleepMs = 100000000;
  TEST_ASSERT_TRUE(logic::WantedSleepLevel(in, L::Radar) == L::Radar);
  in.radarSleepAfterMs = 0;
  in.idleMs = 100000000;
  TEST_ASSERT_TRUE(logic::WantedSleepLevel(in, L::Awake) == L::Awake);
  // Never: always awake.
  in.mode = logic::SleepMode::Never;
  TEST_ASSERT_TRUE(logic::WantedSleepLevel(in, L::Radar) == L::Awake);
  // IMU thresholds: more sensitive = lower.
  TEST_ASSERT_TRUE(logic::ImuWakeThreshold(2) < logic::ImuWakeThreshold(1));
  TEST_ASSERT_TRUE(logic::ImuWakeThreshold(1) < logic::ImuWakeThreshold(0));
  TEST_ASSERT_TRUE(logic::ImuWakeThreshold(0) < 64);
}

void test_amp_gain_rounding() {
  TEST_ASSERT_EQUAL_INT32(9, logic::RoundAmpGain(0));
  TEST_ASSERT_EQUAL_INT32(9, logic::RoundAmpGain(10));
  TEST_ASSERT_EQUAL_INT32(12, logic::RoundAmpGain(11));
  TEST_ASSERT_EQUAL_INT32(12, logic::RoundAmpGain(13));
  TEST_ASSERT_EQUAL_INT32(15, logic::RoundAmpGain(14));
  TEST_ASSERT_EQUAL_INT32(15, logic::RoundAmpGain(40));
}

// ------------------------------------------------------------------ debug menu

static char lastCommand[64];
static int commandCount;
static int32_t startValue;

static void FakeExecute(void *, const char *command, char *answer, size_t size) {
  strncpy(lastCommand, command, sizeof(lastCommand) - 1);
  commandCount++;
  snprintf(answer, size, "ok %s\nsecond line", command);
}
static int32_t FakeValue(void *, const char *) {
  return startValue;
}
static void FakeInfo(void *, int16_t page, uint8_t line, logic::Lang, char *text, size_t size) {
  snprintf(text, size, "p%d l%d", page, line);
}

#define T_ITEM(en, fr, kind, parent, command, save, key, page, min, max, step)                                         \
  {en, fr, logic::ItemKind::kind, parent, command, save, key, page, min, max, step}
static const logic::MenuItem TEST_TREE[] = {
    T_ITEM("Root", "Racine", Menu, -1, nullptr, nullptr, nullptr, 0, 0, 0, 0),
    T_ITEM("Ping", "Ping", Command, 0, "ping", nullptr, nullptr, 0, 0, 0, 0),
    T_ITEM("Reset", "RAZ", Confirm, 0, "reset", nullptr, nullptr, 0, 0, 0, 0),
    T_ITEM("Info A", "Info A", Info, 0, nullptr, nullptr, nullptr, 0, 0, 0, 0),
    T_ITEM("Info B", "Info B", Info, 0, nullptr, nullptr, nullptr, 1, 0, 0, 0),
    T_ITEM("Vol", "Vol", Adjust, 0, "vol %d", "save %d", "v", 0, 0, 100, 10),
    T_ITEM("Sub", "Sous", Menu, 0, nullptr, nullptr, nullptr, 0, 0, 0, 0),
    T_ITEM("Deep", "Fond", Command, 6, "deep", nullptr, nullptr, 0, 0, 0, 0),
};

static logic::MenuNav MakeNav() {
  lastCommand[0] = '\0';
  commandCount = 0;
  startValue = 50;
  logic::MenuHooks hooks = {nullptr, FakeExecute, FakeValue, FakeInfo};
  return logic::MenuNav(TEST_TREE, 8, hooks);
}

static void Press(logic::MenuNav &nav, logic::MenuKey key, int times = 1) {
  for (int i = 0; i < times; i++) {
    nav.Key(key, 1000);
  }
}

void test_menu_render_root() {
  logic::MenuNav nav = MakeNav();
  logic::MenuScreen screen;
  nav.Render(screen, logic::Lang::French, 0);
  TEST_ASSERT_EQUAL_STRING("Racine", screen.line[0]);
  TEST_ASSERT_EQUAL_STRING("Ping", screen.line[1]);
  TEST_ASSERT_EQUAL_INT8(1, screen.highlight);
  // No key yet: hints in the words of the knob (the v2 has no buttons A / B).
  TEST_ASSERT_EQUAL_STRING("Tourner  Appui:ok", screen.line[5]);
  nav.Render(screen, logic::Lang::English, 0);
  TEST_ASSERT_EQUAL_STRING("Root", screen.line[0]);
  TEST_ASSERT_EQUAL_STRING("Turn  Push:ok", screen.line[5]);
  // After an A / B key (v0.1 buttons, console): A / B hints.
  Press(nav, logic::MenuKey::A);
  Press(nav, logic::MenuKey::ALong);
  nav.Render(screen, logic::Lang::English, 0);
  TEST_ASSERT_EQUAL_STRING("A:next  B:ok", screen.line[5]);
}

void test_menu_next_previous_wrap_and_scroll() {
  logic::MenuNav nav = MakeNav();
  logic::MenuScreen screen;
  Press(nav, logic::MenuKey::ALong); // from the first entry back to the last
  TEST_ASSERT_EQUAL_INT16(6, nav.GetSelected());
  nav.Render(screen, logic::Lang::English, 0);
  // Six entries, four lines: the window scrolled, the cursor is on the last line.
  TEST_ASSERT_EQUAL_STRING("Sub >", screen.line[4]);
  TEST_ASSERT_EQUAL_INT8(4, screen.highlight);
  Press(nav, logic::MenuKey::A); // wraps to the first
  TEST_ASSERT_EQUAL_INT16(1, nav.GetSelected());
}

void test_menu_command_and_answer() {
  logic::MenuNav nav = MakeNav();
  logic::MenuScreen screen;
  Press(nav, logic::MenuKey::B);
  TEST_ASSERT_EQUAL_STRING("ping", lastCommand);
  nav.Render(screen, logic::Lang::English, 1500);
  TEST_ASSERT_EQUAL_STRING("ok ping", screen.line[5]); // first line of the answer only
  nav.Render(screen, logic::Lang::English, 5000);
  TEST_ASSERT_EQUAL_STRING("A:next  B:ok", screen.line[5]); // the answer expires after 3 s
}

void test_menu_confirm() {
  logic::MenuNav nav = MakeNav();
  Press(nav, logic::MenuKey::A);
  Press(nav, logic::MenuKey::B);
  TEST_ASSERT_TRUE(nav.GetMode() == logic::MenuNav::Mode::Confirm);
  TEST_ASSERT_EQUAL_INT(0, commandCount);
  Press(nav, logic::MenuKey::A); // cancel
  TEST_ASSERT_TRUE(nav.GetMode() == logic::MenuNav::Mode::Browse);
  TEST_ASSERT_EQUAL_INT(0, commandCount);
  Press(nav, logic::MenuKey::B, 2); // ask again, confirm
  TEST_ASSERT_EQUAL_STRING("reset", lastCommand);
  TEST_ASSERT_EQUAL_INT(1, commandCount);
}

void test_menu_info_pages() {
  logic::MenuNav nav = MakeNav();
  logic::MenuScreen screen;
  Press(nav, logic::MenuKey::A, 2);
  Press(nav, logic::MenuKey::B);
  TEST_ASSERT_TRUE(nav.GetMode() == logic::MenuNav::Mode::Info);
  nav.Render(screen, logic::Lang::English, 0);
  TEST_ASSERT_EQUAL_STRING("Info A", screen.line[0]);
  TEST_ASSERT_EQUAL_STRING("p0 l0", screen.line[1]);
  TEST_ASSERT_EQUAL_STRING("p0 l3", screen.line[4]);
  Press(nav, logic::MenuKey::A); // next page
  nav.Render(screen, logic::Lang::English, 0);
  TEST_ASSERT_EQUAL_STRING("p1 l0", screen.line[1]);
  Press(nav, logic::MenuKey::A); // wraps to the first page, skipping the other kinds
  nav.Render(screen, logic::Lang::English, 0);
  TEST_ASSERT_EQUAL_STRING("p0 l0", screen.line[1]);
  Press(nav, logic::MenuKey::B);
  TEST_ASSERT_TRUE(nav.GetMode() == logic::MenuNav::Mode::Browse);
}

void test_menu_adjust() {
  logic::MenuNav nav = MakeNav();
  Press(nav, logic::MenuKey::A, 4);
  Press(nav, logic::MenuKey::B);
  TEST_ASSERT_TRUE(nav.GetMode() == logic::MenuNav::Mode::Adjust);
  TEST_ASSERT_EQUAL_INT32(50, nav.GetValue());
  Press(nav, logic::MenuKey::B);
  TEST_ASSERT_EQUAL_STRING("vol 60", lastCommand);
  Press(nav, logic::MenuKey::A, 2);
  TEST_ASSERT_EQUAL_STRING("vol 40", lastCommand);
  Press(nav, logic::MenuKey::B, 10); // clamped at the maximum
  TEST_ASSERT_EQUAL_INT32(100, nav.GetValue());
  Press(nav, logic::MenuKey::BLong); // save and leave
  TEST_ASSERT_EQUAL_STRING("save 100", lastCommand);
  TEST_ASSERT_TRUE(nav.GetMode() == logic::MenuNav::Mode::Browse);

  Press(nav, logic::MenuKey::B); // in again
  int before = commandCount;
  Press(nav, logic::MenuKey::ALong); // leave without saving
  TEST_ASSERT_EQUAL_INT(before, commandCount);
  TEST_ASSERT_TRUE(nav.GetMode() == logic::MenuNav::Mode::Browse);
}

void test_menu_submenu_and_back() {
  logic::MenuNav nav = MakeNav();
  logic::MenuScreen screen;
  Press(nav, logic::MenuKey::BLong); // at the root: nothing happens
  TEST_ASSERT_EQUAL_INT16(0, nav.GetMenu());
  Press(nav, logic::MenuKey::ALong);
  Press(nav, logic::MenuKey::B);
  TEST_ASSERT_EQUAL_INT16(6, nav.GetMenu());
  nav.Render(screen, logic::Lang::French, 0);
  TEST_ASSERT_EQUAL_STRING("Sous", screen.line[0]);
  TEST_ASSERT_EQUAL_STRING("Fond", screen.line[1]);
  Press(nav, logic::MenuKey::BLong);
  TEST_ASSERT_EQUAL_INT16(0, nav.GetMenu());
  TEST_ASSERT_EQUAL_INT16(6, nav.GetSelected()); // back on the entry we came from
}

void test_hall_percent() {
  // normal polarity: closed at 1500, open at 2500
  TEST_ASSERT_EQUAL_UINT8(0, logic::HallPercent(1500, 2500, 1500));
  TEST_ASSERT_EQUAL_UINT8(50, logic::HallPercent(2000, 2500, 1500));
  TEST_ASSERT_EQUAL_UINT8(100, logic::HallPercent(2500, 2500, 1500));
  TEST_ASSERT_EQUAL_UINT8(0, logic::HallPercent(900, 2500, 1500));    // clamped
  TEST_ASSERT_EQUAL_UINT8(100, logic::HallPercent(4000, 2500, 1500)); // clamped
  // reversed magnet: closed at 2800, open at 1200
  TEST_ASSERT_EQUAL_UINT8(0, logic::HallPercent(2800, 1200, 2800));
  TEST_ASSERT_EQUAL_UINT8(50, logic::HallPercent(2000, 1200, 2800));
  TEST_ASSERT_EQUAL_UINT8(100, logic::HallPercent(1200, 1200, 2800));
  // identical thresholds must not divide by zero
  TEST_ASSERT_EQUAL_UINT8(0, logic::HallPercent(2000, 2000, 2000));
}

void test_menu_encoder() {
  using K = logic::MenuKey;
  using M = logic::MenuNav::Mode;
  logic::MenuNav nav = MakeNav();
  logic::MenuScreen screen;

  // Browse: turning moves the cursor; the hints follow the last control used.
  Press(nav, K::Clockwise, 2);
  TEST_ASSERT_EQUAL_INT16(3, nav.GetSelected()); // Info A
  Press(nav, K::Anticlockwise);
  TEST_ASSERT_EQUAL_INT16(2, nav.GetSelected()); // Reset
  nav.Render(screen, logic::Lang::French, 0);
  TEST_ASSERT_EQUAL_STRING("Tourner  Appui:ok", screen.line[5]);
  Press(nav, K::A);
  Press(nav, K::ALong);
  nav.Render(screen, logic::Lang::French, 0);
  TEST_ASSERT_EQUAL_STRING("A:suiv  B:ok", screen.line[5]);

  // Confirm: turning does nothing, push held cancels, push confirms.
  Press(nav, K::Push);
  TEST_ASSERT_TRUE(nav.GetMode() == M::Confirm);
  nav.Render(screen, logic::Lang::English, 0);
  TEST_ASSERT_EQUAL_STRING("Push:yes  hold:no", screen.line[5]);
  Press(nav, K::Clockwise, 3);
  TEST_ASSERT_TRUE(nav.GetMode() == M::Confirm);
  TEST_ASSERT_EQUAL_INT(0, commandCount);
  Press(nav, K::PushLong);
  TEST_ASSERT_TRUE(nav.GetMode() == M::Browse);
  TEST_ASSERT_EQUAL_INT(0, commandCount);
  Press(nav, K::Push, 2);
  TEST_ASSERT_EQUAL_STRING("reset", lastCommand);

  // Adjust: turning = value -/+, push = save and leave, push held = leave without saving.
  Press(nav, K::Clockwise, 3);
  TEST_ASSERT_EQUAL_INT16(5, nav.GetSelected()); // Vol
  Press(nav, K::Push);
  TEST_ASSERT_TRUE(nav.GetMode() == M::Adjust);
  Press(nav, K::Clockwise);
  TEST_ASSERT_EQUAL_INT32(60, nav.GetValue());
  TEST_ASSERT_EQUAL_STRING("vol 60", lastCommand);
  Press(nav, K::Anticlockwise, 2);
  TEST_ASSERT_EQUAL_INT32(40, nav.GetValue());
  nav.Render(screen, logic::Lang::French, 1000);
  TEST_ASSERT_EQUAL_STRING("Tour:± Appui:sauve", screen.line[5]);
  Press(nav, K::Push);
  TEST_ASSERT_TRUE(nav.GetMode() == M::Browse);
  TEST_ASSERT_EQUAL_STRING("save 40", lastCommand);
  Press(nav, K::Push);
  Press(nav, K::Clockwise);
  Press(nav, K::PushLong);
  TEST_ASSERT_TRUE(nav.GetMode() == M::Browse);
  TEST_ASSERT_EQUAL_STRING("vol 60", lastCommand); // not saved

  // Info: turning changes the page, push goes back.
  Press(nav, K::Anticlockwise, 2);
  Press(nav, K::Push);
  TEST_ASSERT_TRUE(nav.GetMode() == M::Info);
  Press(nav, K::Clockwise);
  TEST_ASSERT_EQUAL_INT16(4, nav.GetSelected()); // Info B
  nav.Render(screen, logic::Lang::French, 0);
  TEST_ASSERT_EQUAL_STRING("p1 l0", screen.line[1]);
  TEST_ASSERT_EQUAL_STRING("Tour:page Appui:fin", screen.line[5]);
  Press(nav, K::Push);
  TEST_ASSERT_TRUE(nav.GetMode() == M::Browse);

  // Sub-menu: push enters, push held goes back to the parent.
  Press(nav, K::Clockwise, 2);
  Press(nav, K::Push);
  TEST_ASSERT_EQUAL_INT16(6, nav.GetMenu());
  Press(nav, K::PushLong);
  TEST_ASSERT_EQUAL_INT16(0, nav.GetMenu());
  TEST_ASSERT_EQUAL_INT16(6, nav.GetSelected());
}

void test_factory_reset_screen() {
  logic::MenuScreen screen;
  logic::RenderFactoryReset(screen, logic::Lang::French, false, 4200);
  TEST_ASSERT_EQUAL_STRING("Réglages d'usine", screen.line[0]);
  TEST_ASSERT_EQUAL_STRING("dans 5 s", screen.line[2]); // rounded up
  TEST_ASSERT_EQUAL_STRING("Lâcher PROG annule", screen.line[4]);
  logic::RenderFactoryReset(screen, logic::Lang::English, false, 1);
  TEST_ASSERT_EQUAL_STRING("in 1 s", screen.line[2]);
  logic::RenderFactoryReset(screen, logic::Lang::English, true, 0);
  TEST_ASSERT_EQUAL_STRING("Everything erased", screen.line[2]);
  TEST_ASSERT_EQUAL_STRING("Restarting...", screen.line[3]);
  TEST_ASSERT_EQUAL_STRING("", screen.line[4]);
}

void test_volume_screen() {
  logic::MenuScreen screen;
  logic::RenderVolume(screen, logic::Lang::French, 80, false);
  TEST_ASSERT_EQUAL_STRING("Volume", screen.line[0]);
  TEST_ASSERT_EQUAL_STRING("################....", screen.line[2]);
  TEST_ASSERT_EQUAL_STRING("80 %", screen.line[3]);
  logic::RenderVolume(screen, logic::Lang::French, 0, true);
  TEST_ASSERT_EQUAL_STRING("....................", screen.line[2]);
  TEST_ASSERT_EQUAL_STRING("0 %  (muet)", screen.line[3]);
  logic::RenderVolume(screen, logic::Lang::English, 150, true); // out of range
  TEST_ASSERT_EQUAL_STRING("####################", screen.line[2]);
  TEST_ASSERT_EQUAL_STRING("100 %  (muted)", screen.line[3]);
}

void test_fault_alert() {
  const uint8_t radar = 1u << 3, imu = 1u << 2;
  logic::FaultAlert alert;
  TEST_ASSERT_FALSE(alert.Update(0, 0));

  // A new fault: shown for 5 s, then the screen goes on.
  TEST_ASSERT_TRUE(alert.Update(radar, 1000));
  TEST_ASSERT_TRUE(alert.JustStarted());
  TEST_ASSERT_TRUE(alert.Update(radar, 5999));
  TEST_ASSERT_FALSE(alert.JustStarted());
  TEST_ASSERT_FALSE(alert.Update(radar, 6000));
  TEST_ASSERT_FALSE(alert.Update(radar, 60000)); // still active, already announced

  // A second fault starts a new alert; a key press closes it early.
  TEST_ASSERT_TRUE(alert.Update(radar | imu, 61000));
  alert.Dismiss();
  TEST_ASSERT_FALSE(alert.Update(radar | imu, 61100));

  // A fault that clears and comes back is announced again.
  TEST_ASSERT_FALSE(alert.Update(imu, 62000));
  TEST_ASSERT_TRUE(alert.Update(radar | imu, 63000));
  // All faults gone: the alert ends at once.
  TEST_ASSERT_FALSE(alert.Update(0, 63500));

  // Counter wrap-around (millis() after 49 days).
  logic::FaultAlert late;
  TEST_ASSERT_TRUE(late.Update(radar, 0xFFFFF000u));
  TEST_ASSERT_TRUE(late.Update(radar, 0x00000100u));
  TEST_ASSERT_FALSE(late.Update(radar, 0x00000400u));

  logic::MenuScreen screen;
  logic::RenderFaultAlert(screen, logic::Lang::French, radar);
  TEST_ASSERT_EQUAL_STRING("! Défaut", screen.line[0]);
  TEST_ASSERT_EQUAL_STRING("4 Radar muet", screen.line[1]);
  TEST_ASSERT_EQUAL_STRING("", screen.line[2]);
  TEST_ASSERT_EQUAL_STRING("LED rouge : code 4", screen.line[5]);
  TEST_ASSERT_EQUAL_INT8(-1, screen.highlight);

  logic::RenderFaultAlert(screen, logic::Lang::English, radar | imu);
  TEST_ASSERT_EQUAL_STRING("! Faults", screen.line[0]);
  TEST_ASSERT_EQUAL_STRING("3 IMU missing", screen.line[1]);
  TEST_ASSERT_EQUAL_STRING("4 Radar silent", screen.line[2]);
  TEST_ASSERT_EQUAL_STRING("Red LED: code 3", screen.line[5]);

  // Every name fits on a line with its number.
  for (uint8_t n = 1; n <= logic::FAULT_COUNT; n++) {
    TEST_ASSERT_TRUE(logic::Utf8Length(logic::FaultName(n, logic::Lang::French)) + 2 <= logic::SCREEN_COLUMNS);
    TEST_ASSERT_TRUE(logic::Utf8Length(logic::FaultName(n, logic::Lang::English)) + 2 <= logic::SCREEN_COLUMNS);
  }
}

void test_wing_animation_screen() {
  logic::MenuScreen screen;
  logic::RenderWings(screen, logic::Lang::French, 0, 0, true);
  TEST_ASSERT_TRUE(screen.graphic == logic::Graphic::Wings);
  TEST_ASSERT_EQUAL_STRING("Ailes", screen.line[0]);
  TEST_ASSERT_EQUAL_STRING("       [](O)[]", screen.line[2]); // closed: panels against the body
  TEST_ASSERT_EQUAL_STRING("en mouvement...", screen.line[5]);

  logic::RenderWings(screen, logic::Lang::English, 100, 100, false);
  TEST_ASSERT_EQUAL_STRING("Wings", screen.line[0]);
  TEST_ASSERT_EQUAL_STRING("  []=====(O)=====[]", screen.line[2]); // fully open
  TEST_ASSERT_EQUAL_STRING("L 100%     R 100%", screen.line[4]);
  TEST_ASSERT_EQUAL_STRING("stopped", screen.line[5]);

  logic::RenderWings(screen, logic::Lang::English, 40, 250, true); // one side, value out of range
  TEST_ASSERT_EQUAL_UINT8(40, screen.leftPercent);
  TEST_ASSERT_EQUAL_UINT8(100, screen.rightPercent);
  TEST_ASSERT_EQUAL_STRING("     []==(O)=====[]", screen.line[2]);

  // A menu screen never carries a drawing.
  logic::MenuNav nav = MakeNav();
  nav.Render(screen, logic::Lang::English, 0);
  TEST_ASSERT_TRUE(screen.graphic == logic::Graphic::None);
}

void test_wrap_text() {
  char lines[4][logic::SCREEN_LINE_BYTES];
  // 21 columns: cut between words.
  TEST_ASSERT_EQUAL_UINT8(3, logic::WrapText("Open the LEFT wing fully by hand, then press B", lines, 4, 21));
  TEST_ASSERT_EQUAL_STRING("Open the LEFT wing", lines[0]);
  TEST_ASSERT_EQUAL_STRING("fully by hand, then", lines[1]);
  TEST_ASSERT_EQUAL_STRING("press B", lines[2]);
  // A short text is one line; an empty one is none.
  TEST_ASSERT_EQUAL_UINT8(1, logic::WrapText("Done", lines, 4, 21));
  TEST_ASSERT_EQUAL_STRING("Done", lines[0]);
  TEST_ASSERT_EQUAL_UINT8(0, logic::WrapText("", lines, 4, 21));
  // Accented letters are two bytes but one column: 21 characters fit on one line.
  TEST_ASSERT_EQUAL_UINT8(1, logic::WrapText("éééééééééé ééééééééé", lines, 4, 21));
  // A word longer than the line is cut.
  TEST_ASSERT_EQUAL_UINT8(2, logic::WrapText("abcdefghijklmnopqrstuvwxyz", lines, 4, 21));
  TEST_ASSERT_EQUAL_STRING("abcdefghijklmnopqrstu", lines[0]);
  TEST_ASSERT_EQUAL_STRING("vwxyz", lines[1]);
  // Never more lines than asked.
  TEST_ASSERT_EQUAL_UINT8(2, logic::WrapText("one two three four five six seven eight nine ten", lines, 2, 10));
}

static const logic::MenuItem WIZARD_TREE[] = {
    T_ITEM("Root", "Racine", Menu, -1, nullptr, nullptr, nullptr, 0, 0, 0, 0),
    T_ITEM("Setup", "Assistant", Wizard, 0, nullptr, nullptr, nullptr, 0, 0, 0, 0),
    T_ITEM("Do the first thing, then press B", "Fais la première chose, puis B", Command, 1, "one", nullptr, nullptr, 0,
           0, 0, 0),
    T_ITEM("Second", "Deuxième", Command, 1, "two", nullptr, nullptr, 0, 0, 0, 0),
    T_ITEM("Read this", "Lis ceci", Command, 1, nullptr, nullptr, nullptr, 0, 0, 0, 0),
};

void test_menu_wizard() {
  lastCommand[0] = '\0';
  commandCount = 0;
  logic::MenuHooks hooks = {nullptr, FakeExecute, FakeValue, FakeInfo, nullptr};
  logic::MenuNav nav(WIZARD_TREE, 5, hooks);
  logic::MenuScreen screen;

  Press(nav, logic::MenuKey::B); // enter the wizard
  TEST_ASSERT_TRUE(nav.GetMode() == logic::MenuNav::Mode::Wizard);
  nav.Render(screen, logic::Lang::English, 0);
  TEST_ASSERT_EQUAL_STRING("Setup 1/3", screen.line[0]);
  TEST_ASSERT_EQUAL_STRING("Do the first thing,", screen.line[1]);
  TEST_ASSERT_EQUAL_STRING("then press B", screen.line[2]);
  TEST_ASSERT_EQUAL_STRING("B:ok  A:skip", screen.line[5]);

  Press(nav, logic::MenuKey::B); // do step 1
  TEST_ASSERT_EQUAL_STRING("one", lastCommand);
  TEST_ASSERT_EQUAL_INT16(1, nav.GetWizardStep());
  nav.Render(screen, logic::Lang::French, 1500);
  TEST_ASSERT_EQUAL_STRING("Assistant 2/3", screen.line[0]);
  TEST_ASSERT_EQUAL_STRING("ok one", screen.line[4]); // answer of the step just done

  Press(nav, logic::MenuKey::A); // skip step 2: nothing runs
  TEST_ASSERT_EQUAL_INT(1, commandCount);
  Press(nav, logic::MenuKey::ALong); // back to step 2
  TEST_ASSERT_EQUAL_INT16(1, nav.GetWizardStep());
  Press(nav, logic::MenuKey::B);
  TEST_ASSERT_EQUAL_STRING("two", lastCommand);
  Press(nav, logic::MenuKey::B); // step 3 has no command
  TEST_ASSERT_EQUAL_INT(2, commandCount);

  nav.Render(screen, logic::Lang::English, 9000);
  TEST_ASSERT_EQUAL_STRING("Done", screen.line[2]);
  Press(nav, logic::MenuKey::B); // any key leaves
  TEST_ASSERT_TRUE(nav.GetMode() == logic::MenuNav::Mode::Browse);

  Press(nav, logic::MenuKey::B);     // in again
  Press(nav, logic::MenuKey::BLong); // leave in the middle
  TEST_ASSERT_TRUE(nav.GetMode() == logic::MenuNav::Mode::Browse);
}

// Number of characters of a UTF-8 string (accented letters count once).
static int Characters(const char *text) {
  int n = 0;
  for (; *text; text++) {
    n += ((uint8_t)*text & 0xC0) != 0x80 ? 1 : 0;
  }
  return n;
}

void test_real_menu_tree() {
  TEST_ASSERT_TRUE(ui::MENU_TREE[0].kind == logic::ItemKind::Menu);
  TEST_ASSERT_EQUAL_INT16(-1, ui::MENU_TREE[0].parent);
  for (int16_t i = 1; i < ui::MENU_TREE_COUNT; i++) {
    const logic::MenuItem &item = ui::MENU_TREE[i];
    TEST_ASSERT_TRUE_MESSAGE(item.parent >= 0 && item.parent < ui::MENU_TREE_COUNT, item.en);
    // A wizard step is the child of a wizard; everything else of a menu.
    bool step = ui::MENU_TREE[item.parent].kind == logic::ItemKind::Wizard;
    TEST_ASSERT_TRUE_MESSAGE(step || ui::MENU_TREE[item.parent].kind == logic::ItemKind::Menu, item.en);
    if (step) {
      // An instruction: wrapped on three lines of 21 columns at most.
      char lines[4][logic::SCREEN_LINE_BYTES];
      TEST_ASSERT_TRUE_MESSAGE(logic::WrapText(item.en, lines, 4, logic::SCREEN_COLUMNS) <= 3, item.en);
      TEST_ASSERT_TRUE_MESSAGE(logic::WrapText(item.fr, lines, 4, logic::SCREEN_COLUMNS) <= 3, item.fr);
      continue;
    }
    // 19 characters: a submenu adds " >" and the line has 21 columns.
    TEST_ASSERT_TRUE_MESSAGE(Characters(item.en) <= 19, item.en);
    TEST_ASSERT_TRUE_MESSAGE(Characters(item.fr) <= 19, item.fr);
    if (item.kind == logic::ItemKind::Adjust) {
      TEST_ASSERT_TRUE_MESSAGE(item.minValue < item.maxValue && item.step > 0, item.en);
      TEST_ASSERT_NOT_NULL_MESSAGE(strstr(item.command, "%d"), item.en);
    }
    if (item.kind == logic::ItemKind::Command || item.kind == logic::ItemKind::Confirm) {
      TEST_ASSERT_NOT_NULL_MESSAGE(item.command, item.en);
    }
  }
  // The menus are where MenuIndex says.
  TEST_ASSERT_EQUAL_STRING("Tests", ui::MENU_TREE[ui::MenuTests].en);
  TEST_ASSERT_EQUAL_STRING("Sound", ui::MENU_TREE[ui::MenuSound].en);
}

// ------------------------------------------------------------------ radar parser

// One target at (x, y) mm, speed cm/s, resolution mm, LD2450 encoding.
static void PutTarget(uint8_t *b, int16_t x, int16_t y, int16_t speed, uint16_t resolution) {
  auto put = [](uint8_t *p, int16_t v) {
    uint16_t magnitude = (uint16_t)(v < 0 ? -v : v);
    p[0] = magnitude & 0xFF;
    p[1] = (uint8_t)((magnitude >> 8) | (v >= 0 ? 0x80 : 0x00));
  };
  put(b, x);
  put(b + 2, y);
  put(b + 4, speed);
  b[6] = resolution & 0xFF;
  b[7] = resolution >> 8;
}

static int FeedAll(logic::RadarParser &parser, const uint8_t *data, size_t length) {
  int frames = 0;
  for (size_t i = 0; i < length; i++) {
    frames += parser.Feed(data[i]) ? 1 : 0;
  }
  return frames;
}

void test_radar_parser_nominal_frame() {
  uint8_t frame[30] = {0xAA, 0xFF, 0x03, 0x00};
  memset(frame + 4, 0, 24);
  PutTarget(frame + 4, -120, 1500, -25, 360);
  frame[28] = 0x55;
  frame[29] = 0xCC;
  logic::RadarParser parser;
  TEST_ASSERT_EQUAL_INT(1, FeedAll(parser, frame, sizeof(frame)));
  TEST_ASSERT_EQUAL_UINT32(1, parser.Frames());
  TEST_ASSERT_EQUAL_UINT32(0, parser.BadFrames());
  const logic::RadarFrame &f = parser.Frame();
  TEST_ASSERT_TRUE(f.target[0].present);
  TEST_ASSERT_EQUAL_INT16(-120, f.target[0].x);
  TEST_ASSERT_EQUAL_INT16(1500, f.target[0].y);
  TEST_ASSERT_EQUAL_INT16(-25, f.target[0].speed);
  TEST_ASSERT_EQUAL_UINT16(360, f.target[0].resolution);
  TEST_ASSERT_FALSE(f.target[1].present);
  TEST_ASSERT_FALSE(f.target[2].present);
}

void test_radar_parser_footer_bytes_inside_data() {
  // x = 0x4C55 with its sign bit: bytes 55 CC right at the start of the payload.
  uint8_t frame[30] = {0xAA, 0xFF, 0x03, 0x00, 0x55, 0xCC};
  memset(frame + 6, 0, 22);
  frame[28] = 0x55;
  frame[29] = 0xCC;
  logic::RadarParser parser;
  TEST_ASSERT_EQUAL_INT(1, FeedAll(parser, frame, sizeof(frame)));
  TEST_ASSERT_EQUAL_INT16(0x4C55, parser.Frame().target[0].x);
  TEST_ASSERT_EQUAL_UINT32(0, parser.BadFrames());
}

void test_radar_parser_resync_and_bad_frame() {
  uint8_t good[30] = {0xAA, 0xFF, 0x03, 0x00};
  memset(good + 4, 0, 24);
  PutTarget(good + 4, 10, 20, 0, 1);
  good[28] = 0x55;
  good[29] = 0xCC;
  // An acknowledgement, a truncated frame (no footer: the next header follows),
  // then a good frame.
  uint8_t ack[] = {0xFD, 0xFC, 0xFB, 0xFA, 0x02, 0x00, 0xFF, 0x01, 0x04, 0x03, 0x02, 0x01};
  logic::RadarParser parser;
  TEST_ASSERT_EQUAL_INT(0, FeedAll(parser, ack, sizeof(ack)));
  TEST_ASSERT_EQUAL_INT(0, FeedAll(parser, good, 28)); // header + payload, cut before the footer
  TEST_ASSERT_EQUAL_INT(1, FeedAll(parser, good, 30)); // AA where 55 was expected: dropped, resync
  TEST_ASSERT_EQUAL_UINT32(1, parser.BadFrames());
  TEST_ASSERT_EQUAL_UINT32(1, parser.Frames());
  TEST_ASSERT_EQUAL_INT16(10, parser.Frame().target[0].x);
  // Two frames back to back, then a lone stray byte.
  TEST_ASSERT_EQUAL_INT(1, FeedAll(parser, good, 30));
  parser.Feed(0x42);
  TEST_ASSERT_EQUAL_INT(1, FeedAll(parser, good, 30));
  TEST_ASSERT_EQUAL_UINT32(3, parser.Frames());
  TEST_ASSERT_EQUAL_UINT32(1, parser.BadFrames());
}

// ------------------------------------------------------------------ firing cycle

void test_aim_angle() {
  TEST_ASSERT_FLOAT_WITHIN(0.1f, 0.0f, logic::AimAngleDeg(0, 1000, 60));
  TEST_ASSERT_FLOAT_WITHIN(0.1f, 45.0f, logic::AimAngleDeg(1000, 1000, 60));
  TEST_ASSERT_FLOAT_WITHIN(0.1f, -45.0f, logic::AimAngleDeg(-1000, 1000, 60));
  TEST_ASSERT_FLOAT_WITHIN(0.1f, 60.0f, logic::AimAngleDeg(5000, 100, 60)); // bounded
  TEST_ASSERT_FLOAT_WITHIN(0.1f, 0.0f, logic::AimAngleDeg(1000, 0, 60));    // behind / on the radar
  TEST_ASSERT_FLOAT_WITHIN(0.1f, 0.0f, logic::AimAngleDeg(1000, -500, 60));
  TEST_ASSERT_FLOAT_WITHIN(0.01f, 2.5f, logic::SmoothAim(0, 10, 0.25f));
  TEST_ASSERT_FLOAT_WITHIN(0.01f, 10.0f, logic::SmoothAim(0, 10, 1.0f));
  TEST_ASSERT_FLOAT_WITHIN(0.01f, 0.0f, logic::SmoothAim(0, 10, 0.0f));
}

void test_firing_and_search_steps() {
  TEST_ASSERT_FALSE(logic::FiringDone(1000, 1000, 3000));
  TEST_ASSERT_FALSE(logic::FiringDone(3999, 1000, 3000));
  TEST_ASSERT_TRUE(logic::FiringDone(4000, 1000, 3000));
  TEST_ASSERT_FALSE(logic::FiringDone(0xFFFFFF00u, 0xFFFFFF10u, 3000)); // now before the start: not done
  TEST_ASSERT_TRUE(logic::FiringDone(0x00000400u, 0xFFFFF000u, 3000));  // across the wrap-around (5120 ms)
  using S = logic::SearchStep;
  TEST_ASSERT_TRUE(logic::SearchDecision(true, 100, 0, 4000) == S::Fire);
  TEST_ASSERT_TRUE(logic::SearchDecision(false, 3999, 0, 4000) == S::Keep);
  TEST_ASSERT_TRUE(logic::SearchDecision(false, 4000, 0, 4000) == S::GiveUp);
  TEST_ASSERT_TRUE(logic::SearchDecision(false, 0, 0, 0) == S::GiveUp); // SearchMs 0: retire at once
  TEST_ASSERT_TRUE(logic::SearchDecision(true, 0, 0, 0) == S::Fire);    // but a target still wins
}

void test_search_sweep() {
  TEST_ASSERT_FLOAT_WITHIN(0.01f, 0.0f, logic::SearchSweepDeg(0, 0, 4000, 30));
  TEST_ASSERT_FLOAT_WITHIN(0.01f, 30.0f, logic::SearchSweepDeg(1000, 0, 4000, 30));
  TEST_ASSERT_FLOAT_WITHIN(0.01f, 0.0f, logic::SearchSweepDeg(2000, 0, 4000, 30));
  TEST_ASSERT_FLOAT_WITHIN(0.01f, -30.0f, logic::SearchSweepDeg(3000, 0, 4000, 30));
  TEST_ASSERT_FLOAT_WITHIN(0.01f, 0.0f, logic::SearchSweepDeg(4000, 0, 4000, 30));
  TEST_ASSERT_FLOAT_WITHIN(0.01f, 15.0f, logic::SearchSweepDeg(500, 0, 4000, 30));
  TEST_ASSERT_FLOAT_WITHIN(0.01f, 0.0f, logic::SearchSweepDeg(500, 0, 0, 30)); // no period: centred
}

// ------------------------------------------------------------------ command table

void test_command_table() {
  using namespace commands;
  for (size_t i = 0; i < COUNT; i++) {
    const Spec &c = TABLE[i];
    // One row per id, in order; usage starts with the name; nothing empty.
    TEST_ASSERT_EQUAL_MESSAGE((int)i, (int)c.id, c.name);
    TEST_ASSERT_EQUAL_MESSAGE(0, strncmp(c.usage, c.name, strlen(c.name)), c.usage);
    TEST_ASSERT_TRUE_MESSAGE(c.help[0] != '\0' && c.category[0] != '\0', c.name);
    for (size_t j = 0; j < i; j++) {
      TEST_ASSERT_TRUE_MESSAGE(strcmp(TABLE[j].name, c.name) != 0, c.name); // unique
    }
  }
  // Categories contiguous: once left, a category never comes back.
  for (size_t i = 1; i < COUNT; i++) {
    if (strcmp(TABLE[i].category, TABLE[i - 1].category) == 0) {
      continue;
    }
    for (size_t j = 0; j < i; j++) {
      TEST_ASSERT_TRUE_MESSAGE(strcmp(TABLE[j].category, TABLE[i].category) != 0, TABLE[i].category);
    }
  }
  TEST_ASSERT_EQUAL_STRING("help", Find("HELP")->name);
  TEST_ASSERT_EQUAL_STRING("help", Find("?")->name);
  TEST_ASSERT_EQUAL_STRING("factory-reset", Find("factory-reset")->name);
  TEST_ASSERT_NULL(Find("nothing"));
  TEST_ASSERT_TRUE(HasCategory("lab"));
  TEST_ASSERT_FALSE(HasCategory("kitchen"));
  TEST_ASSERT_TRUE((Find("loadtest")->needs & TestMode) && (Find("loadtest")->needs & FullPower));
  TEST_ASSERT_EQUAL(None, Find("servos")->needs);
}

void test_page_texts() {
  for (size_t i = 0; i < web::TEXT_COUNT; i++) {
    const web::Text &t = web::TEXTS[i];
    TEST_ASSERT_TRUE_MESSAGE(t.key[0] && t.en[0] && t.fr[0], t.key);
    TEST_ASSERT_TRUE_MESSAGE(strchr(t.key, '"') == nullptr && strchr(t.key, ' ') == nullptr, t.key);
    for (size_t j = 0; j < i; j++) {
      TEST_ASSERT_TRUE_MESSAGE(strcmp(web::TEXTS[j].key, t.key) != 0, t.key); // unique
    }
  }
}

void test_plausible_speed() {
  TEST_ASSERT_TRUE(logic::IsPlausibleSpeed(1500, 0)); // no limit
  TEST_ASSERT_TRUE(logic::IsPlausibleSpeed(150, 300));
  TEST_ASSERT_TRUE(logic::IsPlausibleSpeed(-300, 300)); // either way, inclusive
  TEST_ASSERT_FALSE(logic::IsPlausibleSpeed(301, 300));
  TEST_ASSERT_FALSE(logic::IsPlausibleSpeed(-32767, 300));
}

int main() {
  UNITY_BEGIN();
  RUN_TEST(test_command_table);
  RUN_TEST(test_page_texts);
  RUN_TEST(test_plausible_speed);
  RUN_TEST(test_radar_parser_nominal_frame);
  RUN_TEST(test_radar_parser_footer_bytes_inside_data);
  RUN_TEST(test_radar_parser_resync_and_bad_frame);
  RUN_TEST(test_aim_angle);
  RUN_TEST(test_firing_and_search_steps);
  RUN_TEST(test_search_sweep);
  RUN_TEST(test_menu_render_root);
  RUN_TEST(test_menu_next_previous_wrap_and_scroll);
  RUN_TEST(test_menu_command_and_answer);
  RUN_TEST(test_menu_confirm);
  RUN_TEST(test_menu_info_pages);
  RUN_TEST(test_menu_adjust);
  RUN_TEST(test_menu_submenu_and_back);
  RUN_TEST(test_real_menu_tree);
  RUN_TEST(test_hall_percent);
  RUN_TEST(test_wing_animation_screen);
  RUN_TEST(test_fault_alert);
  RUN_TEST(test_menu_encoder);
  RUN_TEST(test_volume_screen);
  RUN_TEST(test_factory_reset_screen);
  RUN_TEST(test_reset_gesture);
  RUN_TEST(test_wrap_text);
  RUN_TEST(test_menu_wizard);
  RUN_TEST(test_decode_examples);
  RUN_TEST(test_decode_matches_upstream_parser);
  RUN_TEST(test_zone);
  RUN_TEST(test_hall_normal_polarity);
  RUN_TEST(test_hall_reversed_magnet);
  RUN_TEST(test_hall_rail);
  RUN_TEST(test_button_short_press);
  RUN_TEST(test_button_bounce_ignored);
  RUN_TEST(test_button_long_press_once);
  RUN_TEST(test_button_held_at_boot);
  RUN_TEST(test_lowest_fault);
  RUN_TEST(test_breath_level);
  RUN_TEST(test_heartbeat);
  RUN_TEST(test_green_led_level);
  RUN_TEST(test_upsampler);
  RUN_TEST(test_pick_voice_file);
  RUN_TEST(test_id3v2_size);
  RUN_TEST(test_upsample_factor);
  RUN_TEST(test_tip_watch);
  RUN_TEST(test_servo_ramp);
  RUN_TEST(test_sleep_night_window);
  RUN_TEST(test_sleep_levels);
  RUN_TEST(test_amp_gain_rounding);
  return UNITY_END();
}
