lo26lo/portal-turret-v4/Turret_firmware/tools/check_web.py

"""Web page check without the board (improvement D2, also run by the CI).

Starts tools/mock_server.py on a free port and checks the API the page relies
on, then checks the syntax of the page JavaScript with Node.js if available.

    python tools/check_web.py        (from Turret_firmware/; exit code 1 on failure)
"""
import base64
import json
import os
import re
import shutil
import socket
import subprocess
import sys
import tempfile
import time
import urllib.error
import urllib.parse
import urllib.request

ROOT = os.path.dirname(os.path.dirname(os.path.abspath(__file__)))
LOGIN = "Admin:1234"  # factory WebUser / WebPassword
failures = []


def check(name, condition, detail=""):
    print(("ok    " if condition else "FAIL  ") + name + (f"  ({detail})" if detail and not condition else ""))
    if not condition:
        failures.append(name)


class NoRedirect(urllib.request.HTTPRedirectHandler):
    def redirect_request(self, *args, **kwargs):
        return None


def request(base, path, data=None, auth=True):
    """auth: True for the factory login, a "user:password" string for another one, False for none."""
    req = urllib.request.Request(base + path, data=urllib.parse.urlencode(data).encode() if data is not None else None)
    if auth:
        login = LOGIN if auth is True else auth
        req.add_header("Authorization", "Basic " + base64.b64encode(login.encode()).decode())
    opener = urllib.request.build_opener(NoRedirect)
    try:
        with opener.open(req, timeout=5) as r:
            return r.status, r.read().decode("utf-8", "replace"), dict(r.headers)
    except urllib.error.HTTPError as e:
        return e.code, e.read().decode("utf-8", "replace"), dict(e.headers)


def free_port():
    with socket.socket() as s:
        s.bind(("127.0.0.1", 0))
        return s.getsockname()[1]


def main():
    port = free_port()
    base = f"http://127.0.0.1:{port}"
    server = subprocess.Popen([sys.executable, os.path.join(ROOT, "tools", "mock_server.py"), str(port)],
                              stdout=subprocess.DEVNULL, stderr=subprocess.PIPE)
    try:
        for _ in range(50):
            try:
                socket.create_connection(("127.0.0.1", port), timeout=0.2).close()
                break
            except OSError:
                time.sleep(0.1)

        code, _, _ = request(base, "/", auth=False)
        check("credentials required", code == 401, code)
        code, _, _ = request(base, "/", auth="turret:stillalive")
        check("old login (turret / access point password) refused", code == 401, code)
        code, body, _ = request(base, "/")
        check("page served (Admin / 1234)", code == 200 and "<script>" in body, code)

        settings_cpp = open(os.path.join(ROOT, "src", "settings", "Settings.cpp"), encoding="utf-8").read()
        expected = len(re.findall(r'\{"\w+",\s*"[^"]*",\s*"[^"]+",\s*SettingType::', settings_cpp))
        code, body, _ = request(base, "/api/settings")
        rows = json.loads(body)
        check("all settings listed", len(rows) == expected, f"{len(rows)} of {expected}")
        check("passwords never sent", all(r["value"] == "" for r in rows if r.get("secret")))
        secrets = {r["key"] for r in rows if r.get("secret")}
        check("passwords marked secret", secrets == {"ApPassword", "StaPassword", "WebPassword"}, sorted(secrets))
        keys = [r["key"] for r in rows]
        check("NVS keys at most 15 characters", all(len(k) <= 15 for k in keys), [k for k in keys if len(k) > 15])
        check("keys unique", len(set(keys)) == len(keys))
        choices = [r for r in rows if "options" in r]
        check("choices listed (status LEDs)", {"GreenLedMode", "RedLedMode"} <= {r["key"] for r in choices})
        bad_choices = [r["key"] for r in choices if r["min"] != 0 or r["max"] != len(r["options"]) - 1]
        check("each choice has one option per value", not bad_choices, bad_choices)

        request(base, "/api/settings", {"Volume": "150", "ApPassword": "short", "GreenLedMode": "off", "RedLedMode": "maybe",
                                        "WebPassword": "123", "WebUser": "a:b"})
        _, body, _ = request(base, "/api/settings")
        values = {r["key"]: r["value"] for r in json.loads(body)}
        check("values clamped", values.get("Volume") == 100, values.get("Volume"))
        check("choice set by its name", values.get("GreenLedMode") == 3, values.get("GreenLedMode"))
        check("unknown choice ignored", values.get("RedLedMode") == 0, values.get("RedLedMode"))
        _, log, _ = request(base, "/api/log")
        check("short password refused", "refused: ApPassword" in log)
        check("short web password refused (4 to 63)", "refused: WebPassword" in log)
        check("web user with ':' refused", "refused: WebUser" in log)
        check("unknown choice refused", "refused: RedLedMode" in log)

        # Voice lines (audio/Audio.cpp): console command, page list, data/ folders.
        request(base, "/api/action", {"cmd": "voice activate"})
        _, log, _ = request(base, "/api/log")
        check("voice command", "voice activate: /01_activate/" in log)
        audio_cpp = open(os.path.join(ROOT, "src", "audio", "Audio.cpp"), encoding="utf-8").read()
        table = lambda name: re.search(name + r"\[[^\]]*\] = \{(.*?)\};", audio_cpp, re.S).group(1)
        firmware_voices = set(re.findall(r'"(\w+)"', table("VOICE_NAMES")))
        # The page fills its lists from /api/meta (no copy of the firmware lists in the page).
        code, body, _ = request(base, "/api/meta")
        meta = json.loads(body)
        check("meta served", code == 200 and {"faults", "axes", "voices", "servos"} <= set(meta))
        check("meta voices = firmware voices", len(firmware_voices) == 8 and set(meta["voices"]) == firmware_voices,
              sorted(set(meta["voices"]) ^ firmware_voices))
        page = open(os.path.join(ROOT, "src", "web", "page", "index.html"), encoding="utf-8").read()
        check("page has no copy of the lists", "activate</option>" not in page and '"IMU missing"' not in page)
        check("page uses /api/meta", "/api/meta" in page)
        folders = re.findall(r'"/(\w+)"', table("VOICE_FOLDERS"))
        data = os.path.join(ROOT, "data")
        empty = [f for f in folders if not os.path.isdir(os.path.join(data, f))
                 or not any(n.lower().endswith(".mp3") for n in os.listdir(os.path.join(data, f)))]
        check("every voice folder has MP3 files in data/", len(folders) == 8 and not empty, empty)

        code, _, _ = request(base, "/api/action", {"cmd": "wings open"})
        check("action queued", code == 202, code)
        code, body, _ = request(base, "/api/status")
        status = json.loads(body)
        for field in ("version", "state", "faults", "radar", "imu", "hall", "servos", "amp", "wifi", "time", "crash", "stats",
                      "selfTest"):
            check(f"status has {field}", field in status)

        code, _, headers = request(base, "/generate_204", auth=False)
        check("captive portal redirect", code == 302 and "Location" in headers, code)
        code, body, _ = request(base, "/api/wifi/scan")
        check("wifi scan answers", code == 200 and "networks" in json.loads(body), code)

        # Debug menu (lot IM): the tree of src/ui/MenuTree.h against the firmware.
        import mock_menu
        tree = mock_menu.parse_tree()
        check("menu tree parsed", len(tree) > 40 and tree[0]["parent"] == -1, len(tree))
        # A wizard step is an instruction wrapped on three lines (63 characters); the rest is one line.
        is_step = lambda i: i["kind"] == "STEP"
        long_labels = [i[lang] for i in tree for lang in ("en", "fr") if len(i[lang]) > (63 if is_step(i) else 19)]
        check("menu labels fit the screen (19 characters, steps 63)", not long_labels, long_labels)
        unwrappable = [i[lang] for i in tree if is_step(i) for lang in ("en", "fr")
                       if mock_menu.wrap(i[lang], max_lines=9)[3] != ""]
        check("wizard steps wrap on three lines", not unwrappable, unwrappable)
        table_h = open(os.path.join(ROOT, "src", "control", "CommandTable.h"), encoding="utf-8").read()
        known = set(re.findall(r'\{"([\w-]+)",\s*"[^"]*",\s*"[^"]*",\s*"[^"]*",\s*Id::', table_h))  # the command table
        unknown = sorted({i["command"].split()[0] for i in tree if i.get("command")} - known)
        check("every menu command exists in control/Actions.cpp", not unknown, unknown)
        setting_keys = set(keys)
        bad_keys = sorted({i["key"] for i in tree if i["kind"] == "ADJ" and not i["key"].startswith("@")} - setting_keys)
        check("every adjustable value is a setting", not bad_keys, bad_keys)
        orphans = [i["en"] for i in tree if i["parent"] >= 0
                   and tree[i["parent"]]["kind"] != ("WIZ" if is_step(i) else "MENU")]
        check("every entry has a menu as parent (a wizard for a step)", not orphans, orphans)

        code, body, _ = request(base, "/api/selftest")
        check("self-test report before any run", code == 200 and "No self-test" in body, code)
        request(base, "/api/action", {"cmd": "selftest quick"})
        code, body, _ = request(base, "/api/selftest")
        check("self-test report after a quick run", code == 200 and "OK" in body and "SKIP" in body, code)

        code, body, _ = request(base, "/api/screen")
        scr = json.loads(body)
        check("debug screen has six lines", code == 200 and len(scr["lines"]) == 6, code)
        root_title = scr["lines"][0]
        request(base, "/api/action", {"cmd": "key b"})
        _, body, _ = request(base, "/api/screen")
        check("key B enters the first menu", json.loads(body)["lines"][0] != root_title)
        request(base, "/api/action", {"cmd": "key bl"})
        _, body, _ = request(base, "/api/screen")
        check("key B long goes back", json.loads(body)["lines"][0] == root_title)

        code, _, _ = request(base, "/api/coredump")
        check("no core dump -> 404", code == 404, code)
        request(base, "/api/action", {"cmd": "sim crash on"})
        code, body, _ = request(base, "/api/coredump")
        check("core dump download", code == 200 and body.startswith("\x7fELF"), code)
        code, body, _ = request(base, "/api/crashlog")
        check("previous run log", code == 200 and len(body) > 0, code)
        request(base, "/api/coredump/erase", {})
        code, _, _ = request(base, "/api/coredump")
        check("core dump erased", code == 404, code)
    finally:
        server.terminate()
        server.wait(timeout=5)

    node = shutil.which("node")
    if node:
        html = open(os.path.join(ROOT, "src", "web", "page", "index.html"), encoding="utf-8").read()
        # The same compaction as scripts/embed_page.py: what the firmware really serves.
        compacted = re.sub(r"/\*.*?\*/", "", re.sub(r"<!--.*?-->", "", html, flags=re.S), flags=re.S)
        compacted = "\n".join(l.strip() for l in compacted.splitlines() if l.strip() and not l.strip().startswith("//"))
        for name, text in (("page JavaScript syntax", html), ("compacted page JavaScript syntax", compacted)):
            script = re.search(r"<script>(.*)</script>", text, re.S).group(1)
            with tempfile.NamedTemporaryFile("w", suffix=".js", delete=False, encoding="utf-8") as f:
                f.write(script)
            result = subprocess.run([node, "--check", f.name], capture_output=True, text=True)
            os.unlink(f.name)
            check(name, result.returncode == 0, result.stderr.strip())
    else:
        print("skip  page JavaScript syntax (node not found)")

    print(f"\n{len(failures)} failure(s)" if failures else "\nall checks passed")
    return 1 if failures else 0


if __name__ == "__main__":
    sys.exit(main())
