lo26lo/portal-turret-v4/(commit log)

2026-09-25 Lot 1: pin platform and library versions
    espressif32@7.1.3 (arduino-esp32 2.0.17), exact registry versions,
    git libraries pinned to a commit, transitive dependencies listed.
    Reference build with lolin_s3_mini: compiles and links, 106.3 % of the
    4 MB app partition (fixed by the 8 MB target in lot 2). Logbook updated.
2026-09-25 README: add the board render at the top
2026-09-25 Lot 2: Turret2 board target for PlatformIO
    boards/turret2.json (ESP32-S3-MINI-1-N8, 8 MB QIO, qio_qspi, no PSRAM,
    default_8MB partitions), variants/turret2 (I2C on 35/36, LED_BUILTIN on
    the green LED, no RGB_BUILTIN, default SPI on unconnected IO39-42),
    envs turret2 / turret2_ota / turret2_bringup. Wemos envs removed (D2).
2026-09-25 Lot 2: complete pins.h with the Turret2 pins
    Include guard, existing pins unchanged, amp SD/gain, PWR_FLT, status LEDs,
    buttons, SW1 bench mode, IMU INT1 and UART0 added.
2026-09-25 Turret2 firmware: lots 3 to 12, home WiFi, web page, README
    - Lot 3: upstream bugs (AudioLoop sample count, audio buffer overflow,
    LittleFS mount without auto-format, unused downloader removed, Settings).
    - Lot 4: Board module (safe state, reset reason, reboot-loop detection,
    status LED codes, buttons, SW1 bench mode, PWR_FLT interrupt).
    - Lot 5: boot sequence of the firmware plan (I2C on IO35/IO36 with bus
    recovery, servos attached one at a time, homing, real BootState).
    - Lot 6: LSM6DSOX IMU (Adafruit LSM6DS 4.7.4), upright check.
    - Lot 7: MAX98357A control (gain via open drain, mute, volume, safe
    shutdown before any restart).
    - Lot 8: ServoChannel, staggered attachment, D6 hold po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
    [Actions.h, Amp.cpp, Amp.h, Audio.cpp, Audio.h]
2026-09-26 Add measurement notebook; hardware frozen; firmware lab aids
    - docs/experiments.md: lab notebook with 15 experiments (power,
    digital signals, audio, PPK2 in bench mode), safety rules and
    result tables, no hardware change needed.
    - docs/firmware-improvements.md: hardware frozen decision, part E
    replaced by measurements without modification, new catalogue L
    and work package IL (lab aids in the firmware).
    Claude-Session: https://claude.ai/code/session_01QGvXWWdfAbMpw6ZD9xVUvo
2026-09-26 Improvements I1: silent radar, cooldown and detection zone, git version, CI
    - A1: radar targets cleared after 1 s without a frame; Idle requires a
    live radar (a stale target used to make the turret fire in a loop).
    - A2: CooldownMs, DetectMaxMm, DetectAngle settings; only targets in
    front, in range and within the angle trigger a cycle.
    - D4: firmware version from git (scripts/git_version.py) in the boot
    banner, /api/status and the web page.
    - D2: GitHub Actions workflow (include case check, build turret2 and
    turret2_bringup, tools/check_web.py against the simulator).
    - README and docs/firmware-improvements.md updated.
2026-09-26 Improvements I2 and IL: crash diagnostics, watchdog, native tests, lab aids
    I2
    - A3: last 2 kB of the log kept in RTC memory (shown after a crash,
    crashlog, GET /api/crashlog); core dump summary at boot, download
    (GET /api/coredump) and erase; crash report on the web page.
    - A4: task watchdog on loop() (8 s); I2C scan stops on bus timeout.
    - D1: pure logic moved to src/logic (radar decoding and zone, Hall
    thresholds, button debounce, LED fault code, amp gain) and used by
    the firmware; native Unity tests (pio test -e native), run by the CI.
    IL (lab aids for docs/experiments.md)
    - L1 LabMarkers (green LED toggles at boot steps / servo attachments),
    L2 servo and tone sweeps, L3 singl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
    [Actions.h, Amp.cpp, Audio.cpp, Audio.h, Board.h, BoardLogic.h]
2026-09-26 Docs: plan deviations, README and improvement log brought up to date
    - firmware-plan.md: current-state box (lots 1-12 done, link to the
    firmware README, deviations: page behind auth, reboot after any OTA,
    home WiFi / NTP / captive portal).
    - README.md: detection and diagnostics, repository layout with docs/
    and .github/.
    - firmware-improvements.md: I2 + IL pushed, CI green with native tests.
2026-10-05 Improvement IM: debug mode with an OLED screen on the Qwiic port
    - SW1 closed at power-up is now the debug mode: with a 128x64 I2C OLED on
    J11 (SSD1306, SSD1309 or SH1106 through U8g2, OledType setting),
    buttons A and B drive a menu in French or English: information pages,
    tests, calibration, settings, WiFi, system.
    - Menu navigation and rendering as six text lines in src/logic/MenuLogic.h
    (pure, native tests); menu tree in src/ui/MenuTree.h; every test entry
    runs an existing command of control/Actions.
    - WiFi menu (turret network with its password, home network, scan
    results, date and time; scan, reconnect, forget, on / off).
    - Wing animation on the screen, driven by the Hall se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
2026-10-05 Debug screen: display task, self-test, wizard, graphs, QR codes, eye
    - The OLED frame is now drawn and sent by a task of its own: loop() is
    never held up by the 25 ms of a frame (Wire locks per transaction,
    U8g2 sends 24-byte transactions). Wing animation at 10 frames per second.
    - Screen model generalised: logic::Graphic (wings, radar, graph, QR, eye)
    with a text version kept in the six lines for the web page and tests.
    - Screen settings: OledFlip, OledContrast, OledSleepS (screen off when
    idle), OledFace.
    - Self-test (control/SelfTest): 19 checks, quick or full, report on the
    screen, the web page (GET /api/selftest) and the console.
    - Guided calibration (new Wizard entry kind, lo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
2026-10-18 First board bring-up: firmware starts after flashing, green LED heartbeat
    - Flash over the native USB: esptool's RTS reset after writing left the
    ESP32-S3 in download mode, so the firmware never started. The board now
    asks for no reset (upload.after_reset = no_reset) and
    scripts/reset_after_upload.py restarts it with a watchdog reset,
    ignoring the expected loss of the USB port.
    - Green LED: steady during boot, then a heartbeat (two short beats and a
    rest, 50 per minute) instead of one short flash per second;
    logic::HeartbeatOn() with a native test.
    - Docs: first board flashed on 17.10.2026 (results of the first boot,
    radar silent), status column for each bring-up step in plan s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
2026-10-19 OLED: boot no longer hangs in U8g2 begin; 5 s fault alert
    - Display: the SCL / SDA pins are no longer passed to the U8g2
    constructors. U8g2's GPIO init did pinMode(OUTPUT) on them before
    Wire.begin, taking IO35 / IO36 away from the I2C peripheral: begin()
    never returned and the boot stopped as soon as an OLED was plugged in.
    Seen on the first board with a 0.96" SSD1306, fixed and checked.
    - Fault alert: a fault that appears is shown full screen for 5 s (name
    and red LED code), in both modes, then the screen goes on; the red LED
    keeps signalling it. The eye no longer shows a permanent fault line.
    logic::FaultAlert / RenderFaultAlert, native test test_fault_alert.
    - Docs: improve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
2026-10-19 Rotary encoder, factory reset with SW1 + PROG, Qwiic module plan
    Built and checked (check_web.py), NOT yet flashed: the board was
    unplugged. To try on the hardware first thing.
    - Rotary encoder on J11 (sensors/RotaryEncoder), detected at boot:
    Adafruit 4991 (seesaw, 0x36), Adafruit 5752 quad (seesaw, 0x49,
    knob 0), Soldered 333188 (ATtiny404, 0x30). Polled every 30 ms.
    Debug mode with a screen: drives the menu (new MenuKey values
    translated per mode by MenuNav::FromEncoder; turning never answers a
    confirmation; hints follow the last control used). Otherwise:
    volume in 5 % steps and mute, volume screen for 1.5 s, saved to NVS
    2 s after the last detent ("volume" command).
    "key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
2026-10-19 Factory reset checked on the board, inputs command, LED resistor docs
    - Factory reset with SW1 closed + PROG held 5 s checked on the first
    board: settings, statistics and counters erased, restart.
    - New "inputs" console command: raw levels of PROG, SW1, buttons A and B
    (bring-up step C).
    - Docs: status LED resistors corrected everywhere (green D4 via R18,
    now 100 ohm; red D3 via R12 680 ohm; the docs said 470 ohm for both).
    The change is made in the master KiCad project, outside this
    repository; the portable copy in Turret2_portable/ is not committed
    here.
    - Improvement log and plan: session of 19.10.2026, step C.
2026-10-20 Docs: standby (B9) and target speed (B10) ideas
    - B9 "sentry standby": partial standby only (the 5 V rail cannot be
    switched; the LD2450 draws 120 mA). Deep sleep and other radars
    (LD2410S, RD-03D, LD2460, LD2461) looked at and set aside: keep the
    LD2450.
    - B10: use the radial speed the LD2450 already reports (decoded, never
    used): reactions, aiming ahead, filtering, display.
    - "Firing" stated as the cosmetic sequence it is.
2026-10-20 Radar is an Ai-Thinker RD-03D V2: docs, J5 pinout fix, cable
    - The radar fitted is an Ai-Thinker RD-03D V2, not an HLK-LD2450. Its
    user manual gives the same frames (AA FF 03 00, 3 x 8 bytes, 55 CC,
    bit 15 = positive, mm and cm/s), 256000 baud, 5 V, about 110 mA:
    the parser is unchanged, only comments mention it.
    - J5 pinout corrected in the main README and the design plan (pins 2
    and 3 were swapped; board file: 2 = IO18, 3 = IO17).
    - Crossed cable J5 -> RD-03D described (radar connector 1 5V, 2 GND,
    3 TX, 4 RX, 5-6 programming).
    - J5 label becomes "Radar" in the master KiCad project (outside this
    repository).
    - Improvement log: decision, next action, B1 / B9 / B10 updated.
    Co-A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
2026-10-21 Aperture logo on the OLED and web page; Turret2 v2 hardware plan
    Firmware:
    - Normal-mode OLED screen: the Aperture logo (42 x 42 XBM,
    src/ui/ApertureLogo.h, made by tools/aperture_logo.py) replaces the
    eye; subtitles and time unchanged. Graphic::Eye becomes Graphic::Logo,
    menu entries "Logo on / off", OledFace description updated.
    - Web page: the same logo as an inline SVG in the header (follows the
    light / dark theme) and as the tab icon.
    - Flashed and running on the board; check_web.py passes.
    Hardware, v2 board (nothing built yet):
    - docs/carte-v2-plan.md: switched rails (3 x TPS22965, AO3401A for the
    Hall sensors), TPS259533 eFuse with a 5.7 V output clamp, RD-03D only
    (no s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
2026-10-22 Portable KiCad copy: R18 100 ohm in the schematic, KiCad re-save
    R18 (IO33 -> green LED D4) goes from 1 kohm to 100 ohm in mcu.kicad_sch,
    as already documented on 19.10.2026. The rest of the diff is KiCad
    reordering the schematic files on save. Adds the 2026-10-19 backup.
2026-10-22 Board v2 plan: R18 100 ohm, deep sleep total, missing parts
    R18 is 100 ohm since 19.10.2026 (GPIO table and section 12). Status LEDs
    in deep sleep: IO13 is an RTC pin in v2. Deep sleep total in section 1
    now matches section 1.1. Shopping list: 100 nF on 5V_RADAR, 10 uF for
    the LSM6DSOX, 0 ohm 2512 for the sleep current bridge.
2026-10-22 Green LED: smooth breathing heartbeat (sigma-delta)
    The green status LED now breathes slowly, like the LED of the PPK2, instead
    of the fast lub-dub: off to full and back in 4 s (HEARTBEAT_PERIOD_MS),
    raised cosine squared for an even fade to the eye.
    The LEDC timers all belong to ESP32Servo, so the LED goes through the
    sigma-delta modulator (channel 0). Levels 0 and 255 switch the pin back to
    a plain GPIO, so off is really off. Boot, lab markers and the factory reset
    blinks are unchanged. test_heartbeat rewritten for logic::HeartbeatLevel().
    Built for turret2 and flashed on the board (turret2_bringup); native tests
    are left to the CI (no host gcc here).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
2026-10-22 Board v2: plan review before freeze, KiCad step-by-step guide
    carte-v2-plan.md, checked against the v0.1 KiCad files and the datasheets:
    TPS631000 feedback divider to 511k / 91k (the 56k / 10k one draws 50 uA),
    10k pull-down on IO26 (internal pull-up at reset), optional 100k pull-downs
    on the other PWM lines, radar standby current with the Wi-Fi access point,
    TCAL6416 address and output register default, eFuse quiescent current,
    OH49E Hall sensors, C29 / C30 reused on the switched rails, 0 ohm 2512
    (>= 4 A) for the sleep current bridge, board guard in the firmware list,
    section references fixed.
    carte-v2-kicad.md (new): phases 0 to 7 to make the v2 in KiCad 10, with
    checkpoints verified fro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
2026-10-22 Status LED settings on the web page (mode, period, brightness)
    New group "Status LEDs": GreenLedMode (breathing, heartbeat, steady, off),
    GreenLedPeriod (one breath or heartbeat, 1000..10000 ms, default 4000),
    GreenLedBright (1..100 %), RedLedMode (fault codes, on while a fault is
    active, off). Applied at once by Board::ApplySettings, which also takes over
    LabMarkers. The boot LED test, the factory reset blinks and LabMarkers still
    win over these settings.
    Settings can now be a choice: SettingsEntry::options ("A|B|C"), sent by
    /api/settings and shown as a drop-down list on the page. The console takes
    the number or the name (set GreenLedMode off) and refuses anything else;
    get shows the name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
2026-10-22 Board v2 docs: power zones, track and via sizes, second Qwiic port
    KiCad guide (carte-v2-kicad.md):
    - step 5.4 "power zones": the v0.1 zone outlines stay; the servo zone
    (In2 and back) becomes 5V_SERVO; of the 7 vias of the 5V star point,
    the 4 that touch the servo zone go, and >= 7 vias leave from the output
    of SW_SERVO; TP2 becomes the 5V_SERVO test point. Picture of the v0.1
    and v2 zones (docs/img/zones-alim-v2.png), drawn from the board file.
    - track widths and via sizes per net (IPC-2221, 1 oz, 10 C rise), net
    class patterns for the new nets (5V_*, VBUS*, 3V3_*), "_C" labels on the
    connector side of series resistors, new parts in the fine-pitch DRC
    rules; final step "vias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
2026-10-22 Board v2 plan: back-side stencil with the front side populated
    - carte-v2-plan.md section 8: support jig (edges and posts in the free
    areas of the front side, top level with the back side), posts under
    the printed areas, pins in H1 / H2, back-side SMD parts grouped for a
    partial stencil, through-hole connectors by hand at the end.
    - firmware-improvements.md: CI result of 0509307 (green, run
    39663277962) and the stencil entry.
2026-10-23 Board v2: on-board USB-C removed, J1 in JST-XH, right part 5-6 mm taller
    - The on-board USB-C (USBC1), its CC resistors (R1, R2) and the second TVS
    (D5) go after repeated intermittent contacts on D-. The only input is the
    remote USB on J1, moved from JST-PH (2 A per contact) to JST-XH 4-pin
    (3 A per contact, 22 AWG power wires), same pinout. D1 and D2 next to J1.
    - The right part of the board grows by 5 to 6 mm (the speaker is 8 mm above
    the current edge, measured in Fusion); the left part cannot, because of
    the ESP32 antenna keep-out. About 2 cm2 more: a few small parts; the
    back-side plan stays the base. Guide step 5.0 gives the edge coordinates.
    - Pictures: docs/img/agrandir-c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
2026-10-23 Firmware: web login Admin / 1234, the 55 voice lines of upstream
    - Web login separate from the WiFi password: WebUser / WebPassword
    (factory Admin / 1234, 4 to 63 characters, applied at the next boot),
    also for /update. ApPassword stays the WPA2 password (stillalive: WPA2
    needs 8 characters). "get" masks WebPassword; page checks; the QR page
    shows the user in use; OTA environments use Admin.
    - Voice lines: the 55 MP3 files of upstream in data/ (pio run -t
    uploadfs), one folder per situation, a random file never twice in a
    row. audio/Mp3FrameDecoder decodes one frame at a time with the Helix
    C API (the C++ wrapper never decoded the last ~1 KB of a file);
    samples doubled to 44.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
2026-10-23 Board v2: raised outline as a 3D model, third mounting hole H3
    - Turret2_portable/3d/Turret2_rehausse.step: KiCad export of the board
    with the raised outline (components included), to check in Fusion.
    - Checked in the file: right part raised by 6 mm (top edge at y 80.36,
    corner and step moved as in the guide), board 77.3 x 46.6 mm, H1 / H2
    unchanged, a third M2 hole H3 at (139.065; 83.175) above H2.
    - H3 is 2.50 mm from the nearest edge (the corner arc), like H2
    (2.54 mm; H1 3.0 mm): 1.4 mm of board around the 2.2 mm hole, 0.5 mm
    under an M2 screw head. Useful only with a post in the support.
    - Plan sections 0 and 8; KiCad guide step 5.0 (exact corner coordinates
    141.605, H3, ali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
2026-10-28 docs v2 : brochage final et placement réel (28.10.2026)
    Étude des GPIO relancée sur le placement v2 de KiCad : 9 fonctions
    déplacées (I2C sur IO36/IO35, ROTATE_X IO12, radar IO9/IO11, DEBUG_SW IO7,
    GUN_RIGHT IO48, WING_RIGHT IO21, PWR_FLT IO26), R34 retirée, extendeur U13
    en face avant, J19 en bas à gauche, points de test nommés par fonction,
    firmware (Wire.begin(36, 35)) et liste de contrôle alignés.
    Claude-Session: https://claude.ai/code/session_01GqGv7q4MqhrvbpuTysQzMX
2026-10-28 docs v2 : pont de mesure 0 Ω 2512 (R44) supprimé
    VBUS va directement de J1 / D1 à l'eFuse ; plus de net VBUS_IN.
    La fuite de D1 se mesure sur la v0.1.
    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
2026-10-29 docs v2 : SDA / SCL inversées sur l'ESP32 (SDA IO35, SCL IO36)
    Sur U13, SCL est au-dessus de SDA : avec SDA IO36 / SCL IO35, les deux
    lignes se croisaient avant l'extendeur. Retour au brochage I2C de la
    v0.1 et de la variante Arduino turret2 : Wire.begin(35, 36).
    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
2026-10-29 docs v2 : table de découplage et contrôle check_decap.py
    Le schéma ne dit pas à quelle broche appartient chaque condensateur de
    découplage : table condensateur → broche dans le guide KiCad (phase 6)
    et script qui vérifie sur le PCB la piste directe (ou la zone voulue)
    et la via GND. Ordre du bus I2C mis à jour.
    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
2026-11-01 docs v2 : carte routée en 6 couches, état réel, brochage final, carte fille v2
    - docs/carte-v2-etat.md (nouveau) : la carte telle qu'elle est dans KiCad
    le 01.11.2026 (empilement JLC06161H-2116, classes et règles, USB à 90 Ω,
    alimentation, brochage relevé dans le PCB, connecteurs, points de test,
    implantation, historique du routage, liste avant commande, écarts avec
    le plan) et la carte fille des canons v2 (C1 100 µF polymère, C2 100 nF,
    place vérifiée dans Fusion).
    - carte-v2-plan.md : bandeau d'état, notes sur les sections dépassées
    (brochage changé encore au routage après le §5.3, mesure du §2.1 non
    implantée), §11 mis à jour, §13.5 carte fille v2 ; fu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
2026-11-02 firmware : rampe des servos sur alimentation faible, servos relâchés aussitôt corrigé, commande pins
    - ServoRamp (Power, µs/s, 1000 par défaut, 0 = sans rampe) : rotations et canons
    suivent la commande à vitesse limitée en mode debug sans « power full » ;
    ailes continues jamais rampées ; logic/ServoLogic.h + test_servo_ramp
    - Gantry / Gun : écarts de temps signés (un servo attaché dans la boucle
    était relâché aussitôt, différence non signée repliée)
    - Release(reason) : chaque relâchement est loggé avec sa cause
    - commande console « pins » : registres de la LED verte (IO33) et de l'USB
2026-11-02 firmware v2 (lot F2) : brochage, garde-fou, rails, veilles ; OLED ; interface au knob
    - OLED : la veille de l'écran se déclenchait juste après un cran du knob
    (différence de temps non signée dans DebugUi::UpdateSleep)
    - F2.1 : pins.h pour la v0.1 et la v2 (TURRET2_V2), variante turret2_v2,
    environnements turret2_v2*, la CI compile aussi turret2_v2
    - F2.2 : garde-fou de carte (board/BoardCheck) au tout début du boot
    - F2.3 : pilote du TCAL6416 (board/Expander), commande rails
    - F2.4 : rails de la v2 (board/Power) un par un dans l'ordre du boot,
    coupés en défaut d'alimentation et avant un redémarrage ; commande rail
    - F2.5 : PROG 3 s (SW1 ouvert) = Wi-Fi, knob maintenu = démo
    -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
2026-11-10 firmware : anneau NeoPixel tout blanc corrigé (FastLED 3.9.20), arc-en-ciel, pins <n>
    - FastLED 3.10.5 -> 3.9.20 : sous ESP-IDF 4.4 (SOC_RMT_SUPPORTED absent),
    la 3.10.5 passait sur un envoi logiciel deux fois trop lent sur le S3 ;
    chaque bit était lu comme un 1 (LED toutes blanches). Impulsions mesurées
    conformes avec la 3.9.20 (RMT), anneau rouge vérifié sur la v0.1.
    - console pins <n> : état d'une broche (out_sel, IO_MUX) et sonde des
    impulsions pendant une trame LED, échantillonnées depuis le cœur 0.
    - led rainbow / led <bande> rainbow : arc-en-ciel tournant (bouton web).
    - réglage LedEffect (Lights) : 0 œil rouge (défaut), 1 arc-en-ciel permanent.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
2026-11-12 firmware : revue de code, cycle Searching et visée, analyseur radar, table de commandes, page web lisible
    Revue complète notée par fonctionnalité (docs/firmware-code-review.md) ;
    les quatre fonctionnalités à 3 étoiles sont reprises :
    - cycle de tir : logic/CycleLogic.h (pur, testé), état Searching
    (voix search, cible revenue = nouvelle rafale, sinon repli après
    SearchMs), réglages FireMs, SearchMs et AimZ (rotation Z qui suit la
    cible ; faux par défaut, sens à vérifier sur la tourelle).
    FIringState.cpp renommé, ManualState.cpp supprimé.
    - radar : logic::RadarParser à longueur fixe, trames fausses comptées,
    radar.bytes / frames / badFrames dans status (défaut 4).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
2026-11-12 firmware : relecture (voix search), aim, help par catégorie, vitesse radar, œil vivant, page bilingue, clang-format, table de commandes pure
    - Searching : la voix search était refusée pendant la queue du tir, et
    Disengage parlait par-dessus avec SearchMs = 0 : attente de la fin du
    tir ; le balayage part de la dernière visée.
    - aim : cibles radar avec angle et consigne du servo Z, sans bouger ;
    aim.deg dans /api/status.
    - help [catégorie] ; catégories dans /api/meta, sélecteur sur la page.
    - MaxSpeedCms (B10) ; zone de détection dans Radar::ApplySettings ;
    vitesse sur la page radar de l'OLED.
    - LedEffect 2 "living eye" (B6) : Light::Mood posé par main.
    - Page bilingue : web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
